SteriCraft/hbc2-ide/logisim/notes/README.md

# Logisim notes

These notes are short, one subject per file, so I only open the one I need.

| File | Subject |
|---|---|
| [conventions.md](conventions.md) | HBC-2 design rules: components, names, chips, layout, files, checks |
| [tools.md](tools.md) | The scripts in `logisim/tools/` and how to use them |
| [ttl-chips.md](ttl-chips.md) | Pinout quirks of the TTL parts, and how each one is wired |
| [open-points.md](open-points.md) | Rule conflicts and questions still waiting for an answer |
| [chips.md](chips.md) | Which 74HCT parts to buy: DIP/SOIC references, sourcing rules, datasheet delays, parts missing from Logisim |
| [disponibilite-74hct.md](disponibilite-74hct.md) | Gianni's stock and price survey (Octopart, 2026-11-04), in French |
| [bom-alu.csv](bom-alu.csv) | ALU bill of materials, generated by `designs/alu.py` (tools/bom.py) |
| [alu-decisions.md](alu-decisions.md) | ALU design decisions (night of 2026-11-04) and points for Gianni to review |
| [alu-report.md](alu-report.md) | ALU summary: alu_op table, modules and chips, delays, test results, what's left |
| [flags-decisions.md](flags-decisions.md) | Flag register: every way the emulator changes a flag, interface (flags_op), design, timing, tests, review points |
| [bom-flags.csv](bom-flags.csv) | Flag register bill of materials, generated by `designs/flags.py` |
| [registers-requirements.md](registers-requirements.md) | What the other sections need from the register / bus section, and its status |
| [registers-decisions.md](registers-decisions.md) | Register section: every register use in the emulator, design, interface, write pulse, timing, tests, review points |
| [bom-regs.csv](bom-regs.csv) | Register section bill of materials, generated by `designs/regs.py` |
| [pc-sp-requirements.md](pc-sp-requirements.md) | What the other sections need from PC, SP and the address path, and its status |
| [addr-decisions.md](addr-decisions.md) | Address section: every use of PC, SP and the address in the emulator, design, steps, phase 2 decisions (A1–A9), timing, tests |
| [addr-report.md](addr-report.md) | Address section summary: chips, timing, tests, "Need Gianni's review" |
| [bom-addr.csv](bom-addr.csv) | Address section bill of materials, generated by `designs/addr.py` |
| [ir-mem-decisions.md](ir-mem-decisions.md) | Instruction register and memory / bus interface: emulator uses, boot, design, timing, questions, Gianni's answers, phase 2 decisions M1– |
| [ir-mem-report.md](ir-mem-report.md) | Instruction register and memory: phase 2 report (chips, tests, timing, Need Gianni's review) |
| [iod-requirements.md](iod-requirements.md) | What the CPU side requires from the IOD (synchronous contract, microcontroller IOD through latches / FIFO) |
| [io-redesign-proposal.md](io-redesign-proposal.md) | I/O redesign: the VIA / 16C550 proposal (2026-11-10, timing fails, section 8), then option C: a latch mailbox in front of an ESP32 (sections 9–9.9, C-min chosen 2026-11-11) |
| [iod-decisions.md](iod-decisions.md) | The `iod` mailbox as built (2026-11-11): files, tests (module, CPU-level rule / eager benches), decisions K1–K5, open points |
| [breadboard-checks.md](breadboard-checks.md) | What to measure on the breadboard with a scope (the paper analysis can't prove it) |
| [control-requirements.md](control-requirements.md) | What the other sections need from the control unit |
| [cu-decisions.md](cu-decisions.md) | Control unit: phase 1 paper design (accepted, section 12), phase 2 microcode (section 13: source language, bit layout, placement, rules, model, tests), phase 3 circuits `clkgen` and `cu` (section 14: chips, gates, tests, timing with the duty cycle, decisions U7–U13), phase 4 the whole CPU (section 15: cpu.circ `main`, the trace bench, the comparison with the emulator, coverage, wiring bugs, timing across sections, decisions U14–U20) |
| [bom-clkgen.csv](bom-clkgen.csv) | Clock and reset generator bill of materials, generated by `designs/clkgen.py` |
| [bom-cu.csv](bom-cu.csv) | Control unit bill of materials (chips and pull resistor networks), generated by `designs/cu.py` |
| [bom-cpu.csv](bom-cpu.csv) | The whole CPU's bill of materials (146 chips, 8 resistor networks), generated by `designs/cpu.py` |
| [cu-cycles.md](cu-cycles.md) | Control unit: cycle counts per instruction × mode (generated by `hbc2 ucode`) |

Modules done so far (all in circuits/alu/, each made by designs/<module>.py):

| Module | Chips | Test (vs emulator) |
|---|---|---|
| `add_sub8` (ADD ADC SUB SBB; INC DEC with b = 01) | 3 × 74HCT283, 3 × 74HCT86, 2 × 74HCT157, 1 × 74HCT08 (carry select) | 524,288 / 524,288 |
| `logic8` (AND OR XOR) | 2 × 74HCT08, 2 × 74HCT32, 2 × 74HCT86 | 65,536 / 65,536 |
| `shift8` (shifts, C select) | 1 × 74HCT153 | 2,048 / 2,048 |
| `flags8` (Z N) | 74HCT27, 74HCT11 | 256 / 256 |
| `cmp8` (S E F of CMP) | 2 × 74HCT85 | 65,536 / 65,536 |
| `rmux8` (result bus, NOT) | 6 × 74HCT541, 74HCT240, 74HCT138, 74HCT11 | 65,760 sampled |
| `alu` (all of the above) | none of its own; 29 chips in total | see alu-report.md |

Flag register (circuits/flags/, designs/flags.py):

| Module | Chips | Test (vs emulator) |
|---|---|---|
| `flags` (8 flags, POF/PSF, single-flag writes, reset) | 4 × 74HCT153, 3 × 74HCT11, 2 × 74HCT138, 2 × 74HCT157, 2 × 74HCT175, 74HCT86, 74HCT541 (15) | 66,816 / 66,816 (`flags`) and 70,656 / 70,656 (`flags_cpu`, the real CPU) |

Register section (circuits/registers/, designs/regs.py):

| Module | Chips | Test (vs emulator) |
|---|---|---|
| `regs` (8 registers, two read ports, write path, operand latches, A/B buses, data bus drivers) | 8 × 74HCT670, 4 × 74HCT153, 3 × 74HCT574, 2 × 74HCT541, 74HCT32 (18) | 30,756 / 30,756 (`regs`, model) and 148,864 / 148,864 (`regs_cpu`, the real CPU) |

Address section (circuits/addr/, designs/addr.py):

| Module | Chips | Test (vs emulator) |
|---|---|---|
| `addr` (PC, SP, the 16-bit address adder, the address latch, their bus drivers, the reset) | 8 × 74HCT153, 6 × 74HCT377, 6 × 74HCT541, 4 × 74HCT157, 4 × 74HCT86, 4 × 74HCT283, 2 × 74HCT08 (34) | 31,640 / 31,640 (`addr`, model) and 65,114 / 65,114 (`addr_cpu`, the real CPU) |

Chip models (circuits/chips/, rules in conventions.md; the circuit inside is named `ttl<part>`): `74574` (2,064 / 2,064 datasheet rows); `test_74670` checks Logisim's own 74670 (912 / 912), `test_74377` its 74377 (250 / 250).

`arith8` (add_sub8 + 2 × 74HCT157 for B := 01) was removed on 2026-11-04: INC and DEC now take b = 01 from the control unit (alu-decisions.md D16).

`logisim/cpu.circ` holds only an empty `main` and loads alu and add_sub8 as libraries.

History: on 2026-11-04 the user deleted their test circuits add_sub8.circ and the old alu.circ. `hbc2 vectors add_sub8` still exists on the emulator side.

On 2026-11-04 add8 became add_sub8: B goes through XOR chips (A - B = A + not B + 1), and the flag c is a borrow after SUB/SBB, as in the emulator.
