SteriCraft/hbc2-ide/Documentation/Peripherals/EEPROM/Specifications.txt

=== EEPROM Specifications ===
ROM can hold up to 1 Megabyte of data (20-bit addresses)
It has 5 ports (one for command, one for data, 3 for address)

-- Pinout--
The CPU has a "HALT" pin to prevent it from executing instructions.
The ROM uses that pin to hold the CPU on startup, while it's dumping data.

-- DATA DUMP --
On initialization, the EEPROM copies the IVT (0xFE00-0xFFFF) and the first 512 bytes of program (0x000-0x1FF).
The interrupts handlers have to be copied by the program the user writes in the first 512 bytes.
