SteriCraft/hbc2-ide/compiler/ROADMAP.md

# HBC-2 C compiler — roadmap (Claude's tracking file)

C compiler for the HBC-2 based on the Fuzix Compiler Kit (FCC):
`cc0` (tokens) → `cc1` (parse, trees) → `cc2` (our backend, prints `.has`) → `copt` (peephole) → hbc2-asm.
**Finished (2026-11-11):** everything planned is done; nothing is planned. New work comes from using the compiler (a bug, a slow spot): record it here. The user only says "go to the roadmap": read this file and update the status here at the end of each session.

## Status

- **Phase:** finished 2026-11-11. Steps 1-13 done (step 13 = EEPROM, 2026-10-31) (step 11 = linker, details in `LINKER.md`; step 12 = backend speed-ups + string.h in asm, 2026-10-31). 70 test programs (programs.rs, multi-file ones included) pass + `tests/build.rs` + FCC's own 109 test programs (`tests/fcc.rs`, all pass). Tests: `cargo test -p hbc2-cc --release` (needs `compiler/build.cmd` first). Unreached code is left out: an empty `main` is 269 bytes, hello world 1.1 KB, with printf 2.7 KB (lib/README.md "Size").
- **Done after step 13:** C89 library, plan agreed with the user 2026-11-03, everything in assembly (size): 1. `limits.h` + `errno.h` + `strerror`/`perror` — **done** (`lib/asm/errno.has`, tests/errno.c); 2. `sprintf`, `vprintf`, `vsprintf` — **done** (`printf.has` engine, tests/sprintf.c); 3. `qsort`, `bsearch`, `strtok`, `strspn`, `strcspn`, `strpbrk` — **done** (`asm/sort.has`, `asm/string.has`, tests/sort.c); 4. `time.h` from the RTC — **done** (`asm/time.has`, tests/time.c; `clock` = -1, no `difftime`); 5. `setjmp.h` — dropped by the user 2026-11-03 (uses `goto cleanup`); 6. `malloc`/`free`/`calloc`/`realloc` — **done** (`asm/malloc.has`, tests/malloc.c); 7. `sscanf`/`scanf` — **done** (`asm/scanf.has`; `getchar`/`gets` moved to asm, `src/stdio.c` gone; tests/scanf.c); 8. `float` (2026-11-04): the float library (`lib/asm/math/float`, 27 KB, binary32 full IEEE, tested by `tools/ftest`) reviewed (linker could not drop unused functions: fixed; pow inexact bug fixed), then compiler support **done**: `double` = `float` (cc1 remap), backend moves floats like longs and calls `runtime/float.has` helpers (ABI.md 11), cc0 constants via host strtof (hex floats too), cc1 folds float constants and int<->float casts; `math.h` float functions, `float.h`, `fenv.h`, `strtod`/`strtof`/`atof` (`asm/fmath.has`); tests/float.c, tests/fmath.c (mutation-checked). printf/scanf `%f %e %g` **done** 2026-11-04 (`asm/printf_float.has`: exact digits from a 288-bit fixed point number, half to even; printf also got `+ space # .prec *`, `%i`, `h L`; scanf `%e %f %g %a` through atof; tests/printf_float.c, mutation-checked; cost: printf +2.5 KB, scanf +4 KB in every program using them, even without floats). Dropped by the user (2026-11-13): `fixed.h` (fixed point, not standard). Declined: `assert.h` (user won't use it), `locale.h`, `signal.h`, wide chars. `strtol`/`strtoul`/`atoi`/`atol` and `itoa`/`utoa`/`ltoa`/`ultoa` moved to asm 2026-11-03 (`asm/stdlib.has`; `src/stdlib.c` gone; convert test 12000 → 9036 bytes). `strstr` too (`asm/string.has`, 75 bytes): no C left in the library, `compiler/lib/src` is gone (`build_library` takes a missing folder as no C files). Struct assignment added 2026-11-03 (`T_STRUCTCOPY`, tests/structcopy.c; ABI.md 11-12); local `{ }` / string initializers and `(void)` casts added too (tests/localinit.c). **Language work, order agreed with the user 2026-11-11 (stop and report after each):** 1. block scope — **done** 2026-11-11 (decision 17, tests/blockscope.c + build.rs "scope", mutation-checked); 2. `for (int i…)` — **done** 2026-11-11 (decision 6b, tests/fordecl.c + build.rs "forstatic", mutation-checked); 3. structs passed/returned by value — **done** 2026-11-11 (decision 18, tests/structval.c + build.rs "structarg", mutation-checked); 4. FCC's own tests — **done** 2026-11-11 (tests/fcc.rs, 109 programs, all pass, no compiler change needed). Backend, 2026-11-11: `x *= k`, `x /= k`, `x %= k` with a constant done in place (`direct_muldiveq`: load, inline multiply / power-of-two divide as `x * k` / `x / k`, store; signed `/ %`, `char`, long `*=` still call the helpers; tests/muldiveq.c, mutation-checked; loops 2-5× faster, the statement about the same size, the helper no longer linked). Dropped by the user: bitfields, K&R definitions, the cargo build of the C tools, carrying register contents across loop labels. Known limits: ABI.md 12. The IDE builds through `hbc2_cc::build_program`; keep that the one entry point.

## Notes files (read only when needed)

Details moved out of this file to keep it short. Open the one for the part you touch:

| File | Content |
|---|---|
| `notes/pipeline.md` | FCC tool chain, command lines, cc1 stdout quirk |
| `notes/step1-design.md` | data/labels/statics/arguments as FCC emits them |
| `notes/backend.md` | backend-hbc2.c: rewrites, labels, data buffering, exports |
| `notes/inline.md` | gen_shortcut inline code, conditions on flags, measured gains |
| `notes/peephole.md` | copt and rules.hbc2 |
| `notes/helpers.md` | the 89 runtime helper names |
| `notes/library.md` | compiler/lib layout, device detection, terminal from C |
| `notes/multifile.md` | build_program, static renaming, error messages |
| `notes/ide.md` | diagnostics, line markers, asm→C line map, line step, background build |
| `notes/misc.md` | CPU facts, FCC quirks, stack/frame tricks, math library location |
| `notes/reloads.md` | step 12: reload removal pass (reloads.rs), volatile markers |
| `notes/session-log.md` | what each session did |

## Decisions (agreed 2026-10-30)

1. **Linking:** (a) the driver joins every generated `.has` + the runtime into one program.
   (b): unused code dropped by hbc2-asm: step 11, decision 15 (done).
2. **Names:**
   - C `foo` → `_foo` (so asm `screen_putc` and C wrapper `_screen_putc` coexist).
   - Runtime helpers: `__name` (Fuzix's names where they exist: `__mul`, `__cceq`…).
   - `static` names: per-file prefix `__S<n>_name` (n = file number in the build; was `_S<n>_` until step 9: `__` can't clash with a C name, like `__L`).
   - Compiler labels: `__L<n>_…` with the file number (changed from `_L<n>` in step 1: a C name `L1` would give `_L1`; C reserves `__` names, so `__L` can't clash).
3. **Registers:**
   - `[a:b]` = working value (16-bit, a = MSB); `char` in `b`.
   - `[x:y]` = pointer register (`*p`, `p->f` → `[x:y + n]`).
   - `[c:d]` = second operand / high half of a `long` (`long` = `[c:d]:[a:b]`).
   - `i`, `j` = scratch / second pointer.
   - Matches the math library's 16-bit routines ([a:b] op1/result, [c:d] op2). 32-bit routines use pointers ([x:y], [i:j]) → need adapters (see open questions).
4. **Calls:**
   - Arguments pushed right to left, each value low byte first (big-endian in memory, like `cal`).
   - Caller removes them (`asp n`) → variadic functions work.
   - Return in `[a:b]`, `long` in `[c:d]:[a:b]`.
   - Every register except SP may be changed by a function (caller-saved). No register variables: dropped (user, 2026-10-31); `register` stays accepted and ignored.
5. **Asm library from C:** compiler helpers get their own entry points matching what the backend emits (built from the math library code); user-facing drivers (screen, terminal, keyboard) keep their register interface and get thin C wrappers.
6. **Types:** `char` unsigned by default (already FCC's default: `__castuc_`). `int`/`short` 16, `long` 32, pointers 16. `float` = IEEE binary32, `double` and `long double` the same type (decision of 2026-11-04; was: an error).
6b. **C99 declarations after statements (user, 2026-10-31):** allowed in any `{ }` block (`declaration_block()` called again in the block loop of `fcc/body.c`). tests/c99decl.c (mutation-checked). `for (int i = ...)` added 2026-11-11 (`for_statement`: own block around the loop, values written before H_FOR; tests/fordecl.c).
7. **Frames > 255 bytes:** compute the address with `rsp` (see notes), no compile error.
8. **EEPROM (step 13, user 2026-10-31):** `eeprom_read/write/load/save` in hbc2.h (asm in `lib/asm/hbc2.has`), and an EEPROM target for C: `runtime/boot.has` replaces crt0's start (see ABI.md 8 and `notes/library.md`). **The EEPROM target and boot.has were removed on 2026-11-11** (logisim/notes/io-redesign-proposal.md 9.5): the hardware starts from its boot ROM; the EEPROM stays as storage, plugged by default.
9. **Interrupt handlers:** hand-written asm only (they may call C functions). No compiler support.
10. **Zeroed variables (BSS):** `.bss name size` in hbc2-asm (DONE 2026-10-30): all `.bss` placed together after code and data, nothing in the image, `__bss_start` / `__bss_end` defined; `crt0` clears the area (loop example in the assembly manual).
11. **Licence/packaging:** not a concern (single user). Repo is GPLv3 like the kit.
12. **Library location (step 8):** `compiler/lib/` holds COPIES of the user's drivers (monitor driver, terminal) + the C library (`include/` headers, sources). The user's originals in design_projects stay untouched.
13. **Device detection (step 8):** `crt0` handles it before calling `main`, so C code can print straight away. Since 2026-11-11 it asks the I/O processor with INFO (`lib/asm/devices.has`, 2 s timeout) instead of handling port-0 plug-in interrupts; `hbc2.h` has `device_find()` (by class), `device_get()`, `device_count()`, `io_protocol()`.
14. **printf (step 8):** minimal set: `%d %u %x %c %s %%`, `l` for long (`%X` added 2026-10-31), width + `0` padding. Floats, flags `+ space #`, precision and `*` added 2026-11-04.
16. **IDE integration (user, 2026-10-31, step 10):** a C project = a folder with `main.c` (wins over `main.has`); every `.c` and `.has` file of the folder is built (main.c first = unit 1, then name order); Build (F7) saves all open files first; tools stay in the repo's `compiler/bin` (`HBC2_COMPILER_DIR` overrides); an asm project cannot call C files; no interrupt handler template for C (crt0 + set_vector are enough); the asm→C line map is part of step 10.
17. **Block scope (2026-11-11):** each local symbol has a block depth (arguments = the body's outer `{ }`); a name hides the same name of an outer block; sibling blocks share stack room (frame = deepest nesting). Tags, typedefs, enum constants stay file-wide (FCC). Upstream changes in `fcc/UPSTREAM.md`.
18. **Structs by value (2026-11-11, ABI.md 5):** an argument is passed as the address of the caller's struct and the callee copies it into a local at entry (one copy per function, not per call; no backend change). A result goes to a temporary in the caller's frame, whose address is a hidden first argument (pushed last); the callee returns that address. All in cc1 (`fcc/UPSTREAM.md`).
15. **Linker (user, 2026-10-31; replaces the object-file plan):** no object files. hbc2-asm drops every piece of the program that can't be reached from `_start` / fixed addresses / `.keep` (piece = from a label to the next label, or one `.data`/`.bss`; fall-through counts as a use). On for C builds only; assembly projects keep everything (a per-project option may come later). Library names give way to the program's own (a program may define `puts`). Plan and progress: `LINKER.md`.

## Open questions (waiting for the user)

- (none)

## Layout

- `compiler/fcc/` — copy of the kit's core (see `fcc/UPSTREAM.md`: commit, licences, what was left out). HBC-2 files to add: `target-hbc2.c` (cc1), `backend-hbc2.c` (cc2). Keep upstream files unchanged where possible; list any change in UPSTREAM.md.
- `compiler/msvc/` — `compat.h` (forced include: io.h names, binary `open`, `itoa`/`_itoa` renamed, strcasecmp, strlcpy/strlcat), `compat.c` (binary stdin/stdout/stderr before main via `.CRT$XCU`), `unistd.h` stub.
- `compiler/build.cmd` — MSVC build (vcvars64 of VS 2022 Community) → `compiler/bin/*.exe`, objects/logs in `compiler/build/` (both git-ignored). Builds cc0, cpp, copt, cc1.ref (target-6800.c), cc2.ref (backend-default.c). Add cc1.hbc2/cc2.hbc2 in step 3.
- Full upstream clone for reading other backends: re-clone https://github.com/EtchedPixels/Fuzix-Compiler-Kit at the commit in UPSTREAM.md (scratchpad copies don't last). 6809 = `be-codegen-6800.c` + `be-code-6809.c` + `be-func-6800.c` + `be-track-6800.c`; cc1 for 6809 = `target-6800.c`.

## Steps

- [x] 1. Get FCC, build it, compile tests for the 6809 target, read the backends. (No WSL/MSYS2/gcc on this machine: built with MSVC + compat layer instead. 6809 output checked on a loop + call test.)
- [x] 2. Write the ABI document — `compiler/ABI.md`. Section 11 (helpers) is a draft to settle in steps 3-4.
- [x] 3. Minimal backend `backend-hbc2.c`: constants, load/store globals + locals, calls, prologue/epilogue, labels, jumps, branches; everything else → helpers. Also inline already: + - & | ^ ~ unary- (8/16), == != (8/16), ! and bool, casts (incl. sign extension), deref / assign through pointers, frames > 255.
- [x] 4. Runtime: `crt0.has` + 89 helpers (`runtime.has` includes compare, long, mul, div, shift, assign, switch; ≈3.9 KB). Written for the C convention, NOT wrappers of the user's math library (it saves all registers; runtime must be self-contained).
- [x] 5. Test harness: crate `hbc2/crates/hbc2-cc` (lib: `compile()` = Rust version of the driver; tests/helpers.rs: each helper called directly on the emulator vs a Rust model, breakpoint on a return label; tests/programs.rs: every `compiler/tests/*.c`, "Expected: main returns N" on line 1). Both checked by mutation (a broken helper makes them fail). FCC's own test programs (upstream `test/`, 2026-11-11): tests/fcc.rs runs the 35 self-checking `tests/` and the 74 acwj `wtests/` (output compared), all pass first time; the runner checked by mutation.
- [x] 6. Inline code (see "Inline code (step 6)" below).
- [x] 7. `copt` peephole rules (see "Peephole rules (step 7)" below).
- [x] 8. Library: `hbc2.h` (monitor/keyboard/RTC wrappers, in/out), `putchar`/`puts` on `term_putc`, `string.h`, small `printf`.
  - [x] 8a. `hbc2.h` + `asm/hbc2.has` wrappers, driver copies in `lib/asm`, device detection in crt0 (`runtime/devices.has`), `exit` (stdlib.h), `-I lib/include` in both drivers, `build_library()`, tests/hardware.c (+ `.screen` / `.keys` support in programs.rs, all tests now run with monitor + RTC + keyboard).
  - [x] 8b. stdio.h: `putchar`/`puts` in asm (`asm/stdio.has`, first output clears the screen: `lib_term_start`), `getchar`/`gets` in C (`src/stdio.c`, line-buffered on term_readline; moved to asm 2026-11-03). tests/stdio.c.
  - [x] 8c. string.h (14 functions, in C: `src/string.c`; in asm since step 12: `asm/string.has`) + stddef.h. tests/strings.c (mutation-checked).
  - [x] 8d. printf (decision 14, `src/printf.c`) + stdarg.h. tests/printf.c (mutation-checked). In asm since 2026-11-03: `lib/asm/printf.has` (2.5 KB → 965 B; printf test 4870 → 3731 bytes, 52k → 44k ticks; mutation-checked).
- [x] 9. Multi-file builds: `hbc2_cc::build_program(sources, library, dir)` (`.c` + `.has`), static renaming in `compile()` (both drivers), `-I` source folder, C-level error messages, library statics (`next`, `field`). Tests: `tests/multi/files`, `tests/build.rs` (mutation-checked).
- [x] 10. IDE (decision 16, see "IDE integration (step 10)" below):
  - [x] 10a. `hbc2 cc <files…> [-o out.bin] [--dir build] [--symbols]`; `hbc2 run main.c …` builds first.
  - [x] 10b. Diagnostics instead of strings (`compile`, `build_library`, `build_program` → `Vec<Diagnostic>`, `report()` for text); every C file compiled even when one fails; library files kept when newer than their inputs.
  - [x] 10c. C projects in the IDE (project language, template `hbc2/templates/main.c`, Build saves then compiles into `<project>/.build`, RAM only).
  - [x] 10d. C highlighting; compiled files and the compiler's own files open read-only.
  - [x] 10e. asm→C line map (`;#line n` markers through FCC, `lines.rs` remaps the Program).
- [x] 12. Speed-ups (user, 2026-10-31): one-byte bit tests (`x & 0x8000`) in conditions / ?: / 0-1 values; `<<=` `>>=` by a constant in place; reload removal after copt (`hbc2-cc/src/reloads.rs`, volatile-aware; copt's store-then-load rules removed); string.h in asm (`lib/asm/string.has`, 2.7 KB → 1.1 KB). tests/bits.c, tests/reloads.c, build.rs volatile_reloads; all mutation-checked. See notes/reloads.md.
- [x] 13. EEPROM (decision 8): hbc2-asm `__program_end`; runtime split into crt0.has (RAM) / boot.has (EEPROM) + init.has (shared) + devices.has (no variables now); `build_program(…, target)` → `Build::eeprom_image`; `hbc2 cc --eeprom`, `hbc2 run main.c --eeprom`; IDE target menu enabled for C. tests/eeprom.c (first line "built for the EEPROM"), hardware.c checks the refusals, build.rs eeprom_image; mutation-checked.
- [x] 11. Linker (decision 15) — see `LINKER.md`: `Options::strip` in hbc2-asm (on for C builds), `.keep`, `.library` (program names replace the library's), `hbc2 cc --map`.
