SteriCraft/hbc2-ide/compiler/notes/session-log.md

# Session log

(Moved out of ROADMAP.md 2026-10-31. Read only when working on this part.)

- 2026-11-04: printf/scanf floats (user asked). `lib/asm/printf_float.has`: m << s in a 288-bit fixed point (128 integer, 160 fraction bits) is exact; integer digits by bitwise division by 10, fraction digits by x10; pf_next/pf_rest feed a 192-digit buffer, the rest are exact zeros counted (zeros/split in the field), half to even. printf engine rewritten: frame 250 B, flags + space #, precision, `*`, %i, h L; text printed as split chars, zeros, rest. scanf: frame 70 B, %e %f %g %a collect a decimal text (40 chars) for atof. Expected values from MSVC UCRT (its `%#.0f` of inf gives "i.nf": fixed by hand). tests/printf_float.c 850 checks, mutation-checked (half-even, 40-char limit). Cost: printf 3.8 -> 6.3 KB, scanf test 8.5 -> 12.5 KB even without floats (option: a hook only float programs pull in).
- 2026-11-04: float. Review of the float library (Sonnet-written steps 10-12): fx_main table dispatch kept 21.5 KB for any function in C builds -> direct jumps (exp 7 KB); pow(x, tiny) missed FE_INEXACT; ftest harness moved to tools/ftest. Compiler: target-hbc2.c remap double, backend-hbc2.c (is_float, move_size, float_op bail in gen_shortcut, float_test for conditions, compares are int 0/1 though typed float), runtime/float.has, cc0 strtof constants, cc1 folding + ++ step, lib fmath.has + math.h/float.h/fenv.h/strtod. Bugs met: pop order (mirror of psh b,a,d,c is pop b,a,d,c), compare nodes typed float, strtod clobbered its result. Tests float.c, fmath.c; all workspace tests pass. Empty main still 269 B, float ops ~4 KB, sin ~7.7 KB.
- 2026-11-03: scanf/sscanf in `lib/asm/scanf.has` (~1.7 KB): C89 conversions (d i u o x X p c s [ ] n %%, *, width, h, l), EOF before the first conversion, one character of look-ahead. getchar/gets rewritten in asm (`lib_stdin_peek`/`lib_stdin_back`: the char scanf did not use goes to getchar), `src/stdio.c` deleted. Keyboard reached through `lib_scan_key` (set by scanf) so sscanf-only programs leave the terminal out (2.0 vs 3.7 KB). tests/scanf.c + scanf.keys, mutation-checked (12 mutants).
- 2026-11-03: setjmp.h dropped (user: `goto cleanup`). malloc/free/calloc/realloc in `lib/asm/malloc.has` (~700 B): heap from `__bss_end` to SP - 256, 2-byte headers (size even, bit 0 = used), first fit, free blocks joined during the search, free tail lowers the top, realloc in place/at top/moved. tests/malloc.c mutation-checked (no join, realloc copy size, calloc clear, no top drop, no split, realloc at top, old block kept on move; no stack limit hangs the test; ignoring the borrow of SP - 256 is equivalent).
- 2026-11-03: C89 library batches 1-4 (limits/errno, sprintf family, qsort/bsearch/strtok…, time.h), then struct assignment in the compiler (user asked): cc1 `T_STRUCTCOPY` node (`struct_assign`), cc2 inline copy up to 4 bytes else `__structcpy`; `struct s v = w;` for locals. Probe of C89: missing = structs by value (args/return), local `{ }`/string initializers, bitfields, K&R definitions. tests/structcopy.c mutation-checked (inline byte count, helper count, helper result; result = source vs destination is equivalent, not testable). Then (user asked): local `{ }`/string initializers (hidden data + T_STRUCTCOPY, `ini_auto_copy`) and `(void)` casts; tests/localinit.c mutation-checked (size, copy dropped, (void) not evaluated).
- 2026-11-03: printf rewritten in asm (user asked): `lib/asm/printf.has` replaces `src/printf.c` (2.5 KB -> 965 B). State in 28 bytes of stack locals, digits from the math library's utoa/itoa/htoa 16/32, a negative %d takes itoa's '-' off and the field prints it (before or after the padding), every char through `_putchar` (tests/multi/override). Width 8-bit (up to 255). printf test 4870 -> 3731 bytes, 52006 -> 44051 ticks; smallest printf program 3846 -> 2707 bytes. tests/printf.c mutation-checked (sign order, lower case).
- 2026-11-02: CPU change designed with the user (the user updates the Instruction Manual): instructions are 1 to 4 bytes (`hbc2_core::isa::Instruction::size`: no-operand opcode = 1 byte, else the mode gives the length); invalid opcode = 1-byte nop; valid opcode with a mode it doesn't take (or a no-operand opcode with mode bits in byte 1) stops the CPU (H = 1, I = 0, PC stays on it); `hlt` sets H only; `sti` takes effect after the next instruction. Compiler output unchanged. `wait_interrupt` = `sti` + `hlt` (keeps "enables them"). programs.rs "bytes of code" = real sizes now (was lines x 4). Test programs about 28% smaller (all 68: 818236 -> 620513 bytes in all).
- 2026-10-31: ctype.h added to the library (user wrote asm/ctype.has with guidance; I added isblank, shared exits ctype_true/false, isgraph tail-calls isprint: 856 -> 668 B). tests/ctype.c: every value EOF..255 + out of range against plain C, is... must return exactly 0/1 (mutation-checked). Committed.
- 2026-10-31: step 13 EEPROM (user asked: read/write/copy routines in hbc2.h + a boot loader). Added `__program_end` to hbc2-asm, eeprom_* in hbc2.has, boot.has, EEPROM target in hbc2-cc / CLI / IDE, docs. All tests pass, clippy clean. Committed with the user's OK.
- 2026-10-31: math.h (step 2 of the math plan): `isqrt lsqrt ipow lpow gcd lgcd popcount clz ctz` + `l` versions, `min max umin umax` (functions, not macros: arguments evaluated once), `abs labs` in stdlib.h. `div`/`ldiv` left out (struct return: FCC has none). Whole math library copied unchanged to `lib/asm/mathlib/` (replaces the loose random/random_range/text copies, which were identical); wrappers `lib/asm/math.has`. FCC bug fixed (fcc/UPSTREAM.md): `sizeof a / sizeof a[0]` parsed as `sizeof (a / ...)` -> "bad type"; `get_sizeof` takes `hier10` without a bracket. tests/math.c (self-checking, mutation-checked).

- 2026-10-31: faster `*` `/` `%` and variable shifts (user: "if the compiler is less efficient than the math library, update it"). runtime/mul.has, div.has (unrolled steps written once by a throwaway script; edit the files directly): only the low half of products (`__mul` = b*[c:d] + (d*a)<<8; `__mull` one pass per multiplier byte, product growing b, [a:b], [d:a:b], [c:d:a:b]), division with a remainder as wide as the divisor (`__div8_1/2/4` shared by 16 and 32 bits). shift.has: byte moves first. Signed division by zero now gives all bits set as ABI.md says (was 1 for a negative left). helpers.rs: 3-byte values, `divide_by_zero`, `multiply_divide_many` (8100 pairs). 2-7x faster per helper; ops tests 1.5-3x, bench.c 6%; +1.1 KB (int) / +2.5 KB (long) in programs that use them. Next: math.h (plan agreed: `isqrt lsqrt ipow lpow gcd lgcd popcount clz ctz min max umin umax` as functions + abs/labs/div/ldiv in stdlib.h; integer names keep away from float's `pow`/`sqrt`).

- 2026-10-31: stdlib.h number <-> text: `atoi`, `atol` (spaces skipped; 0 on no digit or past 32 bits), extras `itoa utoa ltoa ultoa htoa lhtoa` (return the end, the 0). `lib/asm/text.has` = unchanged copy of the math library's. printf uses utoa/ultoa/htoa/lhtoa (no division: printf test 144k -> 41k ticks, +305 B), `%X` added. tests/convert.c.
- 2026-10-31: stdlib.h random numbers: `rand`, `srand`, `RAND_MAX` (32767), extras `srand_rtc`, `rand_range` (signed, via randr16 with the sign bit flipped). `lib/asm/random.has`, `random_range.has` are unchanged copies of the math library's. tests/random.c (mutation-checked).
- 2026-10-31: common variables (`int n;` in several files = one variable): backend writes `.common`, hbc2-asm merges (manual, ABI.md 7, notes/multifile.md). Relative `--dir` / `.has` paths fixed in build_program. All to-do lists moved to the repo's `TODO.md`; `rust-rewrite` merged into `main`.
- 2026-10-31: console windows hidden for the compiler tools (CREATE_NO_WINDOW), pushed. Step 12 (user: "all backend speed-ups + string.h"): bit tests, <<= >>= in place, reload removal pass with volatile markers (copt store-load rules removed), string.h in asm. All tests pass; committed and pushed.
- 2026-10-31: step 11 (linker) done in one session, 11a-11e: strip pass, `.keep`, report (`--map`, IDE message), on for C builds, `.library`. Two choices made on the way (in LINKER.md "How it works"): `_start`'s block is not kept whole; a library piece falling into a replaced one is not an error. All tests pass, clippy clean; committed.
- 2026-10-31 (after step 10): linker planned with the user (decision 15 replaced: removal pass in hbc2-asm, no object files; asm projects off; library names give way). `LINKER.md` written; ROADMAP.md split into `notes/*.md`.
- 2026-10-31: step 10 (plan + choices told to the user first, decision 16). 10a-10e done, then C line stepping and background C builds (user's request). All workspace tests pass, clippy clean. Committed and pushed (093ec55).
- 2026-10-30: plan + decisions with the user. This file created.
- 2026-10-30 (same session): open questions settled (5, 6, 7, 10 above). `.bss` added to hbc2-asm (parser `Stmt::Bss`, assembler places it after code/data, `__bss_start`/`__bss_end`; tests `bss_*` in tests/assemble.rs; documented in the assembly manual). Step 1 done: kit copied to compiler/fcc, MSVC build works (all 5 tools), pipeline tested with the 6809 target (scratchpad) and with cc1.ref/cc2.ref (repo build). Label naming changed to `__L…` (told the user).
- 2026-10-31 (after step 9): `set_vector(port, handler)` added to hbc2.h (asm/hbc2.has; refuses port 0), test multi/vector (key handler in asm calling C; mutation-checked). ABI.md 8 no longer suggests fixed `.data` vectors (ports are dynamic, detection overwrites RTC/keyboard vectors); ABI.md 10 shows the install.
- 2026-10-31 (after step 9): register variables dropped (user). Step order changed: 10 IDE integration, 11 linker. Duplicate "Later: linker" removed.
- 2026-10-31 (step 9): multi-file builds (plan told to the user first; static prefix changed to `__S`, told). `cargo fmt --all` also reformatted 3 unrelated files (hbc2-ide build.rs/project.rs, hbc2-runner worker.rs, import order only); restoring them was blocked: left for the user.
- 2026-10-31 (step 8): library in 4 parts (hbc2.h + device detection in crt0, stdio putchar/puts/getchar/gets, string.h, printf), told the user after each. Decisions 12-15 recorded; step order now 9 multi-file, 10 linker, 11 IDE.
- 2026-10-31 (step 7): rules.hbc2, copt in both drivers, tests/peephole.c, coverage + mutation checks, psh/pop size count fixed.
- 2026-10-31 (later): step 6. Inline code + conditions on flags; gen_ops.py rewritten (class Program; groups ops/cond/const/assign × globals/locals → tests/ops/, because of the 64 KB limit); bench.c; programs.rs prints sizes/ticks and also reads tests/ops; step 3 cast/sign bug fixed. Step 7 explained to the user.
- 2026-10-31: steps 4 + 5. Runtime helpers written and tested; crate hbc2-cc (compile + tests); gen_ops.py → tests/ops_*.c; FCC file name bug fixed. Told the user: runtime ≈3.9 KB in every program until the linker (decision 1b).
- 2026-10-30 (same session): step 3. hbc2-asm: a name in `.data` = 2-byte address (`.data p table + 4`), test `data_addresses_mixed_with_bytes`, documented. target-hbc2.c, backend-hbc2.c, build.cmd builds cc1.hbc2/cc2.hbc2, runtime/crt0.has, tools/hbc2cc.py, tests/basics.c + frames.c (run OK: 0x04AC, 0x025C). ABI.md 11 updated (pop rules, switch table).
- 2026-10-30 (same session): step 2. ABI.md written; NAMELEN raised to 31 chars; checked: no struct by value in FCC, char args 1 byte / int in varargs, CPU interrupt and flag facts. Rule added: asm names starting with `_` share the C namespace (the user's interruptHandler.has uses `_iod_…`, `_loop` etc. → C can't use `iod_…`, `loop`; the assembler reports clashes).
