SteriCraft/hbc2-ide/compiler/notes/ide.md

# IDE integration (step 10) — how it works

(Moved out of ROADMAP.md 2026-10-31. Read only when working on this part.)

- **Driver (hbc2-cc):** `messages.rs` parses stage stderr: cc0/cc1 `name.c:12 - msg` (name only: looked up next to the C file, then in lib/include), cpp `[ 'what' - ]file:12:error: msg` (cpp's line is one too high: −1; path normalized, cpp joins -I and name with '/'). Unknown lines → the C file, line 0. Stage succeeded + stderr = warnings. `BUILD_DIR` = ".build". `build_library` recompiles a file only when older than its .c, lib/include/*.h, bin/*.exe, rules.hbc2 or the running program (tests share one library build: OnceLock, parallel tests raced on the same folder).
- **Line markers:** cc1 writes `H_LINE` (data = line, 0 = another file than the C file) before each statement, local declaration, top-level declaration, the `}` of a function, and line 0 before `write_bss` (tentative `int n;` come at the end). cc0 sends the C file's name at once (a file starting with `#include` used to give the header's name first). cc2 `gen_line` flushes pending data, then prints `;#line n` (repeats skipped). copt skips markers when matching and keeps the ones inside replaced lines after the new lines. Check done: with the markers removed, all 62 compiled files are the same as before (3 only reordered: data lines placed at their own line). All FCC changes listed in fcc/UPSTREAM.md.
- **Remap (`lines.rs`):** after assembling, `LineMaps::apply` points every instruction and label of a compiled file at its C file + line (C files appended to `program.files`); lines with no marker (startup code, runtime, header code, tentative variables) keep their asm location. Assembler errors in compiled files get the C line too ("not defined: 'f'" on the calling line, "(a.c, line 2)" in "already defined"). Known: a line whose code copt removed entirely (e.g. `return g;` after `g = …;`) has no instruction, so no breakpoint there; a function without a frame has no instruction on its declaration line.
- **Line step / background build (after step 10, user's rules):** runner command `step_within(addresses)` (one instruction, then runs while PC is in the sorted set, at the current speed, state Running so Pause works; Run/Pause/Load/PowerCycle clear it; breakpoints not checked). IDE `State::c_line_addresses(pc)`: all RAM addresses of the PC's C line when its file is .c/.h, else None → `step(1)`. C builds: `assemble()` saves, spawns a thread (`build_c`), `State::building: PendingBuild` (receiver, edits at start, `then` = Run/Step pressed meanwhile); `poll_build` each frame finishes it (`finish_build`, shared with asm). Assembly projects still assemble on the UI thread (fast, and they use unsaved buffers). Tests: runner `step_within_runs_until_the_pc_leaves_the_addresses`, smoke `c_project_builds_and_runs` (steps 6 → 7 → into add → 7 → 8 → into puts (stdio.has) → one instruction; RTC off in that test: its interrupt could land a step in the handler).
- **IDE:** `Project.language` (main.c → C), `c_sources()`, `build_dir()`; `State::target()` (RAM for C), `State::is_generated()` (read-only: `.build/` and compiler_dir); `State::assemble()` builds C projects via `build_c`; New project dialog has Assembly/C; toolbar/menu say Build; target choice disabled for C; `highlight::Syntax` (C: keywords, types, `#` lines, comments over lines, strings, numbers, calls). Tests: smoke `c_project_builds_and_runs` (error line, save before build, breakpoint on a C line, monitor output), hbc2-cc `tests/build.rs` (`error_lines`, `c_lines`).
