SteriCraft/hbc2-ide/Documentation/Peripherals/Monitor/Specifications.txt

=== Specifications ===
- Color text mode
  |- 42 by 24 characters screen (252 * 192 pixels)
  |- 6*8 px characters
  |- 2 bytes per character (2,016 bytes, ~2kB)
  |- First byte: 4 bits for background color (MSB), 4 bits for character color (LSB)
  |- Second byte: ASCII code
  |- 16 colors palette

- Color pixel mode
  |- 256px * 192px screen (49,152 pixels)
  |- 4 bits per pixel, 2 pixels per byte (24,576 bytes, 24kB)
  |- 16 colors palette

=== Ports ===
0: DATA_0
1: DATA_1
2: POS_X
3: POS_Y
4: CMD

=== Commands ===
0: NOP
1: WRITE
2: READ
3: SWITCH_TO_PIXEL_MODE
4: SWITCH_TO_TEXT_MODE

=== ERRORS ===
Returns 0x00 on READ command if requested position is invalid

=== ASCII CHARS ===
95 displayable characters
Starting at ASCII code 0x20 (32)

 !"#$%&'()*+,-./0123456789:;<=>?@ABCDEFGHIJKLMNOPQRSTUVWXYZ[\]^_'abcdefghijklmnopqrstuvwxyz{|}~
