SteriCraft/hbc2-ide/logisim/notes/cu-cycles.md

# Control unit: cycle counts

Generated by `hbc2 ucode` from `hbc2/crates/hbc2-ucode/microcode/hbc2.uc`; do not edit. Steps of 500 ns (2 MHz) per instruction, from its fetch of byte 0 (F0) to the next instruction's F0. Checked against the datapath model by `cargo test -p hbc2-ucode`. "a / b": jump not taken / taken.

| Instruction | None | Reg | Reg / Imm8 | Reg / Ram | RamReg / ImmReg / Offset | Stack / Offset | Reg16 | Imm16 | Imm8 | other modes (stop) |
|---|---|---|---|---|---|---|---|---|---|---|
| NOP | 1 | | | | | | | | | 3 |
| ADC | | 4 | 5 | 8 | 8 | 7 | | | | 4 |
| ADD | | 4 | 5 | 8 | 8 | 7 | | | | 4 |
| AND | | 4 | 5 | 8 | 8 | 7 | | | | 4 |
| CAL | | | | | | | 5 | 7 | | 4 |
| CLC | 2 | | | | | | | | | 3 |
| CLE | 2 | | | | | | | | | 3 |
| CLI | 2 | | | | | | | | | 3 |
| CLN | 2 | | | | | | | | | 3 |
| CLS | 2 | | | | | | | | | 3 |
| CLZ | 2 | | | | | | | | | 3 |
| CLF | 2 | | | | | | | | | 3 |
| CMP | | 3 | 4 | | 7 | 6 | | | | 4 |
| DEC | | 4 | | | 8 | | | 8 | | 4 |
| HLT | 2 | | | | | | | | | 3 |
| IN | | 4 | | | | | | | | 4 |
| OUT | | 4 | | | | | | | | 4 |
| INC | | 4 | | | 8 | | | 8 | | 4 |
| INT | | | | | | | | | 4 | 4 |
| IRT | 6 | | | | | | | | | 3 |
| JMC | | | | | | | 3 | 5 | | 4 |
| JME | | | | | | | 3 | 5 | | 4 |
| JMN | | | | | | | 3 | 5 | | 4 |
| JMP | | | | | | | 3 | 5 | | 4 |
| JMS | | | | | | | 3 | 5 | | 4 |
| JMZ | | | | | | | 3 | 5 | | 4 |
| JMF | | | | | | | 3 | 5 | | 4 |
| STR | | | | 6 | 6 | 5 | | | | 4 |
| LOD | | | | 6 | 6 | 5 | | | | 4 |
| MOV | | 4 | 3 | | | | | | | 4 |
| NOT | | 4 | | | | | | 8 | | 4 |
| OR | | 4 | 5 | 8 | 8 | 7 | | | | 4 |
| POP | | 5 | | | | | | | | 4 |
| PSH | | 4 | | | | | | | | 4 |
| RET | 5 | | | | | | | | | 3 |
| SHL | | 4 | | | | | | | | 4 |
| ASR | | 4 | | | | | | | | 4 |
| SHR | | 4 | | | | | | | | 4 |
| STC | 2 | | | | | | | | | 3 |
| STE | 2 | | | | | | | | | 3 |
| STI | 2 | | | | | | | | | 3 |
| STN | 2 | | | | | | | | | 3 |
| STS | 2 | | | | | | | | | 3 |
| STZ | 2 | | | | | | | | | 3 |
| STF | 2 | | | | | | | | | 3 |
| PSF | 3 | | | | | | | | | 3 |
| POF | 4 | | | | | | | | | 3 |
| SUB | | 4 | 5 | 8 | 8 | 7 | | | | 4 |
| SBB | | 4 | 5 | 8 | 8 | 7 | | | | 4 |
| XOR | | 4 | 5 | 8 | 8 | 7 | | | | 4 |
| ASP | | | | | | | | 5 | 4 | 4 |
| SSP | | | | | | | | 5 | 4 | 4 |
| RSP | | | | | | | 4 | | | 4 |
| WSP | | | | | | | 3 | 5 | | 4 |
| invalid opcode (36–3F), any mode | 1 | | | | | | | | | |

Stop column: a valid opcode with a mode it doesn't accept: I := 0, H := 1, PC back on the instruction, then the halt loop.

| Sequence | Steps |
|---|---|
| hardware interrupt entry, after the boundary step (W1, IE1–IE8) | 9 |
| software interrupt entry, after the boundary step (W1, W2, IE1–IE8) | 10 |
| halt loop (W1, W2) | 2 per check |
| reset released → first fetch (S1 × 2, S2–S9, 65,537 copy steps, PC − 1) | 65548 (32.8 ms) |
