SteriCraft/hbc2-ide/Documentation/HBC-2_CPU_diagram.png

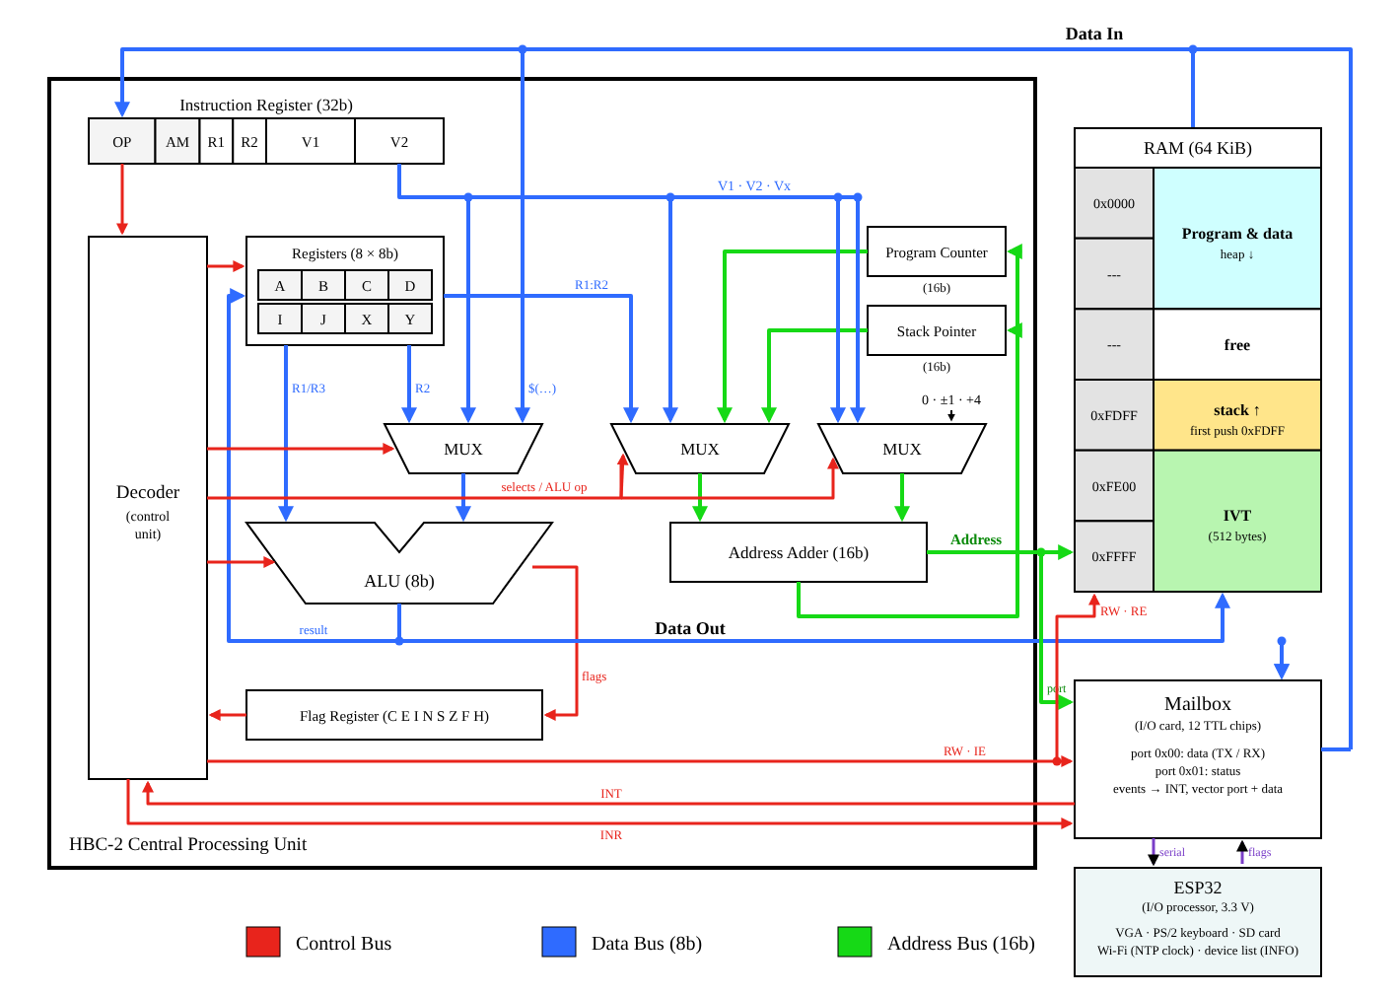
Documentation/HBC-2_CPU_diagram.png
