SteriCraft/hbc2-ide/Documentation/Peripherals/Screen/ASCII table.png

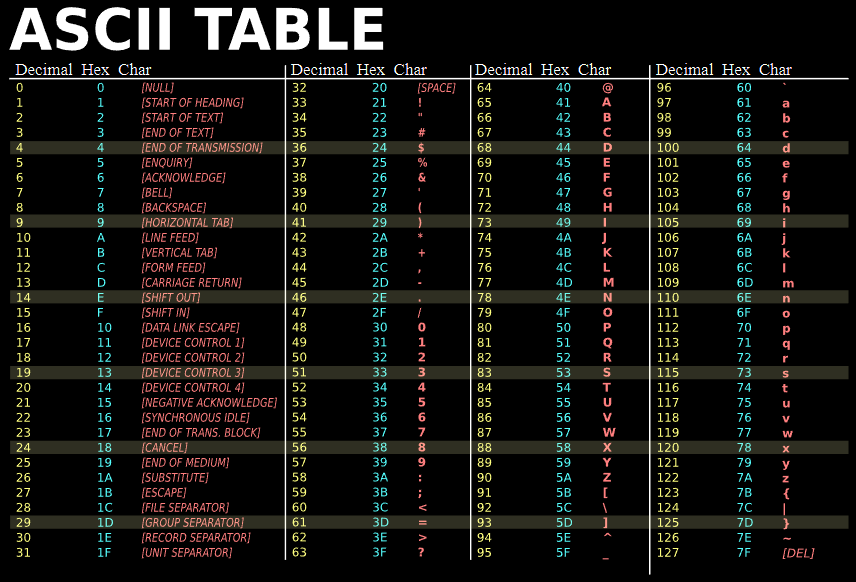
Documentation/Peripherals/Screen/ASCII table.png
