SteriCraft/hbc2-ide/HBC-2_IDE/res/z80.jpg

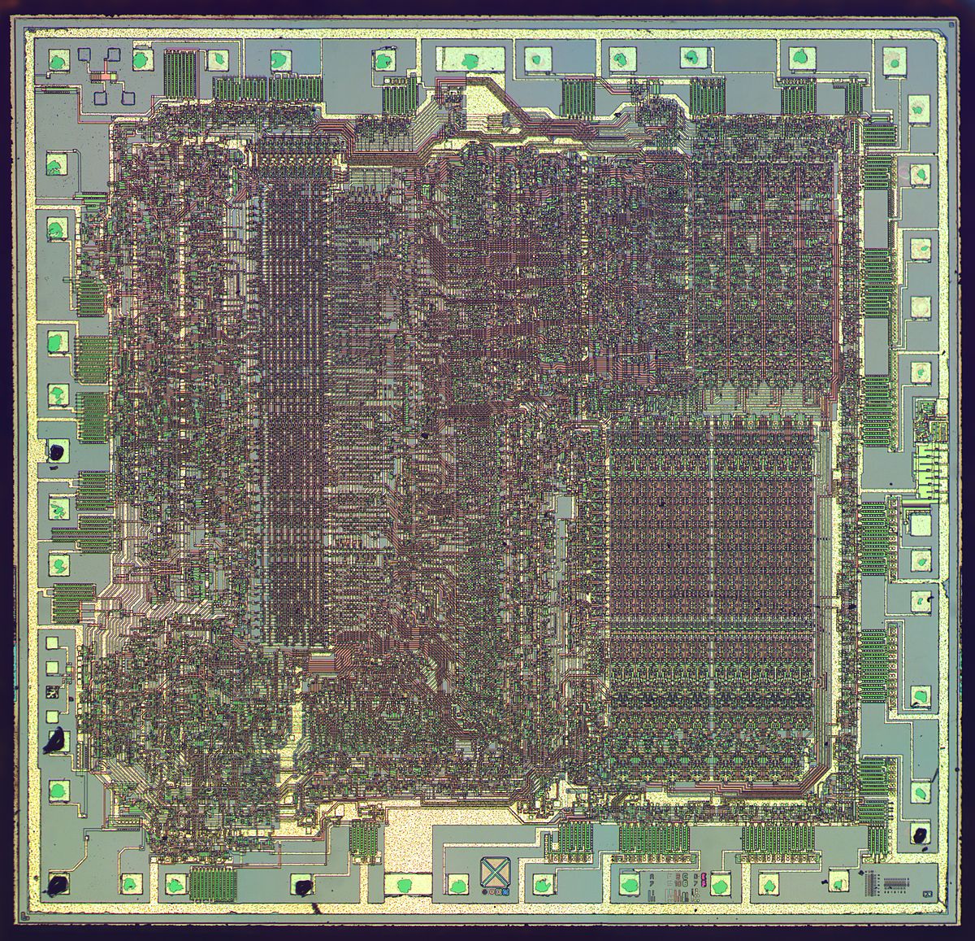
HBC-2_IDE/res/z80.jpg
