SteriCraft/hbc2-ide/logisim/notes/bom-iod.csv

part | function | qty | dip_ref | soic_ref | modules | spare
74HCT32 | quad 2-input OR | 1 | SN74HCT32N | 74HCT32D (Nexperia) | iod | 1
74HCT74 | dual D flip-flop, set / reset | 4 | SN74HCT74N | 74HCT74D (Nexperia) | iod | 1
74HCT138 | 3-to-8 decoder | 1 | SN74HCT138N | 74HCT138D (Nexperia) | iod | 1
74HCT165 | 8-bit parallel-in / serial-out shift register | 1 | CD74HCT165E | CD74HCT165M96 (TI) | iod | 1
74HCT244 | octal buffer, tri-state, two 4-bit halves | 2 | CD74HCT244E (STATUS); SN74LVC244AN at 3.3 V (the ESP32 side) | 74HCT244D (Nexperia); SN74LVC244ADWR (TI) | iod | 1
74HCT595 | 8-bit shift register + storage register, tri-state | 3 | SN74AHCT595N | SN74AHCT595D (TI) | iod | 1
total | 6 part numbers | 12 |  |  |  | 6
