SteriCraft/hbc2-ide/logisim/notes/bom-flags.csv

part | function | qty | dip_ref | soic_ref | modules | spare
74HCT11 | triple 3-input AND | 3 | CD74HCT11E | 74HCT11D (Nexperia) | flags | 1
74HCT86 | quad 2-input XOR | 1 | CD74HCT86E | 74HCT86D (Nexperia) | flags | 1
74HCT138 | 3-to-8 decoder | 2 | SN74HCT138N | 74HCT138D (Nexperia) | flags | 1
74HCT153 | dual 4-to-1 multiplexer | 4 | CD74HCT153E | 74HCT153D (Nexperia) | flags | 1
74HCT157 | quad 2-to-1 multiplexer | 2 | CD74HCT157E | 74HCT157D (Nexperia) | flags | 1
74HCT175 | quad D flip-flop with clear | 2 | CD74HCT175E | CD74HCT175M96 (TI) | flags | 1
74HCT541 | octal buffer, tri-state | 1 | SN74HCT541N | 74HCT541D (Nexperia) | flags | 1
total | 7 part numbers | 15 |  |  |  | 7
