SteriCraft/hbc2-ide/Documentation/HBC-2_Instruction_Manual.pdf

HBC-2 IDE Instruction Manual

# HBC-2 IDE Instruction Manual

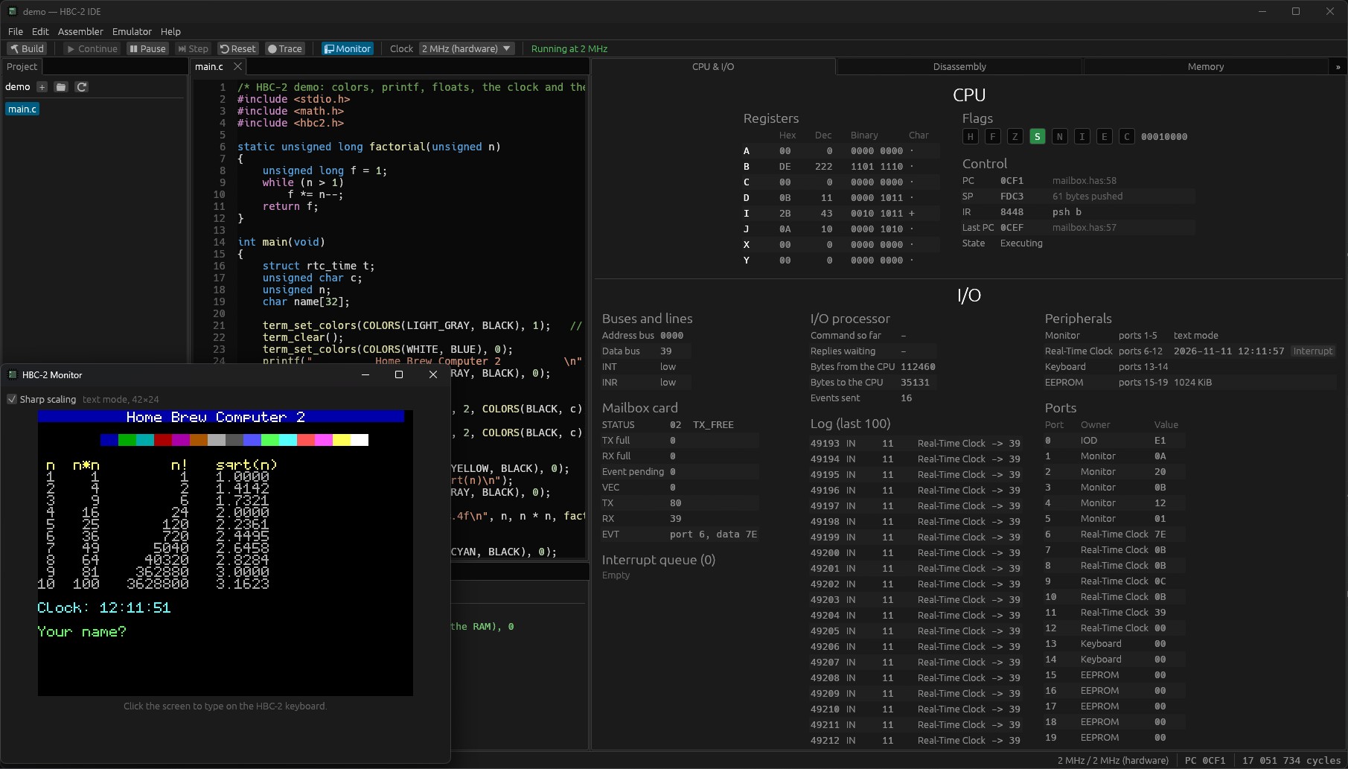
[picture p11: figure]

Gianni LECLERCQ | 1 | 2026

Gianni LECLERCQ | 2 | 2026

## Summary

## I. Generalities

II. | Instruction format and addressing modes
III. | Random Access Memory
IV. | I/O interface

## V. Hardware interrupts

## VI. Software interrupts

## VII. Instruction set

Gianni LECLERCQ | 3 | 2026

## Generalities

The HomeBrew Computer 2 (or HBC-2) is a home made 8 bit CPU designed to understand the basics of computer science via a simplified central processing unit.

Specifications

Data bus width | 8 bits
Address bus width | 16 bits
RAM maximum capacity | 64 kB
Clock frequency | 2 Mhz
Instruction size | 1 – 4 bytes
Instruction set size | 54
Architecture | Von Neumann / RISC
Stack | 16-bit stack pointer (STK) Grows downward - STK = 0xFE00 at reset (no under/overflow flag)
I/O | 256 Using a hardware mailbox ESP32 used to handle peripherals

An IDE (Integrated Development Environment) is available to program this CPU in a custom assembly language, and emulate the computer's behavior.

This software allows for a deep insight of the internal mechanisms of the computer. Various windows offer a view of the RAM in real-time, of the CPU registers, and many other elements.

The goal of this manual is to provide detailed explanation about the computer's systems, the IDE and the assembly language that has been developed.

Gianni LECLERCQ | 4 | 2026

## Instruction format

## and addressing modes

Instructions

Operand (6b) | A.M. (4b) | R1 (3b) | R2 (3b) | V1 (8b) | V2 (8b)

Instructions are 8-32 bits (or 1-4 bytes) long, divided in up to 4 sections :
1. A 6 bits operand (64 instructions maximum, 54 implemented),
2. A 4 bits addressing mode (16 addressing modes maximum, 9 implemented),
3. Two 3 bits register selectors (8 registers, A, B, C, D, I, J, X, Y),
4. Two 8 bits user-defined values.

The CPU first fetches one byte, giving it the operand.
→ Some instruction use no addressing mode, thus using only 1 byte.

If necessary to check for the addressing mode, the CPU fetches a second byte.
→ Some instruction use only 2 selected registers, which are available in the second byte. Thus taking no more space.

The addressing mode may require 1 or 2 additional bytes.

Bad opcode and bad addressing modes

If the CPU finds an invalid opcode:
→ It treats it as the nop instruction, and skips no further bytes.

If the CPU finds a valid opcode with invalid addressing mode:
→ It clear the interrupt flag and halts (hlt), thus freezing the computer until reset.
Gianni LECLERCQ | 5 | 2026

## Addressing modes (A.M.)

Many instructions can work in multiple addressing modes. Those modes allow to use pointers, mandatory for a Turing-complete machine.

The instruction set described at the end of this manual gives information about which addressing modes you can use for each instruction.

None | 0x0
Reg | 0x1
Reg / Imm8 | 0x2
Reg / Ram | 0x3
RamReg / ImmReg / Offset | 0x4
Stack / Offset | 0x5
Reg16 | 0x6
Imm16 | 0x7
Imm8 | 0x8

## None

No data is specified, the operand is sufficient.

Operand (6b) 0x0 (4b)

## Reg

Two 8-bit values retrieved from registers 1 and 2.

Operand (6b) | 0x1 (4b) | R1 (3b) | R2 (3b)
Gianni LECLERCQ | 6 | 2026

## Reg / Imm8

One 8-bit value retrieved from register 1 and one user-defined 8-bit value.

Operand (6b) | 0x2 (4b) | R1 (3b) | 0x0 (3b) | V1 (8b)

## Reg / Ram

One user-defined 16-bit value and one 8-bit value retrieved from register 1.

Operand (6b) | 0x3 (4b) | R1 (3b) | 0x0 (3b) | Vx (16b)

## RamReg / ImmReg / Offset

Register 1 and 2 are concatenated as a 16-bit address to retrieve one 8-bit value from memory. Register 1 is the most significant byte (MSB).
V2 is a user-defined 8-bit value that is added to the address as an offset.
The 8-bit value in register 3 is used directly.
Operand (6b) | 0x4 (4b) | R1 (3b) | R2 (3b) | R3 (8b) | V2 (8b)

## Stack / Offset

One 8-bit value read from memory at the stack pointer plus an offset (V1). Register 1 holds the data.

Operand (6b) | 0x5 (4b) | R1 (3b) | 0x0 (3b) | V1 (8b)

## Reg16

Register 1 and 2 are concatenated in a 16-bit value used directly. Register 1 is the most significant byte (MSB).

Operand (6b) | 0x6 (4b) | R1 (3b) | R2 (3b)
Gianni LECLERCQ | 7 | 2026

## Imm16

One user-defined 16-bit value.

Operand (6b) | 0x7 (4b) | 0x0 (3b) | 0x0 (3b) | Vx (16b)

## Imm8

One user-defined 8-bit value.

Operand (6b) | 0x8 (4b) | 0x0 (3b) | 0x0 (3b) | V1 (8b)
Gianni LECLERCQ | 8 | 2026

## Random Access Memory (RAM)

The microprocessor uses two buses to access data from external devices, one for data, and one for the address. Those buses are used both to access RAM and I/O devices.

Data bus width | 8 bits
Address bus width (RAM) | 16 bits (64 kB)

Memory map

Address | Content
0x0000 | Start of the program: the CPU starts here after power-on
0x0000 – 0xFDFF | Program and data, from 0x0000 up Stack, from 0xFDFF down (STK = 0xFE00 at reset)
0xFE00 – 0xFFFF | Interrupt vector table (512 bytes, see Hardware interrupts)

At power-on, the boot ROMs (two AT28C256 of 32 kB) copy 64 kB into the RAM, which takes 65,548 clock cycles (about 33 ms at 2 MHz). Then the CPU starts at 0x0000. Programming the computer means writing the program's RAM image into these two ROMs.

Control lines

RAM | RW (Read / Write) + RE (Ram Enable)
I/O access | RW (Read / Write) + IE (I/O Enable)

To access data from RAM, the CPU sets the R/W pin accordingly, and sets the RE pin to HIGH. To access data from I/O, the CPU sets the R/W pin accordingly, and sets the IE pin to HIGH.

When the RE pin is set to HIGH, the IE pin is always set to LOW, and vice versa.

Gianni LECLERCQ | 9 | 2026

## I/O interface

The CPU does not talk to the devices directly. Its IN and OUT instructions reach the I/O mailbox card, a card of 12 TTL chips. Behind it, an I/O processor (ESP32) runs the devices: it gives them their ports and queues their interrupts.

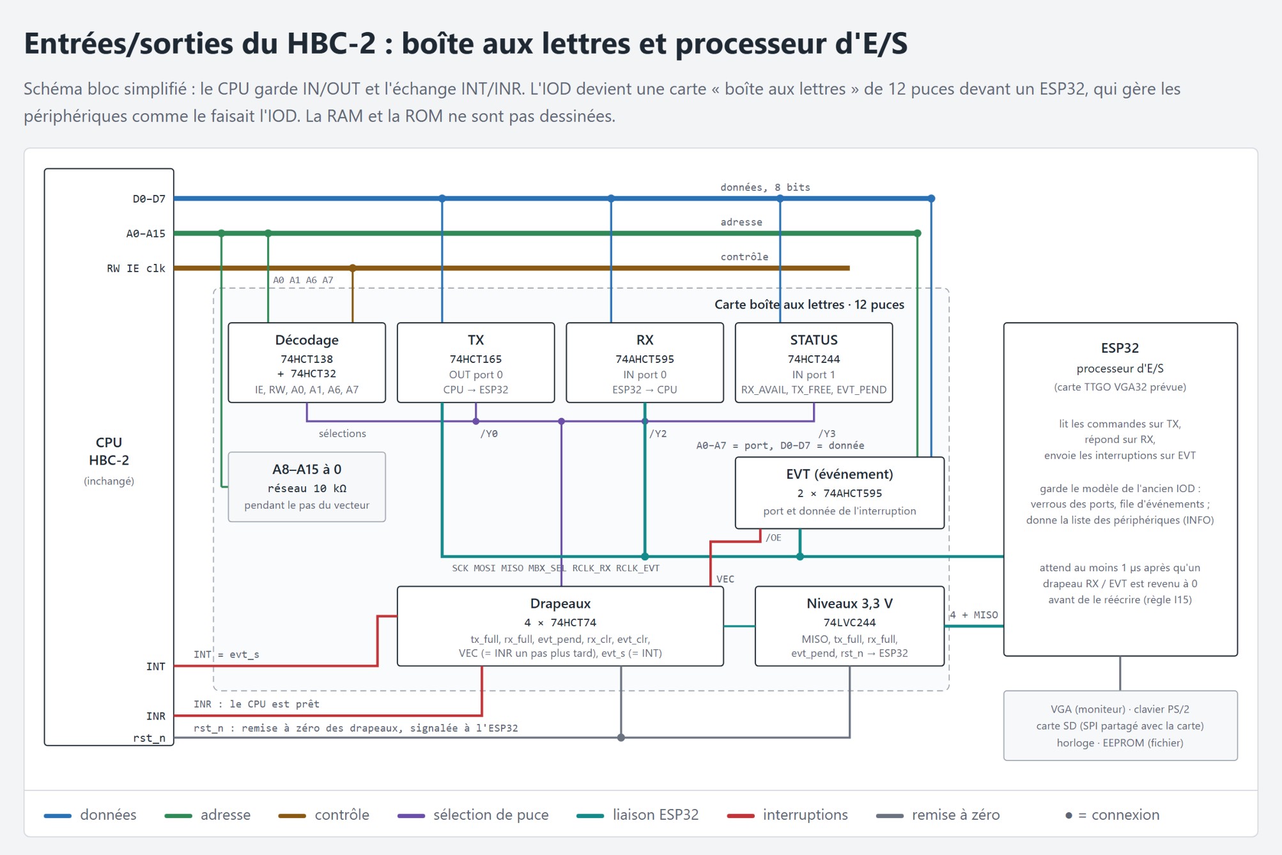
[picture p12: figure]

The I/O mailbox card and the I/O processor (HBC-2_Input_Output.pdf)

Gianni LECLERCQ | 10 | 2026

Ports

Address bus width (I/O) | 8 bits (256 ports)

This means that when accessing I/O ports, the CPU only uses the 8 least significant bits of the address bus. Whatever is on the 8 other bits is left unused. The port number is read by the mailbox, which is triggered by the IE pin (I/O Enable).

The card decodes only 0x00–0x3F: with A1 = 0, A2–A5 are ignored, so ports 0 and 1 repeat (0x04/0x05, 0x08/0x09 … 0x3C/0x3D); 0x40–0xFF are empty.

Port | IN | OUT
0x00 | RX: next byte from the I/O processor | TX: one byte to the I/O processor
0x01 | STATUS: bit 0 RX_AVAIL, bit 1 TX_FREE, bit 2 EVT_PEND, bits 3-7 = 0 | N/A

The mailbox card

The card holds one byte in each direction and one pending event:

Part | Chips | Role
TX | 74HCT165 | Loaded by OUT on port 0x00; the ESP32 reads it
RX | 74AHCT595 | Written by the ESP32; IN on port 0x00 reads it
EVT | 2 × 74AHCT595 | An event: its port on A0–A7 and its data on D0–D7, during the vector step
STATUS | 74HCT244 | RX_AVAIL, TX_FREE, EVT_PEND on the data bus
Decoding | 74HCT138, 74HCT32 | Selects TX, RX or STATUS from IE, RW, A0, A1, A6, A7
Flags | 4 × 74HCT74 | tx_full, rx_full, evt_pend; INT for the CPU
Levels | 74LVC244 | 5 V to 3.3 V towards the ESP32
Pull-downs | 10 kΩ network | Hold A8–A15 at 0 during the vector step

The ESP32 reads TX and writes RX and EVT through a serial link (SCK, MOSI, MISO, MBX_SEL, RCLK_RX, RCLK_EVT), and reads the card's flags. It waits at least 1 µs after the RX or EVT flag went back to 0 before writing that register again.

Gianni LECLERCQ | 11 | 2026

The I/O processor (ESP32)

The ESP32 keeps 256 device ports (8-bit latches) and gives each device a block of consecutive ports, from port 1 up. Port 0 is never given to a device: a port variable at 0 means "no such device". It keeps a queue of 256 events and hands them to the mailbox one at a time. Its devices are the screen (the native display, and the old monitor ports on the same picture), the PS/2 keyboard, the clock and the EEPROM (an SD card later). There is no mouse and no audio.

Device | Class | Product ID | Ports
Monitor (old ports) | 03 00 (display, VGA) | 0x0001 | 5
Real-time clock | 08 03 (system, RTC) | 0x0002 | 7
Keyboard | 09 00 (input, keyboard) | 0x0003 | 2
EEPROM | 01 80 (storage, other) | 0x0004 | 5
Native display | 03 80 (display, other) | 0x0006 | 1

Protocol

The CPU sends commands of one or more bytes. To send a byte, it reads STATUS until TX_FREE = 1, then writes the byte to port 0x00. To receive a byte, it reads STATUS until RX_AVAIL = 1, then reads port 0x00. Replies come in order; events come on EVT and never mix with replies.

Bytes sent | Command | Reply on RX
0x00 | NOP | none
0x01 p v | OUT: device port p = v | none
0x02 p | IN: read device port p | 1 byte: the value of port p
0x03 | INFO: the devices | protocol version, N, then N × 6 bytes
0x10 – 0x7F | Native commands of the screen | only the commands that read

Any other command byte is ignored, as a NOP. An IN after an OUT always sees its result.

Commands 0x10 to 0x7F are the native commands of the screen: text, graphics, the VSYNC tick (60 Hz) and the time. The ESP32 does the drawing, so one character costs 2 bytes and clearing the screen 2 bytes, instead of 5 OUT commands per character through the old monitor ports. They are described in the HBC-2 Monitor Instruction Manual.

Each command is sent with interrupts disabled (CLI), so that an interrupt handler cannot slip its own bytes into it. The library routines mbx_out and mbx_in do this. The library keeps interrupts

Gianni LECLERCQ | 12 | 2026

disabled for one command at a time, never for a whole call: the longest stretch is one PUTS of 255 characters, 6.7 ms. Meanwhile keys wait in the ESP32's queue; nothing is lost.

INFO replies with the protocol version (2: the native commands), the number of devices N, then one 6-byte descriptor per device, in port order: the class (2 bytes: PCI base class and subclass), the product ID (2 bytes, high byte first), the first port and the number of ports. Programs find a device by its class, never by a fixed port number.

Start-up and reset

1. At power-on, the program sends INFO and waits for the reply. The ESP32 takes about 1 s to boot; meanwhile the command just waits in TX.
2. The program waits 2 s at most for each byte. Without an answer, it sees no devices.
3. The reset button resets the CPU and the mailbox card only. The ESP32 keeps running and keeps the devices, their ports and the event queue; it drops a command it was halfway through receiving. The program starts again, sends INFO and gets the answer at once.

In assembly, dev_init and dev_find (devices.has) do this; in C, the start-up code does it before main and sets display_port, monitor_port, keyboard_port, rtc_port and eeprom_port (0 when the device is missing).

The complete description is in HBC-2_Input_Output.md, in the Documentation folder.

Gianni LECLERCQ | 13 | 2026

## Hardware interrupts

To handle interrupts, the microprocessor implements two control lines, INT (pending interrupt) and INR (interrupt ready), that can be triggered by the CPU and the mailbox.

CPU side

The CPU is not necessarily ready to handle interrupts. An interrupt flag is implemented in the flag register. When this flag is set, the CPU is capable of handling interrupts. Two instructions control this behaviour : STI (Set Interrupt flag), and CLI (Clear Interrupt flag).

When the CPU has received an interrupt, and is ready to manage it, it retrieves the I/O port number via the mailbox, and then jumps to a memory location defined by the programmer in the interrupt vector table (IVT).

The interrupt vector table is a 512 bytes memory block in the RAM, located from address 0xFE00 to address 0xFFFF. Those address holds pointers that the CPU uses to set the PC (Program Counter register). As a reminder, RAM addresses are 2 bytes long, and there are 256 I/O ports that are numbered from 0x00 to 0xFF.

I/O port number | Address in the IVT
0x00 (reserved: unused) | 0xFE00 << 0xFE01
0x01 | 0xFE02 << 0xFE03
[...] | [...]
0xFE | 0xFFFC << 0xFFFD
0xFF | 0xFFFE << 0xFFFF
Gianni LECLERCQ | 14 | 2026

Procedure:
1. The ESP32 loads an event (port and data) into the mailbox. EVT_PEND is set, and the mailbox raises INT, synchronised to the clock.
2. If the interrupt flag is set to HIGH, the CPU finishes the current instruction and sets the INR control line to HIGH for one clock cycle,
3. During the vector step, the mailbox drives the port on A0–A7 and the data on the data bus. A8–A15 are driven by nobody; pull-down resistors on the I/O card hold them at 0.
4. The CPU then reads the I/O port number on the address bus, pushes the I register, pushes the PC register to the stack, stores the I/O data in the I register, sets the interrupt flag to LOW, sets the INR control line to LOW, and then jumps to the memory location pointed by the interrupt vector table.
5. EVT_PEND clears in the step after the vector step. The ESP32 then sends the next event from its queue, at least 1 µs after the flag went to 0. So INT can't come back on the very next cycle.
6. When the CPU has finished processing the interrupt (by reaching the IRT instruction), it pops the PC register out of the stack to get back to work on the code that was interrupted, and pops the I register. If INT pin is HIGH, it manages the next interrupt immediately.

I/O processor side (ESP32)

The CPU does not always have enough time to process an interrupt before the next one is triggered. The I/O processor (ESP32) keeps the 256-entry queue and hands the events to the mailbox one at a time. The mailbox holds only one event.

If an interrupt is triggered but the previous one was not processed by the CPU yet, then the I/O port number is stacked in the queue of the I/O processor (ESP32), and the mailbox will keep the INT control line HIGH until the
CPU is ready to manage it.

If the queue is full, any new interrupt will be discarded.

Gianni LECLERCQ | 15 | 2026

## Software interrupts

The CPU implements the INT instruction, that triggers a software interrupt on the I/O port number defined by the programmer in the V1 value of the instruction.

This kind of interrupt does not end up in a dialog between the CPU and the mailbox. Also, they have no priority on hardware interrupts.

Register I will be pushed onto the stack, and the CPU will handle this interrupt just a regular hardware interrupt. Therefore, instruction INT sets the data bus with the content of register I.

Gianni LECLERCQ | 16 | 2026

## Instruction set

Abreviation | Operand | A.M. | Description | Flags
NOP | 0x00 | | No operation
ADC | 0x01 | Reg | R1 = R1 + R2 + Carry flag | C N Z
| | Reg / Imm8 | R1 = R1 + V1 + Carry flag
| | Reg / Ram | R1 = R1 + $(Vx) + Carry flag
| | RamReg / ImmReg / Offset | R3 = R3 + $((R1 << R2) + V2) + Carry flag
| | Stack / Offset | R1 = R1 + $(STK + V1) + Carry flag
ADD | 0x02 | Reg | R1 = R1 + R2
| | Reg / Imm8 | R1 = R1 + V1
| | Reg / Ram | R1 = R1 + $(Vx)
| | RamReg / ImmReg / Offset | R3 = R3 + $((R1 << R2) + V2)
| | Stack / Offset | R1 = R1 + $(STK + V1)
AND | 0x03 | Reg | R1 = R1 & R2 | Z N
| | Reg / Imm8 | R1 = R1 & V1
| | Reg / Ram | R1 = R1 & $(Vx)
| | RamReg / ImmReg / Offset | R3 = R3 & $((R1 << R2) + V2)
| | Stack / Offset | R1 = R1 & $(STK + V1)
CAL | 0x04 | Reg16 | STK = STK − 1, $(STK) = PC_LSB STK = STK − 1, $(STK) = PC_MSB 1 PC = R1 << R2
| | Imm16 | STK = STK − 1, $(STK) = PC_LSB STK = STK − 1, $(STK) = PC_MSB PC = Vx
CLC | 0x05 | | Clears the Carry flag | C

1 PC: Program Counter

Gianni LECLERCQ | 17 | 2026

CLE | 0x06 | | Clears the Equal flag | E
CLI | 0x07 | | Clears the Interrupt flag | I
CLN | 0x08 | | Clears the Negative flag | N
CLS | 0x09 | | Clears the Superior flag | S
CLZ | 0x0A | | Clears the Zero flag | Z
CLF | 0x0B | | Clears the Inferior flag | F
CMP | 0x0C | Reg | 2 FR = R1 ? R2 | S E F
| | Reg / Imm8 | FR = R1 ? V1
| | RamReg / ImmReg / Offset | FR = R3 ? $((R1 << R2) + V2)
| | Stack / Offset | FR = R1 ? $(STK + V1)
DEC | 0x0D | Reg | R1 = R1 - 1 | C N Z
| | Imm16 | $(Vx) = $(Vx) - 1
| | RamReg / ImmReg / Offset | $((R1 << R2) + V2) = $((R1 << R2) + V2) - 1
HLT | 0x0E | | Halts the CPU (if I flag is not set, the computer freezes until reset) | H
IN | 0x0F | Reg | Data bus = R1 Address bus = R2 IE = HIGH, RW = read
OUT | 0x10 | | Data bus = R2 Address bus = R1 IE = HIGH, RW = write
INC | 0x11 | Reg | R1 = R1 + 1 | C N Z
| | Imm16 | $(Vx) = $(Vx) + 1
| | RamReg / ImmReg / Offset | $((R1 << R2) + V2) = $((R1 << R2) + V2) + 1
INT | 0x12 | Imm8 | Software interrupt with port number V1: STK = STK − 1, $(STK) = I STK = STK − 1, $(STK) = PC_LSB STK = STK − 1, $(STK) = PC_MSB PC = $(0xFE00 + 2 × V1) Clears Interrupt flag | I

2 FR: Flag Register

Gianni LECLERCQ | 18 | 2026

Abreviation | Operand | A.M. | Description | Flags
IRT | 0x13 | | 3 PC_MSB = $(⁴ STK), STK = STK + 1 5 PC_LSB = $(STK), STK = STK + 1 I = $(STK), STK = STK + 1 Sets Interrupt flag | I
JMC | 0x14 | Reg16 | PC = $(R1 << R2) if Carry flag
| | Imm16 | PC = $(Vx) if Carry flag
JME | 0x15 | Reg16 | PC = $(R1 << R2) if Equality flag
| | Imm16 | PC = $(Vx) if Equality flag
JMN | 0x16 | Reg16 | PC = $(R1 << R2) if Negative flag
| | Imm16 | PC = $(Vx) if Negative flag
JMP | 0x17 | Reg16 | PC = $(R1 << R2)
| | Imm16 | PC = $(Vx)
JMS | 0x18 | Reg16 | PC = $(R1 << R2) if Superior flag
| | Imm16 | PC = $(Vx) if Superior flag
JMZ | 0x19 | Reg16 | PC = $(R1 << R2) if Zero flag
| | Imm16 | PC = $(Vx) if Zero flag
JMF | 0x1A | Reg16 | PC = $(R1 << R2) if Inferior flag
| | Imm16 | PC = $(Vx) if Inferior flag
STR | 0x1B | RamReg / ImmReg / Offset | $((R1 << R2) + V2) = R3
| | Reg / Ram | $(Vx) = R1
| | Stack / Offset | $(STK + V1) = R1
LOD | 0x1C | RamReg / ImmReg / Offset | R3 = $((R1 << R2) + V2)
| | Reg / Ram | R1 = $(Vx)
| | Stack / Offset | R1 = $(STK + V1)
MOV | 0x1D | Reg | R1 = R2
| | Reg / Imm8 | R1 = V1
NOT | 0x1E | Reg | R1 = ! R1 | Z N
| | Imm16 | $(Vx) = ! $(Vx)

3 PC_MSB: Program Counter most significant byte
4 STK: Stack pointer
5 PC_LSB: Program Counter least significant byte
Gianni LECLERCQ | 19 | 2026

Abreviation | Operand | A.M. | Description | Flags
OR | 0x1F | Reg | R1 = R1 | R2
| | Reg / Imm8 | R1 = R1 | V1
| | Reg / Ram | R1 = R1 | $(Vx)
| | RamReg / ImmReg / Offset | R3 = R3 | $((R1 << R2) + V2)
| | Stack / Offset | R1 = R1 | $(STK + V1)
POP | 0x20 | Reg | R1 = $(STK) STK = STK + 1
PSH | 0x21 | | STK = STK - 1 $(STK) = R1
RET | 0x22 | | PC_MSB = $(STK), STK = STK + 1 PC_LSB = $(STK), STK = STK + 1
SHL | 0x23 | Reg | Left shift on R1 | C Z N
ASR | 0x24 | | Arithmetical shift on R1
SHR | 0x25 | | Right shift on R1 | 6 Z N
STC | 0x26 | | Sets the Carry flag | C
STE | 0x27 | | Sets the Equality flag | E
STI | 0x28 | | Sets the Interrupt flag (after next instruction is done) | I
STN | 0x29 | | Sets the Negative flag | N
STS | 0x2A | | Sets the Superior flag | S
STZ | 0x2B | | Sets the Zero flag | Z
STF | 0x2C | | Sets the Inferior flag | F
PSF | 0x2D | | STK = STK - 1, $(STK) = FR | 7
POF | 0x2E | | FR = $(STK), STK = STK + 1 | All

6 SHR is a logical shift (bit 7 = 0).
7 POF overwrites all flags, Interrupt and Halt included (popping a value with the Halt flag set halts the CPU). In an interrupt handler, PSF first and POF just before IRT is safe: both flags are cleared when the handler starts.
Gianni LECLERCQ | 20 | 2026

Abreviation | Operand | A.M. | Description | Flags
SUB | 0x2F | Reg | R1 = R1 - R2 | C N Z
| | Reg / Imm8 | R1 = R1 - V1
| | Reg / Ram | R1 = R1 - $(Vx)
| | RamReg / ImmReg / Offset | R3 = R3 - $((R1 << R2) + V2)
| | Stack / Offset | R1 = R1 − $(STK + V1)
SBB | 0x30 | Reg | R1 = R1 - R2 - Carry flag | C N Z
| | Reg / Imm8 | R1 = R1 - V1 - Carry flag
| | Reg / Ram | R1 = R1 - $(Vx) - Carry flag
| | RamReg / ImmReg / Offset | R3 = R3 - $((R1 << R2) + V2) -Carry flag
| | Stack / Offset | R1 = R1 − $(STK + V1) - Carry flag
XOR | 0x31 | Reg | R1 = R1 ^ R2 | Z N
| | Reg / Imm8 | R1 = R1 ^ V1
| | Reg / Ram | R1 = R1 ^ $(Vx)
| | RamReg / ImmReg / Offset | R3 = R3 ^ $((R1 << R2) + V2)
| | Stack / Offset | R1 = R1 ^ $(STK + V1)
ASP | 0x32 | Imm8 | STK = STK + V1
| | Imm16 | STK = STK + Vx
8 SSP | 0x33 | Imm8 | STK = STK - V1
| | Imm16 | STK = STK - Vx
9RSP | 0x34 | Reg16 | R1 = STK_MSB, R2 = STK_LSB
10WSP | 0x35 | Reg16 | STK = R1 << R2
| | Imm16 | STK = Vx

8 SSP reserves space for local variables when a function starts, and ASP frees it before RET. The Imm16 mode is for large local arrays (more than 255 bytes).
9 RSP copies the stack pointer into a register pair, for the address of a local (&n).
10 WSP sets the stack pointer, to place the stack elsewhere than its reset position.
Gianni LECLERCQ | 21 | 2026
