SteriCraft/hbc2-ide/hbc2/crates/hbc2-asm/tests/trace/loop.csv

n | pc | ir | a | b | c | d | i | j | x | y | sp | flags | mem_w | io_w
0 | 0000 |  | 00 | 00 | 00 | 00 | 00 | 00 | 00 | 00 | FE00 | 04
1 | 0000 | 748003 | 03 | 00 | 00 | 00 | 00 | 00 | 00 | 00 | FE00 | 04
2 | 0003 | 748800 | 03 | 00 | 00 | 00 | 00 | 00 | 00 | 00 | FE00 | 04
3 | 0006 | 74985A | 03 | 00 | 00 | 5A | 00 | 00 | 00 | 00 | FE00 | 04
4 | 0009 | 749010 | 03 | 00 | 10 | 5A | 00 | 00 | 00 | 00 | FE00 | 04
5 | 000C | 8440 | 03 | 00 | 10 | 5A | 00 | 00 | 00 | 00 | FDFF | 04 | FDFF=03
6 | 000E | 4050 | 03 | 00 | 10 | 5A | 00 | 00 | 00 | 00 | FDFF | 04 |  | 10=03
7 | 0010 | 3440 | 02 | 00 | 10 | 5A | 00 | 00 | 00 | 00 | FDFF | 04
8 | 0012 | 3041 | 02 | 00 | 10 | 5A | 00 | 00 | 00 | 00 | FDFF | 14
9 | 0014 | 55C0001C | 02 | 00 | 10 | 5A | 00 | 00 | 00 | 00 | FDFF | 14
10 | 0018 | 5DC0000C | 02 | 00 | 10 | 5A | 00 | 00 | 00 | 00 | FDFF | 14
11 | 000C | 8440 | 02 | 00 | 10 | 5A | 00 | 00 | 00 | 00 | FDFE | 14 | FDFE=02
12 | 000E | 4050 | 02 | 00 | 10 | 5A | 00 | 00 | 00 | 00 | FDFE | 14 |  | 10=02
13 | 0010 | 3440 | 01 | 00 | 10 | 5A | 00 | 00 | 00 | 00 | FDFE | 14
14 | 0012 | 3041 | 01 | 00 | 10 | 5A | 00 | 00 | 00 | 00 | FDFE | 14
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
