SteriCraft/hbc2-ide/Documentation/HBC-2_CPU_diagram.pdf

### Instruction Register (32b)

## Data In

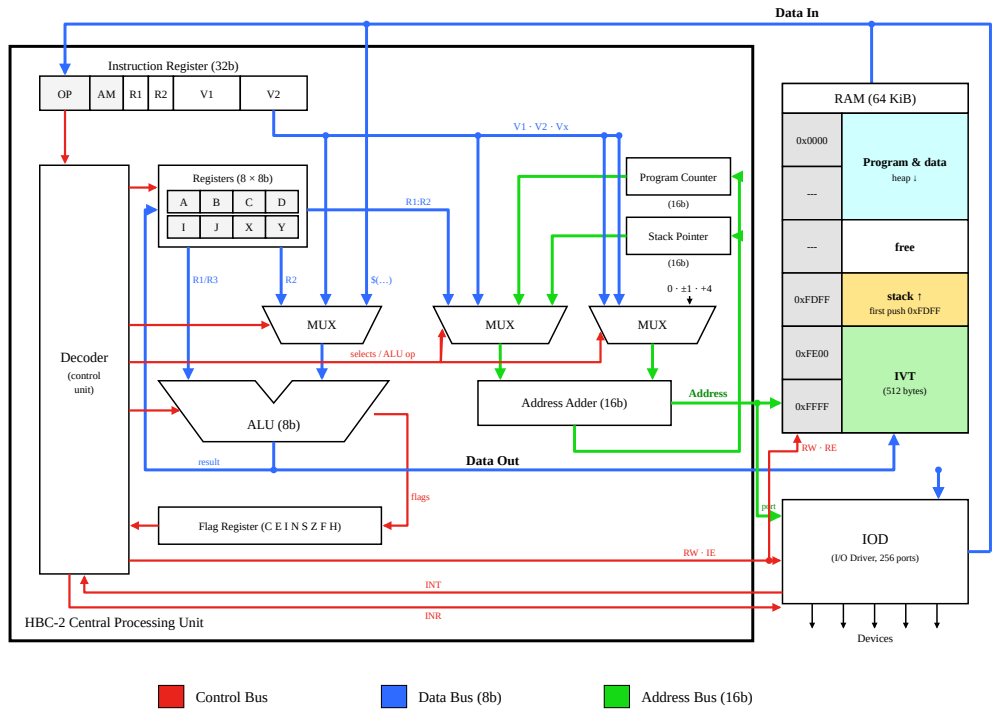
[picture p14: page 1]
Decoder; (control unit); Registers (8 × 8b); Flag Register (C E I N S Z F H); Program Counter; Stack Pointer; MUX; ALU (8b); result; flags; Address Adder (16b); Address; Data Out; RAM (64 KiB); 0xFDFF; 0xFE00; 0xFFFF; Program & data; heap ↓; free; stack ↑; first push 0xFDFF; IVT; (512 bytes); IOD; (I/O Driver, 256 ports); port; Devices; INT; INR; Control Bus; Data Bus (8b); Address Bus (16b)

selects / ALU op

HBC-2 Central Processing Unit
