SteriCraft/hbc2-ide/Documentation/CPU diagram.pdf

## Data bus

## Address bus

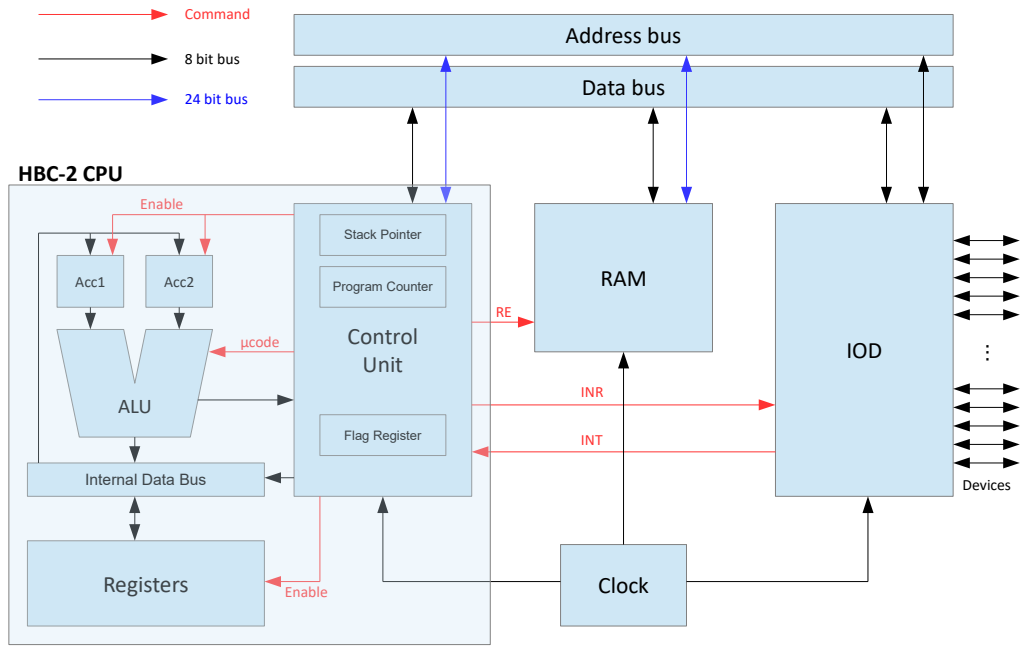
[picture p15: page 1]
ALU ALU; Acc1; Acc2; RAM; Control; Unit; IOD; INR; INT; µcode; Enable; Registers; Clock; Devices; Command; 8 bit bus; Stack Pointer; Program Counter; Flag Register; 24 bit bus; HBC-2 CPU

Internal Data Bus
