SteriCraft/hbc2-ide/(list of files, drawings)

Other design files:
Logisim/Circuit.circ
logisim/circuits/add8_ttl.circ
logisim/circuits/add_sub8/add_sub8.circ
logisim/circuits/addr/addr.circ
logisim/circuits/alu/add8.circ
logisim/circuits/alu/add_sub8.circ
logisim/circuits/alu/alu.circ
logisim/circuits/alu/arith8.circ
logisim/circuits/alu/cmp8.circ
logisim/circuits/alu/flags8.circ
logisim/circuits/alu/logic8.circ
logisim/circuits/alu/rmux8.circ
logisim/circuits/alu/shift8.circ
logisim/circuits/chips/74574.circ
logisim/circuits/chips/74595.circ
logisim/circuits/chips/as6c1008.circ
logisim/circuits/chips/at28c256.circ
logisim/circuits/chips/test_74165.circ
logisim/circuits/chips/test_74377.circ
logisim/circuits/chips/test_74670.circ
logisim/circuits/cpu.circ
logisim/circuits/cpu/test_cpu.circ
logisim/circuits/cu/clkgen.circ
logisim/circuits/cu/cu.circ
logisim/circuits/flags/flags.circ
logisim/circuits/iod/iod.circ
logisim/circuits/iod/test_iod_cpu.circ
logisim/circuits/iod/test_iod_cpu_eager.circ
logisim/circuits/iod/test_iod_cpu_reset_evt.circ
logisim/circuits/iod/test_iod_cpu_reset_rx.circ
logisim/circuits/iod/test_iod_cpu_reset_tx.circ
logisim/circuits/ir/ir.circ
logisim/circuits/mem/mem.circ
logisim/circuits/mem/test_mem_cpu.circ
logisim/circuits/registers/regs.circ
logisim/cpu.circ
Logisim/TTL_Version.circ
