SteriCraft/hbc2-ide/kicad/addr/hbc2_addr.kicad_sch

## KiCad design kicad/addr/hbc2_addr.kicad_sch (2026-11-14)

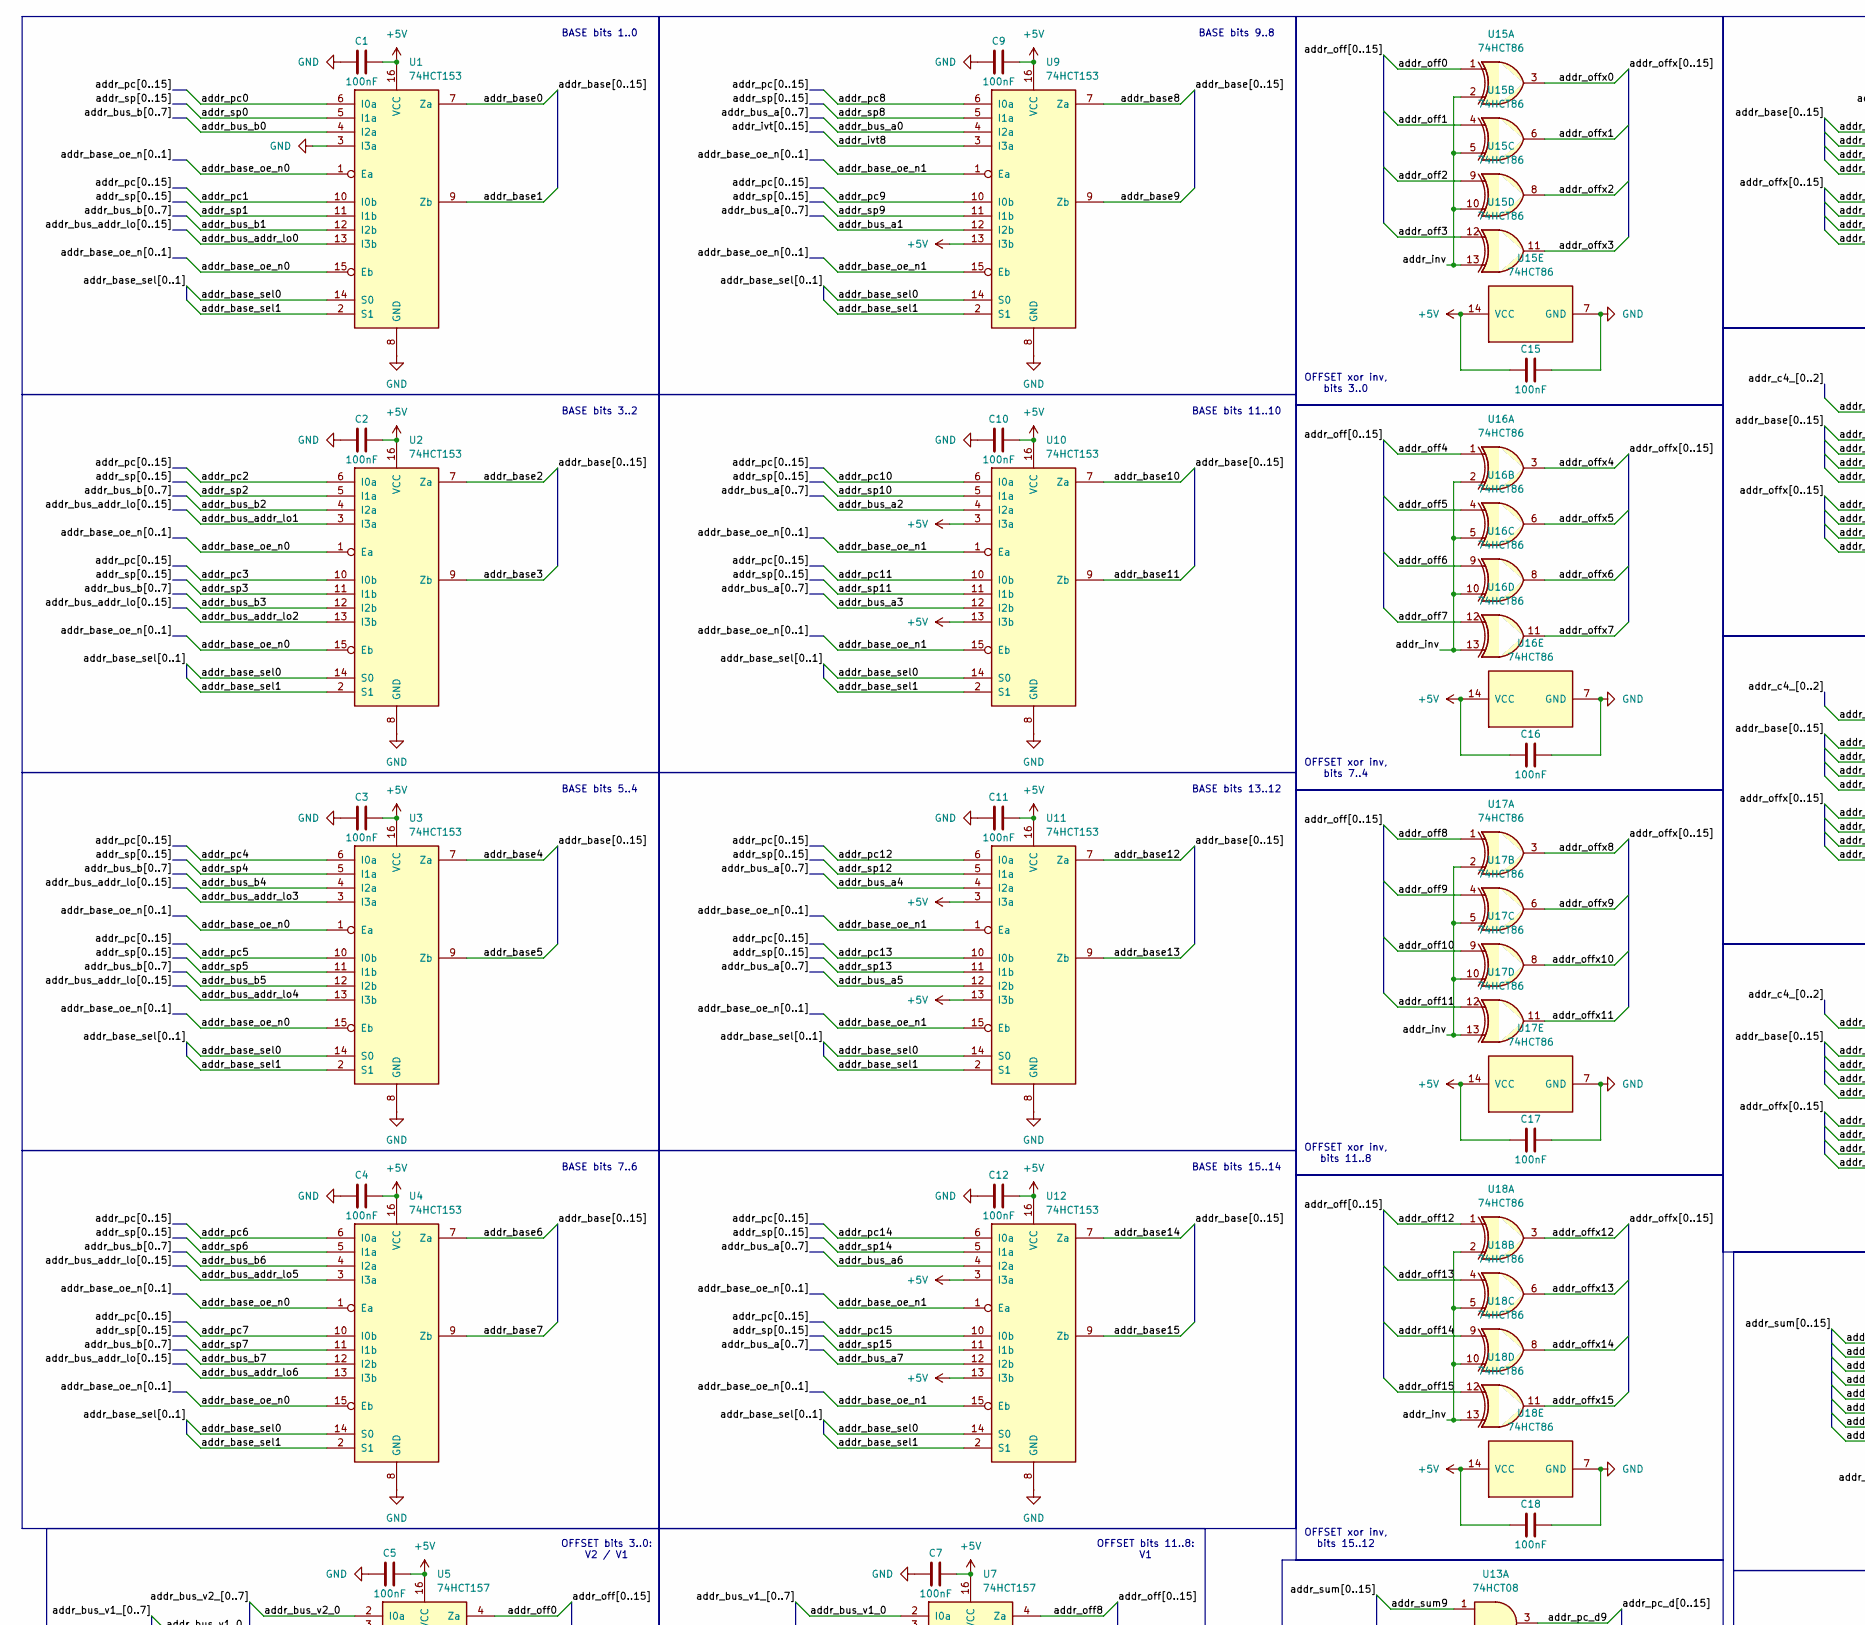
[picture p16: schematic hbc2_addr.kicad_sch, part in row 1, column 1]

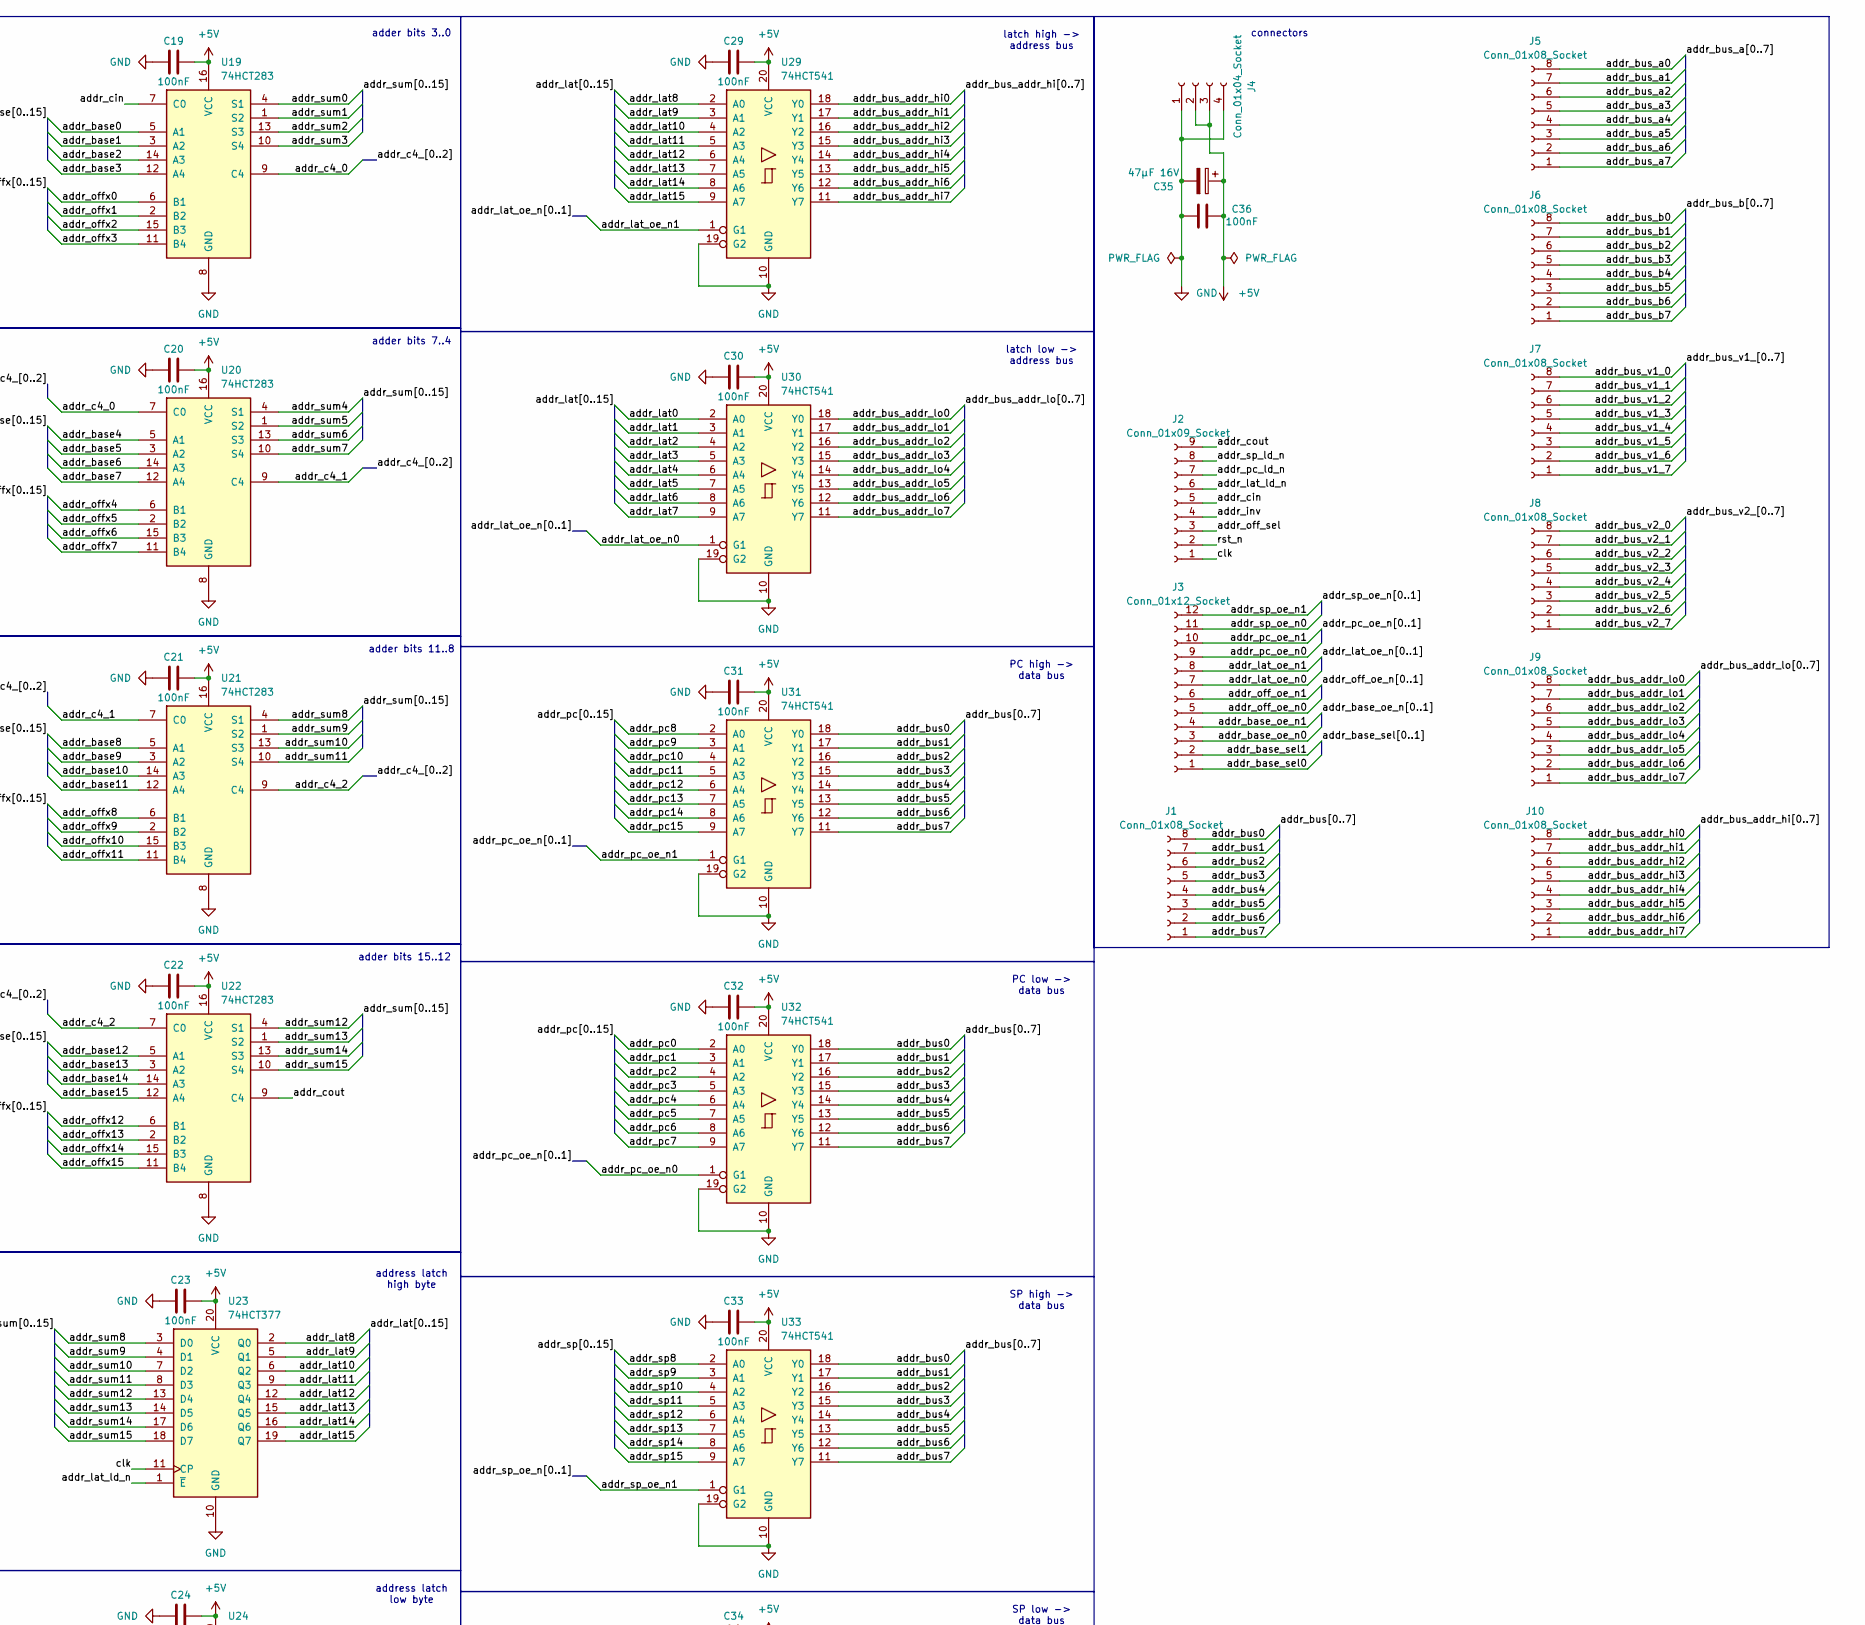
[picture p17: schematic hbc2_addr.kicad_sch, part in row 1, column 2]

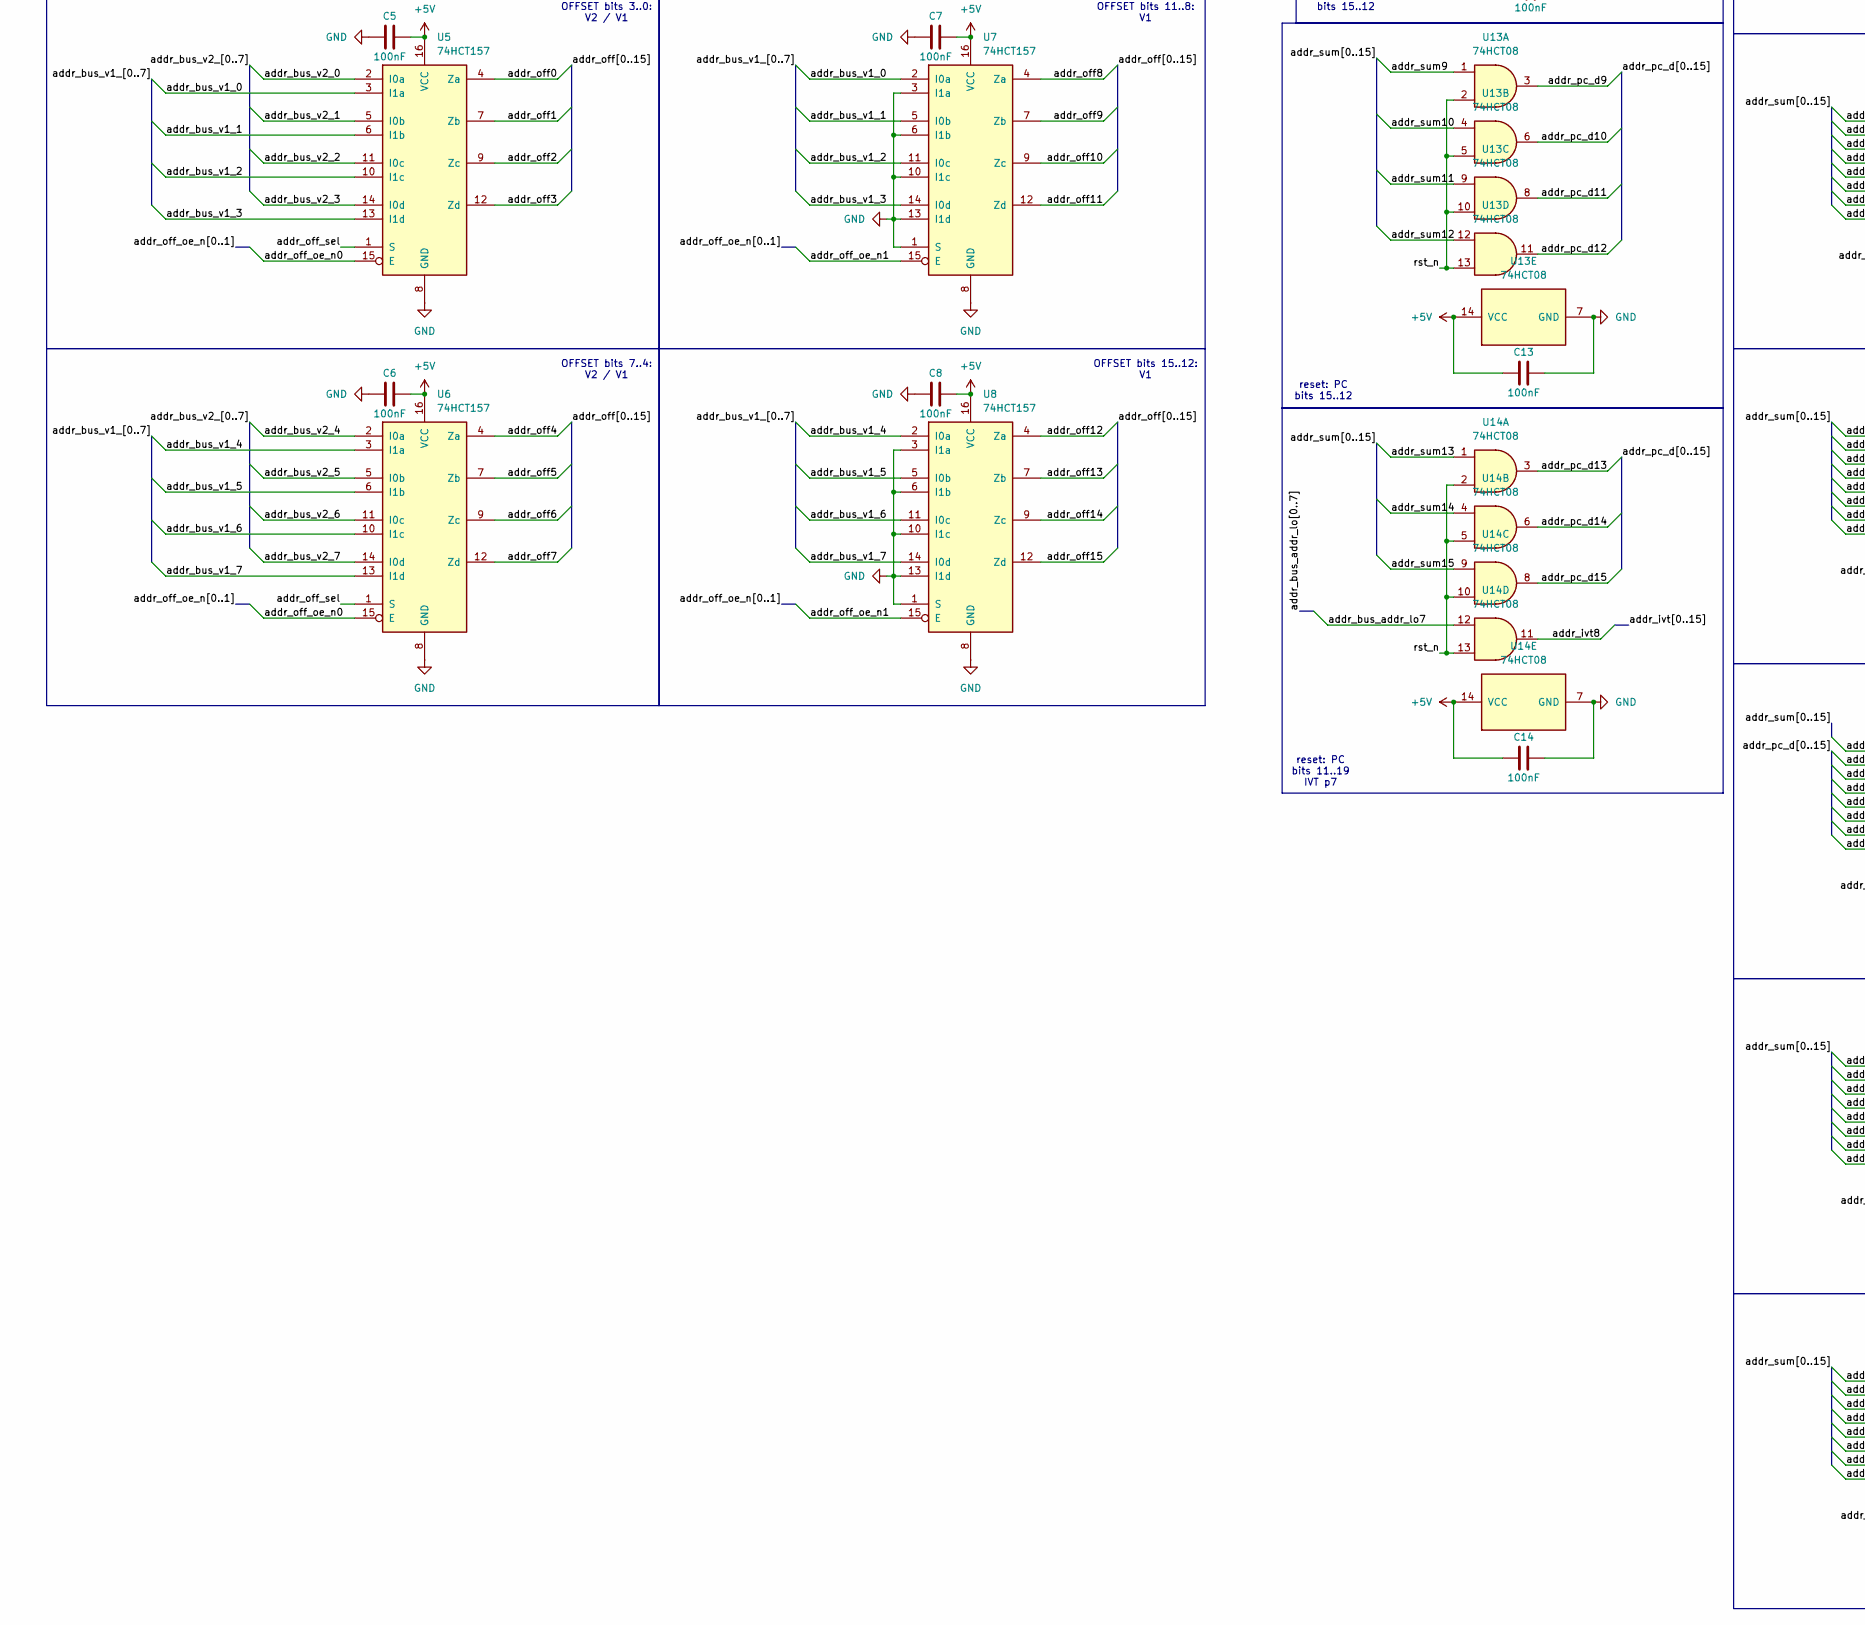
[picture p18: schematic hbc2_addr.kicad_sch, part in row 2, column 1]

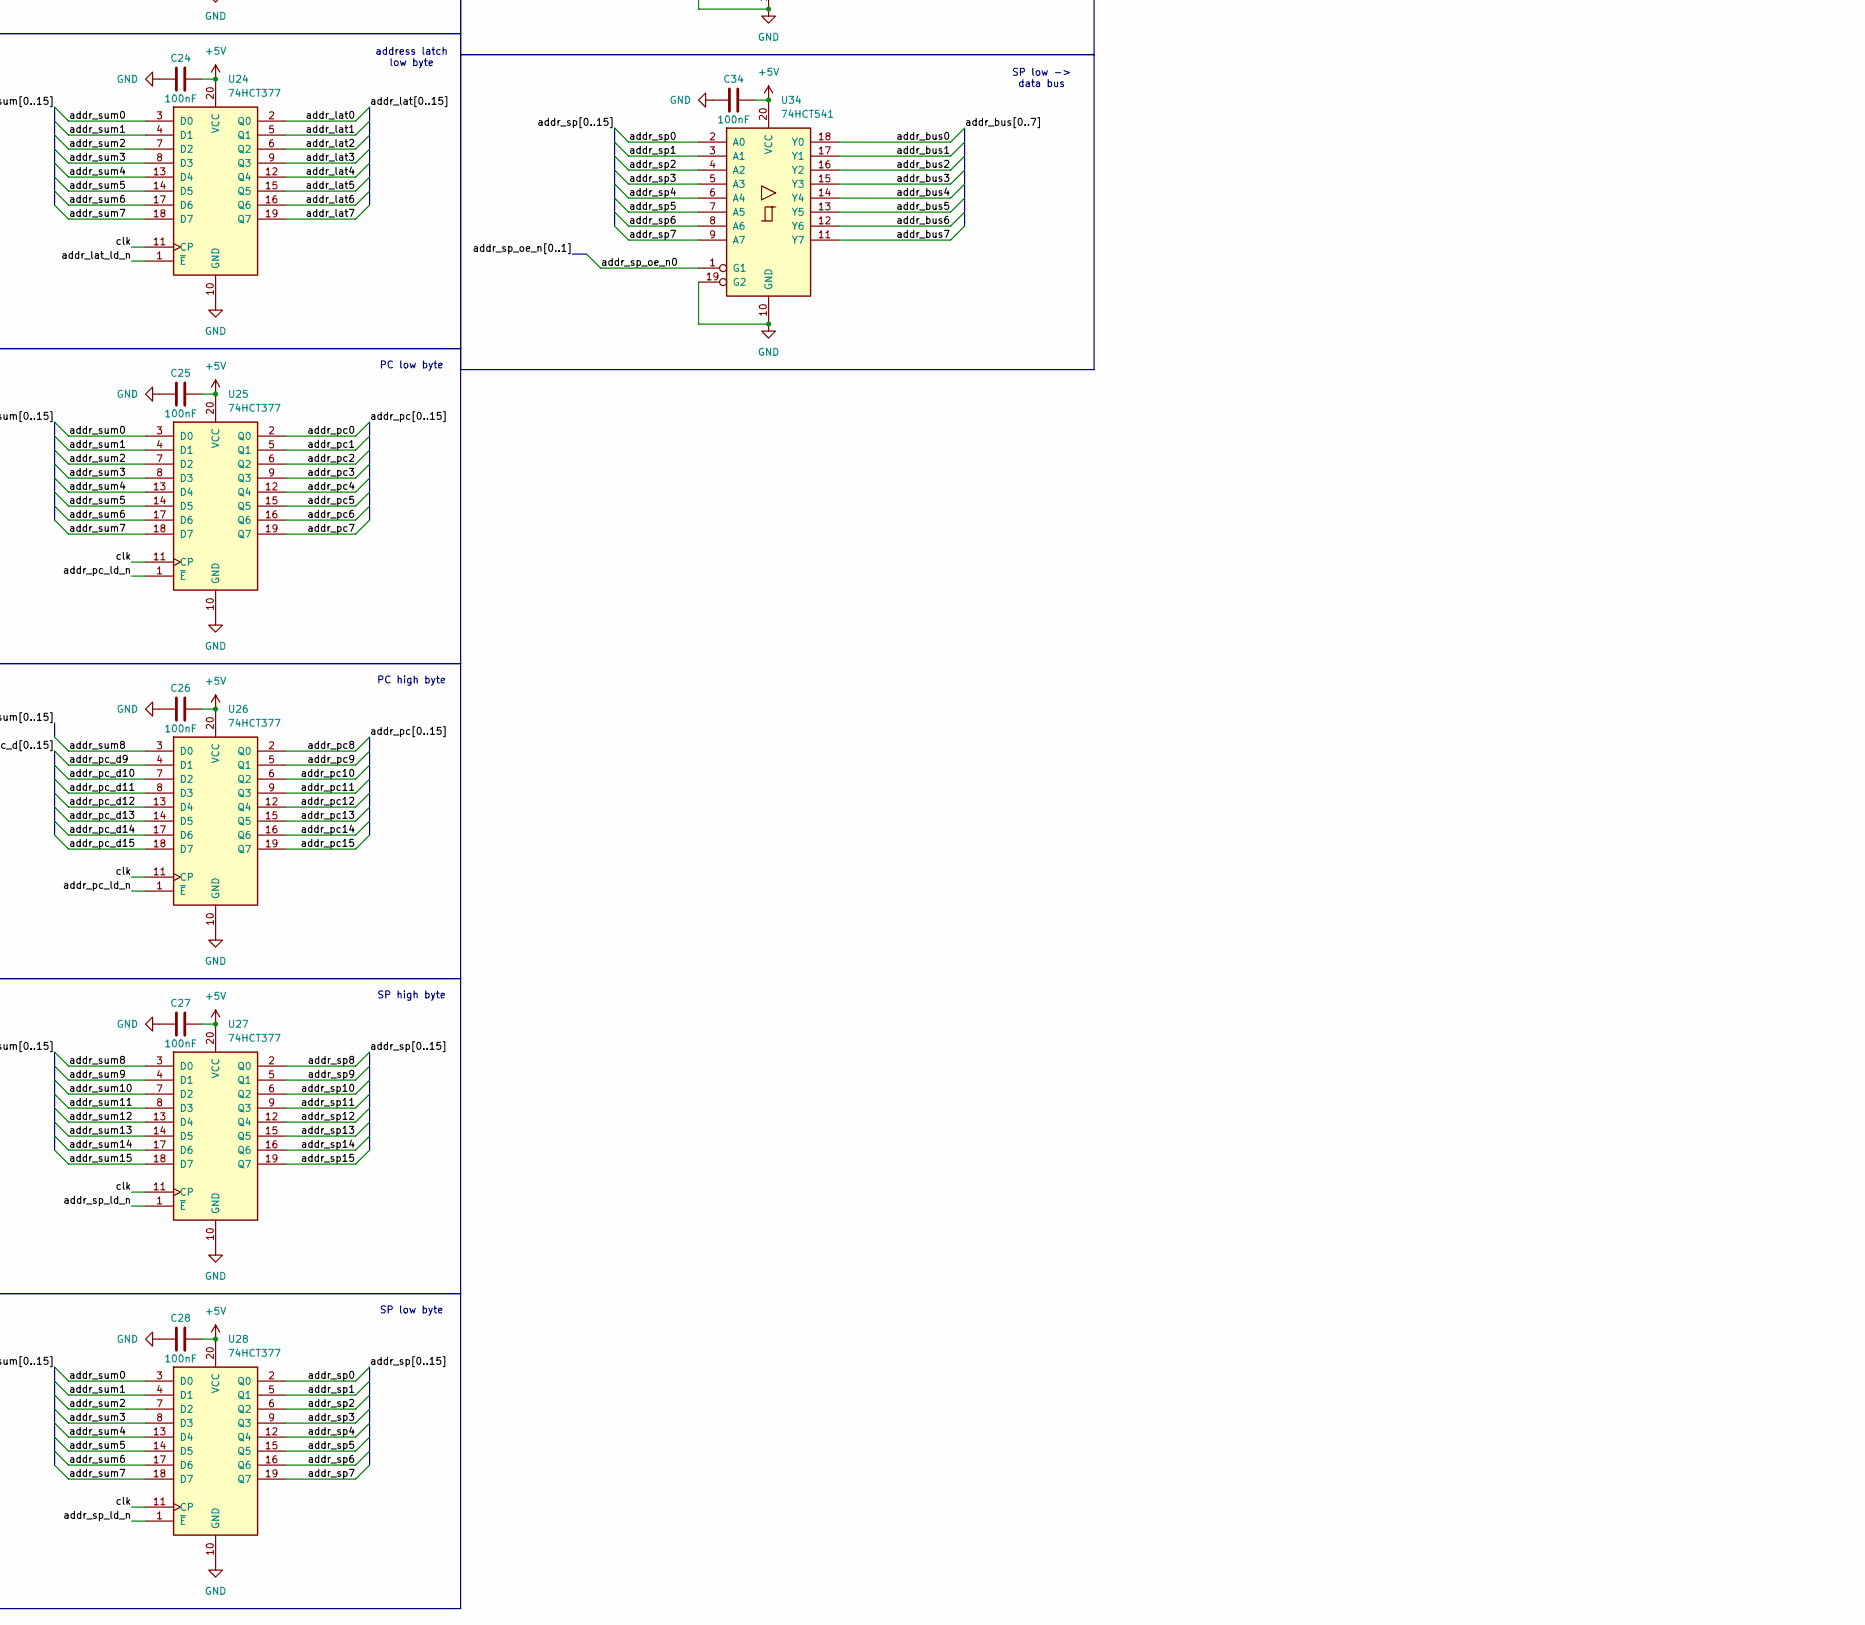
[picture p19: schematic hbc2_addr.kicad_sch, part in row 2, column 2]

Parts:
C1, C2, C3, C4, C5, C6, C7, C8, C9, C10, C11, C12, C13, C14, C15, C16, C17, C18, C19, C20, C21, C22, C23, C24, C25, C26, C27, C28, C29, C30, C31, C32, C33, C34, C36: 100nF
C35: 47µF 16V
J1, J5, J6, J7, J8, J9, J10: Conn_01x08_Socket
J2: Conn_01x09_Socket
J3: Conn_01x12_Socket
J4: Conn_01x04_Socket
U1, U2, U3, U4, U9, U10, U11, U12: 74HCT153
U5, U6, U7, U8: 74HCT157
U13, U14: 74HCT08
U15, U16, U17, U18: 74HCT86
U19, U20, U21, U22: 74HCT283
U23, U24, U25, U26, U27, U28: 74HCT377
U29, U30, U31, U32, U33, U34: 74HCT541

Connections:
+5V: C1.2, C2.2, C3.2, C4.2, C5.2, C6.2, C7.2, C8.2, C9.2, C10.2, C11.2, C12.2, C13.1, C14.1, C15.1, C16.1, C17.1, C18.1, C19.2, C20.2, C21.2, C22.2, C23.2, C24.2, C25.2, C26.2, C27.2, C28.2, C29.2, C30.2, C31.2, C32.2, C33.2, C34.2, C35.1, C36.2, J4.2, J4.3, U1.16 (VCC), U2.16 (VCC), U3.16 (VCC), U4.16 (VCC), U5.16 (VCC), U6.16 (VCC), U7.16 (VCC), U8.16 (VCC), U9.13 (I3b), U9.16 (VCC), U10.3 (I3a), U10.13 (I3b), U10.16 (VCC), U11.3 (I3a), U11.13 (I3b), U11.16 (VCC), U12.3 (I3a), U12.13 (I3b), U12.16 (VCC), U13.14 (VCC), U14.14 (VCC), U15.14 (VCC), U16.14 (VCC), U17.14 (VCC), U18.14 (VCC), U19.16 (VCC), U20.16 (VCC), U21.16 (VCC), U22.16 (VCC), U23.20 (VCC), U24.20 (VCC), U25.20 (VCC), U26.20 (VCC), U27.20 (VCC), U28.20 (VCC), U29.20 (VCC), U30.20 (VCC), U31.20 (VCC), U32.20 (VCC), U33.20 (VCC), U34.20 (VCC)
GND: C1.1, C2.1, C3.1, C4.1, C5.1, C6.1, C7.1, C8.1, C9.1, C10.1, C11.1, C12.1, C13.2, C14.2, C15.2, C16.2, C17.2, C18.2, C19.1, C20.1, C21.1, C22.1, C23.1, C24.1, C25.1, C26.1, C27.1, C28.1, C29.1, C30.1, C31.1, C32.1, C33.1, C34.1, C35.2, C36.1, J4.1, J4.4, U1.3 (I3a), U1.8 (GND), U2.8 (GND), U3.8 (GND), U4.8 (GND), U5.8 (GND), U6.8 (GND), U7.1 (S), U7.3 (I1a), U7.6 (I1b), U7.8 (GND), U7.10 (I1c), U7.13 (I1d), U8.1 (S), U8.3 (I1a), U8.6 (I1b), U8.8 (GND), U8.10 (I1c), U8.13 (I1d), U9.8 (GND), U10.8 (GND), U11.8 (GND), U12.8 (GND), U13.7 (GND), U14.7 (GND), U15.7 (GND), U16.7 (GND), U17.7 (GND), U18.7 (GND), U19.8 (GND), U20.8 (GND), U21.8 (GND), U22.8 (GND), U23.10 (GND), U24.10 (GND), U25.10 (GND), U26.10 (GND), U27.10 (GND), U28.10 (GND), U29.10 (GND), U29.19 (G2), U30.10 (GND), U30.19 (G2), U31.10 (GND), U31.19 (G2), U32.10 (GND), U32.19 (G2), U33.10 (GND), U33.19 (G2), U34.10 (GND), U34.19 (G2)
addr_base0: U1.7 (Za), U19.5 (A1)
addr_base1: U1.9 (Zb), U19.3 (A2)
addr_base2: U2.7 (Za), U19.14 (A3)
addr_base3: U2.9 (Zb), U19.12 (A4)
addr_base4: U3.7 (Za), U20.5 (A1)
addr_base5: U3.9 (Zb), U20.3 (A2)
addr_base6: U4.7 (Za), U20.14 (A3)
addr_base7: U4.9 (Zb), U20.12 (A4)
addr_base8: U9.7 (Za), U21.5 (A1)
addr_base9: U9.9 (Zb), U21.3 (A2)
addr_base10: U10.7 (Za), U21.14 (A3)
addr_base11: U10.9 (Zb), U21.12 (A4)
addr_base12: U11.7 (Za), U22.5 (A1)
addr_base13: U11.9 (Zb), U22.3 (A2)
addr_base14: U12.7 (Za), U22.14 (A3)
addr_base15: U12.9 (Zb), U22.12 (A4)
addr_base_oe_n0: J3.3, U1.1 (Ea), U1.15 (Eb), U2.1 (Ea), U2.15 (Eb), U3.1 (Ea), U3.15 (Eb), U4.1 (Ea), U4.15 (Eb)
addr_base_oe_n1: J3.4, U9.1 (Ea), U9.15 (Eb), U10.1 (Ea), U10.15 (Eb), U11.1 (Ea), U11.15 (Eb), U12.1 (Ea), U12.15 (Eb)
addr_base_sel0: J3.1, U1.14 (S0), U2.14 (S0), U3.14 (S0), U4.14 (S0), U9.14 (S0), U10.14 (S0), U11.14 (S0), U12.14 (S0)
addr_base_sel1: J3.2, U1.2 (S1), U2.2 (S1), U3.2 (S1), U4.2 (S1), U9.2 (S1), U10.2 (S1), U11.2 (S1), U12.2 (S1)
addr_bus0: J1.8, U31.18 (Y0), U32.18 (Y0), U33.18 (Y0), U34.18 (Y0)
addr_bus1: J1.7, U31.17 (Y1), U32.17 (Y1), U33.17 (Y1), U34.17 (Y1)
addr_bus2: J1.6, U31.16 (Y2), U32.16 (Y2), U33.16 (Y2), U34.16 (Y2)
addr_bus3: J1.5, U31.15 (Y3), U32.15 (Y3), U33.15 (Y3), U34.15 (Y3)
addr_bus4: J1.4, U31.14 (Y4), U32.14 (Y4), U33.14 (Y4), U34.14 (Y4)
addr_bus5: J1.3, U31.13 (Y5), U32.13 (Y5), U33.13 (Y5), U34.13 (Y5)
addr_bus6: J1.2, U31.12 (Y6), U32.12 (Y6), U33.12 (Y6), U34.12 (Y6)
addr_bus7: J1.1, U31.11 (Y7), U32.11 (Y7), U33.11 (Y7), U34.11 (Y7)
addr_bus_a0: J5.8, U9.4 (I2a)
addr_bus_a1: J5.7, U9.12 (I2b)
addr_bus_a2: J5.6, U10.4 (I2a)
addr_bus_a3: J5.5, U10.12 (I2b)
addr_bus_a4: J5.4, U11.4 (I2a)
addr_bus_a5: J5.3, U11.12 (I2b)
addr_bus_a6: J5.2, U12.4 (I2a)
addr_bus_a7: J5.1, U12.12 (I2b)
addr_bus_addr_hi0: J10.8, U29.18 (Y0)
addr_bus_addr_hi1: J10.7, U29.17 (Y1)
addr_bus_addr_hi2: J10.6, U29.16 (Y2)
addr_bus_addr_hi3: J10.5, U29.15 (Y3)
addr_bus_addr_hi4: J10.4, U29.14 (Y4)
addr_bus_addr_hi5: J10.3, U29.13 (Y5)
addr_bus_addr_hi6: J10.2, U29.12 (Y6)
addr_bus_addr_hi7: J10.1, U29.11 (Y7)
addr_bus_addr_lo0: J9.8, U1.13 (I3b), U30.18 (Y0)
addr_bus_addr_lo1: J9.7, U2.3 (I3a), U30.17 (Y1)
addr_bus_addr_lo2: J9.6, U2.13 (I3b), U30.16 (Y2)
addr_bus_addr_lo3: J9.5, U3.3 (I3a), U30.15 (Y3)
addr_bus_addr_lo4: J9.4, U3.13 (I3b), U30.14 (Y4)
addr_bus_addr_lo5: J9.3, U4.3 (I3a), U30.13 (Y5)
addr_bus_addr_lo6: J9.2, U4.13 (I3b), U30.12 (Y6)
addr_bus_addr_lo7: J9.1, U14.12, U30.11 (Y7)
addr_bus_b0: J6.8, U1.4 (I2a)
addr_bus_b1: J6.7, U1.12 (I2b)
addr_bus_b2: J6.6, U2.4 (I2a)
addr_bus_b3: J6.5, U2.12 (I2b)
addr_bus_b4: J6.4, U3.4 (I2a)
addr_bus_b5: J6.3, U3.12 (I2b)
addr_bus_b6: J6.2, U4.4 (I2a)
addr_bus_b7: J6.1, U4.12 (I2b)
addr_bus_v1_0: J7.8, U5.3 (I1a), U7.2 (I0a)
addr_bus_v1_1: J7.7, U5.6 (I1b), U7.5 (I0b)
addr_bus_v1_2: J7.6, U5.10 (I1c), U7.11 (I0c)
addr_bus_v1_3: J7.5, U5.13 (I1d), U7.14 (I0d)
addr_bus_v1_4: J7.4, U6.3 (I1a), U8.2 (I0a)
addr_bus_v1_5: J7.3, U6.6 (I1b), U8.5 (I0b)
addr_bus_v1_6: J7.2, U6.10 (I1c), U8.11 (I0c)
addr_bus_v1_7: J7.1, U6.13 (I1d), U8.14 (I0d)
addr_bus_v2_0: J8.8, U5.2 (I0a)
addr_bus_v2_1: J8.7, U5.5 (I0b)
addr_bus_v2_2: J8.6, U5.11 (I0c)
addr_bus_v2_3: J8.5, U5.14 (I0d)
addr_bus_v2_4: J8.4, U6.2 (I0a)
addr_bus_v2_5: J8.3, U6.5 (I0b)
addr_bus_v2_6: J8.2, U6.11 (I0c)
addr_bus_v2_7: J8.1, U6.14 (I0d)
addr_c4_0: U19.9 (C4), U20.7 (C0)
addr_c4_1: U20.9 (C4), U21.7 (C0)
addr_c4_2: U21.9 (C4), U22.7 (C0)
addr_cin: J2.5, U19.7 (C0)
addr_cout: J2.9, U22.9 (C4)
addr_inv: J2.4, U15.2, U15.5, U15.10, U15.13, U16.2, U16.5, U16.10, U16.13, U17.2, U17.5, U17.10, U17.13, U18.2, U18.5, U18.10, U18.13
addr_ivt8: U9.3 (I3a), U14.11
addr_lat0: U24.2 (Q0), U30.2 (A0)
addr_lat1: U24.5 (Q1), U30.3 (A1)
addr_lat2: U24.6 (Q2), U30.4 (A2)
addr_lat3: U24.9 (Q3), U30.5 (A3)
addr_lat4: U24.12 (Q4), U30.6 (A4)
addr_lat5: U24.15 (Q5), U30.7 (A5)
addr_lat6: U24.16 (Q6), U30.8 (A6)
addr_lat7: U24.19 (Q7), U30.9 (A7)
addr_lat8: U23.2 (Q0), U29.2 (A0)
addr_lat9: U23.5 (Q1), U29.3 (A1)
addr_lat10: U23.6 (Q2), U29.4 (A2)
addr_lat11: U23.9 (Q3), U29.5 (A3)
addr_lat12: U23.12 (Q4), U29.6 (A4)
addr_lat13: U23.15 (Q5), U29.7 (A5)
addr_lat14: U23.16 (Q6), U29.8 (A6)
addr_lat15: U23.19 (Q7), U29.9 (A7)
addr_lat_ld_n: J2.6, U23.1 (~E), U24.1 (~E)
addr_lat_oe_n0: J3.7, U30.1 (G1)
addr_lat_oe_n1: J3.8, U29.1 (G1)
addr_off0: U5.4 (Za), U15.1
addr_off1: U5.7 (Zb), U15.4
addr_off2: U5.9 (Zc), U15.9
addr_off3: U5.12 (Zd), U15.12
addr_off4: U6.4 (Za), U16.1
addr_off5: U6.7 (Zb), U16.4
addr_off6: U6.9 (Zc), U16.9
addr_off7: U6.12 (Zd), U16.12
addr_off8: U7.4 (Za), U17.1
addr_off9: U7.7 (Zb), U17.4
addr_off10: U7.9 (Zc), U17.9
addr_off11: U7.12 (Zd), U17.12
addr_off12: U8.4 (Za), U18.1
addr_off13: U8.7 (Zb), U18.4
addr_off14: U8.9 (Zc), U18.9
addr_off15: U8.12 (Zd), U18.12
addr_off_oe_n0: J3.5, U5.15 (E), U6.15 (E)
addr_off_oe_n1: J3.6, U7.15 (E), U8.15 (E)
addr_off_sel: J2.3, U5.1 (S), U6.1 (S)
addr_offx0: U15.3, U19.6 (B1)
addr_offx1: U15.6, U19.2 (B2)
addr_offx2: U15.8, U19.15 (B3)
addr_offx3: U15.11, U19.11 (B4)
addr_offx4: U16.3, U20.6 (B1)
addr_offx5: U16.6, U20.2 (B2)
addr_offx6: U16.8, U20.15 (B3)
addr_offx7: U16.11, U20.11 (B4)
addr_offx8: U17.3, U21.6 (B1)
addr_offx9: U17.6, U21.2 (B2)
addr_offx10: U17.8, U21.15 (B3)
addr_offx11: U17.11, U21.11 (B4)
addr_offx12: U18.3, U22.6 (B1)
addr_offx13: U18.6, U22.2 (B2)
addr_offx14: U18.8, U22.15 (B3)
addr_offx15: U18.11, U22.11 (B4)
addr_pc0: U1.6 (I0a), U25.2 (Q0), U32.2 (A0)
addr_pc1: U1.10 (I0b), U25.5 (Q1), U32.3 (A1)
addr_pc2: U2.6 (I0a), U25.6 (Q2), U32.4 (A2)
addr_pc3: U2.10 (I0b), U25.9 (Q3), U32.5 (A3)
addr_pc4: U3.6 (I0a), U25.12 (Q4), U32.6 (A4)
addr_pc5: U3.10 (I0b), U25.15 (Q5), U32.7 (A5)
addr_pc6: U4.6 (I0a), U25.16 (Q6), U32.8 (A6)
addr_pc7: U4.10 (I0b), U25.19 (Q7), U32.9 (A7)
addr_pc8: U9.6 (I0a), U26.2 (Q0), U31.2 (A0)
addr_pc9: U9.10 (I0b), U26.5 (Q1), U31.3 (A1)
addr_pc10: U10.6 (I0a), U26.6 (Q2), U31.4 (A2)
addr_pc11: U10.10 (I0b), U26.9 (Q3), U31.5 (A3)
addr_pc12: U11.6 (I0a), U26.12 (Q4), U31.6 (A4)
addr_pc13: U11.10 (I0b), U26.15 (Q5), U31.7 (A5)
addr_pc14: U12.6 (I0a), U26.16 (Q6), U31.8 (A6)
addr_pc15: U12.10 (I0b), U26.19 (Q7), U31.9 (A7)
addr_pc_d9: U13.3, U26.4 (D1)
addr_pc_d10: U13.6, U26.7 (D2)
addr_pc_d11: U13.8, U26.8 (D3)
addr_pc_d12: U13.11, U26.13 (D4)
addr_pc_d13: U14.3, U26.14 (D5)
addr_pc_d14: U14.6, U26.17 (D6)
addr_pc_d15: U14.8, U26.18 (D7)
addr_pc_ld_n: J2.7, U25.1 (~E), U26.1 (~E)
addr_pc_oe_n0: J3.9, U32.1 (G1)
addr_pc_oe_n1: J3.10, U31.1 (G1)
addr_sp0: U1.5 (I1a), U28.2 (Q0), U34.2 (A0)
addr_sp1: U1.11 (I1b), U28.5 (Q1), U34.3 (A1)
addr_sp2: U2.5 (I1a), U28.6 (Q2), U34.4 (A2)
addr_sp3: U2.11 (I1b), U28.9 (Q3), U34.5 (A3)
addr_sp4: U3.5 (I1a), U28.12 (Q4), U34.6 (A4)
addr_sp5: U3.11 (I1b), U28.15 (Q5), U34.7 (A5)
addr_sp6: U4.5 (I1a), U28.16 (Q6), U34.8 (A6)
addr_sp7: U4.11 (I1b), U28.19 (Q7), U34.9 (A7)
addr_sp8: U9.5 (I1a), U27.2 (Q0), U33.2 (A0)
addr_sp9: U9.11 (I1b), U27.5 (Q1), U33.3 (A1)
addr_sp10: U10.5 (I1a), U27.6 (Q2), U33.4 (A2)
addr_sp11: U10.11 (I1b), U27.9 (Q3), U33.5 (A3)
addr_sp12: U11.5 (I1a), U27.12 (Q4), U33.6 (A4)
addr_sp13: U11.11 (I1b), U27.15 (Q5), U33.7 (A5)
addr_sp14: U12.5 (I1a), U27.16 (Q6), U33.8 (A6)
addr_sp15: U12.11 (I1b), U27.19 (Q7), U33.9 (A7)
addr_sp_ld_n: J2.8, U27.1 (~E), U28.1 (~E)
addr_sp_oe_n0: J3.11, U34.1 (G1)
addr_sp_oe_n1: J3.12, U33.1 (G1)
addr_sum0: U19.4 (S1), U24.3 (D0), U25.3 (D0), U28.3 (D0)
addr_sum1: U19.1 (S2), U24.4 (D1), U25.4 (D1), U28.4 (D1)
addr_sum2: U19.13 (S3), U24.7 (D2), U25.7 (D2), U28.7 (D2)
addr_sum3: U19.10 (S4), U24.8 (D3), U25.8 (D3), U28.8 (D3)
addr_sum4: U20.4 (S1), U24.13 (D4), U25.13 (D4), U28.13 (D4)
addr_sum5: U20.1 (S2), U24.14 (D5), U25.14 (D5), U28.14 (D5)
addr_sum6: U20.13 (S3), U24.17 (D6), U25.17 (D6), U28.17 (D6)
addr_sum7: U20.10 (S4), U24.18 (D7), U25.18 (D7), U28.18 (D7)
addr_sum8: U21.4 (S1), U23.3 (D0), U26.3 (D0), U27.3 (D0)
addr_sum9: U13.1, U21.1 (S2), U23.4 (D1), U27.4 (D1)
addr_sum10: U13.4, U21.13 (S3), U23.7 (D2), U27.7 (D2)
addr_sum11: U13.9, U21.10 (S4), U23.8 (D3), U27.8 (D3)
addr_sum12: U13.12, U22.4 (S1), U23.13 (D4), U27.13 (D4)
addr_sum13: U14.1, U22.1 (S2), U23.14 (D5), U27.14 (D5)
addr_sum14: U14.4, U22.13 (S3), U23.17 (D6), U27.17 (D6)
addr_sum15: U14.9, U22.10 (S4), U23.18 (D7), U27.18 (D7)
clk: J2.1, U23.11 (CP), U24.11 (CP), U25.11 (CP), U26.11 (CP), U27.11 (CP), U28.11 (CP)
rst_n: J2.2, U13.2, U13.5, U13.10, U13.13, U14.2, U14.5, U14.10, U14.13

Notes on the sheet:
OFFSET xor inv, bits 11..8
OFFSET xor inv, bits 3..0
reset: PC bits 11..19 IVT p7
BASE bits 5..4
connectors
adder bits 15..12
PC high byte
SP low -> data bus
OFFSET xor inv, bits 7..4
OFFSET bits 3..0: V2 / V1
OFFSET bits 7..4: V2 / V1
SP high byte
address latch high byte
OFFSET bits 11..8: V1
BASE bits 9..8
adder bits 11..8
PC low -> data bus
latch high -> address bus
PC high -> data bus
OFFSET xor inv, bits 15..12
BASE bits 7..6
address latch low byte
BASE bits 3..2
PC low byte
SP high -> data bus
reset: PC bits 15..12
adder bits 7..4
adder bits 3..0
BASE bits 15..14
SP low byte
latch low -> address bus
BASE bits 11..10
BASE bits 13..12
BASE bits 1..0
OFFSET bits 15..12: V1
