SteriCraft/hbc2-ide/kicad/alu/hbc2_alu.kicad_sch

## KiCad design kicad/alu/hbc2_alu.kicad_sch (2026-11-14)

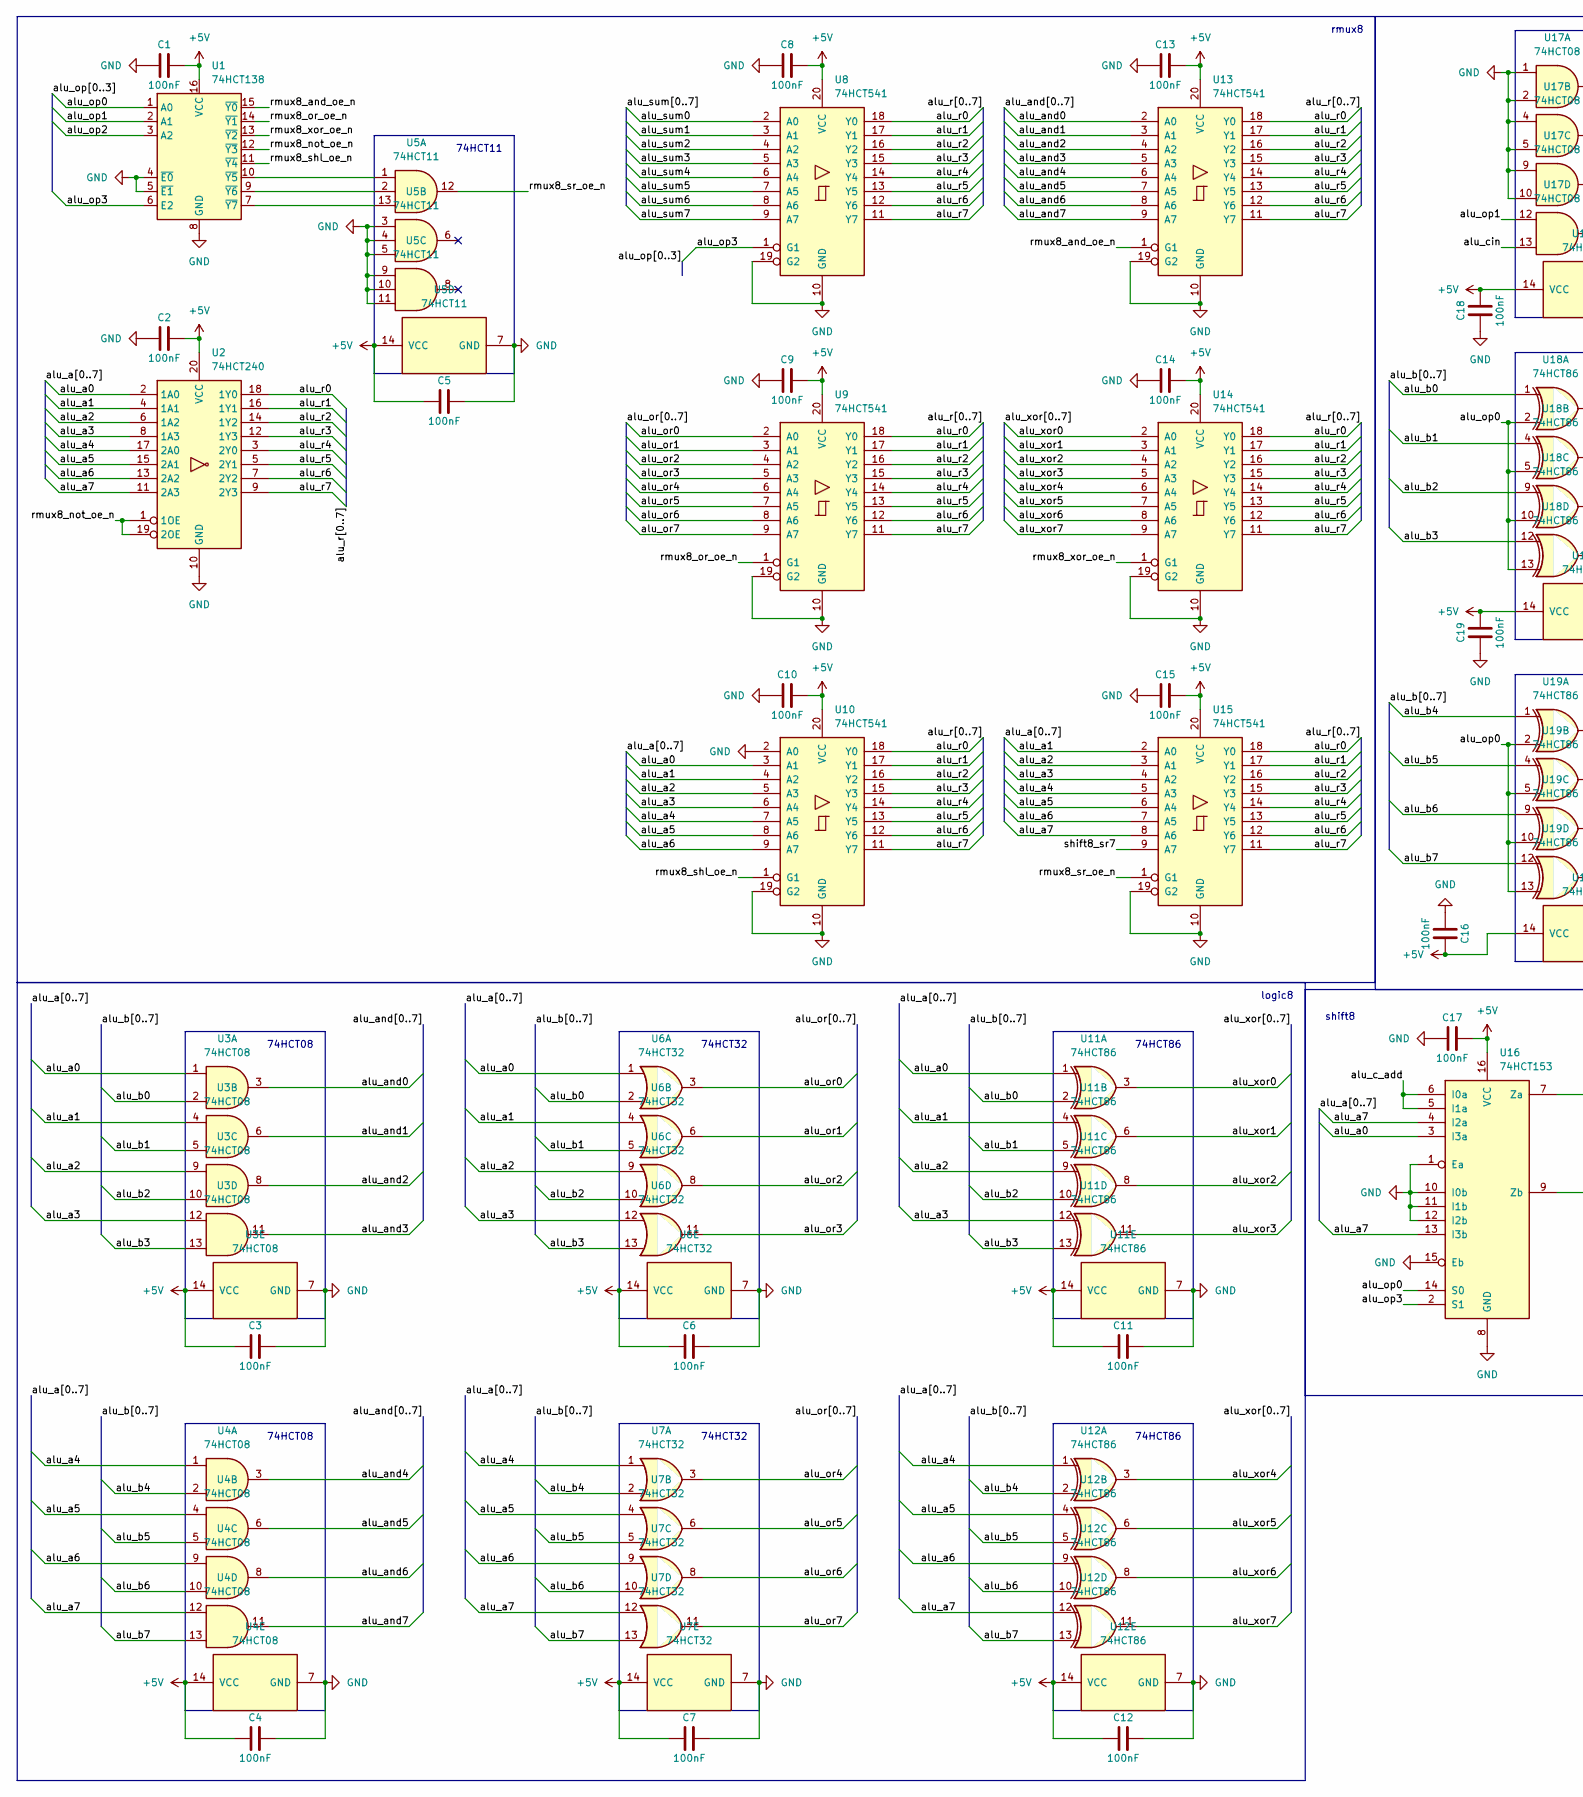
[picture p20: schematic hbc2_alu.kicad_sch, part in row 1, column 1]

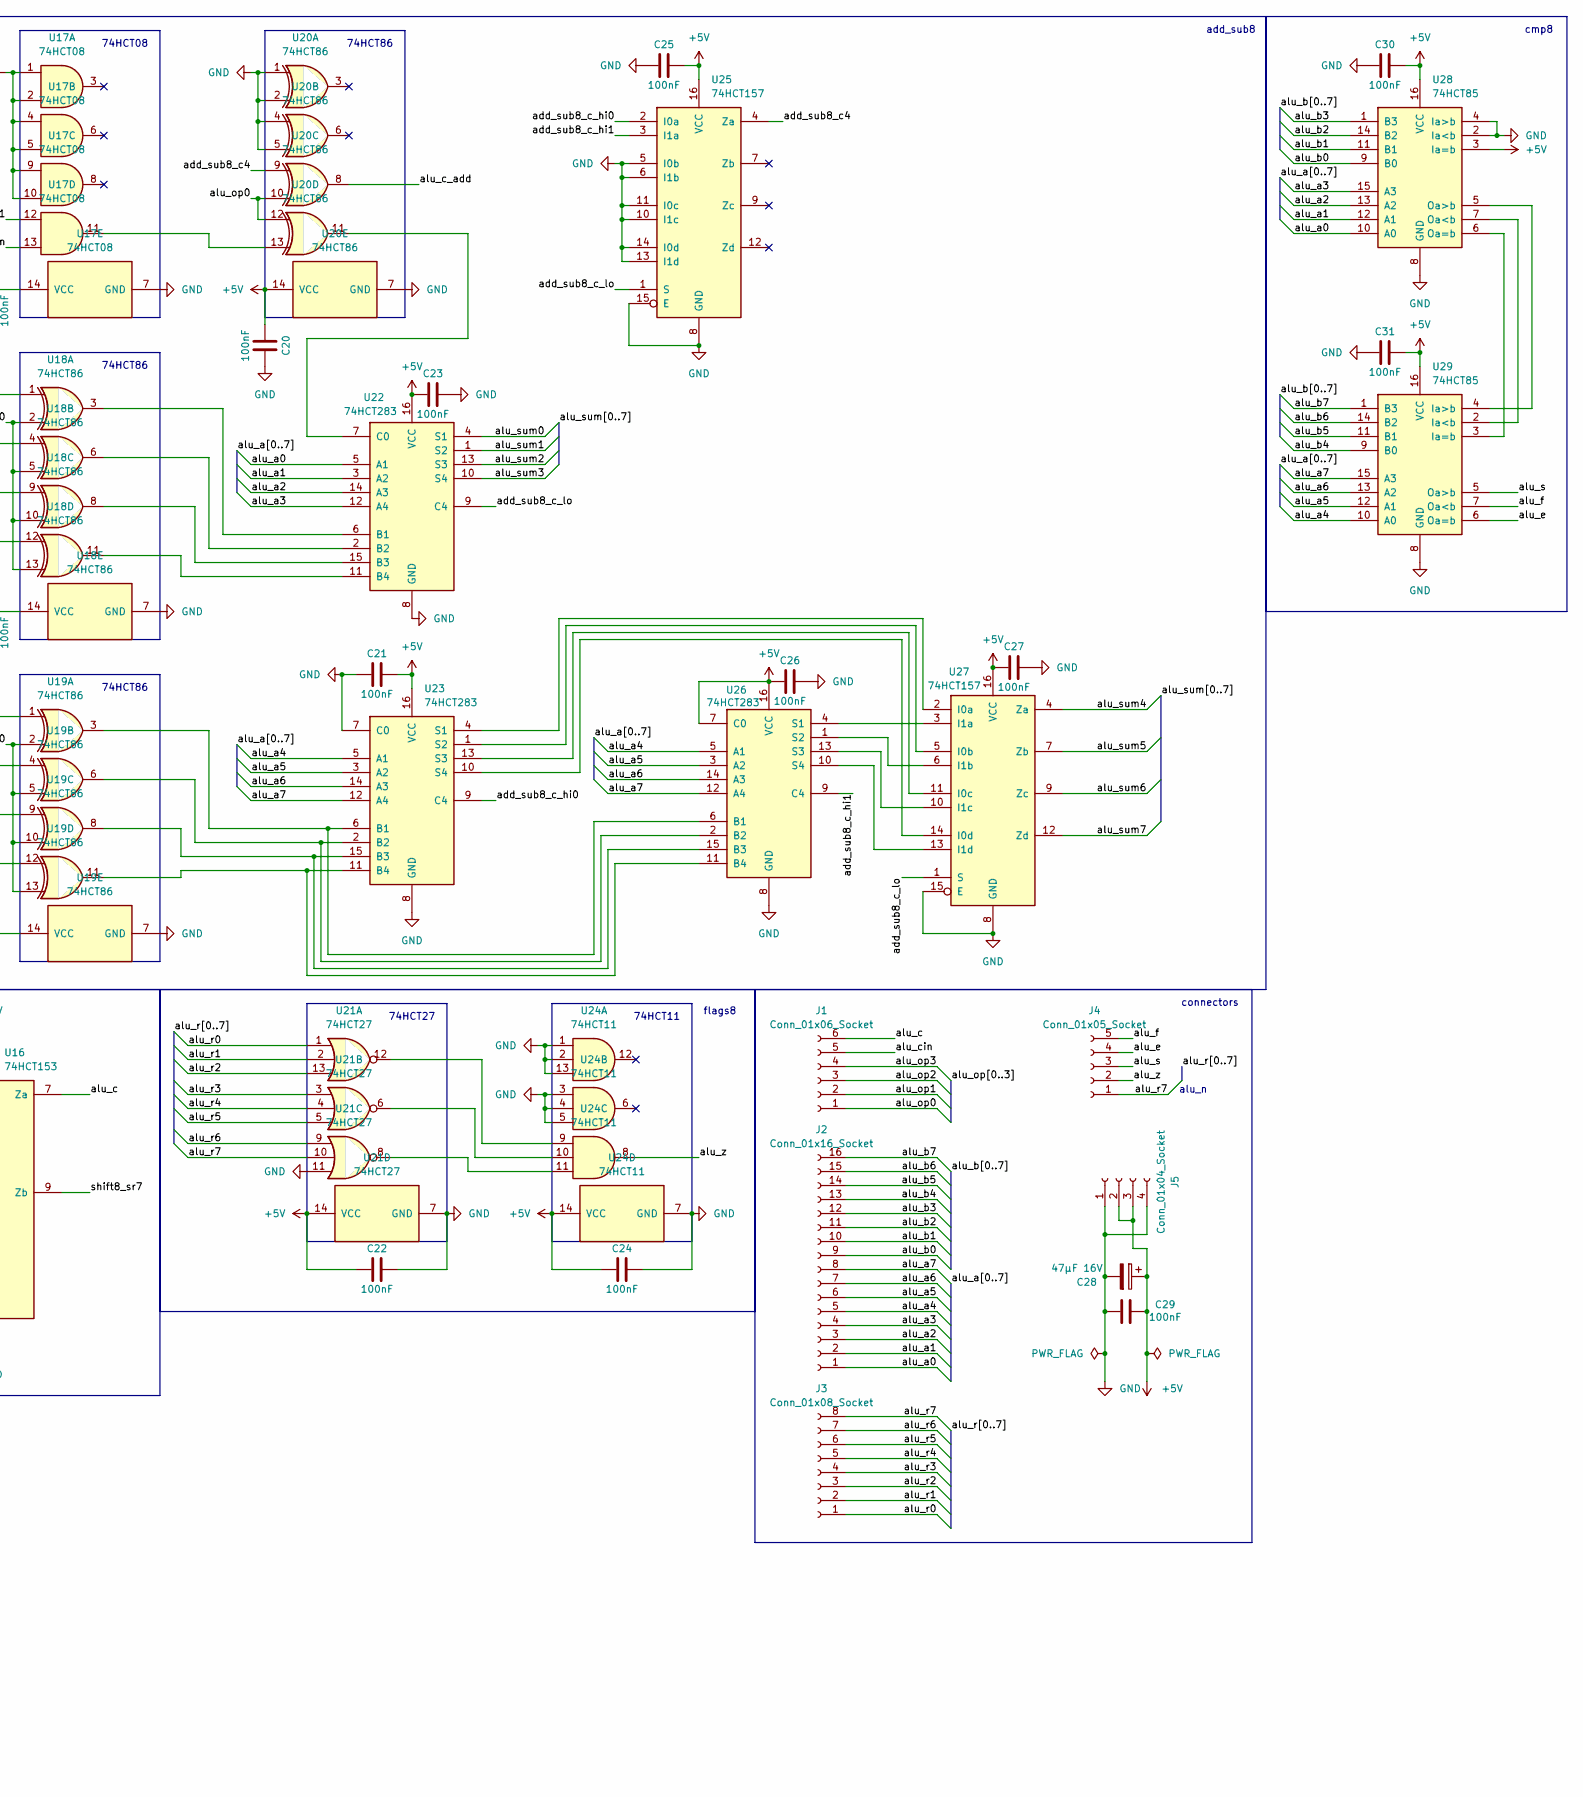
[picture p21: schematic hbc2_alu.kicad_sch, part in row 1, column 2]

Parts:
C1, C2, C3, C4, C5, C6, C7, C8, C9, C10, C11, C12, C13, C14, C15, C16, C17, C18, C19, C20, C21, C22, C23, C24, C25, C26, C27, C29, C30, C31: 100nF
C28: 47µF 16V
J1: Conn_01x06_Socket
J2: Conn_01x16_Socket
J3: Conn_01x08_Socket
J4: Conn_01x05_Socket
J5: Conn_01x04_Socket
U1: 74HCT138
U2: 74HCT240
U3, U4, U17: 74HCT08
U5, U24: 74HCT11
U6, U7: 74HCT32
U8, U9, U10, U13, U14, U15: 74HCT541
U11, U12, U18, U19, U20: 74HCT86
U16: 74HCT153
U21: 74HCT27
U22, U23, U26: 74HCT283
U25, U27: 74HCT157
U28, U29: 74HCT85

Connections:
+5V: C1.2, C2.2, C3.1, C4.1, C5.1, C6.1, C7.1, C8.2, C9.2, C10.2, C11.1, C12.1, C13.2, C14.2, C15.2, C16.1, C17.2, C18.1, C19.1, C20.1, C21.2, C22.1, C23.1, C24.1, C25.2, C26.1, C27.1, C28.1, C29.2, C30.2, C31.2, J5.2, J5.3, U1.16 (VCC), U2.20 (VCC), U3.14 (VCC), U4.14 (VCC), U5.14 (VCC), U6.14 (VCC), U7.14 (VCC), U8.20 (VCC), U9.20 (VCC), U10.20 (VCC), U11.14 (VCC), U12.14 (VCC), U13.20 (VCC), U14.20 (VCC), U15.20 (VCC), U16.16 (VCC), U17.14 (VCC), U18.14 (VCC), U19.14 (VCC), U20.14 (VCC), U21.14 (VCC), U22.16 (VCC), U23.16 (VCC), U24.14 (VCC), U25.16 (VCC), U26.7 (C0), U26.16 (VCC), U27.16 (VCC), U28.3 (Ia=b), U28.16 (VCC), U29.16 (VCC)
GND: C1.1, C2.1, C3.2, C4.2, C5.2, C6.2, C7.2, C8.1, C9.1, C10.1, C11.2, C12.2, C13.1, C14.1, C15.1, C16.2, C17.1, C18.2, C19.2, C20.2, C21.1, C22.2, C23.2, C24.2, C25.1, C26.2, C27.2, C28.2, C29.1, C30.1, C31.1, J5.1, J5.4, U1.4 (~E0), U1.5 (~E1), U1.8 (GND), U2.10 (GND), U3.7 (GND), U4.7 (GND), U5.3, U5.4, U5.5, U5.7 (GND), U5.9, U5.10, U5.11, U6.7 (GND), U7.7 (GND), U8.10 (GND), U8.19 (G2), U9.10 (GND), U9.19 (G2), U10.2 (A0), U10.10 (GND), U10.19 (G2), U11.7 (GND), U12.7 (GND), U13.10 (GND), U13.19 (G2), U14.10 (GND), U14.19 (G2), U15.10 (GND), U15.19 (G2), U16.1 (Ea), U16.8 (GND), U16.10 (I0b), U16.11 (I1b), U16.12 (I2b), U16.15 (Eb), U17.1, U17.2, U17.4, U17.5, U17.7 (GND), U17.9, U17.10, U18.7 (GND), U19.7 (GND), U20.1, U20.2, U20.4, U20.5, U20.7 (GND), U21.7 (GND), U21.11, U22.8 (GND), U23.7 (C0), U23.8 (GND), U24.1, U24.2, U24.3, U24.4, U24.5, U24.7 (GND), U24.13, U25.5 (I0b), U25.6 (I1b), U25.8 (GND), U25.10 (I1c), U25.11 (I0c), U25.13 (I1d), U25.14 (I0d), U25.15 (E), U26.8 (GND), U27.8 (GND), U27.15 (E), U28.2 (Ia<b), U28.4 (Ia>b), U28.8 (GND), U29.8 (GND)
unnamed: U1.7 (~Y7), U5.13
unnamed: U1.9 (~Y6), U5.2
unnamed: U1.10 (~Y5), U5.1
unnamed: U17.11, U20.13
unnamed: U18.3, U22.6 (B1)
unnamed: U18.6, U22.2 (B2)
unnamed: U18.8, U22.15 (B3)
unnamed: U18.11, U22.11 (B4)
unnamed: U19.3, U23.6 (B1), U26.6 (B1)
unnamed: U19.6, U23.2 (B2), U26.2 (B2)
unnamed: U19.8, U23.15 (B3), U26.15 (B3)
unnamed: U19.11, U23.11 (B4), U26.11 (B4)
unnamed: U20.11, U22.7 (C0)
unnamed: U21.6, U24.10
unnamed: U21.8, U24.11
unnamed: U21.12, U24.9
unnamed: U23.1 (S2), U27.5 (I0b)
unnamed: U23.4 (S1), U27.2 (I0a)
unnamed: U23.10 (S4), U27.14 (I0d)
unnamed: U23.13 (S3), U27.11 (I0c)
unnamed: U26.1 (S2), U27.6 (I1b)
unnamed: U26.4 (S1), U27.3 (I1a)
unnamed: U26.10 (S4), U27.13 (I1d)
unnamed: U26.13 (S3), U27.10 (I1c)
unnamed: U28.5 (Oa>b), U29.4 (Ia>b)
unnamed: U28.6 (Oa=b), U29.3 (Ia=b)
unnamed: U28.7 (Oa<b), U29.2 (Ia<b)
add_sub8_c4: U20.9, U25.4 (Za)
add_sub8_c_hi0: U23.9 (C4), U25.2 (I0a)
add_sub8_c_hi1: U25.3 (I1a), U26.9 (C4)
add_sub8_c_lo: U22.9 (C4), U25.1 (S), U27.1 (S)
alu_a0: J2.1, U2.2 (1A0), U3.1, U6.1, U10.3 (A1), U11.1, U16.3 (I3a), U22.5 (A1), U28.10 (A0)
alu_a1: J2.2, U2.4 (1A1), U3.4, U6.4, U10.4 (A2), U11.4, U15.2 (A0), U22.3 (A2), U28.12 (A1)
alu_a2: J2.3, U2.6 (1A2), U3.9, U6.9, U10.5 (A3), U11.9, U15.3 (A1), U22.14 (A3), U28.13 (A2)
alu_a3: J2.4, U2.8 (1A3), U3.12, U6.12, U10.6 (A4), U11.12, U15.4 (A2), U22.12 (A4), U28.15 (A3)
alu_a4: J2.5, U2.17 (2A0), U4.1, U7.1, U10.7 (A5), U12.1, U15.5 (A3), U23.5 (A1), U26.5 (A1), U29.10 (A0)
alu_a5: J2.6, U2.15 (2A1), U4.4, U7.4, U10.8 (A6), U12.4, U15.6 (A4), U23.3 (A2), U26.3 (A2), U29.12 (A1)
alu_a6: J2.7, U2.13 (2A2), U4.9, U7.9, U10.9 (A7), U12.9, U15.7 (A5), U23.14 (A3), U26.14 (A3), U29.13 (A2)
alu_a7: J2.8, U2.11 (2A3), U4.12, U7.12, U12.12, U15.8 (A6), U16.4 (I2a), U16.13 (I3b), U23.12 (A4), U26.12 (A4), U29.15 (A3)
alu_and0: U3.3, U13.2 (A0)
alu_and1: U3.6, U13.3 (A1)
alu_and2: U3.8, U13.4 (A2)
alu_and3: U3.11, U13.5 (A3)
alu_and4: U4.3, U13.6 (A4)
alu_and5: U4.6, U13.7 (A5)
alu_and6: U4.8, U13.8 (A6)
alu_and7: U4.11, U13.9 (A7)
alu_b0: J2.9, U3.2, U6.2, U11.2, U18.1, U28.9 (B0)
alu_b1: J2.10, U3.5, U6.5, U11.5, U18.4, U28.11 (B1)
alu_b2: J2.11, U3.10, U6.10, U11.10, U18.9, U28.14 (B2)
alu_b3: J2.12, U3.13, U6.13, U11.13, U18.12, U28.1 (B3)
alu_b4: J2.13, U4.2, U7.2, U12.2, U19.1, U29.9 (B0)
alu_b5: J2.14, U4.5, U7.5, U12.5, U19.4, U29.11 (B1)
alu_b6: J2.15, U4.10, U7.10, U12.10, U19.9, U29.14 (B2)
alu_b7: J2.16, U4.13, U7.13, U12.13, U19.12, U29.1 (B3)
alu_c: J1.6, U16.7 (Za)
alu_c_add: U16.5 (I1a), U16.6 (I0a), U20.8
alu_cin: J1.5, U17.13
alu_e: J4.4, U29.6 (Oa=b)
alu_f: J4.5, U29.7 (Oa<b)
alu_op0: J1.1, U1.1 (A0), U16.14 (S0), U18.2, U18.5, U18.10, U18.13, U19.2, U19.5, U19.10, U19.13, U20.10, U20.12
alu_op1: J1.2, U1.2 (A1), U17.12
alu_op2: J1.3, U1.3 (A2)
alu_op3: J1.4, U1.6 (E2), U8.1 (G1), U16.2 (S1)
alu_or0: U6.3, U9.2 (A0)
alu_or1: U6.6, U9.3 (A1)
alu_or2: U6.8, U9.4 (A2)
alu_or3: U6.11, U9.5 (A3)
alu_or4: U7.3, U9.6 (A4)
alu_or5: U7.6, U9.7 (A5)
alu_or6: U7.8, U9.8 (A6)
alu_or7: U7.11, U9.9 (A7)
alu_r0: J3.1, U2.18 (1Y0), U8.18 (Y0), U9.18 (Y0), U10.18 (Y0), U13.18 (Y0), U14.18 (Y0), U15.18 (Y0), U21.1
alu_r1: J3.2, U2.16 (1Y1), U8.17 (Y1), U9.17 (Y1), U10.17 (Y1), U13.17 (Y1), U14.17 (Y1), U15.17 (Y1), U21.2
alu_r2: J3.3, U2.14 (1Y2), U8.16 (Y2), U9.16 (Y2), U10.16 (Y2), U13.16 (Y2), U14.16 (Y2), U15.16 (Y2), U21.13
alu_r3: J3.4, U2.12 (1Y3), U8.15 (Y3), U9.15 (Y3), U10.15 (Y3), U13.15 (Y3), U14.15 (Y3), U15.15 (Y3), U21.3
alu_r4: J3.5, U2.3 (2Y0), U8.14 (Y4), U9.14 (Y4), U10.14 (Y4), U13.14 (Y4), U14.14 (Y4), U15.14 (Y4), U21.4
alu_r5: J3.6, U2.5 (2Y1), U8.13 (Y5), U9.13 (Y5), U10.13 (Y5), U13.13 (Y5), U14.13 (Y5), U15.13 (Y5), U21.5
alu_r6: J3.7, U2.7 (2Y2), U8.12 (Y6), U9.12 (Y6), U10.12 (Y6), U13.12 (Y6), U14.12 (Y6), U15.12 (Y6), U21.9
alu_r7: J3.8, J4.1, U2.9 (2Y3), U8.11 (Y7), U9.11 (Y7), U10.11 (Y7), U13.11 (Y7), U14.11 (Y7), U15.11 (Y7), U21.10
alu_s: J4.3, U29.5 (Oa>b)
alu_sum0: U8.2 (A0), U22.4 (S1)
alu_sum1: U8.3 (A1), U22.1 (S2)
alu_sum2: U8.4 (A2), U22.13 (S3)
alu_sum3: U8.5 (A3), U22.10 (S4)
alu_sum4: U8.6 (A4), U27.4 (Za)
alu_sum5: U8.7 (A5), U27.7 (Zb)
alu_sum6: U8.8 (A6), U27.9 (Zc)
alu_sum7: U8.9 (A7), U27.12 (Zd)
alu_xor0: U11.3, U14.2 (A0)
alu_xor1: U11.6, U14.3 (A1)
alu_xor2: U11.8, U14.4 (A2)
alu_xor3: U11.11, U14.5 (A3)
alu_xor4: U12.3, U14.6 (A4)
alu_xor5: U12.6, U14.7 (A5)
alu_xor6: U12.8, U14.8 (A6)
alu_xor7: U12.11, U14.9 (A7)
alu_z: J4.2, U24.8
rmux8_and_oe_n: U1.15 (~Y0), U13.1 (G1)
rmux8_not_oe_n: U1.12 (~Y3), U2.1 (1OE), U2.19 (2OE)
rmux8_or_oe_n: U1.14 (~Y1), U9.1 (G1)
rmux8_shl_oe_n: U1.11 (~Y4), U10.1 (G1)
rmux8_sr_oe_n: U5.12, U15.1 (G1)
rmux8_xor_oe_n: U1.13 (~Y2), U14.1 (G1)
shift8_sr7: U15.9 (A7), U16.9 (Zb)

Notes on the sheet:
logic8
74HCT08
74HCT86
shift8
74HCT27
cmp8
connectors
74HCT11
74HCT32
add_sub8
flags8
alu_n
rmux8
