SteriCraft/hbc2-ide/kicad/flags/hbc2_flags.kicad_sch

## KiCad design kicad/flags/hbc2_flags.kicad_sch (2026-11-14)

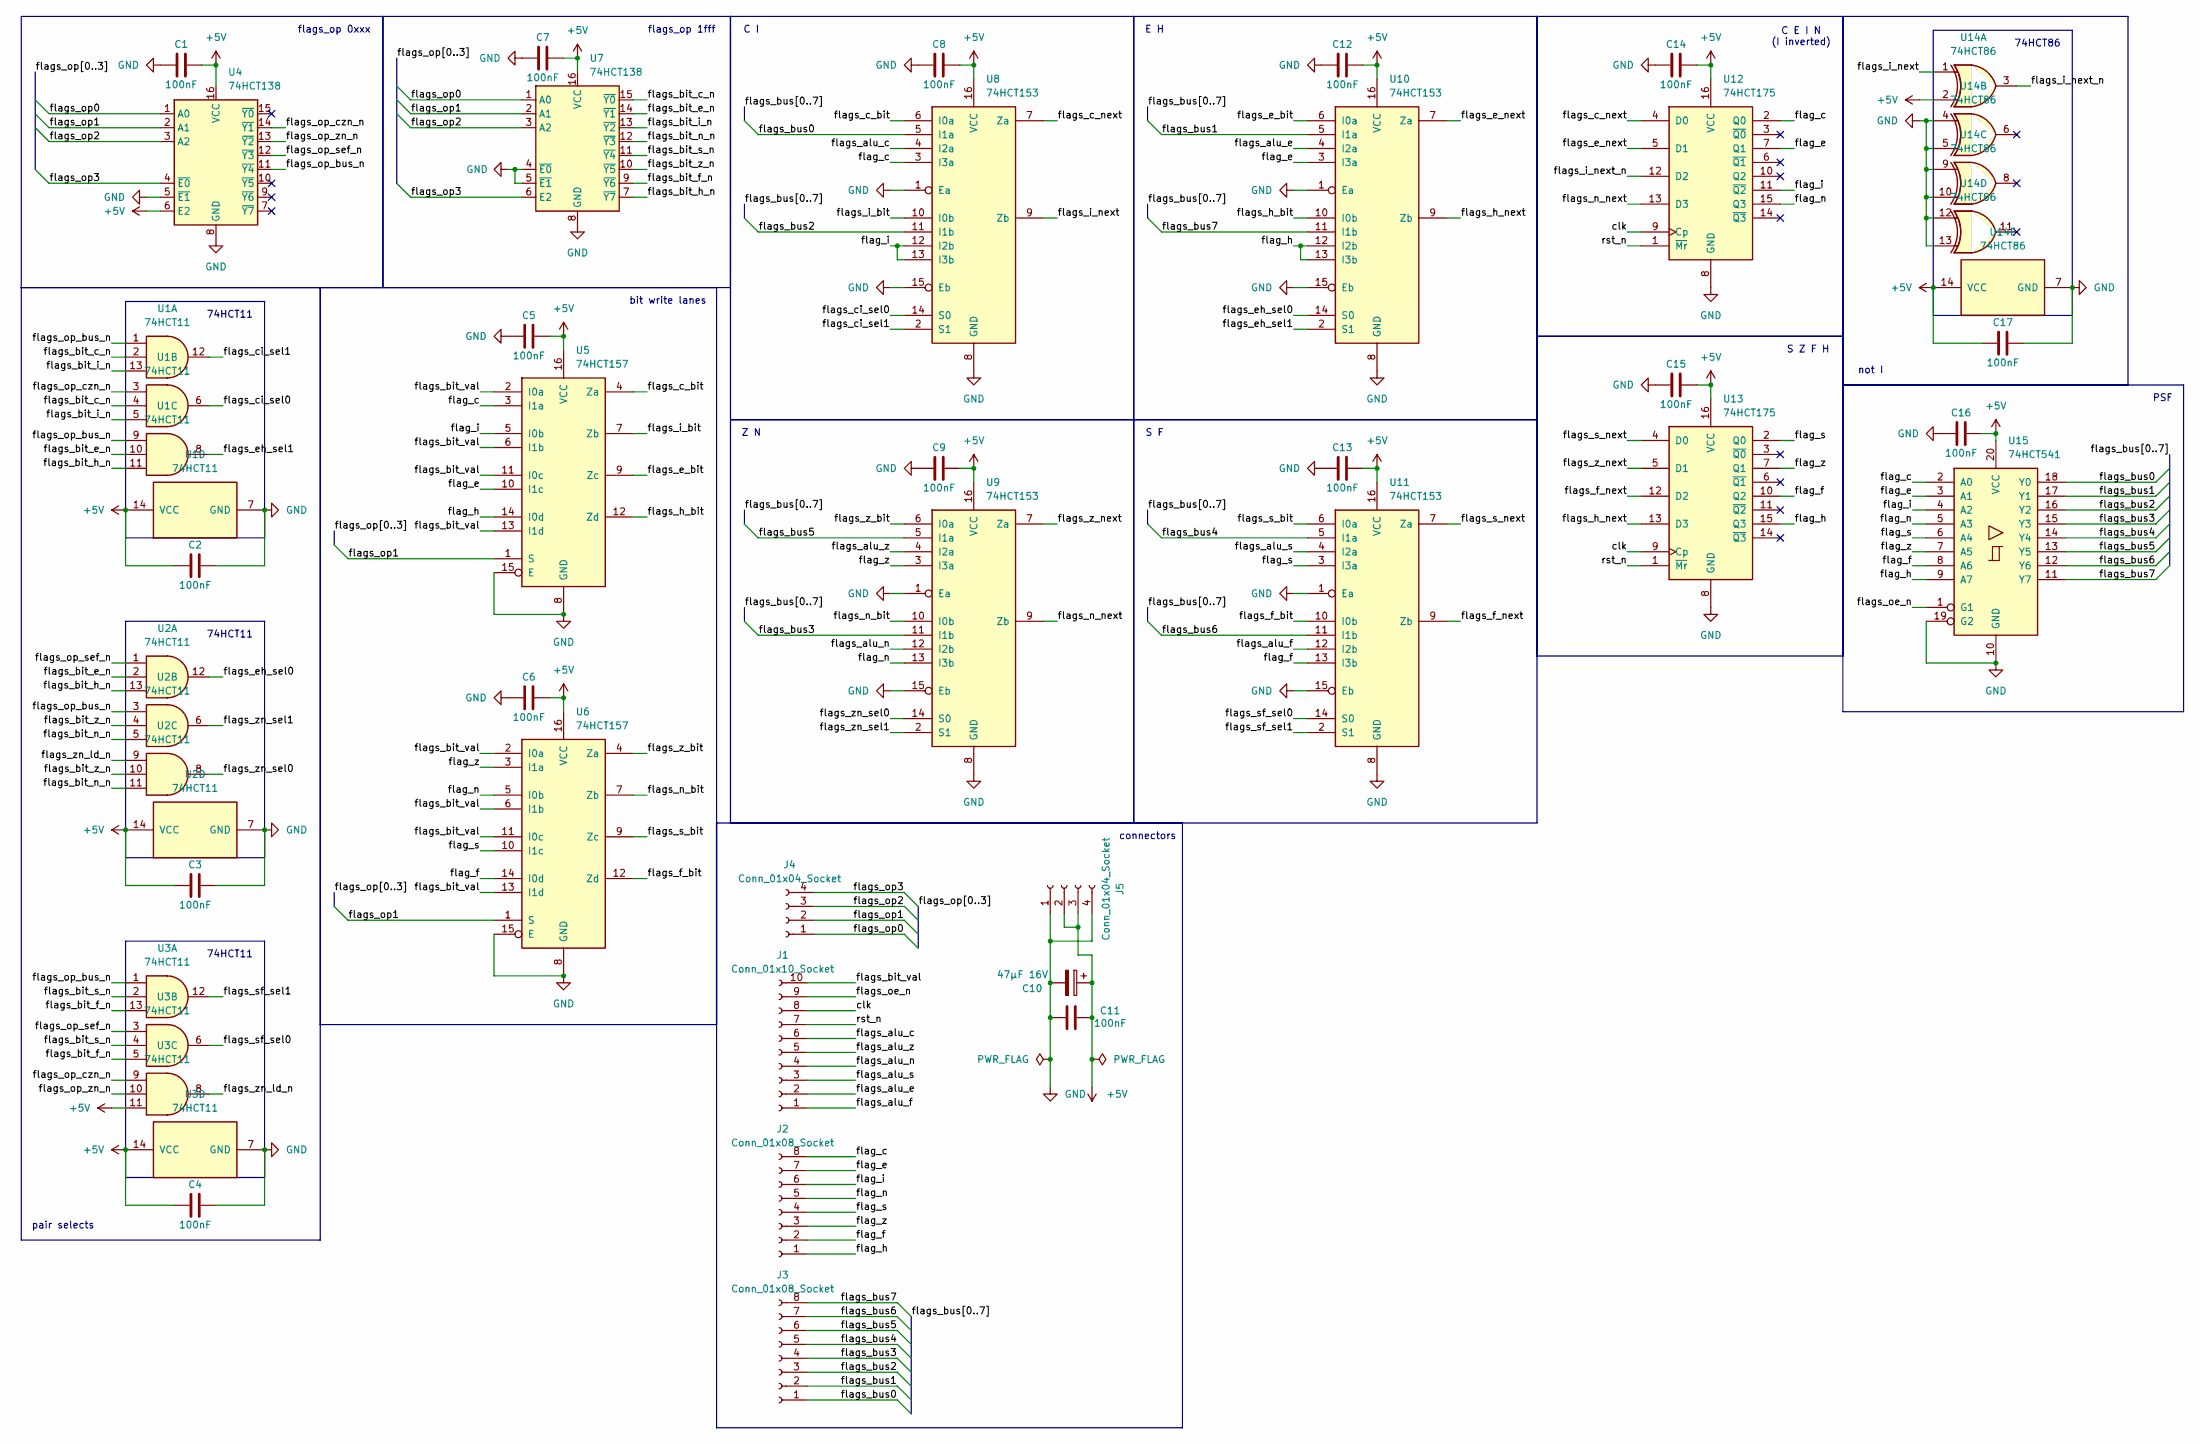
[picture p22: schematic hbc2_flags.kicad_sch]

Parts:
C1, C2, C3, C4, C5, C6, C7, C8, C9, C11, C12, C13, C14, C15, C16, C17: 100nF
C10: 47µF 16V
J1: Conn_01x10_Socket
J2, J3: Conn_01x08_Socket
J4, J5: Conn_01x04_Socket
U1, U2, U3: 74HCT11
U4, U7: 74HCT138
U5, U6: 74HCT157
U8, U9, U10, U11: 74HCT153
U12, U13: 74HCT175
U14: 74HCT86
U15: 74HCT541

Connections:
+5V: C1.2, C2.1, C3.1, C4.1, C5.2, C6.2, C7.2, C8.2, C9.2, C10.1, C11.2, C12.2, C13.2, C14.2, C15.2, C16.2, C17.1, J5.2, J5.3, U1.14 (VCC), U2.14 (VCC), U3.11, U3.14 (VCC), U4.6 (E2), U4.16 (VCC), U5.16 (VCC), U6.16 (VCC), U7.16 (VCC), U8.16 (VCC), U9.16 (VCC), U10.16 (VCC), U11.16 (VCC), U12.16 (VCC), U13.16 (VCC), U14.2, U14.14 (VCC), U15.20 (VCC)
GND: C1.1, C2.2, C3.2, C4.2, C5.1, C6.1, C7.1, C8.1, C9.1, C10.2, C11.1, C12.1, C13.1, C14.1, C15.1, C16.1, C17.2, J5.1, J5.4, U1.7 (GND), U2.7 (GND), U3.7 (GND), U4.5 (~E1), U4.8 (GND), U5.8 (GND), U5.15 (E), U6.8 (GND), U6.15 (E), U7.4 (~E0), U7.5 (~E1), U7.8 (GND), U8.1 (Ea), U8.8 (GND), U8.15 (Eb), U9.1 (Ea), U9.8 (GND), U9.15 (Eb), U10.1 (Ea), U10.8 (GND), U10.15 (Eb), U11.1 (Ea), U11.8 (GND), U11.15 (Eb), U12.8 (GND), U13.8 (GND), U14.4, U14.5, U14.7 (GND), U14.9, U14.10, U14.12, U14.13, U15.10 (GND), U15.19 (G2)
clk: J1.8, U12.9 (Cp), U13.9 (Cp)
flag_c: J2.8, U5.3 (I1a), U8.3 (I3a), U12.2 (Q0), U15.2 (A0)
flag_e: J2.7, U5.10 (I1c), U10.3 (I3a), U12.7 (Q1), U15.3 (A1)
flag_f: J2.2, U6.14 (I0d), U11.13 (I3b), U13.10 (Q2), U15.8 (A6)
flag_h: J2.1, U5.14 (I0d), U10.12 (I2b), U10.13 (I3b), U13.15 (Q3), U15.9 (A7)
flag_i: J2.6, U5.5 (I0b), U8.12 (I2b), U8.13 (I3b), U12.11 (~Q2), U15.4 (A2)
flag_n: J2.5, U6.5 (I0b), U9.13 (I3b), U12.15 (Q3), U15.5 (A3)
flag_s: J2.4, U6.10 (I1c), U11.3 (I3a), U13.2 (Q0), U15.6 (A4)
flag_z: J2.3, U6.3 (I1a), U9.3 (I3a), U13.7 (Q1), U15.7 (A5)
flags_alu_c: J1.6, U8.4 (I2a)
flags_alu_e: J1.2, U10.4 (I2a)
flags_alu_f: J1.1, U11.12 (I2b)
flags_alu_n: J1.4, U9.12 (I2b)
flags_alu_s: J1.3, U11.4 (I2a)
flags_alu_z: J1.5, U9.4 (I2a)
flags_bit_c_n: U1.2, U1.4, U7.15 (~Y0)
flags_bit_e_n: U1.10, U2.2, U7.14 (~Y1)
flags_bit_f_n: U3.5, U3.13, U7.9 (~Y6)
flags_bit_h_n: U1.11, U2.13, U7.7 (~Y7)
flags_bit_i_n: U1.5, U1.13, U7.13 (~Y2)
flags_bit_n_n: U2.5, U2.11, U7.12 (~Y3)
flags_bit_s_n: U3.2, U3.4, U7.11 (~Y4)
flags_bit_val: J1.10, U5.2 (I0a), U5.6 (I1b), U5.11 (I0c), U5.13 (I1d), U6.2 (I0a), U6.6 (I1b), U6.11 (I0c), U6.13 (I1d)
flags_bit_z_n: U2.4, U2.10, U7.10 (~Y5)
flags_bus0: J3.1, U8.5 (I1a), U15.18 (Y0)
flags_bus1: J3.2, U10.5 (I1a), U15.17 (Y1)
flags_bus2: J3.3, U8.11 (I1b), U15.16 (Y2)
flags_bus3: J3.4, U9.11 (I1b), U15.15 (Y3)
flags_bus4: J3.5, U11.5 (I1a), U15.14 (Y4)
flags_bus5: J3.6, U9.5 (I1a), U15.13 (Y5)
flags_bus6: J3.7, U11.11 (I1b), U15.12 (Y6)
flags_bus7: J3.8, U10.11 (I1b), U15.11 (Y7)
flags_c_bit: U5.4 (Za), U8.6 (I0a)
flags_c_next: U8.7 (Za), U12.4 (D0)
flags_ci_sel0: U1.6, U8.14 (S0)
flags_ci_sel1: U1.12, U8.2 (S1)
flags_e_bit: U5.9 (Zc), U10.6 (I0a)
flags_e_next: U10.7 (Za), U12.5 (D1)
flags_eh_sel0: U2.12, U10.14 (S0)
flags_eh_sel1: U1.8, U10.2 (S1)
flags_f_bit: U6.12 (Zd), U11.10 (I0b)
flags_f_next: U11.9 (Zb), U13.12 (D2)
flags_h_bit: U5.12 (Zd), U10.10 (I0b)
flags_h_next: U10.9 (Zb), U13.13 (D3)
flags_i_bit: U5.7 (Zb), U8.10 (I0b)
flags_i_next: U8.9 (Zb), U14.1
flags_i_next_n: U12.12 (D2), U14.3
flags_n_bit: U6.7 (Zb), U9.10 (I0b)
flags_n_next: U9.9 (Zb), U12.13 (D3)
flags_oe_n: J1.9, U15.1 (G1)
flags_op0: J4.1, U4.1 (A0), U7.1 (A0)
flags_op1: J4.2, U4.2 (A1), U5.1 (S), U6.1 (S), U7.2 (A1)
flags_op2: J4.3, U4.3 (A2), U7.3 (A2)
flags_op3: J4.4, U4.4 (~E0), U7.6 (E2)
flags_op_bus_n: U1.1, U1.9, U2.3, U3.1, U4.11 (~Y4)
flags_op_czn_n: U1.3, U3.9, U4.14 (~Y1)
flags_op_sef_n: U2.1, U3.3, U4.12 (~Y3)
flags_op_zn_n: U3.10, U4.13 (~Y2)
flags_s_bit: U6.9 (Zc), U11.6 (I0a)
flags_s_next: U11.7 (Za), U13.4 (D0)
flags_sf_sel0: U3.6, U11.14 (S0)
flags_sf_sel1: U3.12, U11.2 (S1)
flags_z_bit: U6.4 (Za), U9.6 (I0a)
flags_z_next: U9.7 (Za), U13.5 (D1)
flags_zn_ld_n: U2.9, U3.8
flags_zn_sel0: U2.8, U9.14 (S0)
flags_zn_sel1: U2.6, U9.2 (S1)
rst_n: J1.7, U12.1 (~Mr), U13.1 (~Mr)

Notes on the sheet:
74HCT11
S F
flags_op 1fff
74HCT86
pair selects
bit write lanes
E H
C E I N (I inverted)
flags_op 0xxx
Z N
PSF
connectors
C I
S Z F H
not I
