SteriCraft/hbc2-ide/kicad/iod/hbc2_iod.kicad_sch

## KiCad design kicad/iod/hbc2_iod.kicad_sch (2026-11-14)

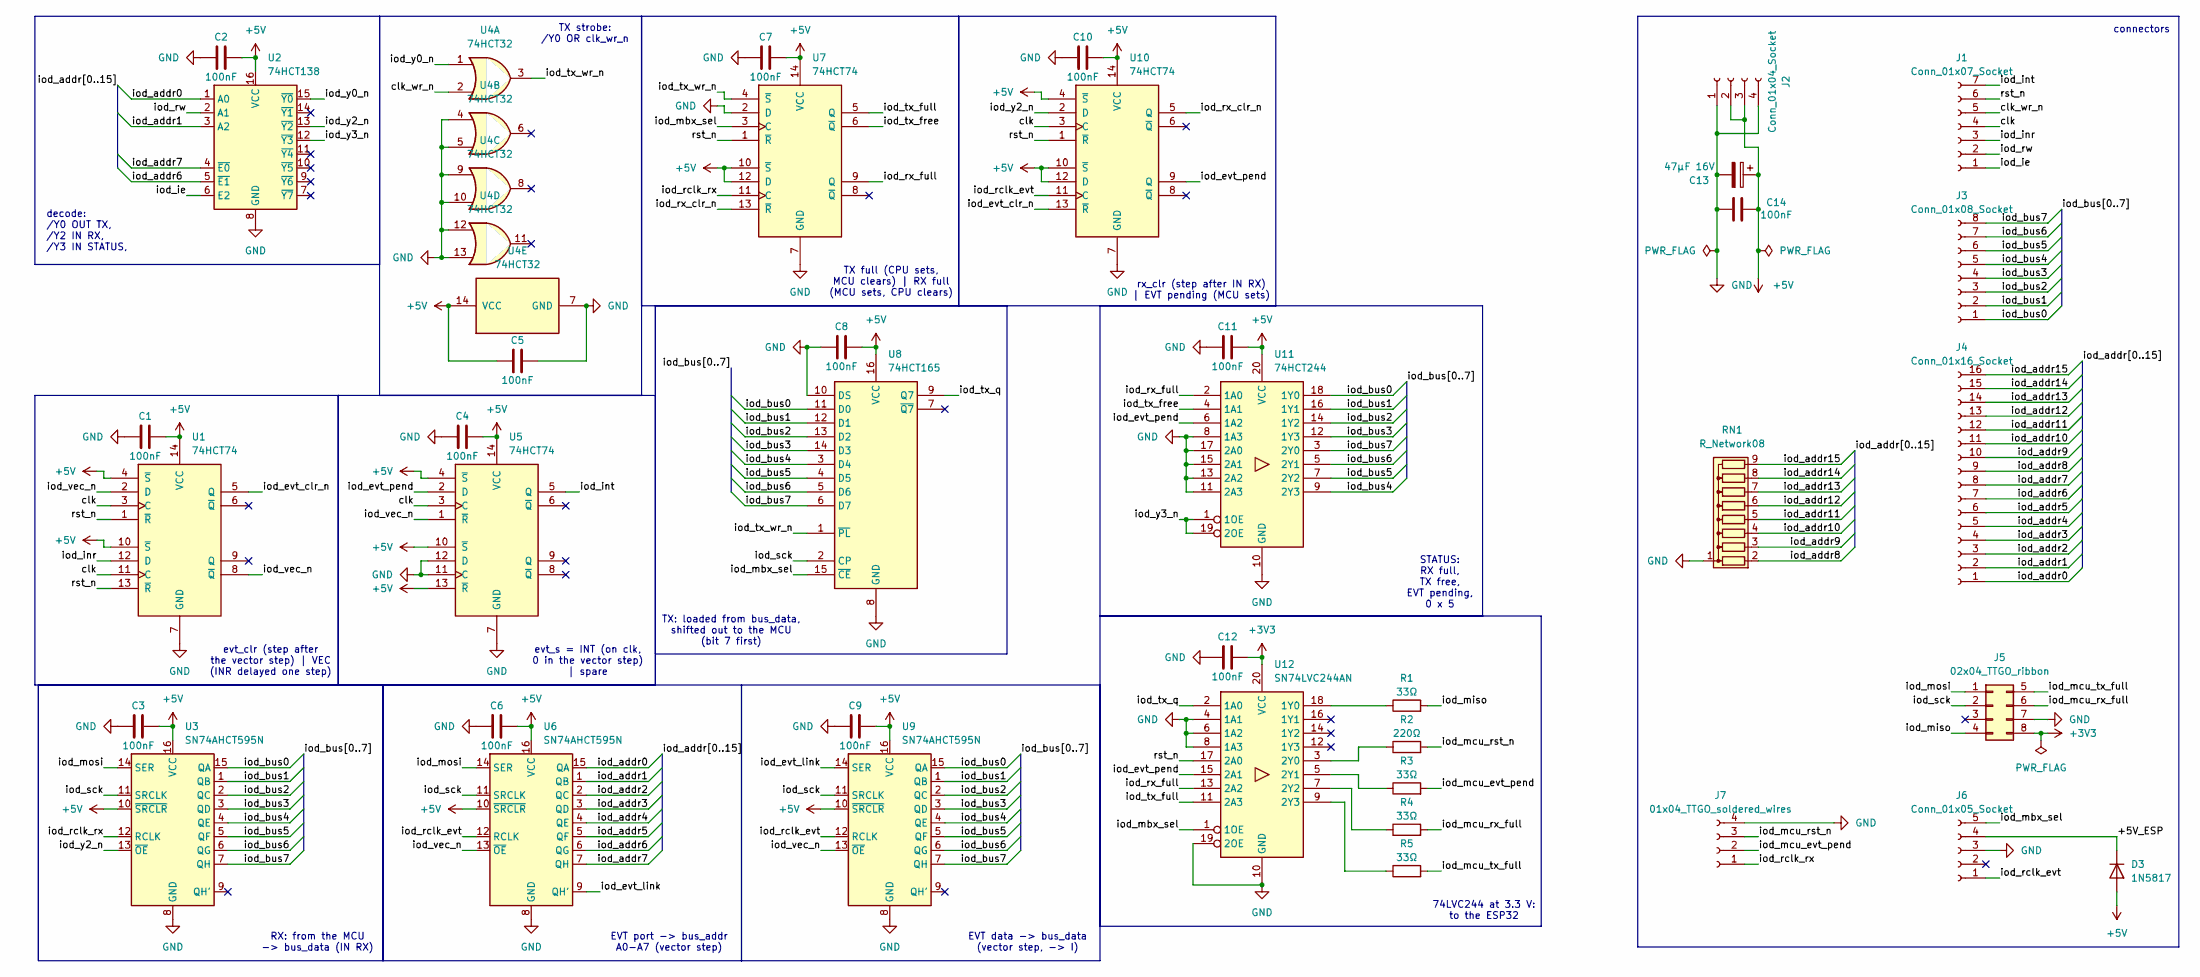
[picture p23: schematic hbc2_iod.kicad_sch]

Parts:
C1, C2, C3, C4, C5, C6, C7, C8, C9, C10, C11, C12, C14: 100nF
C13: 47µF 16V
D3: 1N5817
J1: Conn_01x07_Socket
J2: Conn_01x04_Socket
J3: Conn_01x08_Socket
J4: Conn_01x16_Socket
J5: 02x04_TTGO_ribbon
J6: Conn_01x05_Socket
J7: 01x04_TTGO_soldered_wires
R1, R3, R4, R5: 33Ω
R2: 220Ω
RN1: R_Network08; R_Array_SIP9
U1, U5, U7, U10: 74HCT74
U2: 74HCT138
U3, U6, U9: SN74AHCT595N
U4: 74HCT32
U8: 74HCT165
U11: 74HCT244
U12: SN74LVC244AN

Connections:
+3V3: C12.2, J5.8, U12.20 (VCC)
+5V: C1.2, C2.2, C3.2, C4.2, C5.1, C6.2, C7.2, C8.2, C9.2, C10.2, C11.2, C13.1, C14.2, D3.2 (A), J2.2, J2.3, U1.4 (~S), U1.10 (~S), U1.14 (VCC), U2.16 (VCC), U3.10 (~SRCLR), U3.16 (VCC), U4.14 (VCC), U5.4 (~S), U5.10 (~S), U5.13 (~R), U5.14 (VCC), U6.10 (~SRCLR), U6.16 (VCC), U7.10 (~S), U7.12 (D), U7.14 (VCC), U8.16 (VCC), U9.10 (~SRCLR), U9.16 (VCC), U10.4 (~S), U10.10 (~S), U10.12 (D), U10.14 (VCC), U11.20 (VCC)
+5V_ESP: D3.1 (K), J6.4
GND: C1.1, C2.1, C3.1, C4.1, C5.2, C6.1, C7.1, C8.1, C9.1, C10.1, C11.1, C12.1, C13.2, C14.1, J2.1, J2.4, J5.7, J6.3, J7.4, RN1.1 (common), U1.7 (GND), U2.8 (GND), U3.8 (GND), U4.4, U4.5, U4.7 (GND), U4.9, U4.10, U4.12, U4.13, U5.7 (GND), U5.11 (C), U5.12 (D), U6.8 (GND), U7.2 (D), U7.7 (GND), U8.8 (GND), U8.10 (DS), U9.8 (GND), U10.7 (GND), U11.8 (1A3), U11.10 (GND), U11.11 (2A3), U11.13 (2A2), U11.15 (2A1), U11.17 (2A0), U12.4 (1A1), U12.6 (1A2), U12.8 (1A3), U12.10 (GND), U12.19 (2OE)
unnamed: R1.1, U12.18 (1Y0)
unnamed: R2.1, U12.3 (2Y0)
unnamed: R3.1, U12.5 (2Y1)
unnamed: R4.1, U12.7 (2Y2)
unnamed: R5.1, U12.9 (2Y3)
clk: J1.4, U1.3 (C), U1.11 (C), U5.3 (C), U10.3 (C)
clk_wr_n: J1.5, U4.2
iod_addr0: J4.1, U2.1 (A0), U6.15 (QA)
iod_addr1: J4.2, U2.3 (A2), U6.1 (QB)
iod_addr2: J4.3, U6.2 (QC)
iod_addr3: J4.4, U6.3 (QD)
iod_addr4: J4.5, U6.4 (QE)
iod_addr5: J4.6, U6.5 (QF)
iod_addr6: J4.7, U2.5 (~E1), U6.6 (QG)
iod_addr7: J4.8, U2.4 (~E0), U6.7 (QH)
iod_addr8: J4.9, RN1.2 (R1)
iod_addr9: J4.10, RN1.3 (R2)
iod_addr10: J4.11, RN1.4 (R3)
iod_addr11: J4.12, RN1.5 (R4)
iod_addr12: J4.13, RN1.6 (R5)
iod_addr13: J4.14, RN1.7 (R6)
iod_addr14: J4.15, RN1.8 (R7)
iod_addr15: J4.16, RN1.9 (R8)
iod_bus0: J3.1, U3.15 (QA), U8.11 (D0), U9.15 (QA), U11.18 (1Y0)
iod_bus1: J3.2, U3.1 (QB), U8.12 (D1), U9.1 (QB), U11.16 (1Y1)
iod_bus2: J3.3, U3.2 (QC), U8.13 (D2), U9.2 (QC), U11.14 (1Y2)
iod_bus3: J3.4, U3.3 (QD), U8.14 (D3), U9.3 (QD), U11.12 (1Y3)
iod_bus4: J3.5, U3.4 (QE), U8.3 (D4), U9.4 (QE), U11.9 (2Y3)
iod_bus5: J3.6, U3.5 (QF), U8.4 (D5), U9.5 (QF), U11.7 (2Y2)
iod_bus6: J3.7, U3.6 (QG), U8.5 (D6), U9.6 (QG), U11.5 (2Y1)
iod_bus7: J3.8, U3.7 (QH), U8.6 (D7), U9.7 (QH), U11.3 (2Y0)
iod_evt_clr_n: U1.5 (Q), U10.13 (~R)
iod_evt_link: U6.9 (QH'), U9.14 (SER)
iod_evt_pend: U5.2 (D), U10.9 (Q), U11.6 (1A2), U12.15 (2A1)
iod_ie: J1.1, U2.6 (E2)
iod_inr: J1.3, U1.12 (D)
iod_int: J1.7, U5.5 (Q)
iod_mbx_sel: J6.5, U7.3 (C), U8.15 (~CE), U12.1 (1OE)
iod_mcu_evt_pend: J7.2, R3.2
iod_mcu_rst_n: J7.3, R2.2
iod_mcu_rx_full: J5.6, R4.2
iod_mcu_tx_full: J5.5, R5.2
iod_miso: J5.4, R1.2
iod_mosi: J5.1, U3.14 (SER), U6.14 (SER)
iod_rclk_evt: J6.1, U6.12 (RCLK), U9.12 (RCLK), U10.11 (C)
iod_rclk_rx: J7.1, U3.12 (RCLK), U7.11 (C)
iod_rw: J1.2, U2.2 (A1)
iod_rx_clr_n: U7.13 (~R), U10.5 (Q)
iod_rx_full: U7.9 (Q), U11.2 (1A0), U12.13 (2A2)
iod_sck: J5.2, U3.11 (SRCLK), U6.11 (SRCLK), U8.2 (CP), U9.11 (SRCLK)
iod_tx_free: U7.6 (~Q), U11.4 (1A1)
iod_tx_full: U7.5 (Q), U12.11 (2A3)
iod_tx_q: U8.9 (Q7), U12.2 (1A0)
iod_tx_wr_n: U4.3, U7.4 (~S), U8.1 (~PL)
iod_vec_n: U1.2 (D), U1.8 (~Q), U5.1 (~R), U6.13 (~OE), U9.13 (~OE)
iod_y0_n: U2.15 (~Y0), U4.1
iod_y2_n: U2.13 (~Y2), U3.13 (~OE), U10.2 (D)
iod_y3_n: U2.12 (~Y3), U11.1 (1OE), U11.19 (2OE)
rst_n: J1.6, U1.1 (~R), U1.13 (~R), U7.1 (~R), U10.1 (~R), U12.17 (2A0)

Notes on the sheet:
74LVC244 at 3.3 V: to the ESP32
evt_s = INT (on clk, 0 in the vector step) | spare
EVT data -> bus_data (vector step, -> I)
STATUS: RX full, TX free, EVT pending, 0 x 5
TX: loaded from bus_data, shifted out to the MCU (bit 7 first)
EVT port -> bus_addr A0-A7 (vector step)
rx_clr (step after IN RX) | EVT pending (MCU sets)
TX full (CPU sets, MCU clears) | RX full (MCU sets, CPU clears)
TX strobe: /Y0 OR clk_wr_n
connectors
RX: from the MCU -> bus_data (IN RX)
evt_clr (step after the vector step) | VEC (INR delayed one step)
decode: /Y0 OUT TX, /Y2 IN RX, /Y3 IN STATUS,
