SteriCraft/hbc2-ide/kicad/ir/hbc2_ir.kicad_sch

## KiCad design kicad/ir/hbc2_ir.kicad_sch (2026-11-14)

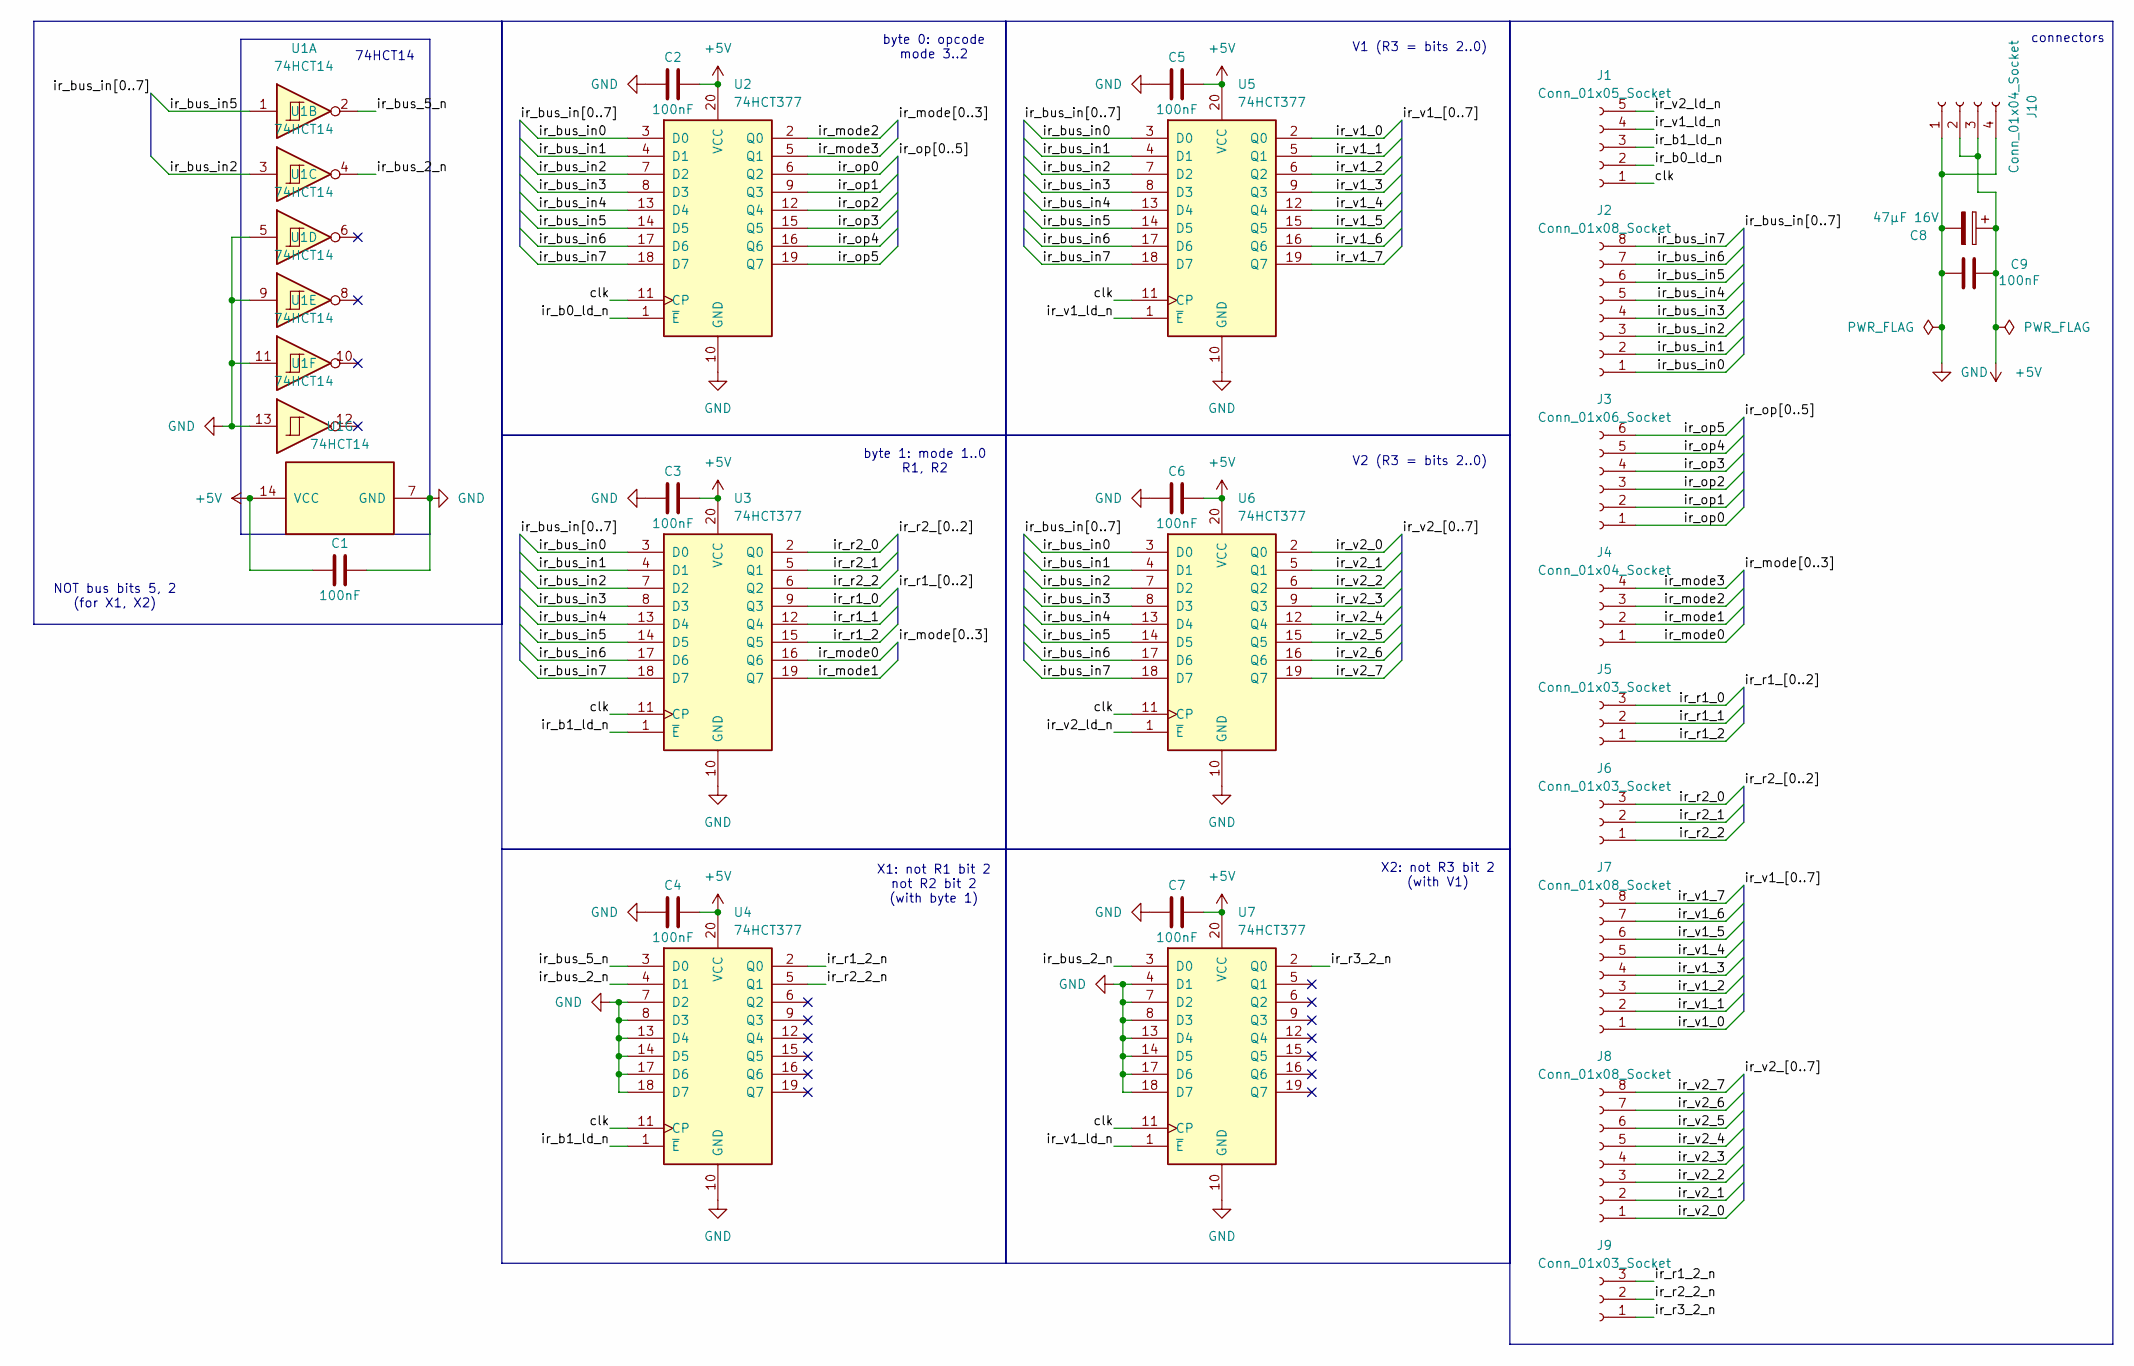
[picture p24: schematic hbc2_ir.kicad_sch]

Parts:
C1, C2, C3, C4, C5, C6, C7, C9: 100nF
C8: 47µF 16V
J1: Conn_01x05_Socket
J2, J7, J8: Conn_01x08_Socket
J3: Conn_01x06_Socket
J4, J10: Conn_01x04_Socket
J5, J6, J9: Conn_01x03_Socket
U1: 74HCT14
U2, U3, U4, U5, U6, U7: 74HCT377

Connections:
+5V: C1.1, C2.2, C3.2, C4.2, C5.2, C6.2, C7.2, C8.1, C9.2, J10.2, J10.3, U1.14 (VCC), U2.20 (VCC), U3.20 (VCC), U4.20 (VCC), U5.20 (VCC), U6.20 (VCC), U7.20 (VCC)
GND: C1.2, C2.1, C3.1, C4.1, C5.1, C6.1, C7.1, C8.2, C9.1, J10.1, J10.4, U1.5, U1.7 (GND), U1.9, U1.11, U1.13, U2.10 (GND), U3.10 (GND), U4.7 (D2), U4.8 (D3), U4.10 (GND), U4.13 (D4), U4.14 (D5), U4.17 (D6), U4.18 (D7), U5.10 (GND), U6.10 (GND), U7.4 (D1), U7.7 (D2), U7.8 (D3), U7.10 (GND), U7.13 (D4), U7.14 (D5), U7.17 (D6), U7.18 (D7)
clk: J1.1, U2.11 (CP), U3.11 (CP), U4.11 (CP), U5.11 (CP), U6.11 (CP), U7.11 (CP)
ir_b0_ld_n: J1.2, U2.1 (~E)
ir_b1_ld_n: J1.3, U3.1 (~E), U4.1 (~E)
ir_bus_2_n: U1.4, U4.4 (D1), U7.3 (D0)
ir_bus_5_n: U1.2, U4.3 (D0)
ir_bus_in0: J2.1, U2.3 (D0), U3.3 (D0), U5.3 (D0), U6.3 (D0)
ir_bus_in1: J2.2, U2.4 (D1), U3.4 (D1), U5.4 (D1), U6.4 (D1)
ir_bus_in2: J2.3, U1.3, U2.7 (D2), U3.7 (D2), U5.7 (D2), U6.7 (D2)
ir_bus_in3: J2.4, U2.8 (D3), U3.8 (D3), U5.8 (D3), U6.8 (D3)
ir_bus_in4: J2.5, U2.13 (D4), U3.13 (D4), U5.13 (D4), U6.13 (D4)
ir_bus_in5: J2.6, U1.1, U2.14 (D5), U3.14 (D5), U5.14 (D5), U6.14 (D5)
ir_bus_in6: J2.7, U2.17 (D6), U3.17 (D6), U5.17 (D6), U6.17 (D6)
ir_bus_in7: J2.8, U2.18 (D7), U3.18 (D7), U5.18 (D7), U6.18 (D7)
ir_mode0: J4.1, U3.16 (Q6)
ir_mode1: J4.2, U3.19 (Q7)
ir_mode2: J4.3, U2.2 (Q0)
ir_mode3: J4.4, U2.5 (Q1)
ir_op0: J3.1, U2.6 (Q2)
ir_op1: J3.2, U2.9 (Q3)
ir_op2: J3.3, U2.12 (Q4)
ir_op3: J3.4, U2.15 (Q5)
ir_op4: J3.5, U2.16 (Q6)
ir_op5: J3.6, U2.19 (Q7)
ir_r1_0: J5.3, U3.9 (Q3)
ir_r1_1: J5.2, U3.12 (Q4)
ir_r1_2: J5.1, U3.15 (Q5)
ir_r1_2_n: J9.3, U4.2 (Q0)
ir_r2_0: J6.3, U3.2 (Q0)
ir_r2_1: J6.2, U3.5 (Q1)
ir_r2_2: J6.1, U3.6 (Q2)
ir_r2_2_n: J9.2, U4.5 (Q1)
ir_r3_2_n: J9.1, U7.2 (Q0)
ir_v1_0: J7.1, U5.2 (Q0)
ir_v1_1: J7.2, U5.5 (Q1)
ir_v1_2: J7.3, U5.6 (Q2)
ir_v1_3: J7.4, U5.9 (Q3)
ir_v1_4: J7.5, U5.12 (Q4)
ir_v1_5: J7.6, U5.15 (Q5)
ir_v1_6: J7.7, U5.16 (Q6)
ir_v1_7: J7.8, U5.19 (Q7)
ir_v1_ld_n: J1.4, U5.1 (~E), U7.1 (~E)
ir_v2_0: J8.1, U6.2 (Q0)
ir_v2_1: J8.2, U6.5 (Q1)
ir_v2_2: J8.3, U6.6 (Q2)
ir_v2_3: J8.4, U6.9 (Q3)
ir_v2_4: J8.5, U6.12 (Q4)
ir_v2_5: J8.6, U6.15 (Q5)
ir_v2_6: J8.7, U6.16 (Q6)
ir_v2_7: J8.8, U6.19 (Q7)
ir_v2_ld_n: J1.5, U6.1 (~E)

Notes on the sheet:
byte 0: opcode mode 3..2
V1 (R3 = bits 2..0)
X1: not R1 bit 2 not R2 bit 2 (with byte 1)
X2: not R3 bit 2 (with V1)
byte 1: mode 1..0 R1, R2
74HCT14
NOT bus bits 5, 2 (for X1, X2)
connectors
V2 (R3 = bits 2..0)
