SteriCraft/hbc2-ide/kicad/mem/hbc2_mem.kicad_sch

## KiCad design kicad/mem/hbc2_mem.kicad_sch (2026-11-14)

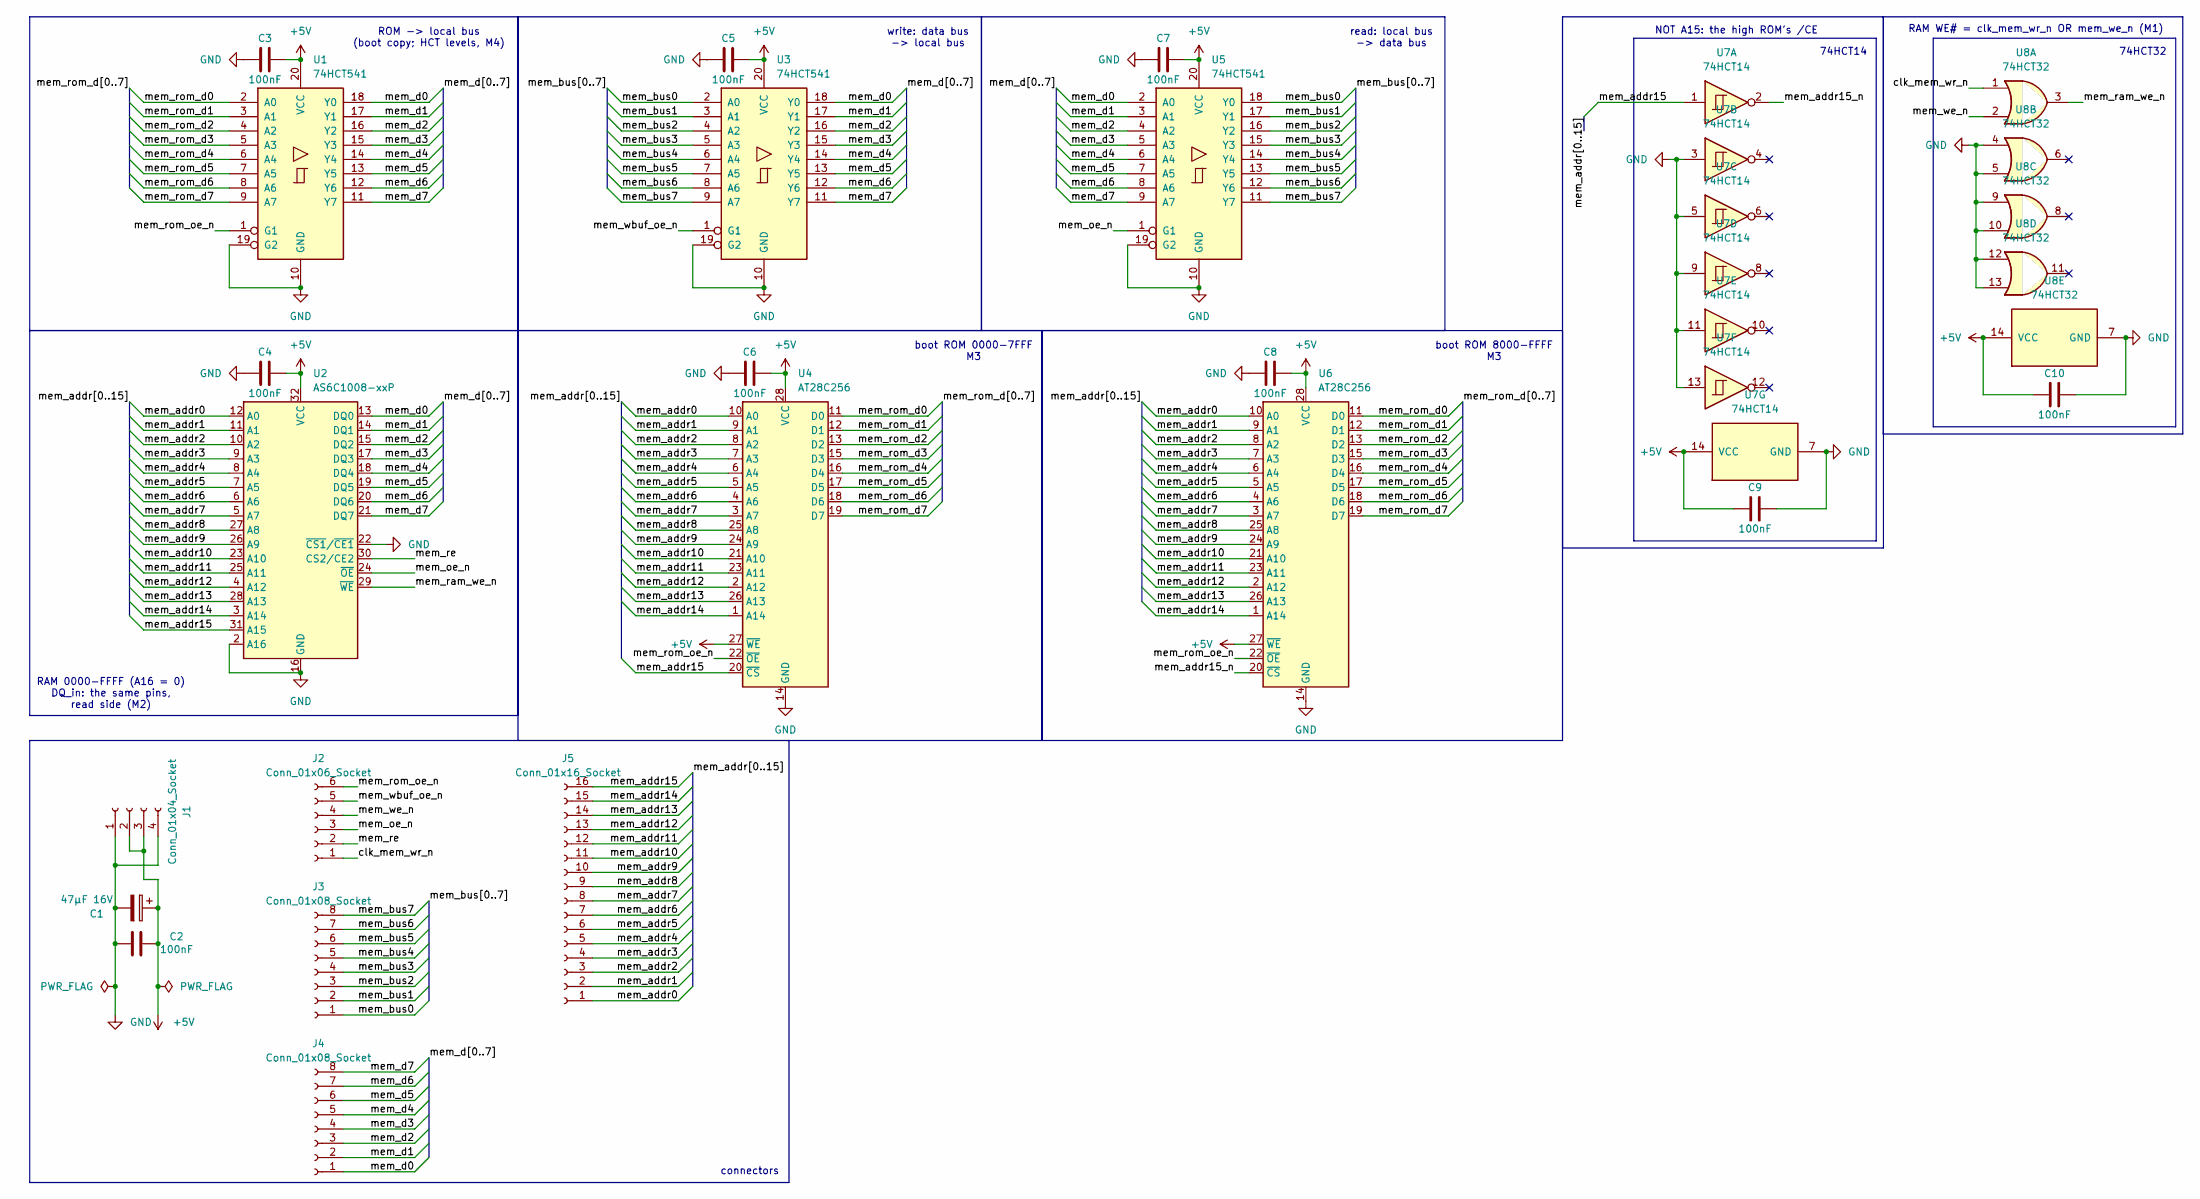
[picture p25: schematic hbc2_mem.kicad_sch]

Parts:
C1: 47µF 16V
C2, C3, C4, C5, C6, C7, C8, C9, C10: 100nF
J1: Conn_01x04_Socket
J2: Conn_01x06_Socket
J3, J4: Conn_01x08_Socket
J5: Conn_01x16_Socket
U1, U3, U5: 74HCT541
U2: AS6C1008-xxP; DIP-32_W15.24mm
U4, U6: AT28C256
U7: 74HCT14
U8: 74HCT32

Connections:
+5V: C1.1, C2.2, C3.2, C4.2, C5.2, C6.2, C7.2, C8.2, C9.1, C10.1, J1.2, J1.3, U1.20 (VCC), U2.32 (VCC), U3.20 (VCC), U4.27 (~WE), U4.28 (VCC), U5.20 (VCC), U6.27 (~WE), U6.28 (VCC), U7.14 (VCC), U8.14 (VCC)
GND: C1.2, C2.1, C3.1, C4.1, C5.1, C6.1, C7.1, C8.1, C9.2, C10.2, J1.1, J1.4, U1.10 (GND), U1.19 (G2), U2.2 (A16), U2.16 (GND), U2.22 (~CS1/~CE1), U3.10 (GND), U3.19 (G2), U4.14 (GND), U5.10 (GND), U5.19 (G2), U6.14 (GND), U7.3, U7.5, U7.7 (GND), U7.9, U7.11, U7.13, U8.4, U8.5, U8.7 (GND), U8.9, U8.10, U8.12, U8.13
clk_mem_wr_n: J2.1, U8.1
mem_addr0: J5.1, U2.12 (A0), U4.10 (A0), U6.10 (A0)
mem_addr1: J5.2, U2.11 (A1), U4.9 (A1), U6.9 (A1)
mem_addr2: J5.3, U2.10 (A2), U4.8 (A2), U6.8 (A2)
mem_addr3: J5.4, U2.9 (A3), U4.7 (A3), U6.7 (A3)
mem_addr4: J5.5, U2.8 (A4), U4.6 (A4), U6.6 (A4)
mem_addr5: J5.6, U2.7 (A5), U4.5 (A5), U6.5 (A5)
mem_addr6: J5.7, U2.6 (A6), U4.4 (A6), U6.4 (A6)
mem_addr7: J5.8, U2.5 (A7), U4.3 (A7), U6.3 (A7)
mem_addr8: J5.9, U2.27 (A8), U4.25 (A8), U6.25 (A8)
mem_addr9: J5.10, U2.26 (A9), U4.24 (A9), U6.24 (A9)
mem_addr10: J5.11, U2.23 (A10), U4.21 (A10), U6.21 (A10)
mem_addr11: J5.12, U2.25 (A11), U4.23 (A11), U6.23 (A11)
mem_addr12: J5.13, U2.4 (A12), U4.2 (A12), U6.2 (A12)
mem_addr13: J5.14, U2.28 (A13), U4.26 (A13), U6.26 (A13)
mem_addr14: J5.15, U2.3 (A14), U4.1 (A14), U6.1 (A14)
mem_addr15: J5.16, U2.31 (A15), U4.20 (~CS), U7.1
mem_addr15_n: U6.20 (~CS), U7.2
mem_bus0: J3.1, U3.2 (A0), U5.18 (Y0)
mem_bus1: J3.2, U3.3 (A1), U5.17 (Y1)
mem_bus2: J3.3, U3.4 (A2), U5.16 (Y2)
mem_bus3: J3.4, U3.5 (A3), U5.15 (Y3)
mem_bus4: J3.5, U3.6 (A4), U5.14 (Y4)
mem_bus5: J3.6, U3.7 (A5), U5.13 (Y5)
mem_bus6: J3.7, U3.8 (A6), U5.12 (Y6)
mem_bus7: J3.8, U3.9 (A7), U5.11 (Y7)
mem_d0: J4.1, U1.18 (Y0), U2.13 (DQ0), U3.18 (Y0), U5.2 (A0)
mem_d1: J4.2, U1.17 (Y1), U2.14 (DQ1), U3.17 (Y1), U5.3 (A1)
mem_d2: J4.3, U1.16 (Y2), U2.15 (DQ2), U3.16 (Y2), U5.4 (A2)
mem_d3: J4.4, U1.15 (Y3), U2.17 (DQ3), U3.15 (Y3), U5.5 (A3)
mem_d4: J4.5, U1.14 (Y4), U2.18 (DQ4), U3.14 (Y4), U5.6 (A4)
mem_d5: J4.6, U1.13 (Y5), U2.19 (DQ5), U3.13 (Y5), U5.7 (A5)
mem_d6: J4.7, U1.12 (Y6), U2.20 (DQ6), U3.12 (Y6), U5.8 (A6)
mem_d7: J4.8, U1.11 (Y7), U2.21 (DQ7), U3.11 (Y7), U5.9 (A7)
mem_oe_n: J2.3, U2.24 (~OE), U5.1 (G1)
mem_ram_we_n: U2.29 (~WE), U8.3
mem_re: J2.2, U2.30 (CS2/CE2)
mem_rom_d0: U1.2 (A0), U4.11 (D0), U6.11 (D0)
mem_rom_d1: U1.3 (A1), U4.12 (D1), U6.12 (D1)
mem_rom_d2: U1.4 (A2), U4.13 (D2), U6.13 (D2)
mem_rom_d3: U1.5 (A3), U4.15 (D3), U6.15 (D3)
mem_rom_d4: U1.6 (A4), U4.16 (D4), U6.16 (D4)
mem_rom_d5: U1.7 (A5), U4.17 (D5), U6.17 (D5)
mem_rom_d6: U1.8 (A6), U4.18 (D6), U6.18 (D6)
mem_rom_d7: U1.9 (A7), U4.19 (D7), U6.19 (D7)
mem_rom_oe_n: J2.6, U1.1 (G1), U4.22 (~OE), U6.22 (~OE)
mem_wbuf_oe_n: J2.5, U3.1 (G1)
mem_we_n: J2.4, U8.2

Notes on the sheet:
NOT A15: the high ROM's /CE
write: data bus -> local bus
74HCT14
connectors
RAM WE# = clk_mem_wr_n OR mem_we_n (M1)
74HCT32
boot ROM 8000-FFFF M3
boot ROM 0000-7FFF M3
read: local bus -> data bus
ROM -> local bus (boot copy; HCT levels, M4)
RAM 0000-FFFF (A16 = 0) DQ_in: the same pins, read side (M2)
