SteriCraft/hbc2-ide/kicad/registers/hbc2_registers.kicad_sch

## KiCad design kicad/registers/hbc2_registers.kicad_sch (2026-11-14)

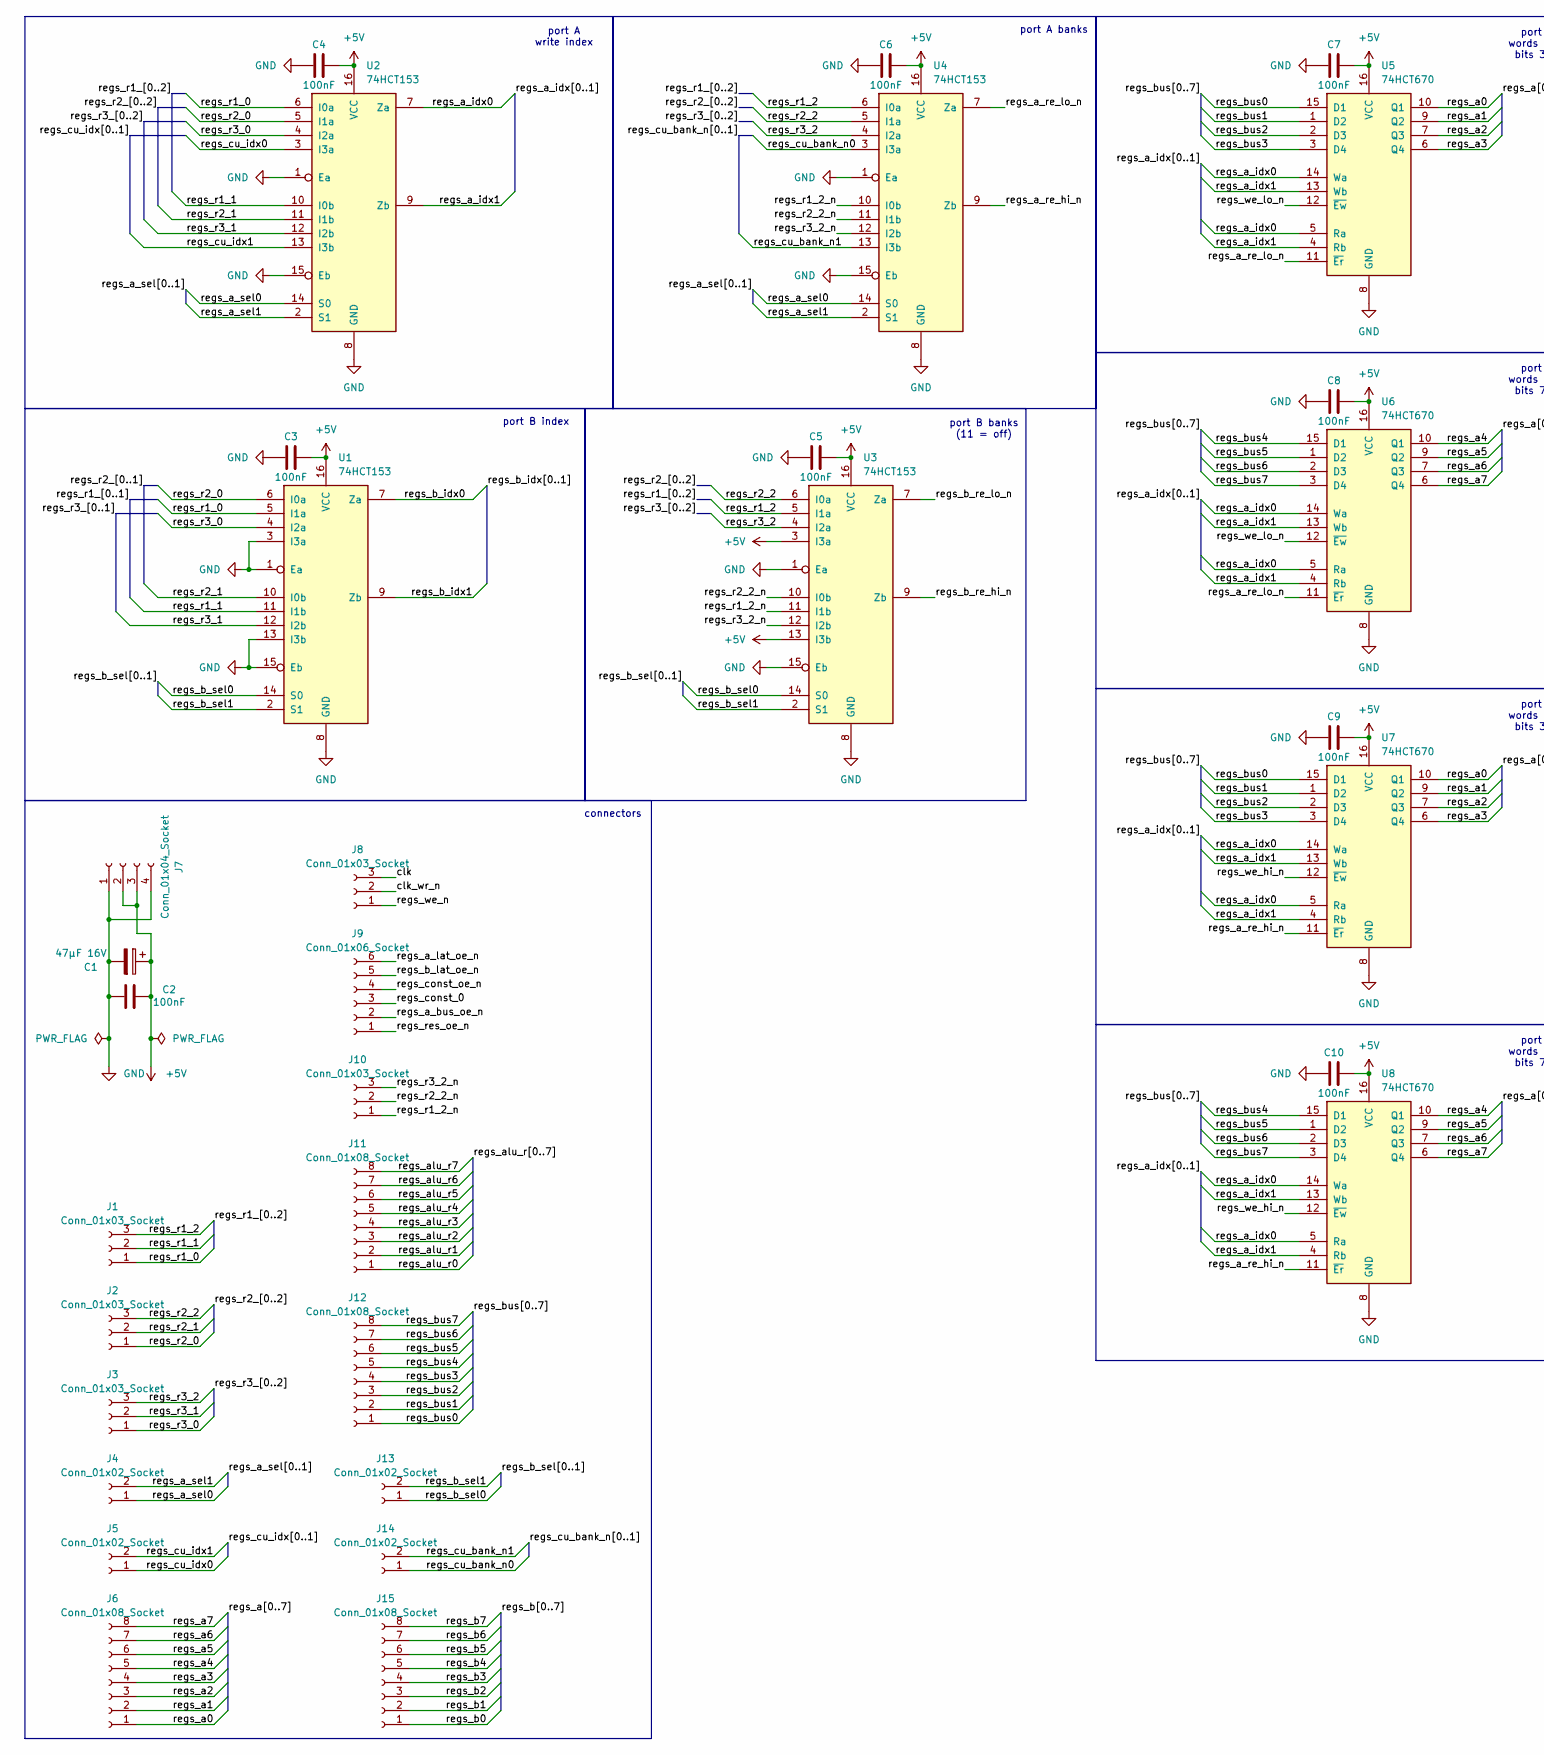
[picture p26: schematic hbc2_registers.kicad_sch, part in row 1, column 1]

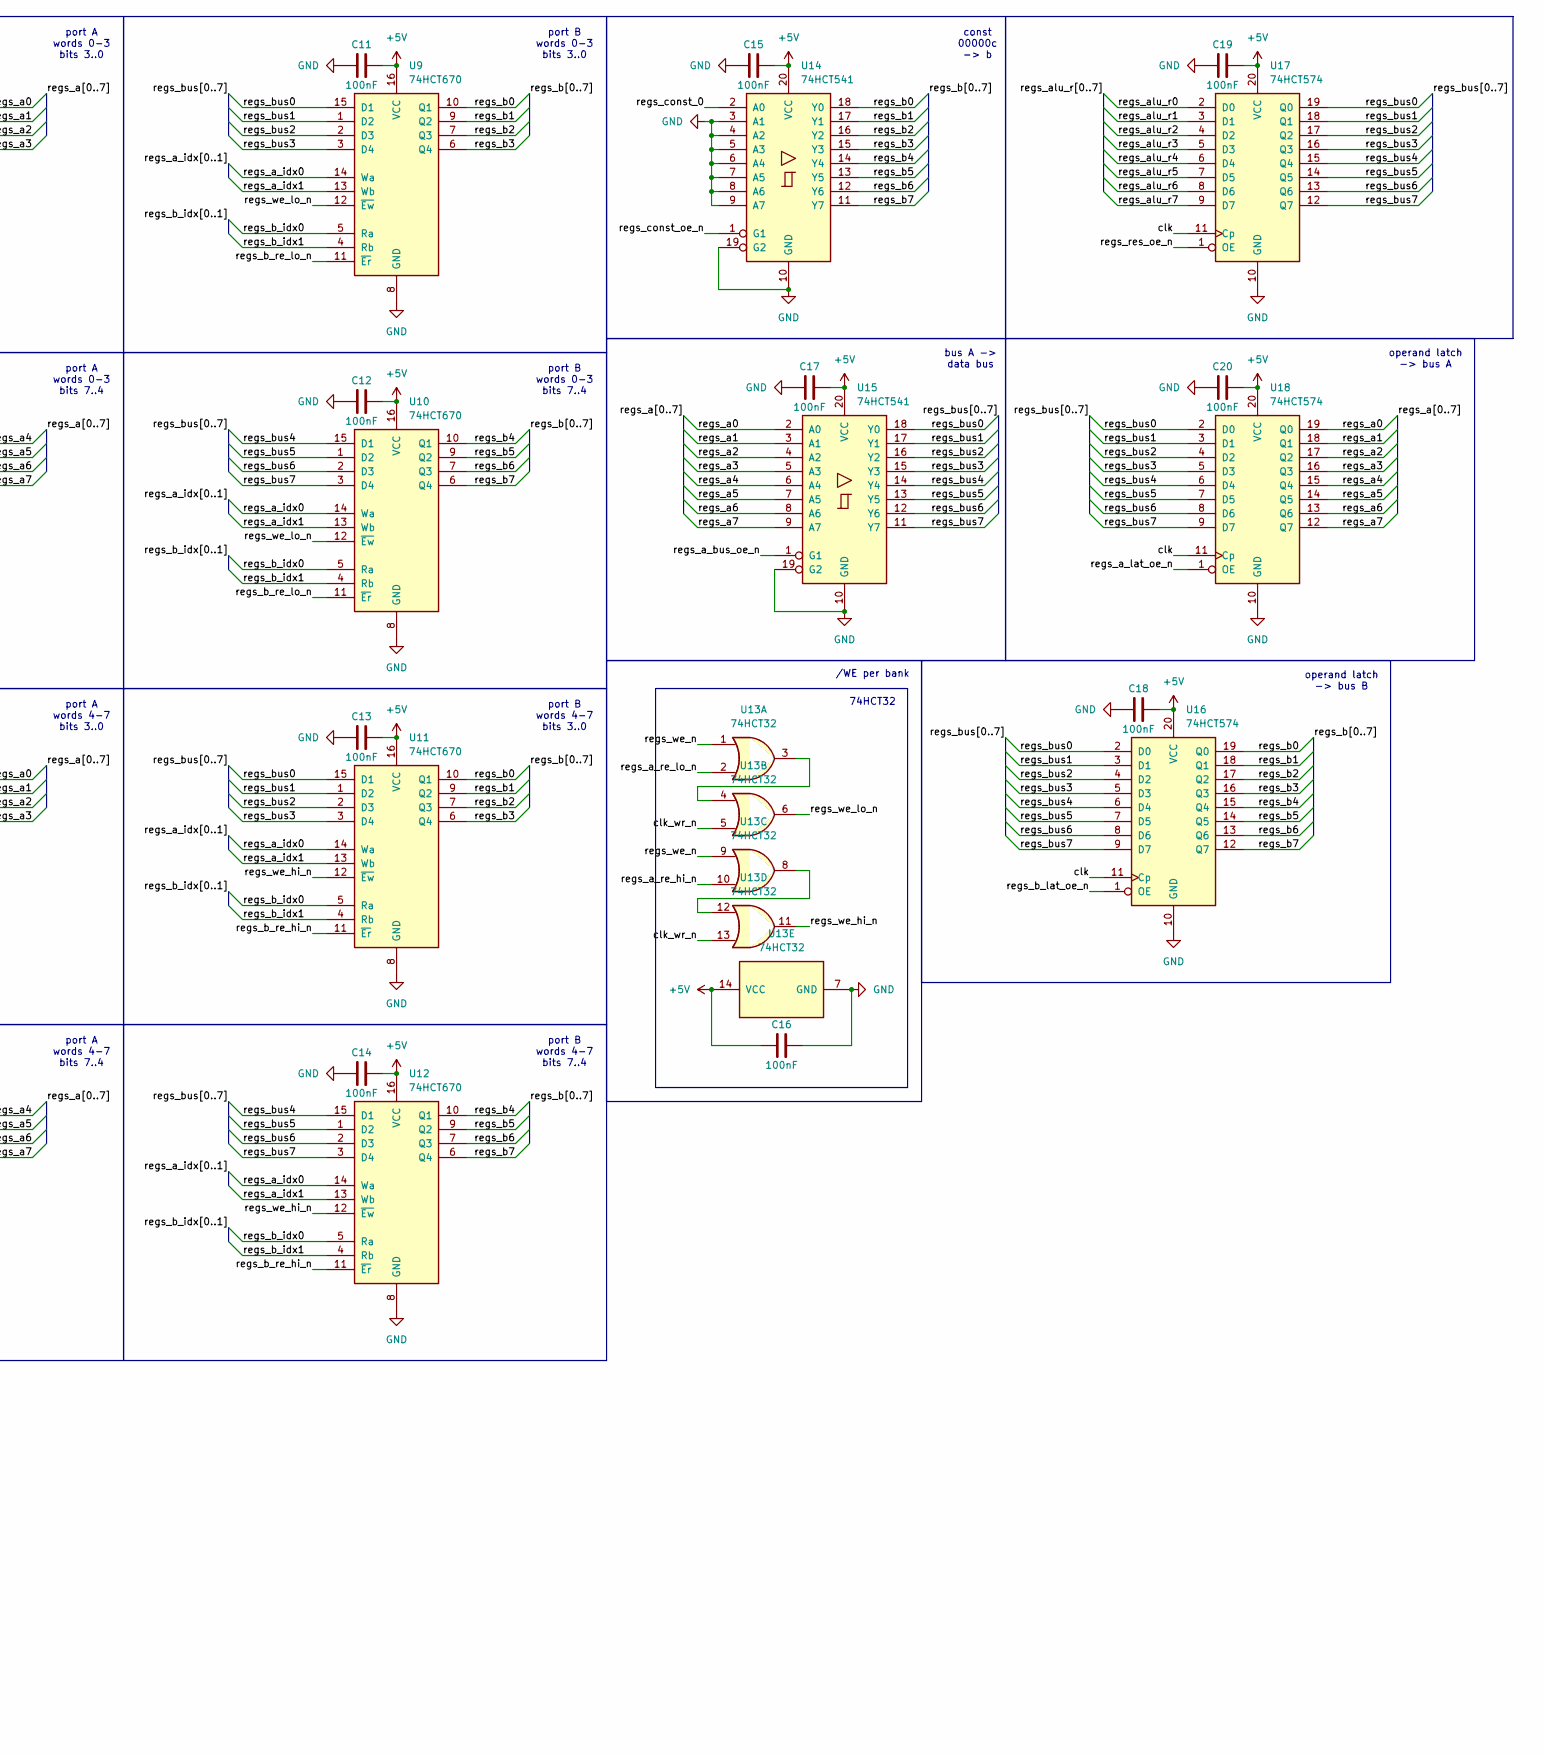
[picture p27: schematic hbc2_registers.kicad_sch, part in row 1, column 2]

Parts:
C1: 47µF 16V
C2, C3, C4, C5, C6, C7, C8, C9, C10, C11, C12, C13, C14, C15, C16, C17, C18, C19, C20: 100nF
J1, J2, J3, J8, J10: Conn_01x03_Socket
J4, J5, J13, J14: Conn_01x02_Socket
J6, J11, J12, J15: Conn_01x08_Socket
J7: Conn_01x04_Socket
J9: Conn_01x06_Socket
U1, U2, U3, U4: 74HCT153
U5, U6, U7, U8, U9, U10, U11, U12: 74HCT670
U13: 74HCT32
U14, U15: 74HCT541
U16, U17, U18: 74HCT574

Connections:
+5V: C1.1, C2.2, C3.2, C4.2, C5.2, C6.2, C7.2, C8.2, C9.2, C10.2, C11.2, C12.2, C13.2, C14.2, C15.2, C16.1, C17.2, C18.2, C19.2, C20.2, J7.2, J7.3, U1.16 (VCC), U2.16 (VCC), U3.3 (I3a), U3.13 (I3b), U3.16 (VCC), U4.16 (VCC), U5.16 (VCC), U6.16 (VCC), U7.16 (VCC), U8.16 (VCC), U9.16 (VCC), U10.16 (VCC), U11.16 (VCC), U12.16 (VCC), U13.14 (VCC), U14.20 (VCC), U15.20 (VCC), U16.20 (VCC), U17.20 (VCC), U18.20 (VCC)
GND: C1.2, C2.1, C3.1, C4.1, C5.1, C6.1, C7.1, C8.1, C9.1, C10.1, C11.1, C12.1, C13.1, C14.1, C15.1, C16.2, C17.1, C18.1, C19.1, C20.1, J7.1, J7.4, U1.1 (Ea), U1.3 (I3a), U1.8 (GND), U1.13 (I3b), U1.15 (Eb), U2.1 (Ea), U2.8 (GND), U2.15 (Eb), U3.1 (Ea), U3.8 (GND), U3.15 (Eb), U4.1 (Ea), U4.8 (GND), U4.15 (Eb), U5.8 (GND), U6.8 (GND), U7.8 (GND), U8.8 (GND), U9.8 (GND), U10.8 (GND), U11.8 (GND), U12.8 (GND), U13.7 (GND), U14.3 (A1), U14.4 (A2), U14.5 (A3), U14.6 (A4), U14.7 (A5), U14.8 (A6), U14.9 (A7), U14.10 (GND), U14.19 (G2), U15.10 (GND), U15.19 (G2), U16.10 (GND), U17.10 (GND), U18.10 (GND)
unnamed: U13.3, U13.4
unnamed: U13.8, U13.12
clk: J8.3, U16.11 (Cp), U17.11 (Cp), U18.11 (Cp)
clk_wr_n: J8.2, U13.5, U13.13
regs_a0: J6.1, U5.10 (Q1), U7.10 (Q1), U15.2 (A0), U18.19 (Q0)
regs_a1: J6.2, U5.9 (Q2), U7.9 (Q2), U15.3 (A1), U18.18 (Q1)
regs_a2: J6.3, U5.7 (Q3), U7.7 (Q3), U15.4 (A2), U18.17 (Q2)
regs_a3: J6.4, U5.6 (Q4), U7.6 (Q4), U15.5 (A3), U18.16 (Q3)
regs_a4: J6.5, U6.10 (Q1), U8.10 (Q1), U15.6 (A4), U18.15 (Q4)
regs_a5: J6.6, U6.9 (Q2), U8.9 (Q2), U15.7 (A5), U18.14 (Q5)
regs_a6: J6.7, U6.7 (Q3), U8.7 (Q3), U15.8 (A6), U18.13 (Q6)
regs_a7: J6.8, U6.6 (Q4), U8.6 (Q4), U15.9 (A7), U18.12 (Q7)
regs_a_bus_oe_n: J9.2, U15.1 (G1)
regs_a_idx0: U2.7 (Za), U5.5 (Ra), U5.14 (Wa), U6.5 (Ra), U6.14 (Wa), U7.5 (Ra), U7.14 (Wa), U8.5 (Ra), U8.14 (Wa), U9.14 (Wa), U10.14 (Wa), U11.14 (Wa), U12.14 (Wa)
regs_a_idx1: U2.9 (Zb), U5.4 (Rb), U5.13 (Wb), U6.4 (Rb), U6.13 (Wb), U7.4 (Rb), U7.13 (Wb), U8.4 (Rb), U8.13 (Wb), U9.13 (Wb), U10.13 (Wb), U11.13 (Wb), U12.13 (Wb)
regs_a_lat_oe_n: J9.6, U18.1 (OE)
regs_a_re_hi_n: U4.9 (Zb), U7.11 (~Er), U8.11 (~Er), U13.10
regs_a_re_lo_n: U4.7 (Za), U5.11 (~Er), U6.11 (~Er), U13.2
regs_a_sel0: J4.1, U2.14 (S0), U4.14 (S0)
regs_a_sel1: J4.2, U2.2 (S1), U4.2 (S1)
regs_alu_r0: J11.1, U17.2 (D0)
regs_alu_r1: J11.2, U17.3 (D1)
regs_alu_r2: J11.3, U17.4 (D2)
regs_alu_r3: J11.4, U17.5 (D3)
regs_alu_r4: J11.5, U17.6 (D4)
regs_alu_r5: J11.6, U17.7 (D5)
regs_alu_r6: J11.7, U17.8 (D6)
regs_alu_r7: J11.8, U17.9 (D7)
regs_b0: J15.1, U9.10 (Q1), U11.10 (Q1), U14.18 (Y0), U16.19 (Q0)
regs_b1: J15.2, U9.9 (Q2), U11.9 (Q2), U14.17 (Y1), U16.18 (Q1)
regs_b2: J15.3, U9.7 (Q3), U11.7 (Q3), U14.16 (Y2), U16.17 (Q2)
regs_b3: J15.4, U9.6 (Q4), U11.6 (Q4), U14.15 (Y3), U16.16 (Q3)
regs_b4: J15.5, U10.10 (Q1), U12.10 (Q1), U14.14 (Y4), U16.15 (Q4)
regs_b5: J15.6, U10.9 (Q2), U12.9 (Q2), U14.13 (Y5), U16.14 (Q5)
regs_b6: J15.7, U10.7 (Q3), U12.7 (Q3), U14.12 (Y6), U16.13 (Q6)
regs_b7: J15.8, U10.6 (Q4), U12.6 (Q4), U14.11 (Y7), U16.12 (Q7)
regs_b_idx0: U1.7 (Za), U9.5 (Ra), U10.5 (Ra), U11.5 (Ra), U12.5 (Ra)
regs_b_idx1: U1.9 (Zb), U9.4 (Rb), U10.4 (Rb), U11.4 (Rb), U12.4 (Rb)
regs_b_lat_oe_n: J9.5, U16.1 (OE)
regs_b_re_hi_n: U3.9 (Zb), U11.11 (~Er), U12.11 (~Er)
regs_b_re_lo_n: U3.7 (Za), U9.11 (~Er), U10.11 (~Er)
regs_b_sel0: J13.1, U1.14 (S0), U3.14 (S0)
regs_b_sel1: J13.2, U1.2 (S1), U3.2 (S1)
regs_bus0: J12.1, U5.15 (D1), U7.15 (D1), U9.15 (D1), U11.15 (D1), U15.18 (Y0), U16.2 (D0), U17.19 (Q0), U18.2 (D0)
regs_bus1: J12.2, U5.1 (D2), U7.1 (D2), U9.1 (D2), U11.1 (D2), U15.17 (Y1), U16.3 (D1), U17.18 (Q1), U18.3 (D1)
regs_bus2: J12.3, U5.2 (D3), U7.2 (D3), U9.2 (D3), U11.2 (D3), U15.16 (Y2), U16.4 (D2), U17.17 (Q2), U18.4 (D2)
regs_bus3: J12.4, U5.3 (D4), U7.3 (D4), U9.3 (D4), U11.3 (D4), U15.15 (Y3), U16.5 (D3), U17.16 (Q3), U18.5 (D3)
regs_bus4: J12.5, U6.15 (D1), U8.15 (D1), U10.15 (D1), U12.15 (D1), U15.14 (Y4), U16.6 (D4), U17.15 (Q4), U18.6 (D4)
regs_bus5: J12.6, U6.1 (D2), U8.1 (D2), U10.1 (D2), U12.1 (D2), U15.13 (Y5), U16.7 (D5), U17.14 (Q5), U18.7 (D5)
regs_bus6: J12.7, U6.2 (D3), U8.2 (D3), U10.2 (D3), U12.2 (D3), U15.12 (Y6), U16.8 (D6), U17.13 (Q6), U18.8 (D6)
regs_bus7: J12.8, U6.3 (D4), U8.3 (D4), U10.3 (D4), U12.3 (D4), U15.11 (Y7), U16.9 (D7), U17.12 (Q7), U18.9 (D7)
regs_const_0: J9.3, U14.2 (A0)
regs_const_oe_n: J9.4, U14.1 (G1)
regs_cu_bank_n0: J14.1, U4.3 (I3a)
regs_cu_bank_n1: J14.2, U4.13 (I3b)
regs_cu_idx0: J5.1, U2.3 (I3a)
regs_cu_idx1: J5.2, U2.13 (I3b)
regs_r1_0: J1.1, U1.5 (I1a), U2.6 (I0a)
regs_r1_1: J1.2, U1.11 (I1b), U2.10 (I0b)
regs_r1_2: J1.3, U3.5 (I1a), U4.6 (I0a)
regs_r1_2_n: J10.1, U3.11 (I1b), U4.10 (I0b)
regs_r2_0: J2.1, U1.6 (I0a), U2.5 (I1a)
regs_r2_1: J2.2, U1.10 (I0b), U2.11 (I1b)
regs_r2_2: J2.3, U3.6 (I0a), U4.5 (I1a)
regs_r2_2_n: J10.2, U3.10 (I0b), U4.11 (I1b)
regs_r3_0: J3.1, U1.4 (I2a), U2.4 (I2a)
regs_r3_1: J3.2, U1.12 (I2b), U2.12 (I2b)
regs_r3_2: J3.3, U3.4 (I2a), U4.4 (I2a)
regs_r3_2_n: J10.3, U3.12 (I2b), U4.12 (I2b)
regs_res_oe_n: J9.1, U17.1 (OE)
regs_we_hi_n: U7.12 (~Ew), U8.12 (~Ew), U11.12 (~Ew), U12.12 (~Ew), U13.11
regs_we_lo_n: U5.12 (~Ew), U6.12 (~Ew), U9.12 (~Ew), U10.12 (~Ew), U13.6
regs_we_n: J8.1, U13.1, U13.9

Notes on the sheet:
port B words 0-3 bits 3..0
port A words 0-3 bits 7..4
operand latch -> bus B
port B banks (11 = off)
port B index
port A write index
bus A -> data bus
port B words 4-7 bits 7..4
port A banks
74HCT32
port B words 4-7 bits 3..0
/WE per bank
operand latch -> bus A
port A words 4-7 bits 7..4
port A words 0-3 bits 3..0
port A words 4-7 bits 3..0
connectors
port B words 0-3 bits 7..4
const 00000c -> b
