SteriCraft/hbc2-ide/kicad/cu/clkgen/hbc2_clkgen.kicad_sch

## KiCad design kicad/cu/clkgen/hbc2_clkgen.kicad_sch (2026-11-14)

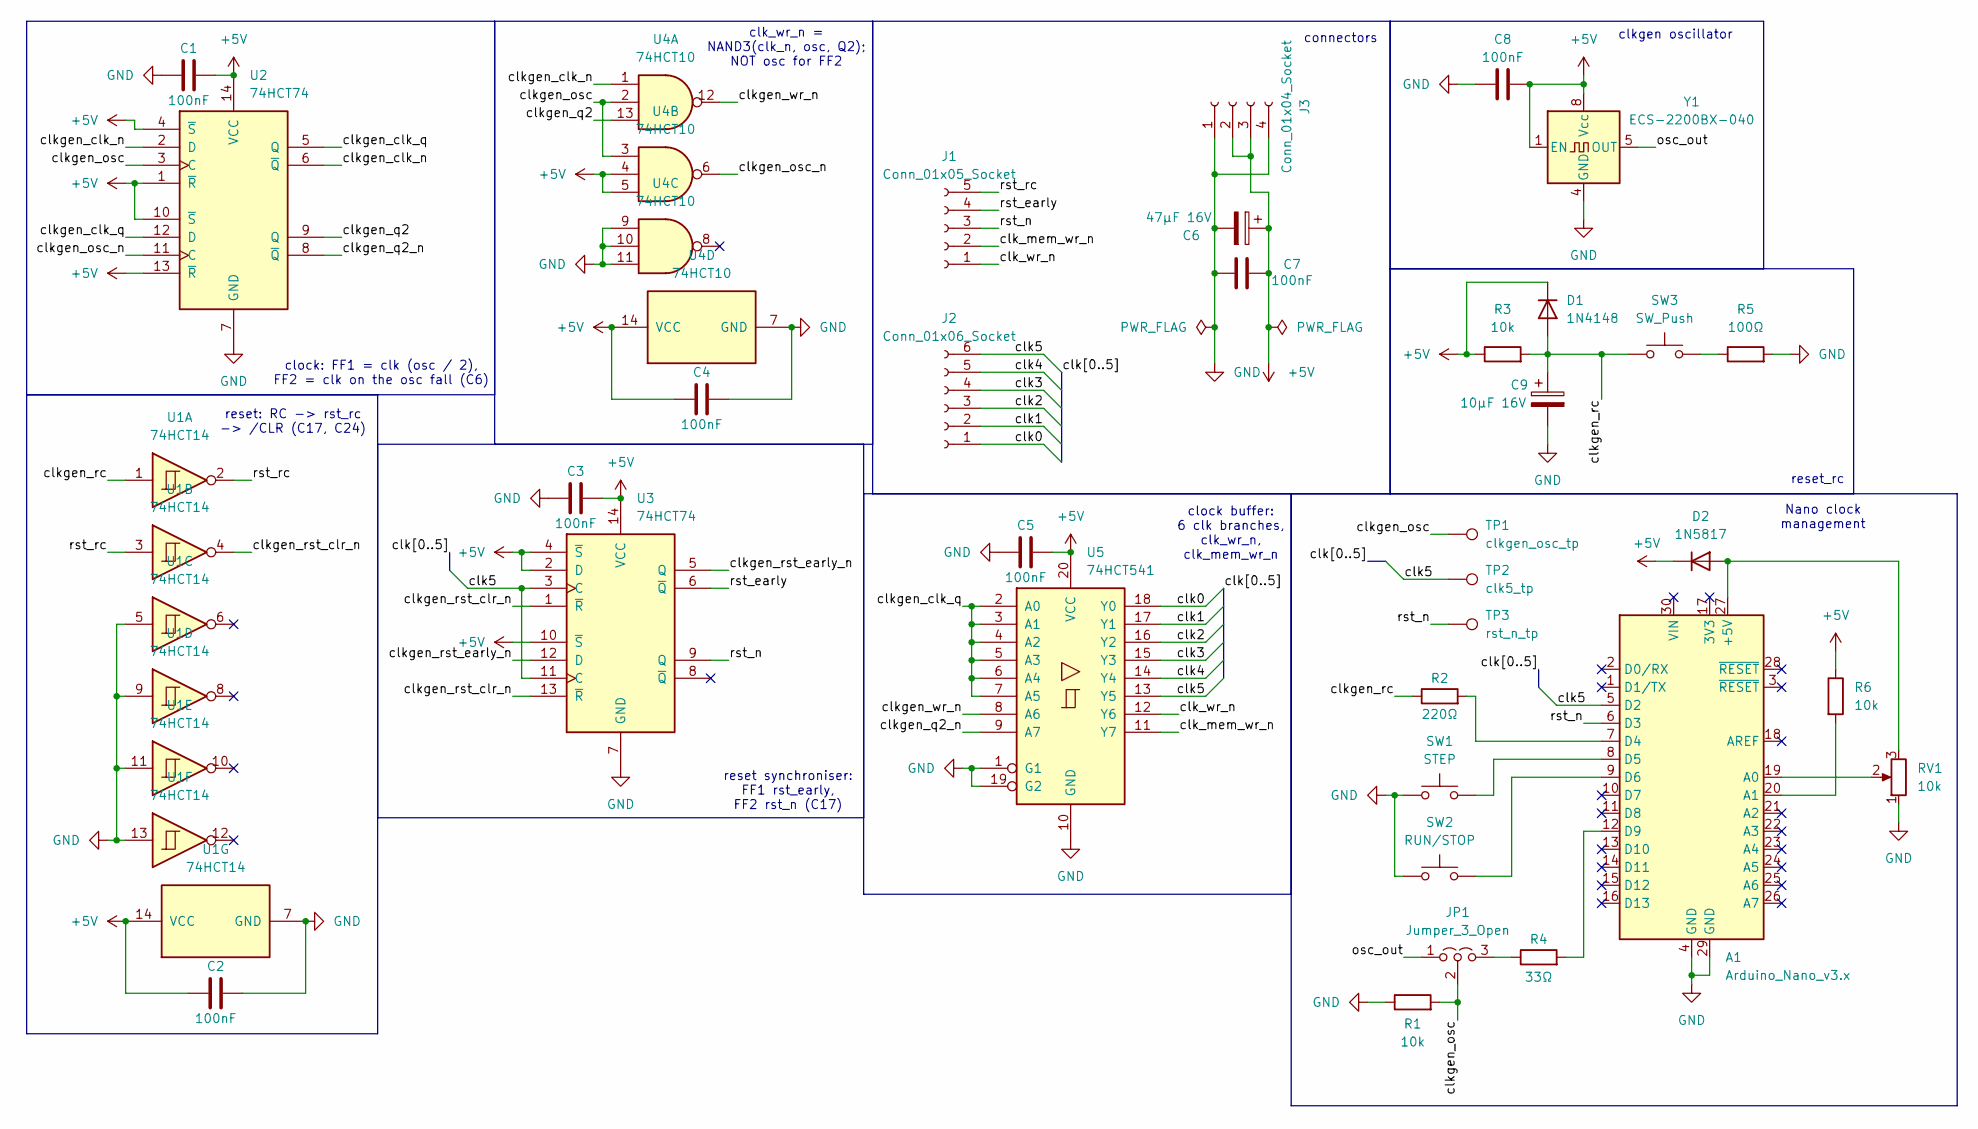
[picture p28: schematic hbc2_clkgen.kicad_sch]

Parts:
A1: Arduino_Nano_v3.x; Arduino_Nano
C1, C2, C3, C4, C5, C7, C8: 100nF; C_Disc_D5.0mm_W2.5mm_P2.50mm
C6: 47µF 16V; CP_Radial_D5.0mm_P2.00mm
C9: 10µF 16V
D1: 1N4148; D_DO-35_SOD27_P7.62mm_Horizontal
D2: 1N5817; D_DO-41_SOD81_P10.16mm_Horizontal
J1: Conn_01x05_Socket; PinSocket_1x05_P2.54mm_Vertical
J2: Conn_01x06_Socket; PinSocket_1x06_P2.54mm_Vertical
J3: Conn_01x04_Socket
JP1: Jumper_3_Open; PinHeader_1x03_P2.54mm_Vertical
R1, R3, R6: 10k; R_Axial_DIN0207_L6.3mm_D2.5mm_P10.16mm_Horizontal
R2: 220Ω; R_Axial_DIN0207_L6.3mm_D2.5mm_P10.16mm_Horizontal
R4: 33Ω; R_Axial_DIN0207_L6.3mm_D2.5mm_P10.16mm_Horizontal
R5: 100Ω; R_Axial_DIN0207_L6.3mm_D2.5mm_P10.16mm_Horizontal
RV1: 10k; Potentiometer_Alps_RK09K_Single_Vertical
SW1: STEP; SW_PUSH_6mm
SW2: RUN/STOP; SW_PUSH_6mm
SW3: SW_Push; SW_PUSH_6mm
TP1: clkgen_osc_tp; TestPoint_THTPad_D1.5mm_Drill0.7mm
TP2: clk5_tp; TestPoint_THTPad_D1.5mm_Drill0.7mm
TP3: rst_n_tp; TestPoint_THTPad_D1.5mm_Drill0.7mm
U1: 74HCT14; DIP-14_W7.62mm_Socket
U2, U3: 74HCT74; DIP-14_W7.62mm_Socket
U4: 74HCT10; DIP-14_W7.62mm_Socket
U5: 74HCT541; DIP-20_W7.62mm_Socket
Y1: ECS-2200BX-040; Oscillator_DIP-8

Connections:
+5V: C1.2, C2.1, C3.2, C4.1, C5.2, C6.1, C7.2, C8.2, D1.1 (K), D2.1 (K), J3.2, J3.3, R3.1, R6.1, U1.14 (VCC), U2.1 (~R), U2.4 (~S), U2.10 (~S), U2.13 (~R), U2.14 (VCC), U3.2 (D), U3.4 (~S), U3.10 (~S), U3.14 (VCC), U4.4, U4.5, U4.14 (VCC), U5.20 (VCC), Y1.1 (EN), Y1.8 (Vcc)
GND: A1.4 (GND), A1.29 (GND), C1.1, C2.2, C3.1, C4.2, C5.1, C6.2, C7.1, C8.1, C9.2, J3.1, J3.4, R1.1, R5.2, RV1.1, SW1.1, SW2.1, U1.5, U1.7 (GND), U1.9, U1.11, U1.13, U2.7 (GND), U3.7 (GND), U4.7 (GND), U4.9, U4.10, U4.11, U5.1 (G1), U5.10 (GND), U5.19 (G2), Y1.4 (GND)
unnamed: A1.7 (D4), R2.2
unnamed: A1.8 (D5), SW1.2
unnamed: A1.9 (D6), SW2.2
unnamed: A1.12 (D9), R4.2
unnamed: A1.19 (A0), RV1.2
unnamed: A1.20 (A1), R6.2
unnamed: A1.27 (+5V), D2.2 (A), RV1.3
unnamed: JP1.3 (B), R4.1
unnamed: R5.1, SW3.2
clk0: J2.1, U5.18 (Y0)
clk1: J2.2, U5.17 (Y1)
clk2: J2.3, U5.16 (Y2)
clk3: J2.4, U5.15 (Y3)
clk4: J2.5, U5.14 (Y4)
clk5: A1.5 (D2), J2.6, TP2.1, U3.3 (C), U3.11 (C), U5.13 (Y5)
clk_mem_wr_n: J1.2, U5.11 (Y7)
clk_wr_n: J1.1, U5.12 (Y6)
clkgen_clk_n: U2.2 (D), U2.6 (~Q), U4.1
clkgen_clk_q: U2.5 (Q), U2.12 (D), U5.2 (A0), U5.3 (A1), U5.4 (A2), U5.5 (A3), U5.6 (A4), U5.7 (A5)
clkgen_osc: JP1.2 (C), R1.2, TP1.1, U2.3 (C), U4.2, U4.3
clkgen_osc_n: U2.11 (C), U4.6
clkgen_q2: U2.9 (Q), U4.13
clkgen_q2_n: U2.8 (~Q), U5.9 (A7)
clkgen_rc: C9.1, D1.2 (A), R2.1, R3.2, SW3.1, U1.1
clkgen_rst_clr_n: U1.4, U3.1 (~R), U3.13 (~R)
clkgen_rst_early_n: U3.5 (Q), U3.12 (D)
clkgen_wr_n: U4.12, U5.8 (A6)
osc_out: JP1.1 (A), Y1.5 (OUT)
rst_early: J1.4, U3.6 (~Q)
rst_n: A1.6 (D3), J1.3, TP3.1, U3.9 (Q)
rst_rc: J1.5, U1.2, U1.3

Notes on the sheet:
clock buffer: 6 clk branches, clk_wr_n, clk_mem_wr_n
clock: FF1 = clk (osc / 2), FF2 = clk on the osc fall (C6)
clk_wr_n = NAND3(clk_n, osc, Q2); NOT osc for FF2
reset synchroniser: FF1 rst_early, FF2 rst_n (C17)
connectors
Nano clock management
reset_rc
reset: RC -> rst_rc -> /CLR (C17, C24)
clkgen oscillator
