SteriCraft/hbc2-ide/kicad/cu/ctrl_unit/hbc_ctrl_unit.kicad_sch

## KiCad design kicad/cu/ctrl_unit/hbc_ctrl_unit.kicad_sch (2026-11-14)

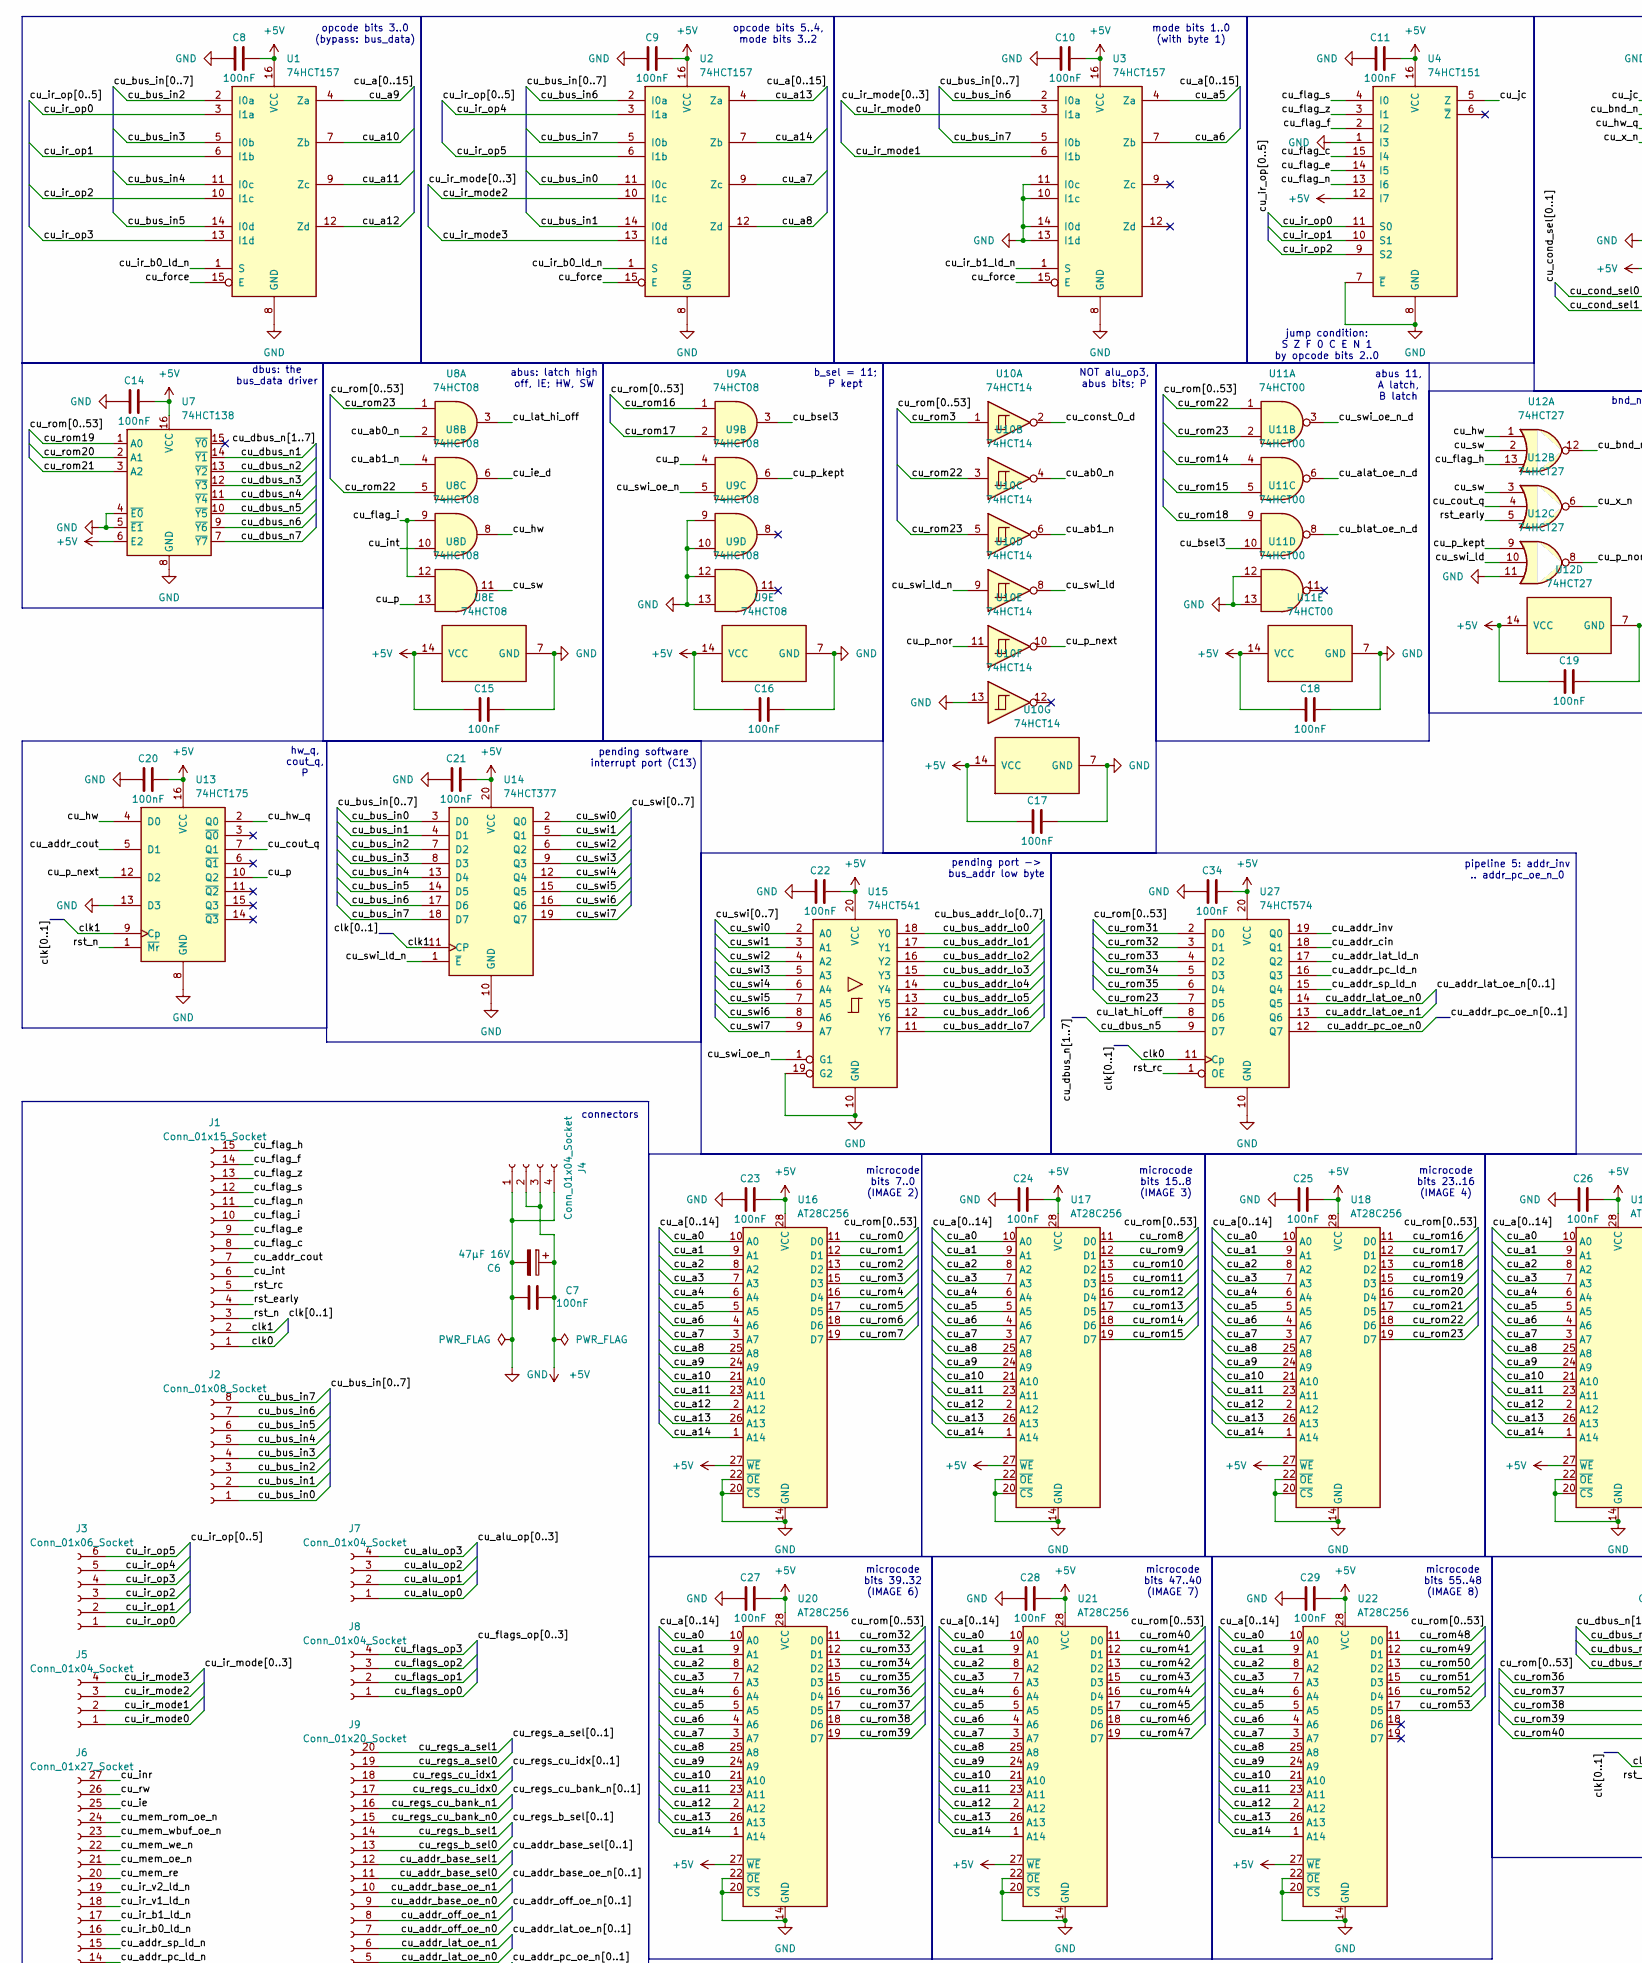
[picture p29: schematic hbc_ctrl_unit.kicad_sch, part in row 1, column 1]

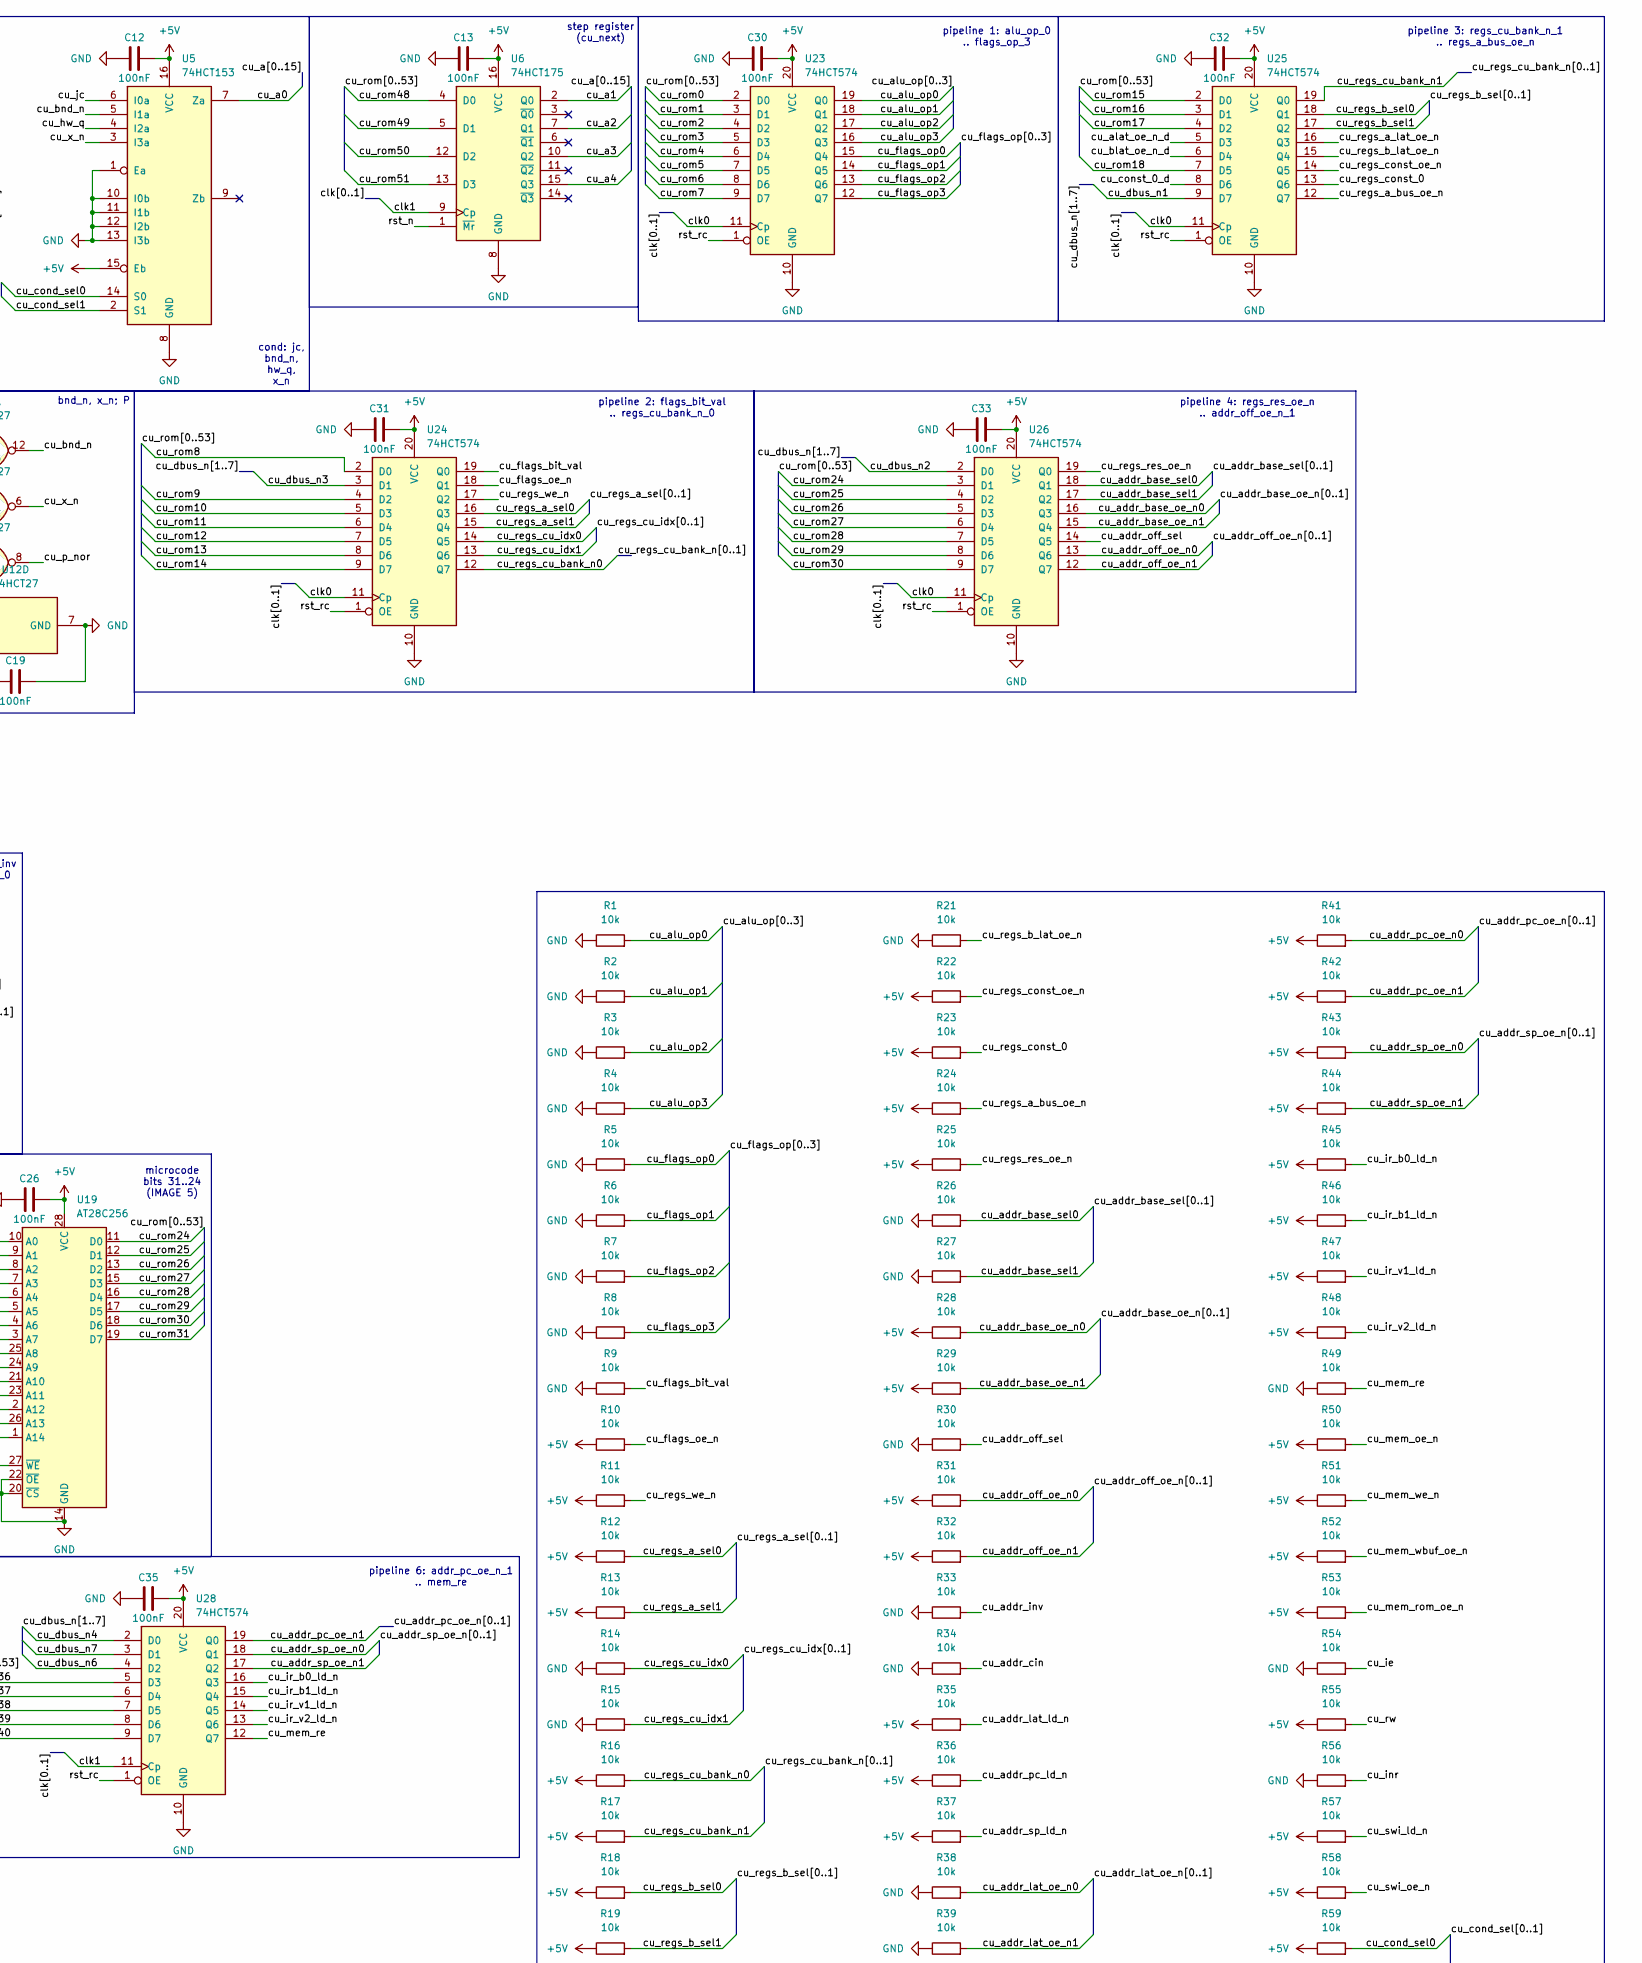
[picture p30: schematic hbc_ctrl_unit.kicad_sch, part in row 1, column 2]

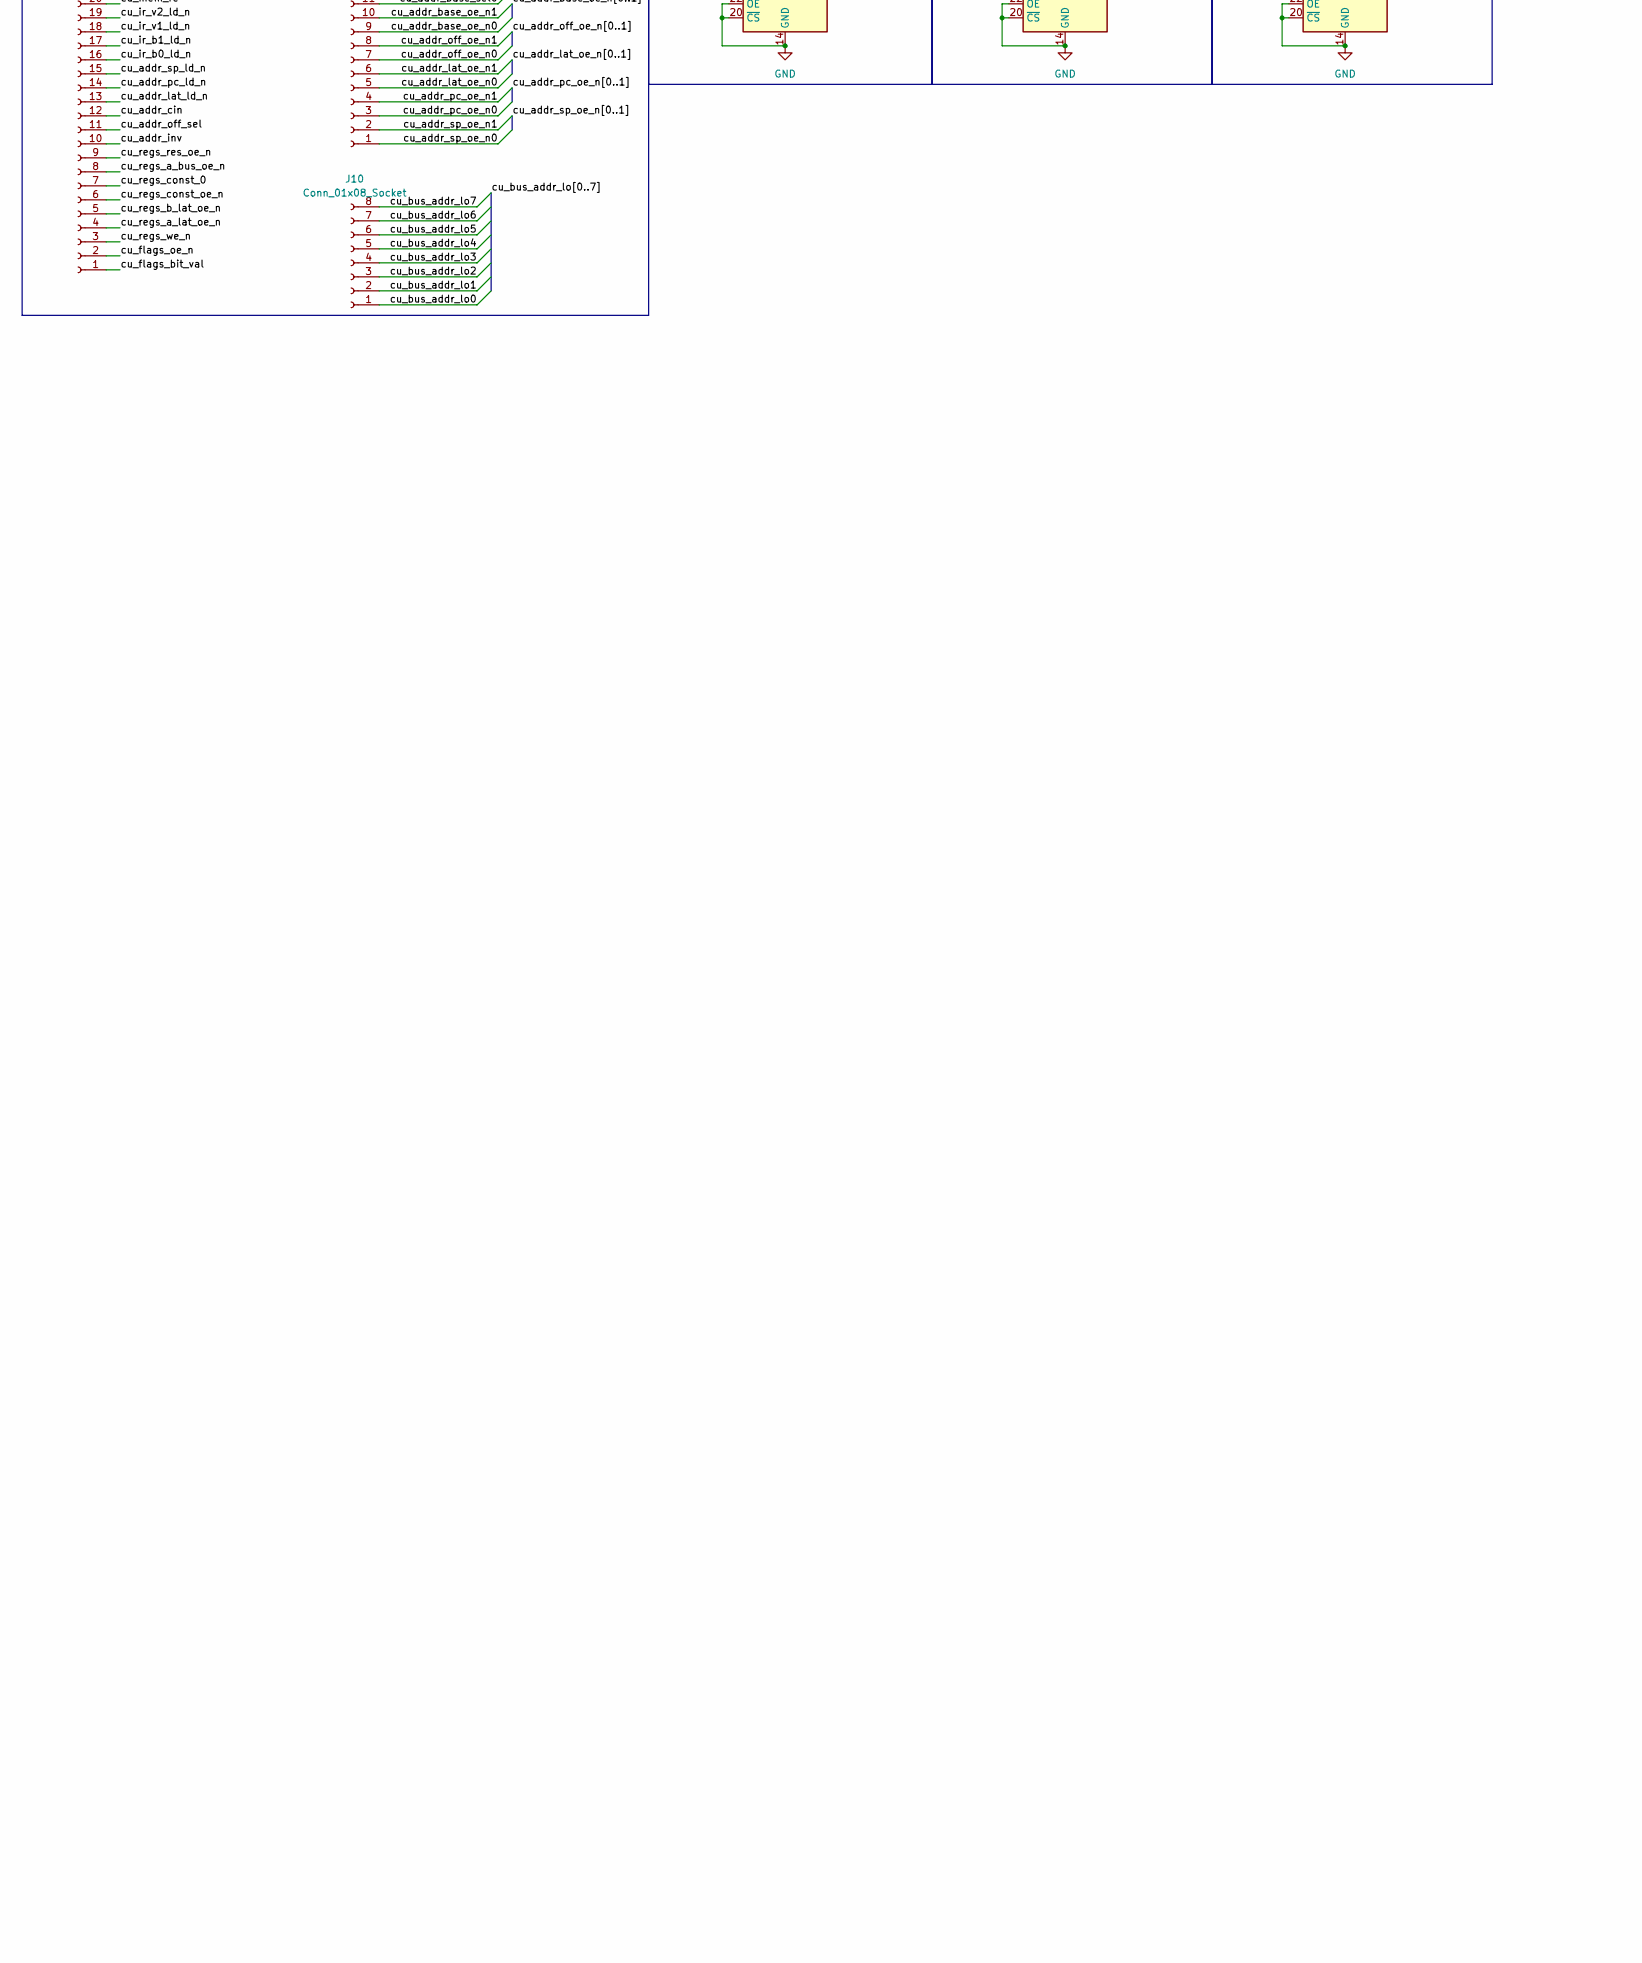
[picture p31: schematic hbc_ctrl_unit.kicad_sch, part in row 2, column 1]

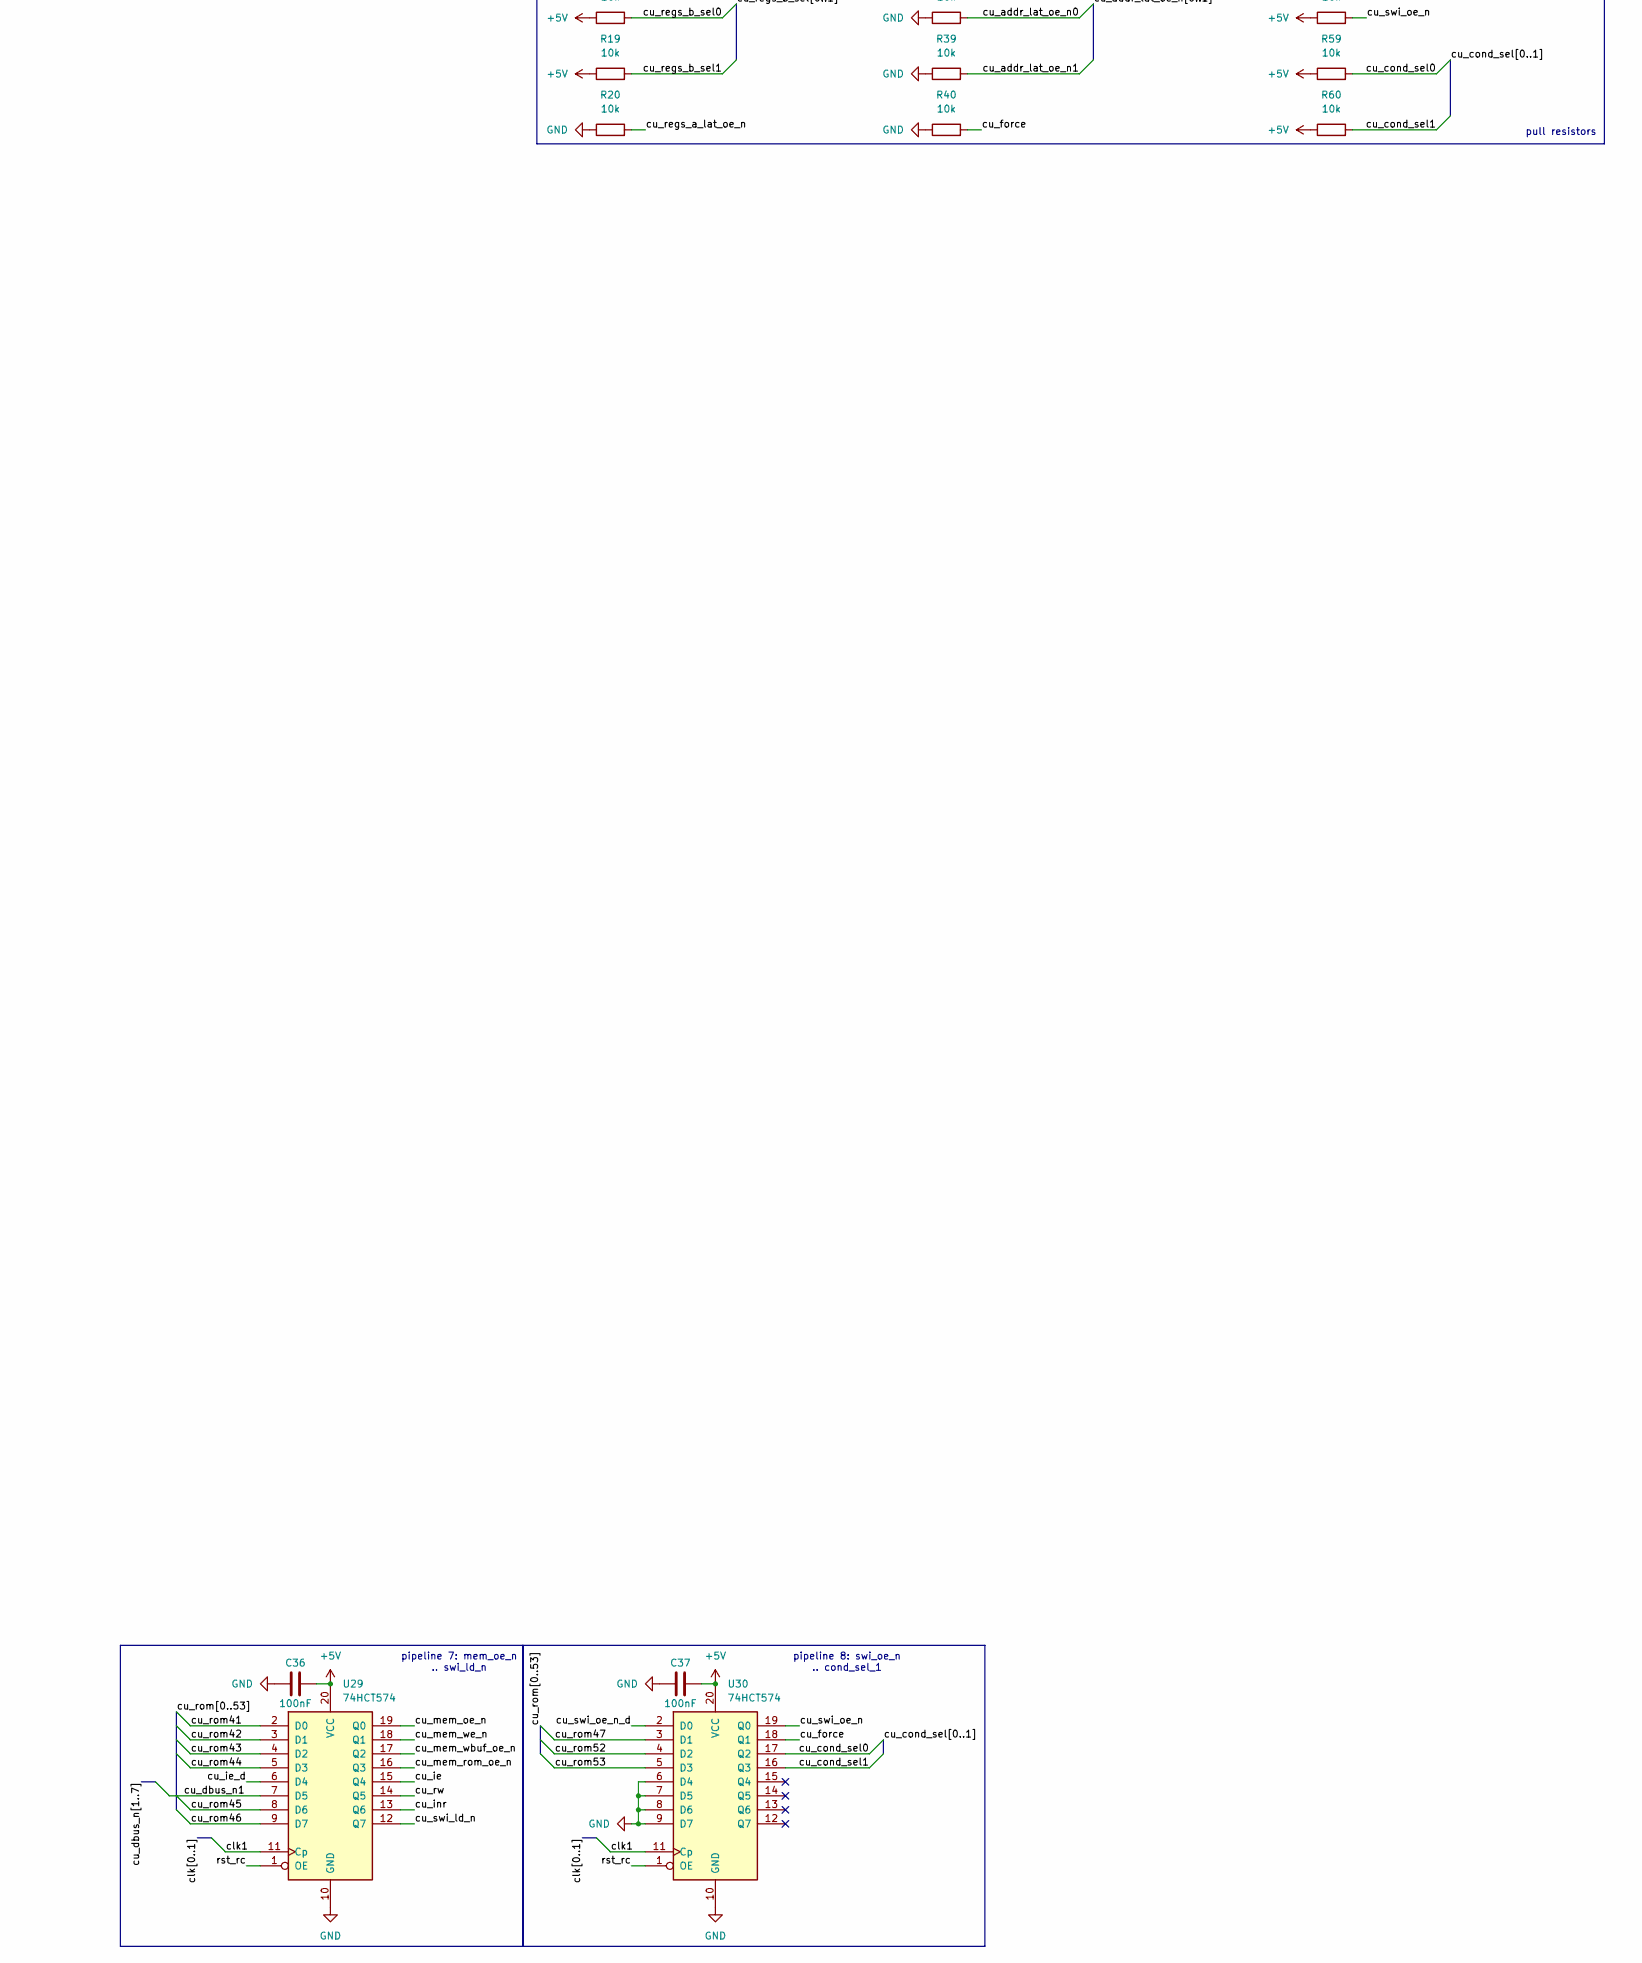
[picture p32: schematic hbc_ctrl_unit.kicad_sch, part in row 2, column 2]

Parts:
C6: 47µF 16V
C7, C8, C9, C10, C11, C12, C13, C14, C15, C16, C17, C18, C19, C20, C21, C22, C23, C24, C25, C26, C27, C28, C29, C30, C31, C32, C33, C34, C35, C36, C37: 100nF
J1: Conn_01x15_Socket
J2, J10: Conn_01x08_Socket
J3: Conn_01x06_Socket
J4, J5, J7, J8: Conn_01x04_Socket
J6: Conn_01x27_Socket
J9: Conn_01x20_Socket
R1, R2, R3, R4, R5, R6, R7, R8, R9, R10, R11, R12, R13, R14, R15, R16, R17, R18, R19, R20, R21, R22, R23, R24, R25, R26, R27, R28, R29, R30, R31, R32, R33, R34, R35, R36, R37, R38, R39, R40, R41, R42, R43, R44, R45, R46, R47, R48, R49, R50, R51, R52, R53, R54, R55, R56, R57, R58, R59, R60: 10k
U1, U2, U3: 74HCT157
U4: 74HCT151
U5: 74HCT153
U6, U13: 74HCT175
U7: 74HCT138
U8, U9: 74HCT08
U10: 74HCT14
U11: 74HCT00
U12: 74HCT27
U14: 74HCT377
U15: 74HCT541
U16, U17, U18, U19, U20, U21, U22: AT28C256
U23, U24, U25, U26, U27, U28, U29, U30: 74HCT574

Connections:
+5V: C6.1, C7.2, C8.2, C9.2, C10.2, C11.2, C12.2, C13.2, C14.2, C15.1, C16.1, C17.1, C18.1, C19.1, C20.2, C21.2, C22.2, C23.2, C24.2, C25.2, C26.2, C27.2, C28.2, C29.2, C30.2, C31.2, C32.2, C33.2, C34.2, C35.2, C36.2, C37.2, J4.2, J4.3, R10.1, R11.1, R12.1, R13.1, R16.1, R17.1, R18.1, R19.1, R22.1, R23.1, R24.1, R25.1, R28.1, R29.1, R31.1, R32.1, R35.1, R36.1, R37.1, R41.1, R42.1, R43.1, R44.1, R45.1, R46.1, R47.1, R48.1, R50.1, R51.1, R52.1, R53.1, R55.1, R57.1, R58.1, R59.1, R60.1, U1.16 (VCC), U2.16 (VCC), U3.16 (VCC), U4.12 (I7), U4.16 (VCC), U5.15 (Eb), U5.16 (VCC), U6.16 (VCC), U7.6 (E2), U7.16 (VCC), U8.14 (VCC), U9.14 (VCC), U10.14 (VCC), U11.14 (VCC), U12.14 (VCC), U13.16 (VCC), U14.20 (VCC), U15.20 (VCC), U16.27 (~WE), U16.28 (VCC), U17.27 (~WE), U17.28 (VCC), U18.27 (~WE), U18.28 (VCC), U19.27 (~WE), U19.28 (VCC), U20.27 (~WE), U20.28 (VCC), U21.27 (~WE), U21.28 (VCC), U22.27 (~WE), U22.28 (VCC), U23.20 (VCC), U24.20 (VCC), U25.20 (VCC), U26.20 (VCC), U27.20 (VCC), U28.20 (VCC), U29.20 (VCC), U30.20 (VCC)
GND: C6.2, C7.1, C8.1, C9.1, C10.1, C11.1, C12.1, C13.1, C14.1, C15.2, C16.2, C17.2, C18.2, C19.2, C20.1, C21.1, C22.1, C23.1, C24.1, C25.1, C26.1, C27.1, C28.1, C29.1, C30.1, C31.1, C32.1, C33.1, C34.1, C35.1, C36.1, C37.1, J4.1, J4.4, R1.1, R2.1, R3.1, R4.1, R5.1, R6.1, R7.1, R8.1, R9.1, R14.1, R15.1, R20.1, R21.1, R26.1, R27.1, R30.1, R33.1, R34.1, R38.1, R39.1, R40.1, R49.1, R54.1, R56.1, U1.8 (GND), U2.8 (GND), U3.8 (GND), U3.10 (I1c), U3.11 (I0c), U3.13 (I1d), U3.14 (I0d), U4.1 (I3), U4.7 (~E), U4.8 (GND), U5.1 (Ea), U5.8 (GND), U5.10 (I0b), U5.11 (I1b), U5.12 (I2b), U5.13 (I3b), U6.8 (GND), U7.4 (~E0), U7.5 (~E1), U7.8 (GND), U8.7 (GND), U9.7 (GND), U9.9, U9.10, U9.12, U9.13, U10.7 (GND), U10.13, U11.7 (GND), U11.12, U11.13, U12.7 (GND), U12.11, U13.8 (GND), U13.13 (D3), U14.10 (GND), U15.10 (GND), U15.19 (G2), U16.14 (GND), U16.20 (~CS), U16.22 (~OE), U17.14 (GND), U17.20 (~CS), U17.22 (~OE), U18.14 (GND), U18.20 (~CS), U18.22 (~OE), U19.14 (GND), U19.20 (~CS), U19.22 (~OE), U20.14 (GND), U20.20 (~CS), U20.22 (~OE), U21.14 (GND), U21.20 (~CS), U21.22 (~OE), U22.14 (GND), U22.20 (~CS), U22.22 (~OE), U23.10 (GND), U24.10 (GND), U25.10 (GND), U26.10 (GND), U27.10 (GND), U28.10 (GND), U29.10 (GND), U30.6 (D4), U30.7 (D5), U30.8 (D6), U30.9 (D7), U30.10 (GND)
clk0: J1.1, U23.11 (Cp), U24.11 (Cp), U25.11 (Cp), U26.11 (Cp), U27.11 (Cp)
clk1: J1.2, U6.9 (Cp), U13.9 (Cp), U14.11 (CP), U28.11 (Cp), U29.11 (Cp), U30.11 (Cp)
cu_a0: U5.7 (Za), U16.10 (A0), U17.10 (A0), U18.10 (A0), U19.10 (A0), U20.10 (A0), U21.10 (A0), U22.10 (A0)
cu_a1: U6.2 (Q0), U16.9 (A1), U17.9 (A1), U18.9 (A1), U19.9 (A1), U20.9 (A1), U21.9 (A1), U22.9 (A1)
cu_a2: U6.7 (Q1), U16.8 (A2), U17.8 (A2), U18.8 (A2), U19.8 (A2), U20.8 (A2), U21.8 (A2), U22.8 (A2)
cu_a3: U6.10 (Q2), U16.7 (A3), U17.7 (A3), U18.7 (A3), U19.7 (A3), U20.7 (A3), U21.7 (A3), U22.7 (A3)
cu_a4: U6.15 (Q3), U16.6 (A4), U17.6 (A4), U18.6 (A4), U19.6 (A4), U20.6 (A4), U21.6 (A4), U22.6 (A4)
cu_a5: U3.4 (Za), U16.5 (A5), U17.5 (A5), U18.5 (A5), U19.5 (A5), U20.5 (A5), U21.5 (A5), U22.5 (A5)
cu_a6: U3.7 (Zb), U16.4 (A6), U17.4 (A6), U18.4 (A6), U19.4 (A6), U20.4 (A6), U21.4 (A6), U22.4 (A6)
cu_a7: U2.9 (Zc), U16.3 (A7), U17.3 (A7), U18.3 (A7), U19.3 (A7), U20.3 (A7), U21.3 (A7), U22.3 (A7)
cu_a8: U2.12 (Zd), U16.25 (A8), U17.25 (A8), U18.25 (A8), U19.25 (A8), U20.25 (A8), U21.25 (A8), U22.25 (A8)
cu_a9: U1.4 (Za), U16.24 (A9), U17.24 (A9), U18.24 (A9), U19.24 (A9), U20.24 (A9), U21.24 (A9), U22.24 (A9)
cu_a10: U1.7 (Zb), U16.21 (A10), U17.21 (A10), U18.21 (A10), U19.21 (A10), U20.21 (A10), U21.21 (A10), U22.21 (A10)
cu_a11: U1.9 (Zc), U16.23 (A11), U17.23 (A11), U18.23 (A11), U19.23 (A11), U20.23 (A11), U21.23 (A11), U22.23 (A11)
cu_a12: U1.12 (Zd), U16.2 (A12), U17.2 (A12), U18.2 (A12), U19.2 (A12), U20.2 (A12), U21.2 (A12), U22.2 (A12)
cu_a13: U2.4 (Za), U16.26 (A13), U17.26 (A13), U18.26 (A13), U19.26 (A13), U20.26 (A13), U21.26 (A13), U22.26 (A13)
cu_a14: U2.7 (Zb), U16.1 (A14), U17.1 (A14), U18.1 (A14), U19.1 (A14), U20.1 (A14), U21.1 (A14), U22.1 (A14)
cu_ab0_n: U8.2, U10.4
cu_ab1_n: U8.4, U10.6
cu_addr_base_oe_n0: J9.9, R28.2, U26.16 (Q3)
cu_addr_base_oe_n1: J9.10, R29.2, U26.15 (Q4)
cu_addr_base_sel0: J9.11, R26.2, U26.18 (Q1)
cu_addr_base_sel1: J9.12, R27.2, U26.17 (Q2)
cu_addr_cin: J6.12, R34.2, U27.18 (Q1)
cu_addr_cout: J1.7, U13.5 (D1)
cu_addr_inv: J6.10, R33.2, U27.19 (Q0)
cu_addr_lat_ld_n: J6.13, R35.2, U27.17 (Q2)
cu_addr_lat_oe_n0: J9.5, R38.2, U27.14 (Q5)
cu_addr_lat_oe_n1: J9.6, R39.2, U27.13 (Q6)
cu_addr_off_oe_n0: J9.7, R31.2, U26.13 (Q6)
cu_addr_off_oe_n1: J9.8, R32.2, U26.12 (Q7)
cu_addr_off_sel: J6.11, R30.2, U26.14 (Q5)
cu_addr_pc_ld_n: J6.14, R36.2, U27.16 (Q3)
cu_addr_pc_oe_n0: J9.3, R41.2, U27.12 (Q7)
cu_addr_pc_oe_n1: J9.4, R42.2, U28.19 (Q0)
cu_addr_sp_ld_n: J6.15, R37.2, U27.15 (Q4)
cu_addr_sp_oe_n0: J9.1, R43.2, U28.18 (Q1)
cu_addr_sp_oe_n1: J9.2, R44.2, U28.17 (Q2)
cu_alat_oe_n_d: U11.6, U25.5 (D3)
cu_alu_op0: J7.1, R1.2, U23.19 (Q0)
cu_alu_op1: J7.2, R2.2, U23.18 (Q1)
cu_alu_op2: J7.3, R3.2, U23.17 (Q2)
cu_alu_op3: J7.4, R4.2, U23.16 (Q3)
cu_blat_oe_n_d: U11.8, U25.6 (D4)
cu_bnd_n: U5.5 (I1a), U12.12
cu_bsel3: U9.3, U11.10
cu_bus_addr_lo0: J10.1, U15.18 (Y0)
cu_bus_addr_lo1: J10.2, U15.17 (Y1)
cu_bus_addr_lo2: J10.3, U15.16 (Y2)
cu_bus_addr_lo3: J10.4, U15.15 (Y3)
cu_bus_addr_lo4: J10.5, U15.14 (Y4)
cu_bus_addr_lo5: J10.6, U15.13 (Y5)
cu_bus_addr_lo6: J10.7, U15.12 (Y6)
cu_bus_addr_lo7: J10.8, U15.11 (Y7)
cu_bus_in0: J2.1, U2.11 (I0c), U14.3 (D0)
cu_bus_in1: J2.2, U2.14 (I0d), U14.4 (D1)
cu_bus_in2: J2.3, U1.2 (I0a), U14.7 (D2)
cu_bus_in3: J2.4, U1.5 (I0b), U14.8 (D3)
cu_bus_in4: J2.5, U1.11 (I0c), U14.13 (D4)
cu_bus_in5: J2.6, U1.14 (I0d), U14.14 (D5)
cu_bus_in6: J2.7, U2.2 (I0a), U3.2 (I0a), U14.17 (D6)
cu_bus_in7: J2.8, U2.5 (I0b), U3.5 (I0b), U14.18 (D7)
cu_cond_sel0: R59.2, U5.14 (S0), U30.17 (Q2)
cu_cond_sel1: R60.2, U5.2 (S1), U30.16 (Q3)
cu_const_0_d: U10.2, U25.8 (D6)
cu_cout_q: U12.4, U13.7 (Q1)
cu_dbus_n1: U7.14 (~Y1), U25.9 (D7), U29.7 (D5)
cu_dbus_n2: U7.13 (~Y2), U26.2 (D0)
cu_dbus_n3: U7.12 (~Y3), U24.3 (D1)
cu_dbus_n4: U7.11 (~Y4), U28.2 (D0)
cu_dbus_n5: U7.10 (~Y5), U27.9 (D7)
cu_dbus_n6: U7.9 (~Y6), U28.4 (D2)
cu_dbus_n7: U7.7 (~Y7), U28.3 (D1)
cu_flag_c: J1.8, U4.15 (I4)
cu_flag_e: J1.9, U4.14 (I5)
cu_flag_f: J1.14, U4.2 (I2)
cu_flag_h: J1.15, U12.13
cu_flag_i: J1.10, U8.9, U8.12
cu_flag_n: J1.11, U4.13 (I6)
cu_flag_s: J1.12, U4.4 (I0)
cu_flag_z: J1.13, U4.3 (I1)
cu_flags_bit_val: J6.1, R9.2, U24.19 (Q0)
cu_flags_oe_n: J6.2, R10.2, U24.18 (Q1)
cu_flags_op0: J8.1, R5.2, U23.15 (Q4)
cu_flags_op1: J8.2, R6.2, U23.14 (Q5)
cu_flags_op2: J8.3, R7.2, U23.13 (Q6)
cu_flags_op3: J8.4, R8.2, U23.12 (Q7)
cu_force: R40.2, U1.15 (E), U2.15 (E), U3.15 (E), U30.18 (Q1)
cu_hw: U8.8, U12.1, U13.4 (D0)
cu_hw_q: U5.4 (I2a), U13.2 (Q0)
cu_ie: J6.25, R54.2, U29.15 (Q4)
cu_ie_d: U8.6, U29.6 (D4)
cu_inr: J6.27, R56.2, U29.13 (Q6)
cu_int: J1.6, U8.10
cu_ir_b0_ld_n: J6.16, R45.2, U1.1 (S), U2.1 (S), U28.16 (Q3)
cu_ir_b1_ld_n: J6.17, R46.2, U3.1 (S), U28.15 (Q4)
cu_ir_mode0: J5.1, U3.3 (I1a)
cu_ir_mode1: J5.2, U3.6 (I1b)
cu_ir_mode2: J5.3, U2.10 (I1c)
cu_ir_mode3: J5.4, U2.13 (I1d)
cu_ir_op0: J3.1, U1.3 (I1a), U4.11 (S0)
cu_ir_op1: J3.2, U1.6 (I1b), U4.10 (S1)
cu_ir_op2: J3.3, U1.10 (I1c), U4.9 (S2)
cu_ir_op3: J3.4, U1.13 (I1d)
cu_ir_op4: J3.5, U2.3 (I1a)
cu_ir_op5: J3.6, U2.6 (I1b)
cu_ir_v1_ld_n: J6.18, R47.2, U28.14 (Q5)
cu_ir_v2_ld_n: J6.19, R48.2, U28.13 (Q6)
cu_jc: U4.5 (Z), U5.6 (I0a)
cu_lat_hi_off: U8.3, U27.8 (D6)
cu_mem_oe_n: J6.21, R50.2, U29.19 (Q0)
cu_mem_re: J6.20, R49.2, U28.12 (Q7)
cu_mem_rom_oe_n: J6.24, R53.2, U29.16 (Q3)
cu_mem_wbuf_oe_n: J6.23, R52.2, U29.17 (Q2)
cu_mem_we_n: J6.22, R51.2, U29.18 (Q1)
cu_p: U8.13, U9.4, U13.10 (Q2)
cu_p_kept: U9.6, U12.9
cu_p_next: U10.10, U13.12 (D2)
cu_p_nor: U10.11, U12.8
cu_regs_a_bus_oe_n: J6.8, R24.2, U25.12 (Q7)
cu_regs_a_lat_oe_n: J6.4, R20.2, U25.16 (Q3)
cu_regs_a_sel0: J9.19, R12.2, U24.16 (Q3)
cu_regs_a_sel1: J9.20, R13.2, U24.15 (Q4)
cu_regs_b_lat_oe_n: J6.5, R21.2, U25.15 (Q4)
cu_regs_b_sel0: J9.13, R18.2, U25.18 (Q1)
cu_regs_b_sel1: J9.14, R19.2, U25.17 (Q2)
cu_regs_const_0: J6.7, R23.2, U25.13 (Q6)
cu_regs_const_oe_n: J6.6, R22.2, U25.14 (Q5)
cu_regs_cu_bank_n0: J9.15, R16.2, U24.12 (Q7)
cu_regs_cu_bank_n1: J9.16, R17.2, U25.19 (Q0)
cu_regs_cu_idx0: J9.17, R14.2, U24.14 (Q5)
cu_regs_cu_idx1: J9.18, R15.2, U24.13 (Q6)
cu_regs_res_oe_n: J6.9, R25.2, U26.19 (Q0)
cu_regs_we_n: J6.3, R11.2, U24.17 (Q2)
cu_rom0: U16.11 (D0), U23.2 (D0)
cu_rom1: U16.12 (D1), U23.3 (D1)
cu_rom2: U16.13 (D2), U23.4 (D2)
cu_rom3: U10.1, U16.15 (D3), U23.5 (D3)
cu_rom4: U16.16 (D4), U23.6 (D4)
cu_rom5: U16.17 (D5), U23.7 (D5)
cu_rom6: U16.18 (D6), U23.8 (D6)
cu_rom7: U16.19 (D7), U23.9 (D7)
cu_rom8: U17.11 (D0), U24.2 (D0)
cu_rom9: U17.12 (D1), U24.4 (D2)
cu_rom10: U17.13 (D2), U24.5 (D3)
cu_rom11: U17.15 (D3), U24.6 (D4)
cu_rom12: U17.16 (D4), U24.7 (D5)
cu_rom13: U17.17 (D5), U24.8 (D6)
cu_rom14: U11.4, U17.18 (D6), U24.9 (D7)
cu_rom15: U11.5, U17.19 (D7), U25.2 (D0)
cu_rom16: U9.1, U18.11 (D0), U25.3 (D1)
cu_rom17: U9.2, U18.12 (D1), U25.4 (D2)
cu_rom18: U11.9, U18.13 (D2), U25.7 (D5)
cu_rom19: U7.1 (A0), U18.15 (D3)
cu_rom20: U7.2 (A1), U18.16 (D4)
cu_rom21: U7.3 (A2), U18.17 (D5)
cu_rom22: U8.5, U10.3, U11.1, U18.18 (D6)
cu_rom23: U8.1, U10.5, U11.2, U18.19 (D7), U27.7 (D5)
cu_rom24: U19.11 (D0), U26.3 (D1)
cu_rom25: U19.12 (D1), U26.4 (D2)
cu_rom26: U19.13 (D2), U26.5 (D3)
cu_rom27: U19.15 (D3), U26.6 (D4)
cu_rom28: U19.16 (D4), U26.7 (D5)
cu_rom29: U19.17 (D5), U26.8 (D6)
cu_rom30: U19.18 (D6), U26.9 (D7)
cu_rom31: U19.19 (D7), U27.2 (D0)
cu_rom32: U20.11 (D0), U27.3 (D1)
cu_rom33: U20.12 (D1), U27.4 (D2)
cu_rom34: U20.13 (D2), U27.5 (D3)
cu_rom35: U20.15 (D3), U27.6 (D4)
cu_rom36: U20.16 (D4), U28.5 (D3)
cu_rom37: U20.17 (D5), U28.6 (D4)
cu_rom38: U20.18 (D6), U28.7 (D5)
cu_rom39: U20.19 (D7), U28.8 (D6)
cu_rom40: U21.11 (D0), U28.9 (D7)
cu_rom41: U21.12 (D1), U29.2 (D0)
cu_rom42: U21.13 (D2), U29.3 (D1)
cu_rom43: U21.15 (D3), U29.4 (D2)
cu_rom44: U21.16 (D4), U29.5 (D3)
cu_rom45: U21.17 (D5), U29.8 (D6)
cu_rom46: U21.18 (D6), U29.9 (D7)
cu_rom47: U21.19 (D7), U30.3 (D1)
cu_rom48: U6.4 (D0), U22.11 (D0)
cu_rom49: U6.5 (D1), U22.12 (D1)
cu_rom50: U6.12 (D2), U22.13 (D2)
cu_rom51: U6.13 (D3), U22.15 (D3)
cu_rom52: U22.16 (D4), U30.4 (D2)
cu_rom53: U22.17 (D5), U30.5 (D3)
cu_rw: J6.26, R55.2, U29.14 (Q5)
cu_sw: U8.11, U12.2, U12.3
cu_swi0: U14.2 (Q0), U15.2 (A0)
cu_swi1: U14.5 (Q1), U15.3 (A1)
cu_swi2: U14.6 (Q2), U15.4 (A2)
cu_swi3: U14.9 (Q3), U15.5 (A3)
cu_swi4: U14.12 (Q4), U15.6 (A4)
cu_swi5: U14.15 (Q5), U15.7 (A5)
cu_swi6: U14.16 (Q6), U15.8 (A6)
cu_swi7: U14.19 (Q7), U15.9 (A7)
cu_swi_ld: U10.8, U12.10
cu_swi_ld_n: R57.2, U10.9, U14.1 (~E), U29.12 (Q7)
cu_swi_oe_n: R58.2, U9.5, U15.1 (G1), U30.19 (Q0)
cu_swi_oe_n_d: U11.3, U30.2 (D0)
cu_x_n: U5.3 (I3a), U12.6
rst_early: J1.4, U12.5
rst_n: J1.3, U6.1 (~Mr), U13.1 (~Mr)
rst_rc: J1.5, U23.1 (OE), U24.1 (OE), U25.1 (OE), U26.1 (OE), U27.1 (OE), U28.1 (OE), U29.1 (OE), U30.1 (OE)

Notes on the sheet:
pipeline 5: addr_inv .. addr_pc_oe_n_0
pipeline 1: alu_op_0 .. flags_op_3
pipeline 2: flags_bit_val .. regs_cu_bank_n_0
pipeline 7: mem_oe_n .. swi_ld_n
dbus: the bus_data driver
opcode bits 5..4, mode bits 3..2
pipeline 3: regs_cu_bank_n_1 .. regs_a_bus_oe_n
opcode bits 3..0 (bypass: bus_data)
pipeline 6: addr_pc_oe_n_1 .. mem_re
pending port -> bus_addr low byte
cond: jc, bnd_n, hw_q, x_n
microcode bits 47..40 (IMAGE 7)
microcode bits 7..0 (IMAGE 2)
abus: latch high off, IE; HW, SW
abus 11, A latch, B latch
b_sel = 11; P kept
NOT alu_op3, abus bits; P
pull resistors
pipeline 4: regs_res_oe_n .. addr_off_oe_n_1
microcode bits 15..8 (IMAGE 3)
connectors
hw_q, cout_q, P
microcode bits 39..32 (IMAGE 6)
microcode bits 31..24 (IMAGE 5)
mode bits 1..0 (with byte 1)
bnd_n, x_n; P
microcode bits 23..16 (IMAGE 4)
microcode bits 55..48 (IMAGE 8)
jump condition: S Z F 0 C E N 1 by opcode bits 2..0
step register (cu_next)
pending software interrupt port (C13)
pipeline 8: swi_oe_n .. cond_sel_1
