SteriCraft/hbc2-ide/hbc2/crates/hbc2-cli/src/main.rs

//! `hbc2`: command-line tools for the HBC-2. See [`USAGE`].

mod vectors;

use std::path::{Path, PathBuf};
use std::process::ExitCode;
use std::time::{Duration, Instant};

use hbc2_asm::Program;
use hbc2_core::isa::{PROGRAM_START, encode};
use hbc2_core::peripherals::Eeprom;
use hbc2_core::{Flag, Machine, MachineConfig, Opcode, Register, TraceWriter};

const USAGE: &str = "\
usage:
  hbc2 asm <main.has> [-o out.bin] [--boot-rom] [--strip] [--symbols] [--map]
        assemble (64 KiB RAM image); --strip leaves out unreached code
        and data; --boot-rom also writes the RAM image as the hardware
        CPU's boot ROM, one 32 KiB file per AT28C256: out_lo.bin
        (0000-7FFF) and out_hi.bin (8000-FFFF)
  hbc2 cc <file.c | file.has>... [-o out.bin] [--boot-rom] [--dir build] [--symbols] [--map]
        compile C files (with the startup code, runtime and C library) and
        assemble them with the .has files; compiled files go to --dir
        (default: .build next to the first file); unreached code and data
        are left out (--map lists what is kept and what is left out);
        --boot-rom: as for asm
  hbc2 run <main.has | ram.bin | file.c...> [--ticks N] [--eeprom eeprom.bin]
        run headless, then print the CPU state (C files: built as with cc);
        the EEPROM (storage, 1 MiB) starts blank, or with eeprom.bin
  hbc2 trace <main.has | ram.bin> --max N [-o trace.csv] [--peripherals]
        write an execution trace (CSV, one line per instruction) until
        line N or until the CPU halts (H set); no peripherals unless
        --peripherals (output default: the input with the extension .csv)
  hbc2 compare <a.csv> <b.csv>
        compare two traces; at the first line that differs, print its n,
        the columns that differ and the 3 lines before it; exit code 0 if
        identical, 1 if they differ, 2 on error
  hbc2 bench [--seconds N] [--hz N]
        measure emulation speed (flat out, or paced on the emulator thread)
  hbc2 vectors <module> [-o file] | --list
        Logisim test vectors for a CPU circuit (e.g. add_sub8), every input
        combination, expected outputs computed by the emulator's own code
  hbc2 ucode [-o dir] [--cycles file.md] [--check]
        compile the control unit's microcode (hbc2-ucode/microcode/hbc2.uc)
        and check its rules; -o writes the 7 AT28C256 images (ucode0.bin ..
        ucode6.bin) and listing.txt; --cycles writes the cycle-count table;
        --check runs it on the datapath model against the emulator";

fn main() -> ExitCode {
    let args: Vec<String> = std::env::args().skip(1).collect();
    if args.first().map(String::as_str) == Some("compare") {
        return compare(&args[1..]);
    }
    let result = match args.first().map(String::as_str) {
        Some("asm") => asm(&args[1..]),
        Some("bench") => bench(&args[1..]),
        Some("cc") => cc(&args[1..]),
        Some("run") => run(&args[1..]),
        Some("trace") => trace(&args[1..]),
        Some("vectors") => vectors::vectors(&args[1..]),
        Some("ucode") => ucode(&args[1..]),
        _ => Err(USAGE.to_string()),
    };
    match result {
        Ok(()) => ExitCode::SUCCESS,
        Err(message) => {
            eprintln!("{message}");
            ExitCode::FAILURE
        }
    }
}

/// `hbc2 compare a.csv b.csv`: 0 identical, 1 different, 2 error.
fn compare(args: &[String]) -> ExitCode {
    let [first, second] = args else {
        eprintln!("{USAGE}");
        return ExitCode::from(2);
    };
    let read = |path: &str| std::fs::read_to_string(path).map_err(|e| format!("{path}: {e}"));
    let (a, b) = match (read(first), read(second)) {
        (Ok(a), Ok(b)) => (a, b),
        (Err(e), _) | (_, Err(e)) => {
            eprintln!("{e}");
            return ExitCode::from(2);
        }
    };
    match hbc2_core::trace::compare(&a, &b) {
        None => {
            println!("traces are identical ({} lines)", a.lines().count());
            ExitCode::SUCCESS
        }
        Some(diff) => {
            let report = hbc2_core::DiffReport {
                diff: &diff,
                first,
                second,
            };
            print!("{report}");
            ExitCode::from(1)
        }
    }
}

/// Returns the value following `--name`, if present.
/// `hbc2 ucode`: the control unit's microcode.
fn ucode(args: &[String]) -> Result<(), String> {
    let mc = hbc2_ucode::build().map_err(|e| {
        format!(
            "{} error(s):
{}",
            e.len(),
            e.join(
                "
"
            )
        )
    })?;
    println!(
        "microcode: {} words used of 32768, 54 bits (7 x AT28C256)",
        mc.origin.iter().filter(|o| o.is_some()).count()
    );
    for (what, n) in &mc.checks {
        println!("  ok {n:6}  {what}");
    }
    if let Some(dir) = option(args, "-o") {
        let dir = Path::new(dir);
        std::fs::create_dir_all(dir).map_err(|e| format!("{}: {e}", dir.display()))?;
        for (k, image) in mc.images().iter().enumerate() {
            let path = dir.join(format!("ucode{k}.bin"));
            std::fs::write(&path, image).map_err(|e| format!("{}: {e}", path.display()))?;
        }
        let path = dir.join("listing.txt");
        std::fs::write(&path, mc.listing()).map_err(|e| format!("{}: {e}", path.display()))?;
        println!(
            "wrote {}: ucode0.bin .. ucode6.bin, listing.txt",
            dir.display()
        );
    }
    if let Some(path) = option(args, "--cycles") {
        std::fs::write(path, mc.cycle_table()).map_err(|e| format!("{path}: {e}"))?;
        println!("wrote {path}");
    }
    if args.iter().any(|a| a == "--check") {
        use hbc2_ucode::check;
        println!("  ok  {}", check::every_instruction_and_mode(&mc, 64)?);
        println!("  ok  {}", check::random_programs(&mc, 4000)?);
        println!("  ok  {}", check::boot(&mc)?);
    }
    Ok(())
}

fn option<'a>(args: &'a [String], name: &str) -> Option<&'a str> {
    args.iter()
        .position(|a| a == name)
        .and_then(|i| args.get(i + 1))
        .map(String::as_str)
}

fn parse<T: std::str::FromStr>(args: &[String], name: &str, default: T) -> Result<T, String> {
    match option(args, name) {
        Some(value) => value
            .parse()
            .map_err(|_| format!("invalid value for {name}: {value}")),
        None => Ok(default),
    }
}

/// A loop mixing ALU, memory, compare/jump and one monitor write per iteration.
fn bench_program() -> Vec<u8> {
    use Opcode as O;
    use Register::*;
    // After CLI (1 byte) and three MOV r, value (3 bytes each).
    let loop_start = PROGRAM_START + 1 + 3 * 3;
    let program = [
        encode::none(O::Cli),           // no interrupts
        encode::reg_imm8(O::Mov, D, 5), // D = monitor CMD port (monitor is plugged first, ports 1-5)
        encode::reg_imm8(O::Mov, J, 1), // J = monitor WRITE command
        encode::reg_imm8(O::Mov, A, 0),
        // loop:
        encode::reg_imm8(O::Add, A, 1),
        encode::reg_ram(O::Str, A, 0x8000),
        encode::reg_ram(O::Lod, B, 0x8000),
        encode::reg(O::Xor, C, A),
        encode::reg(O::Out, D, J),
        encode::reg(O::Cmp, A, B),
        encode::imm16(O::Jme, loop_start),
        encode::none(O::Hlt),
    ];
    let mut ram = vec![0u8; hbc2_core::isa::RAM_SIZE];
    let mut address = PROGRAM_START as usize;
    for instruction in program {
        let size = instruction.size() as usize;
        ram[address..address + size].copy_from_slice(&instruction.to_bytes()[..size]);
        address += size;
    }
    ram
}

fn bench(args: &[String]) -> Result<(), String> {
    let seconds: f64 = parse(args, "--seconds", 3.0)?;
    let ram = bench_program();
    let mut machine =
        Machine::new(MachineConfig::default(), Some(&ram)).map_err(|e| e.to_string())?;
    if let Some(hz) = option(args, "--hz") {
        let hz = hz
            .parse()
            .map_err(|_| format!("invalid value for --hz: {hz}"))?;
        return paced_bench(machine, hz, seconds);
    }

    const BATCH: u64 = 1_000_000;
    let budget = Duration::from_secs_f64(seconds);
    let start = Instant::now();
    let mut ticks = 0u64;
    while start.elapsed() < budget {
        ticks += machine.run(BATCH).ticks;
    }
    let elapsed = start.elapsed().as_secs_f64();

    if machine.cpu.is_halted() {
        return Err("benchmark program halted unexpectedly".into());
    }
    println!(
        "{ticks} cycles in {elapsed:.2} s -> {:.1} MHz",
        ticks as f64 / elapsed / 1e6
    );
    Ok(())
}

/// Runs the benchmark on the emulator thread at a target speed, and checks
/// how close it gets.
fn paced_bench(machine: Machine, hz: u64, seconds: f64) -> Result<(), String> {
    use hbc2_runner::{Runner, Speed};
    let runner = Runner::new(machine);
    runner.set_speed(Speed::Hz(hz));
    let start = Instant::now();
    runner.run();
    std::thread::sleep(Duration::from_secs_f64(seconds));
    runner.pause();
    let snapshot = runner.sync();
    let elapsed = start.elapsed().as_secs_f64();
    let reached = snapshot.ticks as f64 / elapsed;
    println!(
        "target {:.3} MHz, reached {:.3} MHz ({:.1} %) over {elapsed:.2} s",
        hz as f64 / 1e6,
        reached / 1e6,
        reached / hz as f64 * 100.0
    );
    Ok(())
}

fn has(args: &[String], flag: &str) -> bool {
    args.iter().any(|a| a == flag)
}

/// The first argument, if it is not an option.
fn input(args: &[String]) -> Result<&str, String> {
    args.first()
        .map(String::as_str)
        .filter(|a| !a.starts_with('-'))
        .ok_or_else(|| USAGE.to_string())
}

/// Assembles a file, printing warnings; errors are returned as one message.
/// `strip`: leave out what nothing reaches.
fn assemble(path: &str, strip: bool) -> Result<Program, String> {
    let options = hbc2_asm::Options { strip };
    match hbc2_asm::assemble_with(Path::new(path), &hbc2_asm::FileSystem, options) {
        Ok(program) => {
            for warning in &program.warnings {
                eprintln!("{warning}");
            }
            Ok(program)
        }
        Err(errors) => {
            let lines: Vec<String> = errors.iter().map(ToString::to_string).collect();
            Err(format!(
                "{}\nassembly failed ({} error(s))",
                lines.join("\n"),
                errors.len()
            ))
        }
    }
}

fn is_source(path: &str) -> bool {
    Path::new(path)
        .extension()
        .is_some_and(|e| e.eq_ignore_ascii_case("has"))
}

fn is_c(path: &str) -> bool {
    Path::new(path)
        .extension()
        .is_some_and(|e| e.eq_ignore_ascii_case("c"))
}

/// Builds the C program of the files at the start of `args` (up to the
/// first option), printing warnings; errors are returned as one message.
fn build_c(args: &[String]) -> Result<Program, String> {
    let sources: Vec<PathBuf> = args
        .iter()
        .take_while(|a| !a.starts_with('-'))
        .map(PathBuf::from)
        .collect();
    let first = sources.first().ok_or_else(|| USAGE.to_string())?;
    let dir = option(args, "--dir").map(PathBuf::from).unwrap_or_else(|| {
        first
            .parent()
            .unwrap_or(Path::new("."))
            .join(hbc2_cc::BUILD_DIR)
    });
    let library = hbc2_cc::build_library(&dir.join("lib")).map_err(|e| failed(&e))?;
    let build = hbc2_cc::build_program(&sources, &library, &dir).map_err(|e| failed(&e))?;
    for warning in &build.warnings {
        eprintln!("{warning}");
    }
    Ok(build.program)
}

/// The messages of a failed build, and how many errors.
fn failed(diagnostics: &[hbc2_cc::Diagnostic]) -> String {
    let errors = diagnostics
        .iter()
        .filter(|d| d.severity == hbc2_cc::Severity::Error)
        .count();
    format!(
        "{}
build failed ({errors} error(s))",
        hbc2_cc::report(diagnostics)
    )
}

fn cc(args: &[String]) -> Result<(), String> {
    let first = input(args)?;
    let program = build_c(args)?;
    write_image(&program, first, args)
}

fn asm(args: &[String]) -> Result<(), String> {
    let path = input(args)?;
    let program = assemble(path, has(args, "--strip"))?;
    write_image(&program, path, args)
}

/// Writes the image (`-o`, or `source` with the extension `.bin`), the
/// symbols with `--symbols` or `--map`, and what was left out with `--map`.
fn write_image(program: &Program, source: &str, args: &[String]) -> Result<(), String> {
    let output = option(args, "-o")
        .map(PathBuf::from)
        .unwrap_or_else(|| Path::new(source).with_extension("bin"));
    let image = &program.image;
    std::fs::write(&output, image).map_err(|e| format!("{}: {e}", output.display()))?;
    let removed = match program.bytes_removed() {
        0 => String::new(),
        n => format!(", {n} bytes left out"),
    };
    println!(
        "{} -> {} ({} bytes used{removed}, {} files)",
        source,
        output.display(),
        program.bytes_used,
        program.files.len()
    );
    if has(args, "--boot-rom") {
        let [lo, hi] = hbc2_core::boot_rom::write(image, &output)?;
        println!(
            "boot ROM -> {} (0000-7FFF), {} (8000-FFFF)",
            lo.display(),
            hi.display()
        );
    }

    let map = has(args, "--map");
    if has(args, "--symbols") || map {
        for s in &program.symbols {
            let kind = match s.kind {
                hbc2_asm::SymbolKind::Label => "label",
                hbc2_asm::SymbolKind::Data => "data ",
            };
            println!(
                "  ${:#07x}  {kind}  {:>5} bytes  {}",
                s.address, s.size, s.name
            );
        }
    }
    if map && !program.removed.is_empty() {
        println!("left out (nothing reaches them):");
        for r in &program.removed {
            let file = program.files[r.file].display();
            println!(
                "  {:>5} bytes  {}  ({file}, line {})",
                r.size, r.name, r.line
            );
        }
    }
    Ok(())
}

fn run(args: &[String]) -> Result<(), String> {
    let path = input(args)?;
    let ticks: u64 = parse(args, "--ticks", 1_000_000)?;

    let mut config = MachineConfig::default();
    if let Some(eeprom_path) = option(args, "--eeprom") {
        let image = std::fs::read(eeprom_path).map_err(|e| format!("{eeprom_path}: {e}"))?;
        config.eeprom = Some(Eeprom::from_image(image).map_err(|e| e.to_string())?);
    }
    let (ram, program) = if is_c(path) {
        let program = build_c(args)?;
        (program.image.clone(), Some(program))
    } else if is_source(path) {
        let program = assemble(path, false)?;
        (program.image.clone(), Some(program))
    } else {
        (
            std::fs::read(path).map_err(|e| format!("{path}: {e}"))?,
            None,
        )
    };

    let mut machine = Machine::new(config, Some(&ram)).map_err(|e| e.to_string())?;
    let result = machine.run(ticks);

    let cpu = &machine.cpu;
    let name_of = |address: u16| {
        program
            .as_ref()
            .and_then(|p| p.symbol_at(address as u32))
            .map(|s| s.name.clone())
    };
    println!("cycles: {}", result.ticks);
    println!(
        "pc: {:#06x}   sp: {:#06x}   last instruction: {:#06x}  {}",
        cpu.pc,
        cpu.sp,
        cpu.last_pc,
        hbc2_asm::disasm::disassemble_with(cpu.ir.0, name_of)
    );
    for r in Register::ALL {
        print!("{}={:#04x} ", r.name(), cpu.reg(r));
    }
    println!();
    let flags: String = Flag::ALL
        .iter()
        .map(|&f| if cpu.flag(f) { f.letter() } else { '-' })
        .collect();
    println!("flags: {flags}");
    if cpu.stopped_by_invalid_instruction() {
        println!("stopped: invalid instruction at {:#06x}", cpu.last_pc);
    } else if cpu.is_stopped() {
        println!("stopped: hlt with interrupts off");
    }
    Ok(())
}

fn trace(args: &[String]) -> Result<(), String> {
    let path = input(args)?;
    let max: u64 = match option(args, "--max") {
        Some(value) => value
            .parse()
            .map_err(|_| format!("invalid value for --max: {value}"))?,
        None => return Err("trace: --max N is required".into()),
    };
    let output = option(args, "-o")
        .map(PathBuf::from)
        .unwrap_or_else(|| Path::new(path).with_extension("csv"));

    let ram = if is_source(path) {
        assemble(path, false)?.image
    } else {
        std::fs::read(path).map_err(|e| format!("{path}: {e}"))?
    };
    let config = if has(args, "--peripherals") {
        MachineConfig::default()
    } else {
        MachineConfig {
            monitor: false,
            rtc: false,
            keyboard: false,
            eeprom: None,
            mailbox: None,
        }
    };
    let mut machine = Machine::new(config, Some(&ram)).map_err(|e| e.to_string())?;

    let file = std::fs::File::create(&output).map_err(|e| format!("{}: {e}", output.display()))?;
    let mut writer = TraceWriter::new(std::io::BufWriter::new(file), Some(max));
    writer.start(&machine.cpu);
    while !writer.is_full() && writer.error().is_none() && !machine.cpu.is_halted() {
        machine.step_with(&mut writer);
    }
    let lines = writer.lines();
    writer
        .finish()
        .map_err(|e| format!("{}: {e}", output.display()))?;
    let end = if machine.cpu.is_halted() {
        "CPU halted"
    } else {
        "--max reached"
    };
    println!("{path} -> {} ({lines} lines, {end})", output.display());
    Ok(())
}
