SteriCraft/hbc2-ide/compiler/fcc/main.c

/*
 *	Compiler pass main loop
 */

#include <stdio.h>
#include <stdint.h>
#include <stdlib.h>

#include "compiler.h"

FILE *debug;

unsigned deffunctype;		/* The type of an undeclared function */
unsigned funcbody;		/* Parser global for function body */
unsigned voltrack;		/* Track possible volatiles */
unsigned in_sizeof;		/* Set if we are in sizeof() */
unsigned cputype;		/* So the target specific code can make decisions */
unsigned long cpufeat;		/* CPU feature flags from user for target specific code */

/*
 *	A C program consists of a series of declarations that by default
 *	are external definitions.
 */
static void toplevel(void)
{
	if (token == T_TYPEDEF) {
		next_token();
		dotypedef();
	} else {
		funcbody = 0;
		voltrack = 0;
		target_reginit();
		/* HBC-2: the line of a variable or a function (its label) */
		line_header();
		declaration(S_EXTDEF);
	}
}

/* A function defined by use is taken to be int f(); */
static unsigned functype[2] = {
	1, ELLIPSIS
};

int main(int argc, char *argv[])
{
	if (argc != 3) {
		error("cc1 cpuname features");
		exit(1);
	}
	cputype = atoi(argv[1]);
	cpufeat = atol(argv[2]);
	next_token();
	init_nodes();
	/* A function with no type info returning INT */
	deffunctype = make_function(CINT, functype);
#ifdef DEBUG
	if (argv[1]) {
		debug = fopen(argv[1], "w");
		if (debug == NULL) {
			perror(argv[1]);
			return 255;
		}
	}
#endif
	while (token != T_EOF)
		toplevel();
	/* HBC-2: what follows (variables declared without a value) has no
	   line of its own */
	header(H_LINE, 0, 0);
	/* No write out any uninitialized variables */
	write_bss();
	out_write();
	return errors;
}
