SteriCraft/hbc2-ide/compiler/fcc/symbol.c

/*
 *	Look up and manage symbols. We have two lists, one global and one
 *	local. To avoid two lists we keep a "last local" and "last global"
 *	pointer. This allows us to keep dumping local names whilst still
 *	being able to defines globals in local contexts.
 */

#include <stdio.h>
#include <stdlib.h>
#include <string.h>
#include "compiler.h"

static void symbol_bss(struct symbol *);

struct symbol symtab[MAXSYM];
struct symbol *last_sym = symtab - 1;
struct symbol *local_top = symtab;
unsigned block_depth;

struct symbol *symbol_ref(unsigned type)
{
	return symtab + INFO(type);
}

/* Local symbols have priority in all cases */
/* Find a symbol in the normal name space */
struct symbol *find_symbol(unsigned name, unsigned global)
{
	register struct symbol *s = last_sym;
	struct symbol *gmatch = NULL;
	/* Walk backwards so that the first local we find is highest priority
	   by scope */
	while (s >= symtab) {
		if (s->name == name && s->infonext < S_TYPEDEF) {
			if (s->infonext < S_STATIC) {
				if (!global)
					return s;
			} else	/* Still need to look for a local */
				gmatch = s;
		}
		s--;
	}
	return gmatch;
}

struct symbol *find_symbol_by_class(unsigned name, unsigned class)
{
	register struct symbol *s = last_sym;
	struct symbol *gmatch = NULL;
	/* Walk backwards so that the first local we find is highest priority
	   by scope */
	while (s >= symtab) {
		if (s->name == name && S_STORAGE(s->infonext) == class) {
			if (s->infonext < S_STATIC)
				return s;
			else	/* Still need to look for a local */
				gmatch = s;
		}
		s--;
	}
	return gmatch;
}

void pop_local_symbols(struct symbol *top)
{
	register struct symbol *s = top + 1;
	while (s <= last_sym) {
		if (S_STORAGE(s->infonext) < S_STATIC) {
			/* Write out any storage if needed */
			symbol_bss(s);
			s->infonext = S_FREE;
			s->name = 0;
		}
		s++;
	}
	local_top = top;
}

struct symbol *mark_local_symbols(void)
{
	return local_top;
}

/* The symbols from 0 to local_top are a mix of kinds but as we have not
   discarded below that point are all full. Between that and last_sym there
   may be holes, above last_sym is free */
struct symbol *alloc_symbol(unsigned name, unsigned local)
{
	register struct symbol *s = local_top;
	while (s <= &symtab[MAXSYM]) {
		if (s->infonext == S_FREE) {
			if (local && local_top < s)
				local_top = s;
			if (last_sym < s)
				last_sym = s;
			s->name = name;
			s->data.idx = 0;
			return s;
		}
		s++;
	}
	fatal("too many symbols");
}

/*
 *	Create or update a symbol. Warn about any symbol we are hiding.
 *	A symbol can be setup as C_ANY meaning "we've no idea yet" to hold
 *	the slot. Once the types are found it will get updated with the
 *	types and any checking done.
 */
struct symbol *update_symbol(register struct symbol *sym, unsigned name, unsigned storage,
			     unsigned type)
{
	unsigned local = 0;
	register unsigned symst;

	if (storage < S_STATIC)
		local = 1;
	if (sym != NULL && sym->type != C_ANY) {
		if (type == C_ANY)
			return sym;
		symst = S_STORAGE(sym->infonext);
		if (symst > S_TYPEDEF)
			error("invalid name");
		else if (symst < S_STATIC || !local) {
			if (sym->type != type) {
				if (IS_ARRAY(type) && IS_ARRAY(sym->type))
					sym->type = array_compatible(type, sym->type);
				else
					typemismatch();
			}
			if (symst == storage)
				return sym;
			/* extern foo and now found foo */
			if (symst == S_EXTERN && storage == S_EXTDEF) {
				sym->infonext = S_INDEX(sym->infonext);
				sym->infonext |= S_EXTDEF;
				return sym;
			}
			/* foo and now found extern foo */
			if (symst == S_EXTDEF && storage == S_EXTERN)
					return sym;
			error("storage class mismatch");
			return sym;
		}
	}
	/* Insert new symbol */
	if (sym == NULL)
		sym = alloc_symbol(name, local);
	/* Fill in the new or reserved symbol */
	sym->type = type;
	sym->infonext = storage;
	sym->data.idx = 0;
	sym->depth = block_depth;
	return sym;
}

/* Update a symbol by name. In the case of things like typedefs we need
   to do an explicit search, otherwise we look for conventional names.

   Not strictly correct at this point - each block is a new context and
   block locals can hide the previous block. TODO sort this once we have
   the chains/hashing in */
struct symbol *update_symbol_by_name(unsigned name, unsigned storage,
			     unsigned type)
{
	struct symbol *sym;
	unsigned global = 0;
	/* If we are updating a static/global symbol then ignore any local names
	   obscuring it. In the reverse case the priority rule will fix it for now
	   FIXME: when we fix the block contexts we have to fix this hack too */
	if (storage >= S_STATIC)
		global = 1;
	if (storage >= S_TYPEDEF)
		sym = find_symbol_by_class(name, storage);
	else
		sym = find_symbol(name, global);
	/* Is it local ? if the one we found is global then we don't update
	   it - we create a local one masking it */
	if (sym && global == 0 && sym->infonext >= S_STATIC)
		sym = NULL;
	/* Local symbols don't duplicate in the same block. HBC-2: a local of
	   an outer block is hidden by a new one (block scope) */
	if (sym && !global) {
		if (sym->depth == block_depth)
			error("duplicate name");
		else
			sym = NULL;
	}
	return update_symbol(sym, name, storage, type);
}

/*
 *	Find or insert a function prototype. We keep these in the sym table
 *	as a handy way to get an index for types.
 *
 *	Although it has a cost we really need to fold all the equivalently
 *	typed argument sets into a single instance to save memory.
 *
 *	TODO: we need to hash this, but differently to the usual symbol
 *	indexing as we care about the template pattern most
 */
static struct symbol *do_type_match(unsigned st, unsigned rtype, unsigned *idx)
{
	register struct symbol *sym = symtab;
	while(sym <= last_sym) {
		if (S_STORAGE(sym->infonext) == st && sym->type == rtype && sym->data.idx == idx) {
			return sym;
		}
		sym++;
	}
	sym = alloc_symbol(0xFFFF, 0);
	sym->infonext = st;
	sym->data.idx = idx;
	sym->type = rtype;
	return sym;
}

unsigned *sym_find_idx(unsigned storage, unsigned *idx, unsigned len)
{
	register struct symbol *sym = symtab;
	unsigned blen = len * sizeof(unsigned);
	while (sym <= last_sym) {
		if (S_STORAGE(sym->infonext) == storage && memcmp(sym->data.idx, idx, blen) == 0)
			return sym->data.idx;
		sym++;
	}
	return idx_copy(idx, len);
}

unsigned func_return(unsigned n)
{
	if (!IS_FUNCTION(n))
		return CINT;
	return symtab[INFO(n)].type;	/* Type of function is its return type */
}

unsigned *func_args(unsigned n)
{
	if (!IS_FUNCTION(n))
		return NULL;
	return symtab[INFO(n)].data.idx;	/* Type of function is its return type */
}

unsigned make_function(unsigned type, unsigned *idx)
{
	/* Can we use the one we found (if we did) */
	struct symbol *sym = do_type_match(S_FUNCDEF, type, idx);
	return C_FUNCTION | ((sym - symtab) << 3);
}

unsigned func_symbol_type(unsigned type, unsigned *idx)
{
	struct symbol *sym;
	idx = sym_find_idx(S_FUNCDEF, idx, *idx + 1);
	sym = do_type_match(S_FUNCDEF, type, idx);
	return C_FUNCTION | ((sym - symtab) << 3);
}

/*
 *	Array type helpers
 */

unsigned array_num_dimensions(unsigned type)
{
	struct symbol *sym = symbol_ref(type);
	return *sym->data.idx;
}

unsigned array_dimension(unsigned type, unsigned depth)
{
	struct symbol *sym = symbol_ref(type);
	return sym->data.idx[depth];
}

unsigned make_array(unsigned type, unsigned *idx)
{
	struct symbol *sym = do_type_match(S_ARRAY, type, idx);
	return C_ARRAY | ((sym - symtab) << 3) | *idx;
}

unsigned array_type(unsigned n)
{
	if (!IS_ARRAY(n))
		return CINT;
	return symtab[INFO(n)].type;	/* Type of array is its element type */
}

/* Make a sized version of the array type given */
unsigned array_with_size(unsigned t, unsigned size)
{
	register struct symbol *sym = symbol_ref(t);
	unsigned x[9];	/* Max ptr depth of 8  + size */
	unsigned *idx;

	memcpy(x, sym->data.idx, 9 * sizeof(unsigned));
	x[1] = size;

	/* See if this type exists */
	idx = sym_find_idx(S_ARRAY, x, *x + 1);
	/* Make the new one, or find the reference */
	return make_array(sym->type, idx);
}

/*
 *	Check if two arrays are compatible. If so return the type of the
 *	one with the actual dimensions, if not 0xFFFF
 */
unsigned array_compatible(unsigned t1, unsigned t2)
{
	unsigned *i1 = symtab[INFO(t1)].data.idx;
	unsigned *i2 = symtab[INFO(t2)].data.idx;
	/* Check the depth and dimensions beyond the first */
	if (*i1 != *i2 || (*i1 > 1 && memcmp(i1 + 2, i2 + 2, ((*i1) * sizeof(unsigned)) - 1)))
		typemismatch();
	if (i1[1] == 0)
		return t2;
	return t1;
}

/*
 *	Struct helpers
 */

static struct symbol *find_struct(unsigned name)
{
	struct symbol *sym = symtab;
	/* Anonymous structs are unique each time */
	if (name == 0)
		return 0;
	while(sym <= last_sym) {
		if (sym->name == name) {
			unsigned st = S_STORAGE(sym->infonext);
			if (st == S_STRUCT || st == S_UNION)
				return sym;
		}
		sym++;
	}
	return NULL;
}

struct symbol *update_struct(unsigned name, unsigned t)
{
	register struct symbol *sym;
	if (t)
		t = S_STRUCT;
	else
		t = S_UNION;
	sym = find_struct(name);
	if (sym == NULL) {
		sym = alloc_symbol(name, 0);	/* TODO scoping */
		sym->infonext = t;
		sym->data.idx = NULL;	/* Not yet known */
	} else {
		if (S_STORAGE(sym->infonext) != t)
			error("declared both union and struct");
	}
	return sym;
}

unsigned *struct_find_member(unsigned name, unsigned fname)
{
	register struct symbol *s = symtab + INFO(name);
	register unsigned idx;
	unsigned *ptr;
	/* May be a known type but not one with fields yet declared */
	if (s->data.idx == NULL)
		return NULL;
	idx = *s->data.idx;	/* Number of fields */
	ptr = s->data.idx + 2;	/* num fields, sizeof */
	while(idx--) {
		/* name, type, offset tuples */
		if (*ptr == fname)
			return ptr;
		ptr += 3;
	}
	return NULL;
}

unsigned type_of_struct(struct symbol *sym)
{
	return C_STRUCT|((sym - symtab) << 3);
}

/*
 *	Generate the BSS at the end (and at scope end for static local)
 */

static void symbol_bss(register struct symbol *s)
{
	unsigned st = S_STORAGE(s->infonext);
	register unsigned t = s->type;
	if ((PTR(t) || !IS_FUNCTION(t)) && st != S_EXTERN && st >= S_LSTATIC && st <= S_EXTDEF) {
		if (st == S_EXTDEF)
			header(H_EXPORT, s->name, 0);
		if (!(s->infonext & INITIALIZED)) {
			unsigned n = type_sizeof(t);
			unsigned l = s->name;
			if (st == S_LSTATIC)
				l = s->data.offset;
			header(H_BSS, l, target_alignof(t, st));
			put_padding_data(n);
			footer(H_BSS, l, 0);
		}
	}
}

void write_bss(void)
{
	register struct symbol *s = symtab;

	while(s <= last_sym) {
#ifdef DEBUG
		if (debug)
			fprintf(debug, "sym %x %x %x\n", s->name, s->type, s->infonext);
#endif
		symbol_bss(s);
		s++;
	}
}
