SteriCraft/hbc2-ide/hbc2/crates/hbc2-ide/src/app.rs

//! The IDE's state and everything it can do.
//!
//! Views and menus never change the state directly when it involves more
//! than their own widget: they queue an [`Action`], and the actions run once
//! the frame's UI is built. This keeps borrowing simple (a view only sees
//! what it shows) and gives one place where each operation is written.

use std::collections::{BTreeSet, HashMap};
use std::io;
use std::ops::Range;
use std::path::{Path, PathBuf};
use std::sync::Arc;
use std::time::Instant;

use eframe::egui;
use egui_dock::{DockState, Node, NodeIndex, TabIndex};

use crate::editor_groups::{self, Drop};
use hbc2_asm::source::normalize;
use hbc2_asm::{Diagnostic, Program, Severity, SourceProvider};
use hbc2_runner::{RunState, Snapshot, Speed};
use serde::{Deserialize, Serialize};

use crate::console::{Console, Level};
use crate::document::{Document, shift_breakpoints};
use crate::emulator::{Emulator, Image, Peripherals, ram_address};
use crate::find::{Find, FindMode};
use crate::project::{self, Language, Project};
use crate::settings::{ProjectSettings, Settings};
use crate::signatures::Signatures;
use crate::tabs::Tab;
use crate::views::disasm::DisasmView;
use crate::views::editor::{char_index_of_line, editor_id};
use crate::views::memory::MemoryView;
use crate::views::monitor::MonitorView;

/// Saved between sessions. The layout is fixed: only the sizes of its parts
/// are kept.
#[derive(Serialize, Deserialize)]
pub struct Saved {
    pub settings: Settings,
    /// Fractions of the layout's splits, in the order of `default_layout`.
    #[serde(default)]
    pub splits: Vec<f32>,
}

#[derive(Clone, Debug)]
pub enum Action {
    NewProject,
    /// Creates a project in this folder and opens it. The flag adds the
    /// default interrupt handler (assembly only).
    CreateProject(PathBuf, Language, bool),
    OpenProjectDialog,
    OpenProject(PathBuf),
    CloseProject,
    OpenFileDialog,
    OpenFile(PathBuf, Option<u32>),
    NewFile(PathBuf),
    NewFolder(PathBuf),
    RenameFile(PathBuf),
    DeleteFile(PathBuf),
    RefreshFiles,
    /// Opens the file manager on a folder, or on a file's folder.
    ShowFolder(PathBuf),
    /// Moves a file or folder into another folder.
    MovePath(PathBuf, PathBuf),
    Save,
    SaveAll,
    /// Closes an editor tab, asking about unsaved changes.
    CloseTab(PathBuf),
    CloseCurrentTab,
    /// Closes several editor tabs, asking about unsaved changes once.
    CloseTabs(Vec<PathBuf>),
    CloseGroup(TabGroup),
    /// Moves a file tab (dragged and dropped).
    MoveTab(PathBuf, Drop),
    /// Opens a file tab in a new group right of its own.
    SplitRight(PathBuf),
    /// Undoes or redoes the last edit in the editor tab.
    Undo,
    Redo,
    /// Collapses the functions of the editor tab (true), or expands everything.
    FoldAll(bool),
    /// Opens the find bar.
    OpenFind(FindMode),
    /// Closes the find bar; the editor gets the keyboard, with the current
    /// match selected.
    CloseFind,
    /// Opens a file and selects a "find in files" match.
    ShowMatch {
        path: PathBuf,
        line: u32,
        columns: Range<usize>,
    },
    Assemble,
    Run,
    Pause,
    /// F10: the current line (C) or instruction (assembly), running the
    /// routines it calls.
    StepOver,
    /// F11: the current line or instruction, stopping in the routines called.
    StepInto,
    /// Shift+F11: until the current routine returns.
    StepOut,
    /// The reset button: the CPU only (`Machine::reset`).
    Reset,
    /// Power off and on (`Machine::power_on`).
    Restart,
    ExportImage,
    ExportBootRom,
    LoadImage,
    SaveEeprom,
    LoadEeprom,
    /// Starts recording an execution trace (asks for the file), or stops it.
    ToggleTrace,
    /// Leave out unused code in an assembly project, or keep everything.
    SetStrip(bool),
    SetPeripherals(Peripherals),
    SetSpeed(Speed),
    /// Breakpoint lines changed: send the new addresses to the emulator.
    BreakpointsChanged,
    ToggleAddressBreakpoint(u16),
    /// Sends the RTC's interrupt now.
    RtcInterrupt,
    Quit,
    ShowDialog(Dialog),
}

/// Editor tabs closed together, from the tab menu or the keyboard.
#[derive(Clone, Debug)]
pub enum TabGroup {
    /// The editor tabs after this one.
    ToTheRight(PathBuf),
    /// The editor tabs without unsaved changes.
    Saved,
    /// All editor tabs but this one (the current editor if none).
    Others(Option<PathBuf>),
    All,
}

#[derive(Clone, Debug)]
pub enum Dialog {
    /// Unsaved changes in `paths`; `then` runs after saving or discarding them.
    Unsaved {
        paths: Vec<PathBuf>,
        then: Box<Action>,
    },
    NewProject {
        /// The project goes in `parent/name`, or in `parent` itself
        /// without `own_folder`.
        parent: PathBuf,
        own_folder: bool,
        name: String,
        language: Language,
        devices: bool,
        error: Option<String>,
    },
    NewFile {
        dir: PathBuf,
        name: String,
        error: Option<String>,
        /// Select the name without its extension (first frame only).
        select_stem: bool,
    },
    NewFolder {
        dir: PathBuf,
        name: String,
        error: Option<String>,
    },
    Rename {
        path: PathBuf,
        name: String,
        error: Option<String>,
        /// Select the name without its extension (first frame only).
        select_stem: bool,
    },
    Delete {
        path: PathBuf,
    },
    Message {
        title: String,
        text: String,
    },
    About,
    Keyboard,
    /// The settings being edited, taken by OK.
    Settings {
        page: SettingsPage,
        draft: Box<Settings>,
        /// Waiting for the keys of a new shortcut for this command.
        capture: Option<crate::shortcuts::Command>,
        /// Told on the Shortcuts page: a command lost its shortcut.
        notice: Option<String>,
    },
}

/// A page of the settings dialog.
#[derive(Clone, Copy, Debug, PartialEq, Eq)]
pub enum SettingsPage {
    General,
    Editor,
    Build,
    Emulator,
    Monitor,
    Shortcuts,
}

impl SettingsPage {
    pub const ALL: [SettingsPage; 6] = [
        SettingsPage::General,
        SettingsPage::Editor,
        SettingsPage::Build,
        SettingsPage::Emulator,
        SettingsPage::Monitor,
        SettingsPage::Shortcuts,
    ];

    pub fn label(self) -> &'static str {
        match self {
            SettingsPage::General => "General",
            SettingsPage::Editor => "Editor",
            SettingsPage::Build => "Build",
            SettingsPage::Emulator => "Emulator",
            SettingsPage::Monitor => "Monitor",
            SettingsPage::Shortcuts => "Shortcuts",
        }
    }
}

/// A program, the image to load and the warnings, or the errors (with the
/// warnings).
type BuildResult = Result<(Program, Image, Vec<Diagnostic>), Vec<Diagnostic>>;

/// A C build running in the background.
pub struct PendingBuild {
    result: std::sync::mpsc::Receiver<BuildResult>,
    started: Instant,
    /// `State::edits` when the build started (the files were saved then).
    edits: u64,
    /// What to do once the build is loaded (Run or Step pressed meanwhile).
    then: Option<Action>,
}

/// Result of the last assembly.
pub struct Build {
    pub ok: bool,
    pub diagnostics: Vec<Diagnostic>,
    /// Lines holding an instruction, per file.
    pub code_lines: HashMap<PathBuf, BTreeSet<u32>>,
}

pub struct State {
    pub settings: Settings,
    pub project: Option<Project>,
    pub project_settings: ProjectSettings,
    pub docs: Vec<Document>,
    pub console: Console,
    pub emulator: Emulator,
    pub build: Option<Build>,
    /// The C build in progress, if any.
    pub building: Option<PendingBuild>,
    /// Counts edits to the sources (to know when the loaded build is out of date).
    pub edits: u64,
    /// Value of `edits` when the loaded image was assembled (`None`: not assembled here).
    pub loaded_edits: Option<u64>,
    /// The C functions the editor shows the parameters of (C projects).
    pub signatures: Signatures,
    /// Latest emulator state, read once per frame.
    pub snapshot: Arc<Snapshot>,
    pub dialog: Option<Dialog>,
    pub actions: Vec<Action>,
    pub monitor_view: MonitorView,
    pub memory_view: MemoryView,
    pub disasm_view: DisasmView,
    pub find: Find,
    /// The file of the editor tab shown in the editor group last used, if any.
    pub active_editor: Option<PathBuf>,
    /// The file tab being dragged.
    pub tab_drag: Option<PathBuf>,
    /// The file tabs as drawn this frame, for dropping a dragged tab.
    pub tab_rects: Vec<(Tab, egui::Rect)>,
    /// (cycles, PC) the editor last jumped to.
    followed: Option<(u64, u16)>,
    /// Last breakpoint stop written to the console.
    reported_stop: Option<(u64, hbc2_core::StopReason)>,
    /// `Snapshot::trace_ends` already reported in the console.
    reported_trace_ends: u64,
    last_disk_check: f64,
    quit_confirmed: bool,
    title: String,
    /// Width the "CPU & I/O" tab needs to show all its text: the fixed
    /// width of the right-hand group.
    pub tools_min_width: f32,
}

pub struct Ide {
    pub dock: DockState<Tab>,
    pub state: State,
    /// Ctrl+W is held: true once R or K made it Ctrl+W+R or Ctrl+W+K.
    close_chord: Option<bool>,
    /// While the right-hand group is hidden: its split fraction and open
    /// tab, to put it back as it was.
    tools_stash: Option<(f32, TabIndex)>,
    /// The file last shown in a focused editor group: [`Ide::active_editor`]
    /// is the tab shown in its group.
    last_editor: Option<PathBuf>,
    /// Size and position the monitor window opened with, while it is open.
    monitor_geometry: Option<(egui::Vec2, Option<egui::Pos2>)>,
    /// The monitor window is kept above the others.
    monitor_on_top: bool,
}

/// Open editor buffers first, files on disk otherwise: assembling uses
/// unsaved changes without saving them.
struct Sources<'a>(HashMap<PathBuf, &'a str>);

impl SourceProvider for Sources<'_> {
    fn read(&self, path: &Path) -> io::Result<String> {
        match self.0.get(&normalize(path)) {
            Some(text) => Ok(text.to_string()),
            None => std::fs::read_to_string(path),
        }
    }
}

pub fn default_layout() -> DockState<Tab> {
    let mut dock = DockState::new(vec![Tab::Welcome]);
    let surface = dock.main_surface_mut();
    // The fraction is the share of the left or top part.
    let [center, _] = surface.split_left(NodeIndex::root(), 0.16, vec![Tab::Project]);
    let [center, _] = surface.split_right(center, 0.56, TOOL_TABS.to_vec());
    surface.split_below(center, 0.74, vec![Tab::Console]);
    dock
}

/// Tabs of the right-hand group, which share its width equally.
/// Up to this speed, the editor, disassembly and memory views follow the PC while running.
pub const FOLLOW_MAX_HZ: u64 = 100;

pub const TOOL_TABS: [Tab; 3] = [Tab::Cpu, Tab::Disassembly, Tab::Memory];

/// Takes the right-hand group out of the layout. Gives back its split
/// fraction and open tab, for [`show_tools`].
fn hide_tools(dock: &mut DockState<Tab>) -> Option<(f32, TabIndex)> {
    let (node, _) = dock.find_main_surface_tab(&TOOL_TABS[0])?;
    let surface = dock.main_surface_mut();
    let active = surface[node].get_leaf()?.active;
    let Node::Horizontal(split) = &surface[node.parent()?] else {
        return None;
    };
    let fraction = split.fraction;
    surface.remove_leaf(node);
    Some((fraction, active))
}

/// Puts the right-hand group back right of the editors and console.
fn show_tools(dock: &mut DockState<Tab>, (fraction, active): (f32, TabIndex)) {
    let Some(parent) = dock
        .find_main_surface_tab(&Tab::Console)
        .and_then(|(node, _)| node.parent())
    else {
        return;
    };
    let surface = dock.main_surface_mut();
    let [_, tools] = surface.split_right(parent, fraction, TOOL_TABS.to_vec());
    if let Node::Leaf(leaf) = &mut surface[tools] {
        leaf.active = active;
    }
}

/// The button that hides or shows the right-hand group.
fn tools_button(ui: &mut egui::Ui, rect: egui::Rect, hidden: bool) -> bool {
    let (text, hint) = if hidden {
        ("«", "Show the CPU & I/O, Disassembly and Memory tabs")
    } else {
        ("»", "Hide the CPU & I/O, Disassembly and Memory tabs")
    };
    ui.put(rect, egui::Button::new(text).frame(false))
        .on_hover_text(hint)
        .clicked()
}

/// Fractions of the splits (the sizes the user set with the mouse).
fn split_fractions(dock: &DockState<Tab>) -> Vec<f32> {
    dock.main_surface()
        .iter()
        .filter_map(|node| match node {
            Node::Horizontal(split) | Node::Vertical(split) => Some(split.fraction),
            _ => None,
        })
        .collect()
}

/// The fixed layout, with the split fractions of an earlier session when
/// they fit it.
fn layout_with(splits: &[f32]) -> DockState<Tab> {
    let mut dock = default_layout();
    if splits.len() != split_fractions(&dock).len()
        || splits.iter().any(|f| !(0.0..=1.0).contains(f))
    {
        return dock;
    }
    let splits_in_layout = dock
        .main_surface_mut()
        .iter_mut()
        .filter_map(|node| match node {
            Node::Horizontal(split) | Node::Vertical(split) => Some(split),
            _ => None,
        });
    for (split, &fraction) in splits_in_layout.zip(splits) {
        split.fraction = fraction;
    }
    dock
}

impl Ide {
    pub fn new(ctx: &egui::Context, saved: Option<Saved>) -> Ide {
        let (mut settings, dock) = match saved {
            Some(saved) => (saved.settings, layout_with(&saved.splits)),
            None => (Settings::default(), default_layout()),
        };
        if let Some(speed) = settings.emulator.startup_speed {
            settings.speed = speed;
        }
        let repaint = ctx.clone();
        let emulator = Emulator::new(Peripherals::default(), settings.speed.into(), move || {
            repaint.request_repaint()
        });
        let snapshot = emulator.runner.snapshot();
        let mut ide = Ide {
            dock,
            close_chord: None,
            tools_stash: None,
            last_editor: None,
            monitor_geometry: None,
            monitor_on_top: false,
            state: State {
                settings,
                project: None,
                project_settings: ProjectSettings::default(),
                docs: Vec::new(),
                console: Console::default(),
                emulator,
                build: None,
                building: None,
                edits: 0,
                loaded_edits: None,
                signatures: Signatures::default(),
                snapshot,
                dialog: None,
                actions: Vec::new(),
                monitor_view: MonitorView::default(),
                memory_view: MemoryView::default(),
                disasm_view: DisasmView::default(),
                find: Find::default(),
                active_editor: None,
                tab_drag: None,
                tab_rects: Vec::new(),
                followed: None,
                reported_stop: None,
                reported_trace_ends: 0,
                last_disk_check: 0.0,
                quit_confirmed: false,
                title: String::new(),
                tools_min_width: 0.0,
            },
        };
        let monitor = ide.state.settings.monitor;
        ide.state.settings.monitor_window = monitor.open_on_startup;
        ide.state.monitor_view.integer_scale = monitor.sharp_scaling;
        ide.state.disasm_view.follow_pc = ide.state.settings.follow_pc;
        ide.state.memory_view.follow_pc = ide.state.settings.follow_pc;
        ide.state
            .console
            .info("HBC-2 IDE ready. F7 assembles, F5 runs, F10 steps.");

        // Reopen the last project, with the files that were open in it.
        if ide.state.settings.general.reopen_last_project
            && let Some(root) = ide.state.settings.last_project.clone()
        {
            ide.open_project(&root, true);
        }
        ide
    }

    /// What to save between sessions.
    pub fn saved(&mut self) -> Saved {
        self.store_project_settings();
        Saved {
            settings: self.state.settings.clone(),
            splits: match self.tools_stash {
                // Saved as if shown, so that the layout fits on the next start.
                // The editor groups are saved as one.
                Some(stash) => {
                    let mut dock = self.dock.clone();
                    editor_groups::merge_groups(&mut dock);
                    show_tools(&mut dock, stash);
                    split_fractions(&dock)
                }
                None => {
                    let mut dock = self.dock.clone();
                    editor_groups::merge_groups(&mut dock);
                    split_fractions(&dock)
                }
            },
        }
    }

    fn store_project_settings(&mut self) {
        let Some(project) = &self.state.project else {
            return;
        };
        self.state.project_settings.open_files = self.editor_paths();
        self.state.project_settings.editor_layout = editor_groups::editor_layout(&self.dock);
        // Forget breakpoint sets that became empty.
        self.state
            .project_settings
            .breakpoints
            .retain(|_, lines| !lines.is_empty());
        self.state
            .settings
            .projects
            .insert(project.root.clone(), self.state.project_settings.clone());
    }

    fn editor_paths(&self) -> Vec<PathBuf> {
        self.dock
            .iter_all_tabs()
            .filter_map(|(_, t)| match t {
                Tab::Editor(path) => Some(path.clone()),
                _ => None,
            })
            .collect()
    }

    /// One frame of the whole IDE.
    pub fn ui(&mut self, ui: &mut egui::Ui) {
        let ctx = ui.ctx().clone();
        self.state.snapshot = self.state.emulator.runner.snapshot();
        self.state.poll_build(&ctx);
        self.shortcuts(&ctx);
        self.watch_emulator();
        self.check_disk(&ctx);
        self.handle_close_request(&ctx);
        if let Some(path) = self.current_editor() {
            self.last_editor = Some(path);
        }
        self.state.active_editor = self.active_editor();
        crate::highlight::set_tab_width(self.state.settings.editor.tab_width);
        crate::editing::set_indent_with_spaces(self.state.settings.editor.indent_with_spaces);

        crate::chrome::menu_bar(ui, &mut self.state);
        crate::chrome::toolbar(ui, &mut self.state);
        crate::chrome::status_bar(ui, &self.state);
        egui::CentralPanel::default()
            .frame(egui::Frame::central_panel(ui.style()).inner_margin(0.0))
            .show(ui, |ui| {
                self.sync_tools();
                let dock_style = egui_dock::Style::from_egui(ui.style().as_ref());
                let bar = dock_style.tab_bar.height;
                // Hidden, the right-hand group leaves a strip with the button
                // that shows it again.
                if self.state.settings.tools_hidden {
                    egui::Panel::right("tools_strip")
                        .resizable(false)
                        .exact_size(bar)
                        .frame(egui::Frame::new().fill(ui.visuals().panel_fill))
                        .show(ui, |ui| {
                            let rect =
                                egui::Rect::from_min_size(ui.max_rect().min, egui::vec2(bar, bar));
                            ui.painter()
                                .rect_filled(rect, 0.0, dock_style.tab_bar.bg_fill);
                            if tools_button(ui, rect, true) {
                                self.state.settings.tools_hidden = false;
                            }
                        });
                }
                self.fix_tools_width();
                let tools_rect = |dock: &DockState<Tab>| {
                    dock.find_tab(&TOOL_TABS[0])
                        .and_then(|path| dock.leaf(path.node_path()).ok())
                        .map(|leaf| leaf.rect)
                };
                // Width of the right-hand group, as laid out last frame, less
                // the hide button at the right of its tab bar.
                let tools_width =
                    tools_rect(&self.dock).map_or(0.0, |rect| (rect.width() - bar).max(0.0));
                // File tabs alone in their group cannot be split from it.
                let alone = self
                    .dock
                    .iter_leaves()
                    .filter_map(|(_, leaf)| match leaf.tabs() {
                        [Tab::Editor(path)] => Some(path.clone()),
                        _ => None,
                    })
                    .collect();
                self.state.tab_rects.clear();
                let mut viewer = crate::tabs::Viewer {
                    state: &mut self.state,
                    tools_width,
                    alone,
                };
                // egui_dock's own dragging is off: it would move every tab
                // anywhere. File tabs are dragged by `drag_tab` instead. Only
                // editor tabs can be closed; the separators resize the groups.
                egui_dock::DockArea::new(&mut self.dock)
                    .style(dock_style)
                    .draggable_tabs(false)
                    .tab_context_menus(false)
                    .show_leaf_collapse_buttons(false)
                    .show_leaf_close_all_buttons(false)
                    .show_inside(ui, &mut viewer);
                if let Some(rect) = tools_rect(&self.dock) {
                    let button = egui::Rect::from_min_size(
                        egui::pos2(rect.right() - bar, rect.top()),
                        egui::vec2(bar, bar),
                    );
                    if tools_button(ui, button, false) {
                        self.state.settings.tools_hidden = true;
                    }
                }
            });
        self.hide_fixed_separator_cursor(&ctx);
        self.drag_tab(&ctx);
        crate::chrome::dialogs(&ctx, &mut self.state);
        self.monitor_window(&ctx);

        while !self.state.actions.is_empty() {
            let actions = std::mem::take(&mut self.state.actions);
            for action in actions {
                self.perform(action, &ctx);
            }
        }
        self.update_title(&ctx);
    }

    fn shortcuts(&mut self, ctx: &egui::Context) {
        use crate::shortcuts::{Command as C, consume_command};
        use egui::{Key, KeyboardShortcut as K, Modifiers as M};
        // The settings dialog is waiting for a new shortcut.
        if matches!(
            self.state.dialog,
            Some(Dialog::Settings {
                capture: Some(_),
                ..
            })
        ) {
            return;
        }
        let keys = self.state.settings.shortcuts.clone();
        // Close tab (Ctrl+W) closes the tab when its key is released; R or
        // K pressed while it is held closes the other tabs or all of them
        // instead. First: Ctrl+K is also a shortcut.
        let close = keys.get(C::CloseTab);
        if consume_command(ctx, &keys, C::CloseTab) {
            self.close_chord.get_or_insert(false);
        }
        if let Some(chord) = &mut self.close_chord {
            let modifiers = close.map_or(M::COMMAND, |c| c.modifiers);
            let (others, all) = ctx.input_mut(|i| {
                (
                    crate::shortcuts::consume(i, K::new(modifiers, Key::R)),
                    crate::shortcuts::consume(i, K::new(modifiers, Key::K)),
                )
            });
            if others {
                *chord = true;
                self.state
                    .actions
                    .push(Action::CloseGroup(TabGroup::Others(None)));
            }
            if all {
                *chord = true;
                self.state.actions.push(Action::CloseGroup(TabGroup::All));
            }
            if close.is_none_or(|c| !ctx.input(|i| i.key_down(c.logical_key))) {
                if !*chord {
                    self.state.actions.push(Action::CloseCurrentTab);
                }
                self.close_chord = None;
            }
        }
        let table = [
            (C::Build, Action::Assemble),
            (C::Build2, Action::Assemble),
            (C::Run, Action::Run),
            (C::Pause, Action::Pause),
            (C::StepOut, Action::StepOut),
            (C::StepOut2, Action::StepOut),
            (C::StepOver, Action::StepOver),
            (C::StepInto, Action::StepInto),
            (C::Restart, Action::Restart),
            (C::Reset, Action::Reset),
            (C::SaveAll, Action::SaveAll),
            (C::Save, Action::Save),
            (C::OpenProject, Action::OpenProjectDialog),
            (C::FindInFiles, Action::OpenFind(FindMode::Files)),
            (C::Find, Action::OpenFind(FindMode::File)),
            (C::FoldAll, Action::FoldAll(true)),
            (C::UnfoldAll, Action::FoldAll(false)),
        ];
        for (command, action) in table {
            if consume_command(ctx, &keys, command) {
                self.state.actions.push(action);
            }
        }
        // egui's text box deletes text on Ctrl+H, K, U and W (Emacs keys):
        // they are not passed to it, even when no command has them.
        ctx.input_mut(|i| {
            i.events.retain(|e| {
                !matches!(e, egui::Event::Key { key: Key::H | Key::K | Key::U | Key::W, modifiers, .. }
                    if modifiers.ctrl && !modifiers.alt)
            })
        });
        // Escape closes the find bar, from the editor too (the find bar's own
        // field handles it by itself; the monitor sends it to the HBC-2).
        let editor_focused = |m: &egui::Memory| {
            self.state
                .active_editor
                .as_ref()
                .is_some_and(|p| m.has_focus(editor_id(p)))
        };
        if self.state.find.mode.is_some()
            && ctx.memory(|m| m.focused().is_none() || editor_focused(m))
            && ctx.input_mut(|i| i.consume_key(M::NONE, Key::Escape))
        {
            self.state.actions.push(Action::CloseFind);
        }
        // A focused text field undoes its own edits; with nothing focused,
        // undo works on the editor tab.
        if ctx.memory(|m| m.focused().is_none()) {
            let table = [
                (K::new(M::COMMAND | M::SHIFT, Key::Z), Action::Redo),
                (K::new(M::COMMAND, Key::Y), Action::Redo),
                (K::new(M::COMMAND, Key::Z), Action::Undo),
            ];
            for (shortcut, action) in table {
                if ctx.input_mut(|i| i.consume_shortcut(&shortcut)) {
                    self.state.actions.push(action);
                }
            }
        }
    }

    /// Reacts to the emulator pausing by itself, and follows the PC in the editor.
    fn watch_emulator(&mut self) {
        let s = self.state.snapshot.clone();
        // A new stop has a new cycle count (a run can reach a breakpoint before
        // any "running" snapshot is seen).
        if let Some(stop @ hbc2_core::StopReason::Breakpoint(address)) = s.stop
            && self.state.reported_stop != Some((s.ticks, stop))
        {
            self.state.reported_stop = Some((s.ticks, stop));
            let place = self.state.source_location(address).map(|(path, line)| {
                format!(
                    " ({}:{line})",
                    path.file_name().unwrap_or_default().to_string_lossy()
                )
            });
            self.state.console.info(format!(
                "Breakpoint at {address:04X}{} after {} cycles.",
                place.unwrap_or_default(),
                crate::views::cpu::group_digits(s.ticks)
            ));
        }
        if s.trace_ends != self.state.reported_trace_ends {
            self.state.reported_trace_ends = s.trace_ends;
            if let Some(end) = &s.trace_end {
                self.state.report_trace_end(end);
            }
        }
        if s.ticks > 0 && self.state.settings.follow_pc && self.state.follows_execution() {
            let key = (s.ticks, s.cpu.pc);
            let running = s.state == RunState::Running;
            // While running, the cycle count changes with every snapshot:
            // only a new PC moves the editor.
            let new = match self.state.followed {
                Some((_, pc)) if running => pc != s.cpu.pc,
                followed => followed != Some(key),
            };
            if new {
                self.state.followed = Some(key);
                if let Some((path, line)) = self.state.source_location(s.cpu.pc) {
                    self.open_file(&path, Some(line));
                    if let Some(doc) = self.state.docs.iter_mut().find(|d| d.path == path) {
                        doc.scroll_gently = running;
                    }
                }
            }
        }
    }

    /// Every second or so: reload files changed on disk, refresh the file list.
    fn check_disk(&mut self, ctx: &egui::Context) {
        let now = ctx.input(|i| i.time);
        if now - self.state.last_disk_check < 1.5 {
            return;
        }
        self.state.last_disk_check = now;
        for doc in &mut self.state.docs {
            let was_conflict = doc.conflict;
            if doc.check_disk() {
                self.state.edits += 1;
                self.state
                    .console
                    .info(format!("Reloaded {} (changed on disk).", doc.name()));
            } else if doc.conflict && !was_conflict {
                self.state.console.warning(format!(
                    "{} changed on disk, and has unsaved changes here.",
                    doc.name()
                ));
            }
        }
        if let Some(project) = &mut self.state.project {
            project.rescan();
        }
        self.state.refresh_signatures();
    }

    /// Takes the right-hand group out of the layout or puts it back, as
    /// the setting asks.
    fn sync_tools(&mut self) {
        match (self.state.settings.tools_hidden, self.tools_stash) {
            (true, None) => self.tools_stash = hide_tools(&mut self.dock),
            (false, Some(stash)) => {
                show_tools(&mut self.dock, stash);
                self.tools_stash = None;
            }
            _ => {}
        }
    }

    /// Gives the right-hand group exactly the width the "CPU & I/O" tab
    /// needs. Done before the dock is drawn, it also undoes any drag of the
    /// separator, so that group's width is fixed.
    fn fix_tools_width(&mut self) {
        let need = self.state.tools_min_width;
        if need <= 0.0 {
            return; // not measured yet
        }
        let Some((node, _)) = self.dock.find_main_surface_tab(&TOOL_TABS[0]) else {
            return;
        };
        let Some(parent) = node.parent().filter(|_| node.is_right()) else {
            return;
        };
        if let Node::Horizontal(split) = &mut self.dock.main_surface_mut()[parent] {
            let total = split.rect.width();
            if total > 0.0 {
                split.fraction = ((total - need) / total).clamp(0.05, 0.95);
            }
        }
    }

    /// A file tab being dragged: shows where it would go, and moves it there
    /// when the mouse button is released. Escape cancels.
    fn drag_tab(&mut self, ctx: &egui::Context) {
        let Some(path) = self.state.tab_drag.clone() else {
            return;
        };
        if ctx.input(|i| i.key_pressed(egui::Key::Escape)) {
            self.state.tab_drag = None;
            return;
        }
        let tab = Tab::Editor(path.clone());
        let Some(pointer) = ctx.pointer_latest_pos() else {
            return;
        };
        let target = editor_groups::drop_target(&self.dock, &tab, &self.state.tab_rects, pointer);
        if !ctx.input(|i| i.pointer.primary_down()) {
            self.state.tab_drag = None;
            if let Some((drop, _)) = target {
                self.state.actions.push(Action::MoveTab(path, drop));
            }
            return;
        }

        ctx.set_cursor_icon(egui::CursorIcon::Grabbing);
        let layer = egui::LayerId::new(egui::Order::Tooltip, egui::Id::new("tab_drag"));
        let painter = ctx.layer_painter(layer);
        let accent = ctx.global_style().visuals.selection.bg_fill;
        if let Some((_, rect)) = target {
            painter.rect_filled(rect, 0.0, accent.gamma_multiply(0.35));
        }
        // The file name follows the pointer.
        let name = path.file_name().unwrap_or_default().to_string_lossy();
        let font = egui::TextStyle::Button.resolve(&ctx.global_style());
        let text_color = ctx.global_style().visuals.strong_text_color();
        let galley = painter.layout_no_wrap(name.to_string(), font, text_color);
        let at = pointer + egui::vec2(12.0, 8.0);
        let label = egui::Rect::from_min_size(at, galley.size()).expand2(egui::vec2(6.0, 3.0));
        painter.rect_filled(label, 2.0, ctx.global_style().visuals.window_fill);
        painter.rect_stroke(label, 2.0, (1.0, accent), egui::StrokeKind::Inside);
        painter.galley(at, galley, text_color);
        ctx.request_repaint();
    }

    /// The separator left of the right-hand group cannot be dragged: no
    /// resize cursor over it.
    fn hide_fixed_separator_cursor(&self, ctx: &egui::Context) {
        let Some(rect) = self
            .dock
            .find_tab(&TOOL_TABS[0])
            .and_then(|path| self.dock.leaf(path.node_path()).ok())
            .map(|leaf| leaf.rect)
        else {
            return;
        };
        let Some(pointer) = ctx.pointer_hover_pos() else {
            return;
        };
        let near = (pointer.x - rect.left()).abs() <= 8.0;
        if near && (rect.top()..=rect.bottom()).contains(&pointer.y) {
            ctx.set_cursor_icon(egui::CursorIcon::Default);
        }
    }

    /// The HBC-2 monitor, in a window of its own.
    fn monitor_window(&mut self, ctx: &egui::Context) {
        if !self.state.settings.monitor_window {
            self.monitor_geometry = None;
            self.monitor_on_top = false;
            return;
        }
        // Chosen when the window opens, then kept: a change would move it.
        let (size, position) = match self.monitor_geometry {
            Some(geometry) => geometry,
            None => {
                let settings = self.state.settings.monitor;
                let remembered = self
                    .state
                    .settings
                    .monitor_geometry
                    .filter(|_| settings.remember_position);
                let (size, position) = match remembered {
                    Some([x, y, width, height]) => {
                        (egui::vec2(width, height), Some(egui::pos2(x, y)))
                    }
                    None => {
                        let size = if settings.sharp_scaling {
                            crate::views::monitor::window_size(settings.pixel_size)
                        } else {
                            egui::vec2(600.0, 480.0)
                        };
                        let position = ctx.input(|i| {
                            crate::placement::window_position(
                                i.viewport(),
                                size,
                                settings.placement,
                            )
                        });
                        (size, position)
                    }
                };
                // Without the screen size yet, tried again next frame.
                if position.is_some() {
                    self.monitor_geometry = Some((size, position));
                }
                (size, position)
            }
        };
        let state = &mut self.state;
        let snapshot = &state.snapshot;
        let mut builder = egui::ViewportBuilder::default()
            .with_title(crate::owner::MONITOR_TITLE)
            .with_inner_size(size)
            .with_min_inner_size([300.0, 250.0])
            .with_icon(crate::icon());
        if let Some(position) = position {
            builder = builder.with_position(position);
        }
        let id = egui::ViewportId::from_hash_of("hbc2-monitor");
        let mut monitor_focused = false;
        ctx.show_viewport_immediate(id, builder, |ui, _class| {
            egui::CentralPanel::default().show(ui, |ui| {
                state.monitor_view.ui(
                    ui,
                    snapshot.monitor.as_ref(),
                    snapshot.keyboard.is_some(),
                    &state.emulator.runner,
                );
            });
            ui.input(|i| {
                let info = i.viewport();
                monitor_focused = info.focused.unwrap_or(false);
                if let (Some(outer), Some(inner), Some(false)) =
                    (info.outer_rect, info.inner_rect, info.minimized)
                {
                    state.settings.monitor_geometry =
                        Some([outer.min.x, outer.min.y, inner.width(), inner.height()]);
                }
                if info.close_requested() {
                    state.settings.monitor_window = false;
                }
            });
        });

        // Above the IDE: owned by it on Windows (`monitor_on_top` then means
        // "owned"), elsewhere on top while the IDE or the monitor has focus.
        #[cfg(windows)]
        {
            let _ = (id, monitor_focused);
            if !self.monitor_on_top {
                self.monitor_on_top = crate::owner::own_monitor();
            }
        }
        #[cfg(not(windows))]
        {
            let ide_focused = ctx.input(|i| i.viewport().focused.unwrap_or(false));
            let on_top = ide_focused || monitor_focused;
            if on_top != self.monitor_on_top {
                self.monitor_on_top = on_top;
                let level = if on_top {
                    egui::WindowLevel::AlwaysOnTop
                } else {
                    egui::WindowLevel::Normal
                };
                ctx.send_viewport_cmd_to(id, egui::ViewportCommand::WindowLevel(level));
            }
        }
    }

    fn handle_close_request(&mut self, ctx: &egui::Context) {
        if !ctx.input(|i| i.viewport().close_requested()) || self.state.quit_confirmed {
            return;
        }
        let dirty = self.state.dirty_paths();
        if !dirty.is_empty() {
            ctx.send_viewport_cmd(egui::ViewportCommand::CancelClose);
            self.state.dialog = Some(Dialog::Unsaved {
                paths: dirty,
                then: Box::new(Action::Quit),
            });
        }
    }

    fn update_title(&mut self, ctx: &egui::Context) {
        let dirty = if self.state.dirty_paths().is_empty() {
            ""
        } else {
            " •"
        };
        let title = match &self.state.project {
            Some(p) => format!("{}{dirty} — HBC-2 IDE", p.name()),
            None => "HBC-2 IDE".to_string(),
        };
        if title != self.state.title {
            ctx.send_viewport_cmd(egui::ViewportCommand::Title(title.clone()));
            self.state.title = title;
        }
    }

    // ---------------------------------------------------------------- actions

    pub fn perform(&mut self, action: Action, ctx: &egui::Context) {
        let state = &mut self.state;
        match action {
            Action::NewProject => {
                if state.guard_unsaved(state.dirty_paths(), Action::NewProject) {
                    return;
                }
                state.dialog = Some(Dialog::NewProject {
                    parent: state.settings.projects_folder(),
                    own_folder: state.settings.general.project_folder,
                    name: "newProject".into(),
                    language: Language::Assembly,
                    devices: true,
                    error: None,
                });
            }
            Action::CreateProject(dir, language, devices) => {
                match Project::create(&dir, language, devices) {
                    Ok(project) => {
                        let root = project.root.clone();
                        let peripherals = state.settings.emulator.new_project_peripherals;
                        state.settings.projects.insert(
                            root.clone(),
                            ProjectSettings {
                                peripherals,
                                ..ProjectSettings::default()
                            },
                        );
                        self.open_project(&root, true);
                    }
                    Err(e) => state.message("Cannot create the project", e.to_string()),
                }
            }
            Action::OpenProjectDialog => {
                if let Some(dir) = projects_dialog(&state.settings)
                    .set_title("Open a project folder")
                    .pick_folder()
                {
                    state.actions.push(Action::OpenProject(dir));
                }
            }
            Action::OpenProject(root) => {
                let same = project::absolute(&root).ok();
                if state
                    .project
                    .as_ref()
                    .is_some_and(|p| Some(&p.root) == same.as_ref())
                {
                    return; // already open
                }
                if state.guard_unsaved(state.dirty_paths(), Action::OpenProject(root.clone())) {
                    return;
                }
                self.open_project(&root, true);
            }
            Action::CloseProject => {
                if state.guard_unsaved(state.dirty_paths(), Action::CloseProject) {
                    return;
                }
                self.close_project();
                self.state.settings.last_project = None;
            }
            Action::OpenFileDialog => {
                let mut dialog =
                    rfd::FileDialog::new().add_filter("HBC-2 source", &["has", "c", "h"]);
                if let Some(project) = &state.project {
                    dialog = dialog.set_directory(&project.root);
                }
                if let Some(path) = dialog.pick_file() {
                    state.actions.push(Action::OpenFile(path, None));
                }
            }
            Action::OpenFile(path, line) => self.open_file(&path, line),
            Action::NewFile(dir) => {
                let c = state
                    .project
                    .as_ref()
                    .is_some_and(|p| p.language == Language::C);
                state.dialog = Some(Dialog::NewFile {
                    dir,
                    name: if c { "newFile.c" } else { "newFile.has" }.into(),
                    error: None,
                    select_stem: true,
                })
            }
            Action::NewFolder(dir) => {
                state.dialog = Some(Dialog::NewFolder {
                    dir,
                    name: "lib".into(),
                    error: None,
                })
            }
            Action::RenameFile(path) => {
                let name = path
                    .file_name()
                    .unwrap_or_default()
                    .to_string_lossy()
                    .into();
                state.dialog = Some(Dialog::Rename {
                    path,
                    name,
                    error: None,
                    select_stem: true,
                });
            }
            Action::DeleteFile(path) => state.dialog = Some(Dialog::Delete { path }),
            Action::RefreshFiles => {
                if let Some(project) = &mut state.project {
                    project.rescan();
                }
            }
            Action::ShowFolder(path) => show_in_file_manager(&path),
            Action::MovePath(from, to_dir) => self.move_path(&from, &to_dir),
            Action::Save => {
                if let Some(path) = self.current_editor() {
                    self.state.save(&[path]);
                }
            }
            Action::SaveAll => {
                let paths = state.dirty_paths();
                state.save(&paths);
            }
            Action::CloseTab(path) => self.state.actions.push(Action::CloseTabs(vec![path])),
            Action::CloseTabs(paths) => {
                if state.guard_unsaved(paths.clone(), Action::CloseTabs(paths.clone())) {
                    return;
                }
                self.remove_editor_tabs(|p| paths.iter().any(|q| q == p));
                self.state.docs.retain(|d| !paths.contains(&d.path));
            }
            Action::CloseGroup(group) => {
                let paths = self.tab_group(group);
                if !paths.is_empty() {
                    self.state.actions.push(Action::CloseTabs(paths));
                }
            }
            Action::MoveTab(path, drop) => {
                editor_groups::move_tab(&mut self.dock, &Tab::Editor(path.clone()), drop);
                self.last_editor = Some(path);
            }
            Action::SplitRight(path) => {
                let tab = Tab::Editor(path.clone());
                if let Some(anchor) = editor_groups::split_anchor(&self.dock, &tab) {
                    editor_groups::move_tab(&mut self.dock, &tab, Drop::SplitRight(anchor));
                    self.last_editor = Some(path);
                }
            }
            Action::CloseCurrentTab => {
                if let Some(path) = self.current_editor() {
                    self.state.actions.push(Action::CloseTab(path));
                }
            }
            Action::Undo | Action::Redo => {
                // Files cannot be edited while the program runs.
                if self.state.snapshot.state == RunState::Running {
                    return;
                }
                if let Some(path) = self.active_editor() {
                    self.state.undo(ctx, &path, matches!(action, Action::Redo));
                }
            }
            Action::FoldAll(fold) => {
                if let Some(path) = self.active_editor()
                    && let Some(doc) = self.state.docs.iter_mut().find(|d| d.path == path)
                {
                    if fold {
                        let syntax = crate::highlight::Syntax::of(&doc.path);
                        doc.folds.fold_all(&doc.text, syntax);
                    } else {
                        doc.folds.unfold_all();
                    }
                }
            }
            Action::OpenFind(mode) => {
                let editor = self.active_editor();
                let state = &mut self.state;
                match mode {
                    FindMode::File if editor.is_none() => return,
                    FindMode::Files if state.project.is_none() => {
                        return state.console.error("Open a project first (File menu).");
                    }
                    _ => {}
                }
                // Search for the selected text, when it is on one line.
                if let Some(path) = &editor
                    && let Some(doc) = state.docs.iter().find(|d| &d.path == path)
                    && let Some(range) = egui::text_edit::TextEditState::load(ctx, editor_id(path))
                        .and_then(|s| s.cursor.char_range())
                {
                    let range = range.as_sorted_char_range();
                    let selected: String = doc
                        .text
                        .chars()
                        .skip(range.start.0)
                        .take(range.end.0 - range.start.0)
                        .collect();
                    if !selected.is_empty() && !selected.contains('\n') {
                        state.find.query = selected;
                    }
                }
                state.find.mode = Some(mode);
                state.find.focus_query = true;
                state.find.current = None;
            }
            Action::CloseFind => {
                let find = &mut state.find;
                find.mode = None;
                // Back in the editor, the current match is selected.
                if let Some((path, m)) = find.current.take()
                    && let Some(doc) = state.docs.iter_mut().find(|d| d.path == path)
                {
                    doc.select = Some(m);
                }
                if let Some(path) = self.active_editor()
                    && let Some(doc) = self.state.docs.iter_mut().find(|d| d.path == path)
                {
                    doc.focus = true;
                }
            }
            Action::ShowMatch {
                path,
                line,
                columns,
            } => {
                let path = project::absolute(&path).unwrap_or(path);
                self.open_file(&path, None);
                if let Some(doc) = self.state.docs.iter_mut().find(|d| d.path == path) {
                    let start = char_index_of_line(&doc.text, line);
                    doc.select = Some(start + columns.start..start + columns.end);
                    // The editor keeps its selection only while it has the keyboard.
                    doc.focus = true;
                }
            }
            Action::Assemble => {
                let loaded = state.assemble();
                if state.settings.build.run_after_build {
                    match &mut state.building {
                        Some(pending) => pending.then = Some(Action::Run),
                        None if loaded => state.actions.push(Action::Run),
                        None => {}
                    }
                }
            }
            Action::Run => {
                if state.prepare_to_run(Action::Run) {
                    state.emulator.run();
                }
            }
            Action::Pause => state.emulator.pause(),
            Action::StepInto => {
                if state.prepare_to_run(Action::StepInto) {
                    let pc = state.emulator.runner.sync().cpu.pc;
                    match state.c_line_addresses(pc) {
                        Some(addresses) => state.emulator.step_within(addresses),
                        None => state.emulator.step(1),
                    }
                }
            }
            Action::StepOver => {
                if state.prepare_to_run(Action::StepOver) {
                    let pc = state.emulator.runner.sync().cpu.pc;
                    // Assembly: one instruction (with the routine it calls).
                    let addresses = state.c_line_addresses(pc).unwrap_or_default();
                    state.emulator.step_over(addresses);
                }
            }
            Action::StepOut => {
                if state.prepare_to_run(Action::StepOut) {
                    state.emulator.step_out();
                }
            }
            Action::Reset => {
                // Paused at the first instruction: no tab opens until a run or a step.
                state.emulator.reset();
                state.followed = None;
                state.console.info("The machine was reset.");
            }
            Action::Restart => {
                state.emulator.restart();
                state.followed = None;
                state
                    .console
                    .info("The machine was restarted (power off and on).");
            }
            Action::ExportImage => state.export_image(),
            Action::ExportBootRom => state.export_boot_rom(),
            Action::ToggleTrace => state.toggle_trace(),
            Action::LoadImage => state.load_image(),
            Action::SaveEeprom => state.save_eeprom(),
            Action::LoadEeprom => state.load_eeprom(),
            Action::SetStrip(strip) => {
                if state.project_settings.strip != strip {
                    state.project_settings.strip = strip;
                    state.edits += 1; // the loaded build no longer matches
                    let what = if strip {
                        "Unused code is left out"
                    } else {
                        "Unused code is kept"
                    };
                    state
                        .console
                        .info(format!("{what}. Assemble (F7) to rebuild."));
                }
            }
            Action::SetPeripherals(peripherals) => {
                state.project_settings.peripherals = peripherals;
                state.emulator.peripherals = peripherals;
                let breakpoints = state.breakpoint_addresses();
                match state.emulator.rebuild(&breakpoints) {
                    Ok(()) => state
                        .console
                        .info("Peripherals changed: the machine was reset."),
                    Err(e) => state.console.error(e),
                }
            }
            Action::SetSpeed(speed) => {
                state.settings.speed = speed.into();
                state.emulator.runner.set_speed(speed);
            }
            Action::RtcInterrupt => state.emulator.runner.exec(|machine| {
                machine.rtc_interrupt();
            }),
            Action::BreakpointsChanged => {
                if state.emulator.program.is_some() {
                    let addresses = state.breakpoint_addresses();
                    state.emulator.set_breakpoints(&addresses);
                }
            }
            Action::ToggleAddressBreakpoint(address) => {
                if let Some((path, line)) = state.source_location(address) {
                    let lines = state.project_settings.breakpoints.entry(path).or_default();
                    if !lines.remove(&line) {
                        lines.insert(line);
                    }
                    state.actions.push(Action::BreakpointsChanged);
                } else {
                    let on = !state.snapshot.breakpoints.contains(address);
                    state.emulator.runner.set_breakpoint(address, on);
                }
            }
            Action::Quit => {
                state.quit_confirmed = true;
                ctx.send_viewport_cmd(egui::ViewportCommand::Close);
            }
            Action::ShowDialog(dialog) => state.dialog = Some(dialog),
        }
    }

    pub fn open_project(&mut self, root: &Path, restore_files: bool) {
        let project = match Project::open(root) {
            Ok(project) => project,
            Err(e) => {
                self.state.message("Cannot open the project", e.to_string());
                if self.state.settings.last_project.as_deref() == Some(root) {
                    self.state.settings.last_project = None;
                }
                return;
            }
        };
        self.close_project();
        let state = &mut self.state;
        let root = project.root.clone();
        state.settings.add_recent(&root);
        state.settings.last_project = Some(root.clone());
        state.project_settings = state
            .settings
            .projects
            .get(&root)
            .cloned()
            .unwrap_or_default();
        state.emulator.peripherals = state.project_settings.peripherals;
        let _ = state.emulator.rebuild(&[]);
        state
            .console
            .info(format!("Opened project {}.", root.display()));
        let mut files = if restore_files {
            state.project_settings.open_files.clone()
        } else {
            Vec::new()
        };
        if restore_files && files.is_empty() {
            files.push(project.entry());
        }
        state.project = Some(project);
        for path in files {
            if path.is_file() {
                self.open_file(&path, None);
            }
        }
        if restore_files && let Some(layout) = self.state.project_settings.editor_layout.clone() {
            editor_groups::restore_layout(&mut self.dock, layout);
        }
        self.state.refresh_signatures();
    }

    fn close_project(&mut self) {
        self.store_project_settings();
        let state = &mut self.state;
        if state.project.take().is_none() {
            return;
        }
        state.docs.clear();
        state.build = None;
        state.building = None; // its result is not wanted any more
        state.loaded_edits = None;
        state.project_settings = ProjectSettings::default();
        state.emulator.peripherals = Peripherals::default();
        state.emulator.unload();
        state.followed = None;
        state.signatures = Signatures::default();
        self.remove_editor_tabs(|_| true);
    }

    /// Removes the editor tabs whose path matches (see
    /// [`crate::editor_groups::remove_editor_tabs`]).
    fn remove_editor_tabs(&mut self, remove: impl Fn(&Path) -> bool) {
        editor_groups::remove_editor_tabs(&mut self.dock, remove);
    }

    /// Moves a file or folder into `dir`, on disk and in the open editors
    /// and breakpoints.
    fn move_path(&mut self, from: &Path, dir: &Path) {
        let state = &mut self.state;
        let Some(name) = from.file_name() else { return };
        let to = dir.join(name);
        let shown = |path: &Path| match &state.project {
            Some(project) => project.include_path(path),
            None => path.display().to_string(),
        };
        if to.exists() {
            let error = format!(
                "Cannot move {}: {} already exists.",
                shown(from),
                shown(&to)
            );
            return state.console.error(error);
        }
        if let Err(e) = std::fs::rename(from, &to) {
            let error = format!("Cannot move {}: {e}", shown(from));
            return state.console.error(error);
        }
        let info = format!(
            "Moved {} to {}. .include lines that use the old path must be updated by hand.",
            shown(from),
            shown(&to)
        );
        state.console.info(info);

        // A path inside what moved, at its new place.
        let moved = |path: &Path| {
            let rest = path.strip_prefix(from).ok()?;
            Some(if rest.as_os_str().is_empty() {
                to.clone()
            } else {
                to.join(rest)
            })
        };
        for doc in &mut state.docs {
            if let Some(new) = moved(&doc.path) {
                doc.set_path(new);
            }
        }
        for (_, tab) in self.dock.iter_all_tabs_mut() {
            if let Tab::Editor(path) = tab
                && let Some(new) = moved(path)
            {
                *path = new;
            }
        }
        let breakpoints = &mut state.project_settings.breakpoints;
        let old: Vec<PathBuf> = breakpoints
            .keys()
            .filter(|path| path.starts_with(from))
            .cloned()
            .collect();
        for path in old {
            if let (Some(lines), Some(new)) = (breakpoints.remove(&path), moved(&path)) {
                breakpoints.insert(new, lines);
            }
        }
        state.edits += 1;
        state.actions.push(Action::RefreshFiles);
    }

    pub fn open_file(&mut self, path: &Path, line: Option<u32>) {
        let path = match project::absolute(path) {
            Ok(path) => path,
            Err(e) => return self.state.console.error(format!("{}: {e}", path.display())),
        };
        if !self.state.docs.iter().any(|d| d.path == path) {
            match Document::open(&path) {
                Ok(doc) => self.state.docs.push(doc),
                Err(e) => {
                    return self
                        .state
                        .console
                        .error(format!("Cannot open {}: {e}", path.display()));
                }
            }
        }
        let tab = Tab::Editor(path.clone());
        if let Some(found) = self.dock.find_tab(&tab) {
            let _ = self.dock.set_active_tab(found);
            self.dock.set_focused_node_and_surface(found.node_path());
        } else {
            self.add_editor_tab(tab);
        }
        if let Some(doc) = self.state.docs.iter_mut().find(|d| d.path == path) {
            doc.scroll_to = line.or(doc.scroll_to);
            doc.scroll_gently = false;
        }
    }

    /// Puts a new editor tab in the editor group last used, or in place of
    /// the start page.
    fn add_editor_tab(&mut self, tab: Tab) {
        let near = self
            .active_editor()
            .and_then(|path| self.dock.find_tab(&Tab::Editor(path)))
            .or_else(|| self.dock.find_tab(&Tab::Welcome));
        match near.and_then(|path| self.dock.leaf_mut(path.node_path()).ok()) {
            Some(leaf) => leaf.append_tab(tab.clone()),
            None => self.dock.push_to_first_leaf(tab.clone()),
        }
        // The editor group holds the new tab, so it stays when the start page goes.
        if let Some(welcome) = self.dock.find_tab(&Tab::Welcome) {
            self.dock.remove_tab(welcome);
        }
        if let Some(found) = self.dock.find_tab(&tab) {
            let _ = self.dock.set_active_tab(found);
            self.dock.set_focused_node_and_surface(found.node_path());
        }
    }

    /// Path of the editor tab shown in the editor group last used, focused
    /// or not (the first group if that one is gone).
    fn active_editor(&self) -> Option<PathBuf> {
        let path = self
            .last_editor
            .as_ref()
            .and_then(|path| self.dock.find_tab(&Tab::Editor(path.clone())))
            .or_else(|| self.dock.find_tab_from(|t| matches!(t, Tab::Editor(_))))?;
        let leaf = self.dock.leaf(path.node_path()).ok()?;
        match leaf.tabs.get(leaf.active.0) {
            Some(Tab::Editor(path)) => Some(path.clone()),
            _ => None,
        }
    }

    /// The open editors in `group`, in tab order.
    fn tab_group(&mut self, group: TabGroup) -> Vec<PathBuf> {
        let editors: Vec<PathBuf> = self
            .dock
            .iter_all_tabs()
            .filter_map(|(_, t)| match t {
                Tab::Editor(path) => Some(path.clone()),
                _ => None,
            })
            .collect();
        match group {
            TabGroup::ToTheRight(path) => {
                let Some(at) = self.dock.find_tab(&Tab::Editor(path)) else {
                    return Vec::new();
                };
                let Ok(leaf) = self.dock.leaf(at.node_path()) else {
                    return Vec::new();
                };
                leaf.tabs()[at.tab.0 + 1..]
                    .iter()
                    .filter_map(|t| match t {
                        Tab::Editor(path) => Some(path.clone()),
                        _ => None,
                    })
                    .collect()
            }
            TabGroup::Saved => editors
                .into_iter()
                .filter(|p| !self.state.docs.iter().any(|d| &d.path == p && d.is_dirty()))
                .collect(),
            TabGroup::Others(path) => {
                let Some(keep) = path.or_else(|| self.current_editor()) else {
                    return Vec::new();
                };
                editors.into_iter().filter(|p| *p != keep).collect()
            }
            TabGroup::All => editors,
        }
    }

    /// Path of the editor tab in the focused group, if it is an editor.
    fn current_editor(&mut self) -> Option<PathBuf> {
        match self.dock.find_active_focused() {
            Some((_, Tab::Editor(path))) => Some(path.clone()),
            _ => None,
        }
    }
}
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
