SteriCraft/hbc2-ide/hbc2/crates/hbc2-ide/src/chrome.rs

//! Menu bar, toolbar, status bar, start page and dialogs.

use eframe::egui::{self, Align, Button, Color32, Layout, RichText};
use hbc2_core::StopReason;
use hbc2_runner::{RunState, Speed};

use crate::app::{Action, Dialog, SettingsPage, State, can_undo};
use crate::find::FindMode;
use crate::project::{
    Language, folder_name, new_file_content, project_folder_name, source_file_name,
};
use crate::settings::{MonitorSettings, Placement, SPEEDS, Settings, frequency_label, speed_label};
use crate::shortcuts::{self, Category, Command};

fn shortcut_button(text: &str, shortcut: String) -> Button<'static> {
    Button::new(text.to_string()).shortcut_text(shortcut)
}

/// Why the option is off for a C project.
const C_STRIPS: &str = "C programs always leave out unused code";

fn build_label(c_project: bool) -> &'static str {
    if c_project { "Build" } else { "Assemble" }
}

fn is_c_project(state: &State) -> bool {
    state
        .project
        .as_ref()
        .is_some_and(|p| p.language == Language::C)
}

pub fn menu_bar(ui: &mut egui::Ui, state: &mut State) {
    let c_project = is_c_project(state);
    let building = state.is_building();
    let actions = &mut state.actions;
    let has_project = state.project.is_some();
    let keys = state.settings.shortcuts.clone();
    let key = |command| keys.text(command);
    egui::Panel::top("menu_bar").show(ui, |ui| {
        egui::MenuBar::new().ui(ui, |ui| {
            ui.menu_button("File", |ui| {
                if ui.button("New project…").clicked() {
                    actions.push(Action::NewProject);
                }
                if ui.add(shortcut_button("Open project…", key(Command::OpenProject))).clicked() {
                    actions.push(Action::OpenProjectDialog);
                }
                ui.add_enabled_ui(!state.settings.recent_projects.is_empty(), |ui| {
                    ui.menu_button("Recent projects", |ui| {
                        for root in &state.settings.recent_projects {
                            if ui.button(root.display().to_string()).clicked() {
                                actions.push(Action::OpenProject(root.clone()));
                            }
                        }
                    });
                });
                if ui
                    .add_enabled(has_project, Button::new("Close project"))
                    .clicked()
                {
                    actions.push(Action::CloseProject);
                }
                ui.separator();
                if ui
                    .add_enabled(has_project, Button::new("New file…"))
                    .clicked()
                    && let Some(project) = &state.project
                {
                    actions.push(Action::NewFile(project.root.clone()));
                }
                if ui.button("Open file…").clicked() {
                    actions.push(Action::OpenFileDialog);
                }
                if ui.add(shortcut_button("Save", key(Command::Save))).clicked() {
                    actions.push(Action::Save);
                }
                if ui
                    .add(shortcut_button("Save all", key(Command::SaveAll)))
                    .clicked()
                {
                    actions.push(Action::SaveAll);
                }
                ui.separator();
                if ui.button("Settings…").clicked() {
                    actions.push(Action::ShowDialog(Dialog::Settings {
                        page: SettingsPage::General,
                        draft: Box::new(state.settings.clone()),
                        capture: None,
                        notice: None,
                    }));
                }
                ui.separator();
                if ui.button("Quit").clicked() {
                    ui.ctx().send_viewport_cmd(egui::ViewportCommand::Close);
                }
            });

            ui.menu_button("Edit", |ui| {
                let editor = state.active_editor.is_some();
                let (can_undo, can_redo) = match &state.active_editor {
                    Some(path) => (
                        can_undo(&state.docs, ui.ctx(), path, false),
                        can_undo(&state.docs, ui.ctx(), path, true),
                    ),
                    None => (false, false),
                };
                if ui
                    .add_enabled(can_undo, shortcut_button("Undo", "Ctrl+Z".into()))
                    .clicked()
                {
                    actions.push(Action::Undo);
                }
                if ui
                    .add_enabled(can_redo, shortcut_button("Redo", "Ctrl+Y".into()))
                    .clicked()
                {
                    actions.push(Action::Redo);
                }
                ui.separator();
                if ui
                    .add_enabled(editor, shortcut_button("Find…", key(Command::Find)))
                    .clicked()
                {
                    actions.push(Action::OpenFind(FindMode::File));
                }
                if ui
                    .add_enabled(
                        has_project,
                        shortcut_button("Find in files…", key(Command::FindInFiles)),
                    )
                    .clicked()
                {
                    actions.push(Action::OpenFind(FindMode::Files));
                }
                ui.separator();
                if ui
                    .add_enabled(
                        editor,
                        shortcut_button("Collapse all functions", key(Command::FoldAll)),
                    )
                    .clicked()
                {
                    actions.push(Action::FoldAll(true));
                }
                if ui
                    .add_enabled(editor, shortcut_button("Expand all", key(Command::UnfoldAll)))
                    .clicked()
                {
                    actions.push(Action::FoldAll(false));
                }
            });

            ui.menu_button("Assembler", |ui| {
                if ui
                    .add_enabled(
                        has_project && !building,
                        shortcut_button(build_label(c_project), key(Command::Build)),
                    )
                    .clicked()
                {
                    actions.push(Action::Assemble);
                }
                ui.separator();
                let mut strip = state.project_settings.strip || c_project;
                if ui
                    .add_enabled(
                        !c_project,
                        egui::Checkbox::new(&mut strip, "Leave out unused code"),
                    )
                    .on_hover_text(
                        "Labels and variables nothing reaches from _start, a fixed address or .keep are not assembled",
                    )
                    .on_disabled_hover_text(C_STRIPS)
                    .changed()
                {
                    actions.push(Action::SetStrip(strip));
                }
                ui.separator();
                let loaded = state.emulator.image().is_some();
                if ui
                    .add_enabled(loaded, Button::new("Export image…"))
                    .clicked()
                {
                    actions.push(Action::ExportImage);
                }
                if ui
                    .add_enabled(loaded, Button::new("Export boot ROM…"))
                    .on_hover_text("The RAM image as two 32 KiB files, one per AT28C256 of the hardware CPU: _lo.bin (0000-7FFF) and _hi.bin (8000-FFFF)")
                    .on_disabled_hover_text("Assemble first.")
                    .clicked()
                {
                    actions.push(Action::ExportBootRom);
                }
            });

            ui.menu_button("Emulator", |ui| {
                let running = state.snapshot.state == RunState::Running;
                if ui
                    .add_enabled(!running, shortcut_button("Run", key(Command::Run)))
                    .clicked()
                {
                    actions.push(Action::Run);
                }
                if ui
                    .add_enabled(running, shortcut_button("Pause", key(Command::Pause)))
                    .clicked()
                {
                    actions.push(Action::Pause);
                }
                if ui
                    .add_enabled(!running, shortcut_button("Step over", key(Command::StepOver)))
                    .clicked()
                {
                    actions.push(Action::StepOver);
                }
                if ui
                    .add_enabled(!running, shortcut_button("Step into", key(Command::StepInto)))
                    .clicked()
                {
                    actions.push(Action::StepInto);
                }
                if ui
                    .add_enabled(!running, shortcut_button("Step out", key(Command::StepOut)))
                    .clicked()
                {
                    actions.push(Action::StepOut);
                }
                ui.checkbox(&mut state.settings.monitor_window, "Monitor window");
                if ui.add(shortcut_button("Reset", key(Command::Reset))).clicked() {
                    actions.push(Action::Reset);
                }
                if ui.add(shortcut_button("Restart", key(Command::Restart))).clicked() {
                    actions.push(Action::Restart);
                }
                let trace_label = if state.snapshot.trace.is_some() {
                    "Stop the trace"
                } else {
                    "Record a trace…"
                };
                if ui.button(trace_label).clicked() {
                    actions.push(Action::ToggleTrace);
                }
                ui.separator();
                ui.menu_button("Clock speed", |ui| {
                    let current: Speed = state.settings.speed.into();
                    for speed in SPEEDS {
                        if ui.radio(current == speed, speed_label(speed)).clicked() {
                            actions.push(Action::SetSpeed(speed));
                        }
                    }
                });
                ui.menu_button("Peripherals", |ui| {
                    let mut p = state.project_settings.peripherals;
                    let mut changed = ui.checkbox(&mut p.monitor, "Monitor").changed();
                    changed |= ui.checkbox(&mut p.rtc, "Real-time clock").changed();
                    changed |= ui.checkbox(&mut p.keyboard, "Keyboard").changed();
                    changed |= ui
                        .checkbox(&mut p.eeprom, "EEPROM")
                        .on_hover_text("1 MiB of storage. Its content stays when the program changes.")
                        .changed();
                    ui.label(RichText::new("Changing them resets the machine.").weak());
                    if changed {
                        actions.push(Action::SetPeripherals(p));
                    }
                });
                ui.separator();
                if ui
                    .button("Load image…")
                    .on_hover_text("Run a RAM image file (64 KiB)")
                    .clicked()
                {
                    actions.push(Action::LoadImage);
                }
                let eeprom = state.snapshot.eeprom.is_some();
                if ui
                    .add_enabled(eeprom, Button::new("Save EEPROM content…"))
                    .clicked()
                {
                    actions.push(Action::SaveEeprom);
                }
                if ui
                    .add_enabled(eeprom, Button::new("Load EEPROM content…"))
                    .on_hover_text("Replace the EEPROM's content with a 1 MiB file (resets the machine)")
                    .clicked()
                {
                    actions.push(Action::LoadEeprom);
                }
                ui.separator();
                if ui
                    .checkbox(
                        &mut state.settings.follow_pc,
                        "Follow the current instruction",
                    )
                    .changed()
                {
                    state.disasm_view.follow_pc = state.settings.follow_pc;
                    state.memory_view.follow_pc = state.settings.follow_pc;
                }
            });

            ui.menu_button("Help", |ui| {
                if ui.button("Keyboard map…").clicked() {
                    actions.push(Action::ShowDialog(Dialog::Keyboard));
                }
                if ui.button("About…").clicked() {
                    actions.push(Action::ShowDialog(Dialog::About));
                }
            });
        });
    });
}
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
