SteriCraft/hbc2-ide/hbc2/crates/hbc2-ide/src/shortcuts.rs

//! Keyboard shortcuts of the IDE's commands, which Settings > Shortcuts
//! can change.
//!
//! The settings keep only the shortcuts that differ from the defaults, by
//! command name, so that a new command gets its default shortcut.

use std::collections::BTreeMap;

use eframe::egui::{self, Event, Key, KeyboardShortcut, Modifiers};
use serde::{Deserialize, Serialize};

/// A group of commands in the settings page.
#[derive(Clone, Copy, Debug, PartialEq, Eq)]
pub enum Category {
    File,
    Editor,
    Build,
    Emulator,
}

impl Category {
    pub const ALL: [Category; 4] = [
        Category::File,
        Category::Editor,
        Category::Build,
        Category::Emulator,
    ];

    pub fn label(self) -> &'static str {
        match self {
            Category::File => "File",
            Category::Editor => "Editor",
            Category::Build => "Build",
            Category::Emulator => "Emulator",
        }
    }
}

/// A command a shortcut can be given to.
#[derive(Clone, Copy, Debug, PartialEq, Eq, Hash)]
pub enum Command {
    OpenProject,
    Save,
    SaveAll,
    /// Held, R closes the other tabs and K all of them.
    CloseTab,
    Find,
    FindInFiles,
    /// Selects the word at the cursor, then its next occurrence.
    SelectNext,
    /// Selects every occurrence of the word at the cursor.
    SelectEvery,
    DuplicateLines,
    FoldAll,
    UnfoldAll,
    Build,
    /// A second shortcut for Build.
    Build2,
    Run,
    Pause,
    StepOver,
    StepInto,
    StepOut,
    /// A second shortcut for Step out.
    StepOut2,
    Reset,
    Restart,
}

impl Command {
    pub const ALL: [Command; 21] = [
        Command::OpenProject,
        Command::Save,
        Command::SaveAll,
        Command::CloseTab,
        Command::Find,
        Command::FindInFiles,
        Command::SelectNext,
        Command::SelectEvery,
        Command::DuplicateLines,
        Command::FoldAll,
        Command::UnfoldAll,
        Command::Build,
        Command::Build2,
        Command::Run,
        Command::Pause,
        Command::StepOver,
        Command::StepInto,
        Command::StepOut,
        Command::StepOut2,
        Command::Reset,
        Command::Restart,
    ];

    /// Its name in the settings file (never changes).
    pub fn id(self) -> &'static str {
        match self {
            Command::OpenProject => "open_project",
            Command::Save => "save",
            Command::SaveAll => "save_all",
            Command::CloseTab => "close_tab",
            Command::Find => "find",
            Command::FindInFiles => "find_in_files",
            Command::SelectNext => "select_next",
            Command::SelectEvery => "select_every",
            Command::DuplicateLines => "duplicate_lines",
            Command::FoldAll => "fold_all",
            Command::UnfoldAll => "unfold_all",
            Command::Build => "build",
            Command::Build2 => "build_2",
            Command::Run => "run",
            Command::Pause => "pause",
            Command::StepOver => "step_over",
            Command::StepInto => "step_into",
            Command::StepOut => "step_out",
            Command::StepOut2 => "step_out_2",
            Command::Reset => "reset",
            Command::Restart => "restart",
        }
    }
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
