SteriCraft/hbc2-ide/(commit log)

2023-07-27 Made FileManager, ProjectManager, Assembler and BinaryExplorer as singletons
2023-08-02 Emulator thread implemented and working
2023-08-07 Threaded emulator active and updating GUI buttons.
    OpenGL based threaded monitor updating at 60 FPS implemented but not plugged in the emulator (IOD TODO).
    CPU, RAM and motherboard converted to structs to allow multi-thread access.
2023-08-20 Preparing for linux port
    [CPU description.ods, Color palette.ods, µopcode_description.ods, µopcode_list.ods]
2023-08-21 Fixed emulator thread interactions
    [emulator.cpp, emulator.h, motherboard.cpp]
2023-08-21 Fixed assemble action behaviour Made emulator singleton Integrated computer components and peripherals to the emulator
    [emulator.cpp, emulator.h]
2023-08-21 IOD, peripherals and CPU can handle interrupts IOD ports and sockets finished
2023-08-21 Added monitor dialog using OpenGL functions to draw the monitor state (threaded)
    BUG: SIGSEGV on IDE close and emulator stop command
    [computerDetails.h, cpu.cpp, emulator.cpp, emulator.h, monitor.cpp, monitor.h]
2023-08-24 Fixed SIGSEGV fault on monitor closing Added icon to the monitor window
    [monitor.cpp, monitor.h]
2023-08-24 Creates a "rom" directory when assembling a new project Show monitor FPS in status bar CMake -O3 speed optimization setting added
2023-08-24 Added close button to settings dialog
2023-08-24 Changing settings modifies the config file Added browse button to default projects path
2023-08-26 Expand projects item on project opening fixed
    [projectManager.cpp, projectManager.h]
2023-08-26 Emulator reset on active project change Name of the project in monitor window title
    [emulator.cpp, monitor.cpp, monitor.h]
2023-09-12 Binary viewer updates when binary data changes (excepted when the emulator is running) Binary viewer opened on project assembly, emulator paused or emulator stopped Added settings to control the beha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
2023-09-12 Adding an existing file or directory shows the project's directory content Fixed adding an existing file or directory under GNU/Linux Added warning when adding a file or folder to a project that is a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
    [projectManager.cpp, projectManager.h]
2023-09-12 Added status bar code edition information (number of lines, current line of the cursor, current column of the cursor, total number of characters)
2023-09-12 Fixed binary viewer background color
    [binaryViewer.cpp, qhexedit.cpp]
2023-09-12 Fixed invalid addressing modes not showing up in the cpu state viewer Hexadecimal values show up with capital A-F letters CpuStateViewer updates on emulator step command
    [cpu.cpp, cpuStateViewer.cpp]
2023-09-12 Fixed SIGSEGV issue using shared_ptr to store projects
    [assembler.cpp, assembler.h, fileManager.cpp, fileManager.h, projectManager.cpp, projectManager.h]
2023-09-12 Fixed issue with recent projects list Color test in cpu state viewer
    [config.cpp, config.h, cpuStateViewer.cpp]
2023-09-12 Added close button to binary viewer Added flag table in CpuStateViewer Added color to cpu state and interrupt readiness in CpuStateViewer
2023-09-12 Settings bug
    Fixed setting to open cpu state viewer on emulator stopped
    [config.cpp]
2023-09-12 CPU emulator
    Every instruction tested
    Left to do: check flags set by instruction
    Monitor working with the CPU
    Software interrupt added and working
    Hardware interrupt working
2023-09-12 Documentation
    Updated (including *.pdf files)
    [CPU description.ods, µopcode_description.ods, µopcode_list.ods]
2023-09-12 Update
    TODO done in assembler.cpp
2023-09-12 Removed untracked directory
    [CPU description.ods]
2023-09-12 Peripheral information
    IOD now triggers interrupts to tell the CPU about plugged in peripherals (first thing executed by the CPU)
    Updated documentation
2023-09-12 Interrupts and peripherals
    IOD interrupt management fixed (was sending all pending interrupts in a row)
    CPU-IOD dedicated port added
    Peripherals send their ID on startup
    CPU receives interrupts on startup to identify peripherals and update the IVT
    [cpu.cpp, iod.cpp]
2023-09-12 Cpu State Viewer behaviour
    Fixed cpu state updates
    [computerDetails.h, cpuStateViewer.cpp, cpuStateViewer.h, emulator.cpp, emulator.h, monitor.cpp, realTimeClock.cpp]
2023-09-12 Flags
    Fixed SBB instruction (Carry flag bus)
    All instructions affecting flags have been tested
    [cpu.cpp]
2023-09-12 Monitor
    Fixed default color in text mode if the ascii code is invalid (background color)
    [cpu.cpp, monitor.cpp]
2023-09-12 Recent projects menu
    Fixed a bug that fused recent projects paths in the config file
    [config.cpp, config.h]
2023-09-12 Rename project items bugfix and tab spaces settings
    Fixed a bug when renaming a project item
    Added a setting in ConfigManager to set the size of tabs (in spaces)
    Adding a tab now adds spaces so that the cursor stops at a position % tabSize = 0
    [config.cpp, config.h, emulator.cpp, fileManager.cpp, fileManager.h, projectManager.cpp, projectManager.h]
2023-09-12 Highlighting current instruction
    Throws a warning when the CPU jumps to an address that corresponds to no instruction in the code
    Highlighting is removed when the CPU executes code at an address that corresponds to no instruction in the code
2023-09-12 BinaryViewer
    BinaryViewer highlights currently executed instruction (4 bytes)
    Is still highlighted even when the instruction is outside the original code
2023-09-12 Emulator
    Fixed infinitely adding number of peripherals on each reassembly
    Fixed RTC checkbox always checkable
    Added RTC setting for emulator startup
    Fixed RTC throws timed interrupts only when running at full speed
    [config.cpp, config.h, emulator.cpp, emulator.h, iod.cpp, monitor.cpp, monitor.h, peripheral.h]
2023-09-12 Keyboard
    Added keyboard device
    Triggers an interrupt on key strike (both release and pressed, on 2 different ports)
2023-09-12 EEPROM
    Added a hexadecimal spinbox class in binary viewer
    Added a "goto" button with a spinbox in binary viewer
    Added an EEPROM peripheral
    Added settings for the EEPROM
    EEPROM copies IVT, first 200 bytes of program memory and interrupt handlers (0xf000 - 0xffff) into RAM before startup
    Added binary, decimal and hexadecimal base options in CpuStateViewer
    Added EEPROM and keyboard documentation
    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
    [Color palette.ods]
2023-09-12 Console output bug fixed
    Scrolls down on every entry
    [console.cpp]
2023-09-13 MonitorDialog
    The monitor peripheral now shows up in a QDialog to be on top of the main window
    Fixed a bug not setting it the right size depending on pixel scale
    [binaryViewer.cpp, iod.cpp, monitor.cpp, monitor.h]
2023-09-13 Assembler
    Lonely instructions forbidden (even if a file has been included before)
2023-09-14 Routines and binary viewer
    Routines now follow one another if they are undefined
    The binary viewer updates on every assembly
2023-09-19 BinaryViewer and Assembler
    Fixed free memory spaces detection
    Added an address and selection address display in the status bar
    [assembler.cpp, assembler.h, binaryViewer.cpp, binaryViewer.h, qhexedit.h, token.h]
2023-09-19 New project dialog
    Added a custom new project dialog
    Added the possibility to create a sub-directory for a new project
    Added the possibility to include a default interrupt handler with a new project
    Added the possibility to include a math library with a new project (library not yet written)
2023-09-20 New project
    Default interrupt handler routines can be added by default with a new project
2023-09-20 Disassembler
    Added a disassembled code viewer
    Added settings for that disassembly viewer
    Fixed a few forgotten checks for addressing modes in the cpu execution cycle
    [binaryViewer.cpp, computerDetails.h, config.cpp, config.h, cpu.cpp, diassembler.cpp, disassembler.h, monitor.cpp]
2023-09-21 Shortcut map
    Added shortcut map in settings
    Added tab in editor settings menu
    Shortcut updated when settings dialog closed
    Shortcut map stored in config file
    [assembler.h, config.cpp, config.h, emulator.cpp, main.cpp, mainWindow.cpp, mainWindow.h, monitor.cpp]
2023-09-22 Fixed viewers issues
    Disassembler bug with label < Cpu::START_ADDRESS fixed
    Disassembler enabled/disabled depending on Emulator state
    CPUStateViewer enabled/disabled depending on Emulator state
    BinaryViewer enabled/disabled depending on Emulator state
    [diassembler.cpp, mainWindow.cpp, mainWindow.h, monitor.cpp, monitor.h]
2023-09-22 Breakpoints
    Added breakpoints area in the code editor
    Added a keyboard shortcut to create breakpoints
    Assembler calculates breakpoints addresses on emulator run
    Emulator pauses when reaching a breakpoint
    Breakpoint unusable with the EEPROM connect (because of undefined addresses for instructions once copied in the RAM)
    [codeEditor.cpp, codeEditor.h]
2023-09-22 Viewer behaviour
    BinaryVIewer now highlights current programCounter if opened on emulator paused
    Same for Disassembler
2026-10-23 Add Rust emulation core (hbc2/)
    Cargo workspace with:
    - hbc2-core: CPU, RAM, IOD, monitor, keyboard, RTC, EEPROM and Machine,
    following the HBC-2 Instruction Manual. No GUI, no threads.
    Peripherals are event-driven (commands run when CMD is written).
    - hbc2-cli: 'hbc2 bench' (about 180 MHz on one core) and 'hbc2 run'.
    - 52 tests covering every instruction, interrupts and peripherals.
2026-10-23 Add assembler and disassembler (hbc2-asm)
    New .has syntax: 'name:' labels, '[x:y]' register pairs, commas between
    operands; adds name +/- offset, 'A' characters, 0b binary, negative values,
    mixed .data values with escapes, case-insensitive mnemonics, and
    include-once with paths relative to the including file.
    Keeps the old placement logic: fixed blocks, fall-through labels,
    automatic placement of floating code and data (EEPROM target limited to
    the ranges copied to RAM at power-on). All errors are reported with
    file:line:column.
    - hbc2 asm / hbc2 run now accept .has files
    - templates/: default main.has and interruptHandler.has in the new syntax
    - Documentation/HBC-2 Assembly Language.md (i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
2026-10-23 Add emulator thread (hbc2-runner)
    The machine lives on one thread; other threads send commands through a
    channel and read the latest published snapshot. Paced from 1 Hz to
    "fastest" (100 MHz measured at 100.0 %). A halted, idle CPU is skipped
    instead of simulated. `hbc2 bench --hz N` checks the pacing.
2026-10-23 Add PSF/POF; template handler saves flags and A
    PSF (0x2D) pushes the flag register, POF (0x2E) pops it, as in the
    updated instruction manual; SUB/SBB/XOR move to 0x2F-0x31. The IOD
    interrupt handler template now saves flags and A, and keeps the pending
    port in a variable instead of B, so the main program's state survives.
2026-10-23 Update instruction and monitor manuals
    Instruction manual: Imm16 addressing mode, ADC/SBB carry, IOD queue,
    clock, PSF/POF. New monitor manual. ODT sources in Documentation/src/.
    The old "Instructions Manual.pdf" is replaced by "HBC-2 Instruction Manual.pdf".
2026-10-23 Template: default RTC handler
    When the RTC is plugged in, the interrupt handler template points its IVT
    entry to a handler that only does IRT. Before, RTC ticks jumped to 0x0000
    and ran the stack as code.
2026-10-23 Add the IDE (hbc2-ide)
    egui/eframe GUI with dockable tabs (egui_dock): project files, code editor
    with highlighting and breakpoints, console, monitor with HBC-2 keyboard
    input, CPU, memory, disassembly and I/O views. Assembles from the editors'
    text and runs the program on the emulator thread at 1 Hz to 100 MHz or
    flat out. Layout and per-project settings are remembered.
2026-10-28 IDE: fixed layout, monitor window, new project dialog; RTC on host time
    IDE: fixed dock layout (only split sizes are saved), CPU and I/O merged
    into one "CPU & I/O" tab laid out in stable columns, monitor in a window
    of its own, "New project" dialog creating projects in
    Documents/hbc2_projects, button to send the RTC interrupt.
    RTC: follows the host's local time, also while paused. SET_TIME keeps
    its offset until the next power-on. Interrupts are only sent while
    running at 100 Hz or more.
    Adds ide-debug.cmd and ide-release.cmd to build and open the IDE.
2026-10-28 Assembler: psh/pop register lists
    `psh a, i, y` expands to one psh per register, in the order written.
    `pop a, i, y` pops in reverse order, so the same list restores what psh
    saved. Duplicates and non-register operands are errors. Documented in
    the assembly language manual.
2026-10-28 IDE folders; .data16/.data32; case-insensitive includes on Windows
    IDE: "New folder…" in the Files panel (header button and context menus),
    empty folders show in the tree, and the "New file" dialog shows the
    .include path from main.has.
    Assembler: .data16 / .data32 store 16- / 32-bit values most significant
    byte first: numbers (negative in two's complement), characters,
    $addresses, or label / variable addresses (name + n). On Windows, a file
    included under another letter case is the same file.
2026-10-30 IDE: find, Edit menu, follow PC, crash report Find in the file (Ctrl+F) and in the project's files (Ctrl+Shift+F), with case-sensitive and whole-word options. New Edit menu with Undo, Redo and the tw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
    The editor and the memory view follow the current instruction while a
    program runs slowly (the view only moves when the line leaves it).
    A crash shows a message box and writes the details to
    hbc2-ide-crash.log in the temp folder.
    Adds Documentation/TODO.md: fixes to make in the monitor manual.
2026-10-30 IDE: Caps Lock and accents on the keyboard, move files, Restart
    Caps Lock on the host holds Shift on the HBC-2 keyboard; keys typing
    é, è, à, ù are sent as E, E, A, U. Files and folders can be dragged to
    another folder in the file tree, and shown in the system's file manager.
    "Power cycle" is now called "Restart".
2026-10-30 CPU redesign for a C compiler: offsets, 16-bit stack, program at 0x0000
    - RamReg / ImmReg / Offset (0x4): address (R1:R2) + V2, now also for the
    ALU instructions and inc/dec (whose Reg16 mode is removed).
    - New Stack / Offset mode (0x5): address STK + V1. Reg16, Imm16 and Imm8
    become 0x6, 0x7 and 0x8.
    - New instructions asp, ssp, rsp, wsp (0x32-0x35).
    - 16-bit stack pointer, reset 0xFE00, growing downward; the IVT moves
    to 0xFE00-0xFFFF.
    - Execution starts at 0x0000. The EEPROM copies 0x0000-0x01FF and the
    IVT at power-on, following its updated specification.
    - Assembler: [x:y + n], [sp + n], asp/ssp choose Imm16 above 255;
    automatic placement stays below the IVT.
    - IDE: 16-bit SP,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
2026-10-30 Peripheral references, design project, remove the Qt archive
    - Documentation/Peripherals: an overview (IOD, ports, interrupts, device
    detection) and a reference page per device (Monitor, Keyboard, RTC,
    EEPROM with a boot loader example), matching the emulator. Every code
    example was run on the emulator.
    - Manuals renamed, instruction set table and CPU diagram added.
    - design_projects/test_project: the math library, monitor driver and
    terminal; interrupt vectors moved to 0xFE00.
    - old_code_archive removed (the Qt IDE stays in the git history).
2026-10-30 Assembler: name.msb / name.lsb as bracket offsets
    [x:y + n] and [sp + n] now take a number, a character, a define, or
    name.msb / name.lsb, resolved with the other 8-bit values. With the
    table's high byte in the first register, [x:b + table.lsb] is
    table + b, carry included: one instruction instead of four to index a
    table. Documented in HBC-2 Assembly Language.md, with tests.
2026-10-30 Test project: use offsets and stack addressing of the new CPU
    - Math library: [x:y + n] / [i:j + n] replace the pointer steps in the
    32-bit, bit counting and text routines; the ALU reads operands from
    memory directly. 32-bit routines are 2-3x faster.
    - Work areas of mul32, div32, pow32, gcd32, isqrt32, mul32s and randr32
    moved to the stack ([sp + n], ssp, asp, rsp): no more global work
    variables, they can be called from interrupt handlers. Only rand_s
    stays global.
    - Interrupt handler and terminal: IVT entries written with offsets;
    terminal tables indexed with [x:b + table.lsb].
    - math_reference.md: work areas and speed sections updated.
    - Project size 16820 -> 15073 bytes. Check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
2026-10-30 Assembler: .bss directive for zeroed variables
    .bss name size reserves zeroed bytes without writing them in the image.
    All .bss variables are placed together after code and data, and the
    assembler defines __bss_start / __bss_end for the startup code that
    clears the area. Needed by the C compiler.
2026-10-30 C compiler: ABI document, C names up to 31 characters
    compiler/ABI.md: types, memory map, registers, calls and frames, names,
    variables, startup and exit, assembly wrappers, interrupt handlers
    calling C, runtime helpers (draft). Its examples were run on the
    emulator.
    Fuzix kit: NAMELEN raised from 16 to 32 so C names keep 31 characters
    instead of 15 (listed in fcc/UPSTREAM.md).
2026-10-30 C compiler: HBC-2 backend, startup code, .data addresses
    - hbc2-asm: a name in .data is its 2-byte address (name + n allowed),
    so tables of addresses and pointers can be one .data line.
    - compiler/fcc: target-hbc2.c (parser target, float refused) and
    backend-hbc2.c (code generator printing .has, following ABI.md).
    - compiler/runtime/crt0.has: clears .bss, calls main, waits at __exit.
    - compiler/tools/hbc2cc.py: temporary driver; compiler/tests: first
    two programs, both give the expected result on the emulator.
2026-10-30 C compiler: runtime helpers, test harness, inline code
    Runtime (compiler/runtime): the 89 helpers the backend calls (compare,
    long, mul, div, shift, assign, switch), written for the C convention and
    included by runtime.has.
    Test harness: crate hbc2-cc (compile() runs the compiler stages; tests
    check each helper against a Rust model on the emulator, and run every C
    program in compiler/tests and compiler/tests/ops, printing code size and
    ticks). gen_ops.py generates 48 programs (about 12 000 checks: every
    operator on every type, constants, conditions, loops, pointers, globals
    and locals). bench.c: small real programs.
    Backend: inline code for the common cases. Simple operands (constants,
    loc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
2026-10-30 C compiler: copt peephole rules
    compiler/fcc/rules.hbc2 runs after cc2 in both drivers: jump threading,
    for-loop jumps, tail calls, dead code, store/reload, helper operands
    without psh/pop, redundant movs. tests/peephole.c covers the rare shapes.
    programs.rs counts psh/pop register lists per register.
    Also removes projectStats.sh.
2026-10-30 C compiler: C library, multi-file builds
    Step 8, the C library (compiler/lib):
    - hbc2.h: monitor, RTC, keyboard and port wrappers; copies of the screen
    and terminal drivers in lib/asm.
    - stdio.h (putchar, puts, getchar, gets, printf with the minimal set),
    string.h, stdlib.h (exit), stddef.h, stdarg.h.
    - crt0 detects the devices (runtime/devices.has) before calling main.
    - Tests: hardware.c, stdio.c, strings.c, printf.c; programs.rs checks the
    screen (.screen) and types keys (.keys).
    Step 9, programs of several files:
    - hbc2_cc::build_program builds .c and .has files into one program.
    - static names renamed per file (__S<unit>_name), in both drivers.
    - #include "x.h" looks next to the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
2026-10-30 C compiler: set_vector for interrupt handlers
    set_vector(port, handler) in hbc2.h installs an assembly interrupt
    handler from C (refuses port 0). Test multi/vector: a key handler in
    assembly calling C. ABI.md explains why RTC and keyboard vectors are
    set at run time.
2026-10-30 C compiler: IDE integration (step 10)
    - hbc2-cc: errors and warnings as Diagnostics with C file and line
    (cpp, cc0/cc1 and assembler messages); every C file compiled even when
    one fails; library files recompiled only when out of date.
    - C line map: cc1 sends statement lines (H_LINE), cc2 prints ";#line n",
    copt skips the markers (same code as before); the driver points the
    program's instructions and labels at their C lines.
    - hbc2 cc command; hbc2 run accepts C files.
    - IDE: C projects (main.c), New project language choice, Build saves then
    compiles in the background, RAM target only, C highlighting, compiled
    and compiler files read-only, breakpoints and current line in C files.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
2026-10-31 Linker (step 11): unused code left out of C programs
    hbc2-asm: assemble_with + Options { target, strip }. With strip, every
    piece (label to next label, .data, .bss) not reachable from _start,
    fixed addresses or .keep is left out; fall-through counts as a use;
    undefined names are still errors in removed code. Program.removed lists
    what was left out.
    .keep name: keep code reached only through a computed address.
    .library: names after it are library names; a program's own definition
    replaces the library's (e.g. its own puts or putchar).
    C builds strip (build_program); lib.has and library.has start with
    .library. hbc2 cc --map lists kept/removed; the IDE build message shows
    the bytes left out.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
2026-10-31 C compiler: remove loads of values the registers already hold
    hbc2-cc reloads.rs runs on each compiled file after copt: it follows
    what each register holds (constants, global/static bytes, stack slots,
    [x:y] bytes, other registers) and removes lod/mov that would put back
    the same value. Forgets at labels that are jumped to or called, calls,
    jumps, and on stores that may overlap.
    Volatile: cc1 flags every node of a volatile variable (tree.c, listed
    in UPSTREAM.md); cc2 lists volatile names, stack and pointer accesses
    at the end of the file; they are never remembered. The copt
    store-then-load rules are gone (they removed reloads of volatiles);
    the pass gives the same code. Tests: unit tests,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
2026-10-31 string.h in assembly; step 12 docs
    lib/asm/string.has replaces src/string.c: 2652 -> 1068 bytes, strlen
    6 instructions per char instead of 12 (tests/strings.c 95317 -> 67133
    ticks). More checks in tests/strings.c (exact compare results, memmove
    without overlap); mutation-checked.
    Roadmap step 12, notes/reloads.md, lib/README.md sizes.
2026-10-31 Assembly projects: option to leave out unused code
    Build menu "Leave out unused code" (saved per project, off by default)
    and `hbc2 asm --strip`. ASM_p: 15021 -> 2497 bytes.
2026-10-31 C library: math.h, abs/labs, random numbers, number <-> text
    math.h (integer only, names kept apart from float's sqrt/pow): isqrt
    lsqrt ipow lpow gcd lgcd popcount clz ctz lpopcount lclz lctz min max
    umin umax. stdlib.h: abs, labs, rand, srand, RAND_MAX, atoi, atol, and
    the extras srand_rtc, rand_range, itoa utoa ltoa ultoa htoa lhtoa.
    printf gets its digits from utoa/ultoa/htoa/lhtoa (no division), %X.
    The math library is copied to lib/asm/mathlib (without the 6 files C
    never reaches); wrappers in lib/asm/math.has.
    FCC fix: sizeof without a bracket takes a unary expression, so
    sizeof a / sizeof a[0] is no longer read as sizeof (a / sizeof a[0]).
    Tests: math.c, random.c, convert.c.
    Co-Au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
2026-10-31 IDE editor: indent selection, auto brackets, auto indent; Restart pauses
    - Tab on a multi-line selection indents the lines; Shift+Tab unindents
    them (or the cursor's line).
    - ( [ { add the closing bracket (or wrap the selection); a typed closing
    bracket steps over the same one; Backspace between a pair deletes both.
    - Enter keeps the line's indentation, one tab more after an opening
    bracket; between { and } the } goes on its own line.
    - } typed at the start of a line lines up with its matching {.
    - Restart pauses the machine at its first instruction, so no tab opens.
    - Shorter "Building..." console message.
2026-10-31 C compiler: EEPROM support (read/write routines and an EEPROM target)
    - hbc2.h: eeprom_read, eeprom_write, eeprom_load, eeprom_save
    (assembly in compiler/lib/asm/hbc2.has).
    - EEPROM target for C programs: the runtime is split into crt0.has
    (RAM), boot.has (EEPROM boot loader) and init.has (shared);
    hbc2_cc::build_program takes the target and gives the EEPROM image.
    - hbc2-asm: __program_end label.
    - CLI: hbc2 cc --eeprom, hbc2 run main.c --eeprom.
    - IDE: the target menu works for C projects.
    - Tests: tests/eeprom.c, refusals in hardware.c, build.rs.
    - Docs: ABI.md section 8, EEPROM reference, ROADMAP step 13, TODO.
2026-10-31 IDE editor: parameter hints for C calls; double click selects the word
    - Inside the brackets of a known function's call, a box under the cursor
    shows its parameters (the current one stressed) and its comment. The
    functions come from the C library headers and the project's .c/.h
    files (unsaved changes too), refreshed with the disk check.
    - egui took a double click that came soon after another click for a
    triple click and selected the line: the editor counts the clicks
    itself and selects the word then.
2026-10-31 IDE editor: the mouse wheel scrolls while selecting with the mouse
    egui's scroll area ignores the wheel during a drag; the editor applies it
    itself while text is being selected, and the selection follows.
2026-10-31 IDE editor: multiple cursors with Ctrl+click
    - Ctrl+click adds a cursor (or removes the one clicked); a plain click
    or Escape goes back to one. The status bar shows how many there are.
    - Typing (with the bracket helpers), Backspace, Delete, Enter (with
    indentation), Tab, paste (one line per cursor when the counts match),
    arrows, Home and End act at every cursor. Other keys (Ctrl shortcuts,
    Shift+arrows, cut) go back to one cursor first.
    - The key events of Shift, Ctrl, Alt themselves (repeated while held) are
    ignored by the editor's key handling.
2026-10-31 IDE editor: multiple selections, Ctrl+L, Ctrl+Shift+L, Ctrl+D
    - Every cursor can hold a selection: Ctrl+drag and Ctrl+click keep the
    current selection and add one. Typing, paste, Backspace, Delete, Enter
    replace each selection; Shift+arrows extend them; copy and cut take
    them all (one per line).
    - Ctrl+L selects the word at the cursor, then its next occurrence (whole
    words when the selection is one); Ctrl+Shift+L selects them all.
    - Ctrl+D copies the lines holding a cursor below themselves.
    - The shortcuts list shows them.
2026-10-31 C library: ctype.h
    isalnum isalpha islower isupper isdigit isxdigit isspace isblank ispunct
    iscntrl isprint isgraph tolower toupper, in assembly (compiler/lib/asm/
    ctype.has, written by the project's author; isblank, shared exits and the
    isgraph tail call added). tests/ctype.c checks every value from EOF to
    255 and out-of-range ones against plain C.
2026-10-31 C library: printf supports the - flag (%-6s)
2026-10-31 IDE: a button hides or shows the CPU & I/O, Disassembly and Memory tabs
2026-10-31 C library: strtol, strtoul, strstr, itoa with a radix
    - stdlib.h: strtol and strtoul (bases 0 and 2 to 36, "0x" and "0b"
    prefixes, str_end, limits on overflow), in src/stdlib.c. atoi and atol
    are strtol in base 10: decimal only, the assembly versions are gone.
    - itoa, utoa, ltoa, ultoa take a radix (2, 8, 10, 16) and return buf;
    printf uses the internal __utoa_dec / __utoa_hex routines.
    - string.h: strstr (src/string.c).
    - hbc2.h: srand_rtc and rand_range move here from stdlib.h;
    screen_set_txt.
    - The library's C files are all compiled again when the list of files
    changes (their unit numbers follow the list).
2026-10-31 IDE: " and ' are closed automatically, like brackets
2026-10-31 C library headers: // comments, aligned prototypes; TODO: shell commands status
2026-10-31 IDE: F10 steps over, F11 steps into, Shift+F11 steps out
    The CPU keeps a call depth for the debugger (CAL and interrupt entry count
    up, RET and IRT down): step over runs the routines called until they
    return, step out runs until the current routine returns. Breakpoints in
    the routines run stop both.
2026-11-01 IDE: the bracket next to the cursor and its match are highlighted
2026-11-01 IDE: a closing bracket without an opening one is highlighted red
2026-11-01 IDE: an opening bracket that is never closed is highlighted red
2026-11-01 C library: screen_set_mode / screen_get_mode, monitor_mode; 0 on success everywhere; // comments in headers
    - screen_text_mode and screen_pixel_mode become screen_set_mode(PIXEL_MODE
    or TEXT_MODE). The driver keeps monitor_mode up to date, the terminal's
    own switches to text mode included. screen_get_mode reads it.
    - rtc_get, rtc_set and srand_rtc return 0 when they work, like the rest.
    - Every return value is described as "Returns a non-zero value if ...".
    - All library headers use // comments.
2026-11-01 TODO: devices command done
2026-11-01 IDE: settings dialog, split editors restored, monitor window fixes
    - File > Settings: General, Editor, Build, Emulator and Monitor pages
    (reopen last project, projects folder, recent count, project folder
    by default; font size, tabs or spaces, tab width, line numbers,
    current line; save before assembling, run after build; startup
    clock, follow PC, peripherals of new projects; monitor on startup,
    sharp scaling, pixel size, 3x3 placement, last position)
    - New project can be created right in the chosen folder
    - Editor groups (split editors) are saved per project and restored
    - Monitor: focus stripe outside the screen with a 1 px gap, no black
    side bars in text mode, window kept abov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
2026-11-01 CPU: instructions of 1 to 4 bytes, new HLT and STI rules
    An instruction keeps the same bit layout, without the bytes it doesn't
    use: a no-operand opcode is 1 byte, otherwise the addressing mode gives
    the length (Reg/Reg16 2, Reg-Imm8/Stack-Offset/Imm8 3, the others 4).
    - Invalid opcode: 1-byte NOP. Valid opcode with a mode it doesn't take
    (or mode bits set on a no-operand opcode): the CPU stops (H set,
    I cleared, PC left on the instruction).
    - HLT sets H only (cli + hlt stops until reset). STI takes effect after
    the next instruction, so sti + hlt can't miss an interrupt.
    - Assembler, disassembler, IDE views (disassembly, memory, CPU, status
    bar) and the CLI follow the sizes. wait_int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
2026-11-03 C library: printf in assembly
    lib/asm/printf.has replaces src/printf.c (2.5 KB -> 965 bytes). Same
    formats; state on the stack; every character goes through _putchar.
    Smallest printf program 3846 -> 2707 bytes.
2026-11-03 C library: C89 batch (errno, sprintf, qsort, time, malloc, scanf); struct copy
    Library, all in assembly:
    - limits.h, errno.h, strerror, perror
    - sprintf, vsprintf, vprintf (printf engine)
    - qsort, bsearch, strtok, strspn, strcspn, strpbrk
    - time.h from the RTC
    - malloc, free, calloc, realloc (heap from __bss_end to SP - 256)
    - scanf, sscanf; getchar and gets moved to asm (src/stdio.c removed)
    Compiler (FCC):
    - struct and union assignment (T_STRUCTCOPY, __structcpy)
    - initial values of local arrays and structs
    - (void) casts
    New tests: errno, sprintf, sort, time, structcopy, localinit, malloc,
    scanf. Docs and roadmap updated.
2026-11-03 C library: stdlib conversions and strstr in assembly, no C left
    strtol, strtoul, atoi, atol, itoa, utoa, ltoa and ultoa move from
    src/stdlib.c to asm/stdlib.has, strstr from src/string.c to
    asm/string.has. The conversion test goes from 12000 to 9036 bytes.
    compiler/lib/src is gone: build_library takes a missing folder as no
    C files, and the installer skips it.
2026-11-03 Logisim: netlist extraction script
    logisim/tools/netlist.py reads Logisim-evolution .circ files and prints
    per-circuit nets or a flattened bit-level netlist (--flat), as text or
    JSON. TTL pinouts and port geometry come from Logisim-evolution 5.0.0.
2026-11-03 Emulator: execution trace (CSV) for comparison with the Logisim circuit
    The CPU reports RAM writes, OUT, finished instructions and interrupt
    entries to a probe; the default probe compiles to nothing, so emulation
    speed is unchanged when tracing is off. TraceWriter writes the CSV
    format documented in hbc2-core/src/trace.rs.
    - hbc2 trace <prog> --max N [-o out.csv] [--peripherals]
    - IDE: Trace button (line count while recording), adjustable line
    limit in Settings > Emulator (1,000,000 by default)
    - Tests: hand-checked expected trace, format checks, runner cases
2026-11-03 Trace: hbc2 compare, first difference between two traces
    hbc2_core::trace::compare finds the first line where two traces differ;
    DiffReport prints its n, the columns that differ with both values and
    the 3 lines before it. A trace that ends early is reported as such.
    \r\n line endings are accepted.
    - hbc2 compare <a.csv> <b.csv>: exit code 0 if identical, 1 if they
    differ, 2 on error
    - Tests: identical traces, one register differs, a shorter trace,
    missing column and header (core), and the same cases on the binary
2026-11-04 Logisim: circuit generator, checker, renderer and test runner
    Tools to build Logisim circuits from Python and verify them:
    - circgen.py: builder (TTL pins by name, buses with taps, crossing-free
    rails off a chip edge); saving runs the checker
    - circcheck.py: wiring/layout checks for any .circ file
    - render.py: PNG preview of a circuit, with problems circled
    - logitest.py: test a circuit against a Python model in headless Logisim
    First design: designs/add8_ttl.py, an 8-bit adder from two 74283.
    The logisim/ folder is now tracked (the old Logisim/ ignore rule matched
    it on Windows), including cpu.circ.
2026-11-04 Logisim tools: follow library files across .circ files
    - netlist: load file# libraries up front (Logisim's relative paths, with
    backslashes on Windows); find files under logisim/ and circuits/<m>/
    - circcheck, conventions: also check the library files a file loads;
    a missing library is an error
    - conventions: file layout rules (cpu.circ holds only main; one module
    and its test bench per circuits/<m>/<m>.circ; relative library paths)
    - usages.py: where a module is instantiated, for port changes
    - logitest --open: check that Logisim opens a file (libraries found)
2026-11-04 Logisim: add_sub8 moves to circuits/add_sub8/add_sub8.circ
    cpu.circ loads it as a Logisim library (relative path). No change to the
    circuit; 524,288 / 524,288 against the emulator from its new file.
2026-11-04 Logisim: alu moves to circuits/alu/alu.circ
    alu.circ loads add_sub8 as a library (..\add_sub8\add_sub8.circ);
    cpu.circ loads alu.circ. alu is unchanged (work in progress).
2026-11-04 Logisim: add8 moves to circuits/alu/add8.circ; cpu.circ holds only main
    - add8 (practice module) next to alu, as asked; design script renamed
    designs/add8.py; regenerated file is identical; 131,072 / 131,072
    against the emulator
    - cpu.circ: empty main, loads add_sub8, alu and add8 as libraries
    (relative paths); opens in Logisim with no missing library
2026-11-04 Logisim conventions: folders are functional units (circuits/<unit>/<module>.circ)
2026-11-04 add_sub8: symbol with control on top and the c flag at the bottom
    sub, usec, cin on the top edge; a, b left; s right; c bottom; full port
    names. Port positions changed: the only instance (circuits/alu/alu.circ,
    alu at (510,190)) has no wires, so nothing to reconnect.
    524,288 / 524,288 against the emulator.
2026-11-04 Logisim: remove add_sub8 and alu (the user's test circuits)
    cpu.circ no longer loads add_sub8.circ; alu.circ will be rebuilt around add8.
2026-11-04 Logisim: new alu module using add8 (circuits/alu/alu.circ)
    - alu: alu_a, alu_b, alu_cin -> alu_s, alu_c through add8, loaded as a
    library (file#add8.circ); custom symbol with the carry flag at the
    bottom; made by designs/alu.py
    - circgen: Project.library() / Circuit.sub() for subcircuits of other
    files, Circuit.symbol() for custom symbols
    - hbc2 vectors alu (emulator's alu::add): 131,072 / 131,072
    - cpu.circ loads alu and add8; opens in Logisim with no missing library
2026-11-04 add_sub8: symbol c port back on the 10 px grid
    circgen centred top/bottom port rows on a 5 px offset (c sat at x=315,
    unreachable by wires). Row starts are now rounded to the grid.
2026-11-04 alu: ADD/ADC/SUB/SBB through add_sub8, with flags C, N and Z
    - alu now loads add_sub8.circ: ports sub, use_c, cin (top), a, b (left),
    s (right), c, n, z (bottom).
    - N = s bit 7; Z = U1 (74HCT27) three nor3 over s, U2 (74HCT11) and3.
    - Emulator: Z/N moved into alu::zn, used by the CPU and by hbc2 vectors alu.
    - 524,288 / 524,288 vectors pass.
    - logitest.opens uses -tty stats (-tty table simulated all 2^19 inputs and
    timed out).
    - Notes: tap exception extended to gate chips (user decision), gate pinouts.
2026-11-04 circgen: Circuit.move(); add_sub8.py and alu.py reproduce Gianni's shifted layouts
2026-11-04 arith8: ADD/ADC/SUB/SBB/INC/DEC = add_sub8 + 2x 74HCT157 (B or 01), 1,048,576/1,048,576 vs emulator
    circgen: rails_left() helper (add_sub8 rail style, Ground/Power ends).
    circcheck: error when a Ground/Power/Constant shares a net with a driver.
2026-11-04 shift8: SHL/SHR/ASR wiring + carry select and ASR fill (1x 74HCT153), 2,048/2,048 vs emulator
2026-11-04 alu: every ALU instruction (arith8, logic8, shift8, rmux8, flags8), 2,097,152/2,097,152 vs emulator
    alu_op (4 bits) drives the blocks with no glue logic; 27 chips in total.
    Notes: alu-report.md, alu-decisions.md (with points for review), chips.md.
2026-11-04 alu: orderable parts, datasheet timing, generated BOM
    - chips.md: DIP (TI) and SOIC references for the 12 parts, sourcing
    rules (no Nexperia DIP, no NRND TI variants, authorised distributors),
    and a Delays table from the TI datasheets (typ, max 25 C, max 85 C).
    - tools/timing.py: ALU path delays from that table. Worst path alu_s
    111 / 257 / 321 ns; Z/E and C also over 250 ns at 85 C. Fixes listed
    in alu-report.md, none applied.
    - tools/bom.py: bill of materials from the circuits; designs/alu.py
    writes notes/bom-alu.csv (27 chips, 12 part numbers, 12 spares).
    Every chip in circuits/alu/ is in the parts table.
    - arith8/shift8: Gianni's layout moves kept in the design scripts.
    - dis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
2026-11-04 bom.py: --check ignores line endings
2026-11-04 chips: chip models in circuits/chips/ (74574 from the TI datasheet, 2,064/2,064), Logisim's 74670 checked transparent (912/912); tools know models
2026-11-04 flags: flag register (15 chips, 2x 74HCT175, 4x 74HCT153), flags_op interface, 66,816/66,816 and 70,656/70,656 vs the real CPU; timing --section flags (366 ns worst case)
2026-11-04 chips: one Parts in use table per module (ALU, flags, not in a circuit yet); bom.py reads them all
    Pending change found in the working tree before the register section, committed on its own.
2026-11-04 registers: regs module (19 chips: 8x 74HCT670, 4x 153, 3x 574, 2x 541, 240, 32), 30,756/30,756 (model) and 148,864/148,864 (real CPU)
    Two copies of the register file (two read ports), bank enables straight
    from the index multiplexers, free-running result and operand latches,
    /WE from a second clock phase (clk_wr_n). hbc2 vectors regs / regs_cpu.
    Logisim doesn't simulate a library circuit whose name starts with a digit:
    the 574 model circuit is now ttl74574 (netlist, bom, conventions follow).
2026-11-04 registers: timing (operands at 160 ns, register read to flag setup 485 of 500 ns, writes inside the step), requirements for PC/SP (P1-P4) and the control unit (C5-C10), notes
    timing.py: --section regs; stages can be a fixed time in the step or a whole earlier path.
2026-11-04 compiler: float and double (binary32 IEEE library reviewed, compiler support, math.h/float.h/fenv.h, strtod), printf/scanf %f %e %g with flags, precision and *
2026-11-04 logisim: ALU and rmux8 circuits, timing.py, notes (addr, ALU, chips, flags, registers, PC/SP, control)
2026-11-04 kicad: ALU and flags boards, custom symbols
2026-11-05 chips: AT28C256 model (read-only boot ROM, 64 KiB image + HALF sim pin, M3), test 69,536/69,536, mutation caught; circgen writes multi-line attributes as text
2026-11-05 notes: control-requirements C6 (clk_mem_wr_n), C18-C23 (IR loads, memory strobes, boot loop, interrupt timing, I/O steps, microcoded control unit); iod-requirements.md (I1-I8, MCU IOD via hardware la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
2026-11-05 mem: combined bench test_mem_cpu (addr + ir + mem + IOD stub): boot copy of the program's power-on RAM, 4,000 CPU ticks fetched from the Logisim RAM, RAM writes mirrored, IN/OUT, 54 hardware interrup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
2026-11-05 logisim: simulation-only model pins (Gianni's review 1): netlist.SIM_ONLY lists them, pcb_ports() drops them for a PCB netlist export, conventions.py checks each model's unnumbered pins against the l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
2026-11-05 boot ROM export (Gianni's review 6): hbc2 asm/cc --boot-rom and IDE Build > Export boot ROM write the 64 KiB RAM image as two 32 KiB AT28C256 files, name_lo.bin (0000-7FFF) and name_hi.bin (8000-FFFF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
2026-11-05 cu: phase 1 paper design (cu-decisions.md): 54 microcode bits in 7 x AT28C256, decoded before 8 x 74HCT574; address opcode:mode:step:cond with a fetch bypass from bus_data; forced row for interrupt e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
2026-11-05 cu phase 2: microcode source language and generator (crate hbc2-ucode, hbc2 ucode): the whole instruction set, interrupt entry, halt loop, reset and boot in microcode/hbc2.uc; 7 AT28C256 images + lis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
2026-11-05 at28c256 model: HALF becomes a 4-bit simulation-only IMAGE pin (cu-decisions.md Q10): 16 images of 32 KiB, 0-1 the boot ROM, 2-8 the microcode (circuits/cu/microcode/ucode0..6.bin), 9-15 erased; test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
2026-11-05 cu phase 3: module clkgen (circuits/cu/clkgen.circ): clock generator 74HCT74 + 74HCT10, reset generator 74HCT14 + 74HCT74, 74HCT541 clock buffer (5 clk branches, clk_wr_n, clk_mem_wr_n), rst_rc for t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
2026-11-05 cu phase 3: module cu (circuits/cu/cu.circ, 30 chips, pull resistors for C24), hbc2 vectors cu (model-driven boots + random programs, 4.2 M rows), clkgen 6 balanced clock branches, timing.py --sectio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
2026-11-10 cu phase 3 complete: full test 4,217,898/4,217,898 on the final circuit, 9 wiring bugs all caught (cu-decisions.md 14.3, 14.7)
2026-11-10 emulator: hardware cycle counts (logisim/notes/cu-cycles.md): each instruction takes its control-unit steps (table in isa.rs, Instruction::cycles), interrupt entries 9 (hardware) / 10 (software), hal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
2026-11-10 runner: the boot runs at 2 MHz at least
    Below the hardware clock, the boot (65,548 cycles) is paced at 2 MHz, so Run
    after power-on reaches the first instruction in about 33 ms whatever the
    selected speed; the program then runs at the selected speed. Faster speeds
    are unchanged. New Machine::boot_cycles_left().
2026-11-10 cu phase 4: the whole CPU (cpu.circ main: clkgen, cu, alu, flags, regs, addr, ir, mem; cu_<x> -> <x>), the trace bench (circuits/cpu/test_cpu.circ: clock, reset RC, IOD stub with port latches and a p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
2026-11-10 cu phase 4 complete: 55/55 runs (5 test programs, 50 random) identical to the emulator from a full power-up, no contention, C24 pulls hold, 62,240 cycle counts as cu-cycles.md (106/106 instruction x 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
2026-11-10 vectors: flags_cpu / addr_cpu start past the first instruction; test that every generator runs
    Since the emulator-cycles merge, Cpu::reset delays interrupts until the
    first instruction has run (the hardware's first fetch has no interrupt
    check), and the two generators that test interrupt entries panicked.
    They now run one NOP after the reset (past_first_instruction), then set
    up the test state. All 18 vector sets are byte-identical to the
    pre-merge ones; Logisim: flags_cpu 70,656 / 70,656, addr_cpu
    65,114 / 65,114.
    New hbc2-cli test tests/vectors.rs runs every `hbc2 vectors` generator,
    so a generator panic fails cargo test (about 80 s in a debug build).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
2026-11-10 cputest / emutrace: interrupts placed by cycle, cycle counts against the emulator's table
    emutrace trace --int-cycle CYCLE:PORT:DATA queues each hardware interrupt
    at the clock cycle where INT rose in Logisim (cycles from power-on, the
    boot included; the machine runs one cycle at a time). emutrace cycles
    dumps Instruction::cycles for every opcode x mode, the interrupt entries,
    the halt loop and the boot as JSON.
    cputest: runs with hardware interrupts are compared twice (by line, the
    pass criterion, and by cycle); interrupt entry lengths are recorded;
    `cputest cycles` checks every instruction against cu-cycles.md and the
    emulator's CYCLES table, the entries against 9 / 10 and the boot agains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
2026-11-10 chips: current AS6C1008 (Alliance v1.2, 2023) and AT28C256 (Microchip DS20006386B, 2022) datasheets replace the old copies; M4 kept
    The RAM still asks VIH 0.7 x VCC (v1.2 p. 4) and the ROM still guarantees
    only VOH 2.4 V at -400 uA (DS20006386B p. 7), so the ROM buffer stays and no
    circuit changes. Every timing figure we use is unchanged; chips.md now cites
    the new revisions with page numbers. Comparison, value-by-value check, margins
    and the open ROM-overlap item: ir-mem-decisions.md section 11. iod-requirements
    I9 (levels, recommended). timing.py prints memory part names whole (part[5:]
    assumed 74HCT). Model tests pass (3,260 / 302,912 rows); timing.py passes every
    section at 25 C for 45/5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
2026-11-10 mem M8: the boot ROMs' /OE from mem_rom_oe_n, off outside the boot copy; B4 for the overlap left at 7FFF -> 8000 and FFFF -> 0000
    The ROMs no longer drive mem_rom_d at every A15 change in normal running;
    the up-to-tDF (50 ns) overlap remains only at the boot's two A15 changes,
    measured by breadboard-checks.md B4 (fallback: 100 ohm series networks).
    timing.py m_boot_oe (574 -> ROM tOE -> 541): 130 / 145 ns, margin 192 / 170
    at 50 % duty; every other path unchanged, all pass at 25 C (45/50/55 %).
    Tests: mem 226,614 and mem_cpu 302,556 vectors pass; whole CPU 11/11
    identical to the emulator (5 test programs + random 0-5). bom.py skips
    chips.md tables without a Logisim column (broken since phase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
2026-11-10 breadboard orders card by card; test rig design and rigmap.py
    breadboard-order.md: the CPU tested one card at a time, chips moved onto
    DIP PCBs in sockets. Eight successive orders (rig + clkgen + ir, alu, flags,
    regs, addr, mem, cu, optional integration), each with only what wasn't
    bought before, and a running total: about 645 EUR excl. VAT for every card,
    against 880 for the whole CPU on breadboards.
    test-rig.md: a generic rig on the owned Mega: D0-D63 (8 x SN74AHCT595N,
    470 ohm series, one /OE per chip), S0-S63 (8 x CD74HCT165E, 100 k pulls
    switched to tell Z), C0-C7 clock pins; map file format and the replay rules.
    tools/rigmap.py gen / check / all: per-card maps rig bit <-> card pin bi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
2026-11-10 kicad: ALU and flags schematics finished, wiring matches Logisim
    Fixed against the Logisim netlists: flags 74541 outputs Y7/Y8 and the S/F
    157 outputs; ALU 7485 cascade (U9 inputs tied, U9 -> U10 A=B/A<B, U9 A3)
    and the bit-5 inputs of the carry-select 157 (U19). Bus names made uniform.
2026-11-10 kicadcmp.py: compare a KiCad schematic's chip wiring with its Logisim circuit
    Chips are paired by type and named nets, so references need not agree;
    legal gate/input swaps per chip type are accepted. Checks that every
    Logisim top-level pin reaches a connector. Also ignore KiCad lock files.
2026-11-10 kicad: IR schematic finished, wiring matches Logisim
    kicadcmp.py reports EQUIVALENT against ir.circ. ir.circ: layout and
    pin order rearranged, nets unchanged. Custom symbols updated.
2026-11-10 notes: I/O redesign proposal (VIA, 16C550, 74HCT148 interrupts)
    Proposal only, no code change: current IOD model, emulator / IDE /
    library / docs impact, compatibility, open questions and step order.
    Target chips added to iod-requirements.md as "proposed".
2026-11-10 notes: option C proposal: latch mailbox + ESP32 I/O processor (section 9)
    Mailbox hardware (19 chips, toggle-pair flags, timing against timing.py),
    throughput, a protocol that keeps today's IOD model (compat OUT/IN +
    events) plus native commands, ESP32 pins, emulator/library impact, open
    questions and step order. The VIA/16C550 target in iod-requirements.md
    is marked withdrawn.
2026-11-10 notes: section 9.8, simplified mailbox (C-min, 13 chips) vs section 9
    One 74HCT74 per flag, GPIO pulses with MBX_SEL as the TX ack, 138-only
    decode; vectored interrupts kept (a fixed vector saves 0-1 chip).
    Race, pins and timing compared.
2026-11-10 iod: C-min mailbox module (12 chips), 74595 model, 74165 checked
    - circuits/chips/74595.circ: model from SN74AHCT595 (SCLS374Q), test_74595
    2610 rows pass.
    - circuits/chips/test_74165.circ: Logisim's 74165 against CD74HCT165's
    truth table, 1310 rows pass.
    - circuits/iod/iod.circ (designs/iod.py): decode, TX/RX/EVT flags,
    rx_clr/evt_clr, VEC, INT, 165 TX, 3 x 595 (RX, EVT port, EVT data),
    STATUS 244, LVC244 to the ESP32. Sequences from a cycle-level model
    (every port IN/OUT, both handshakes, the 1 us rule, events, reset):
    13816 rows pass; three wiring mutants fail.
    - chips.md: the iod parts and delays; bom-iod.csv.
2026-11-10 iod: CPU-level benches, cputest --bench iod, timing.py --section iod
    - circuits/iod/test_iod_cpu.circ (+ _eager): the real CPU, the mailbox
    card and a test MCU (ROM state machine on osc) that keeps or breaks
    the 1 us firmware rule. tests/iod/mbx.has: mirrors, empty ports, one
    and two replies, one and two events, data checked in the handler.
    Rule bench: PASS, identical to the emulator, 12 events, none lost.
    Eager bench: PASS with 4 replies and 4 events lost (the I15 race).
    - cputest: --bench cpu/iod/iod_eager, IN data recorded and replayed by
    emutrace (--in LINE:VALUE), ; expect[bench] register checks.
    Old suite 5/5.
    - timing.py --section iod (11 paths, all pass at 25 C, 45/50/5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
2026-11-11 emulator: mailbox card + I/O processor model (step C3)
    - hbc2-core mailbox.rs: the C-min card chip by chip (I10-I16); iop.rs: the
    ESP32 firmware model running the IOD as its protocol (OUT, IN, NOP, INFO),
    keeping the 1 us rule. MachineConfig::mailbox (None = old IOD, still the
    default until the library is converted in C5).
    - cpu.rs: IN / OUT go through Board::io_read / io_write (same behaviour
    without a mailbox).
    - hbc2 vectors iod replaces the Python model as the Logisim module's
    reference: 13,740 rows pass. Tests: direct IOD vs mailbox give the same
    screen, RAM, events and registers; the broken rule loses events.
    - CPU benches: suite 5/5, iod and iod_eager pass.
    Co-Authored-By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
2026-11-11 library: in / out through the I/O mailbox; mailbox on by default (step C5)
    - compiler/lib/asm/mailbox.has: mbx_out / mbx_in send the compat commands
    (0x01 p v, 0x02 p) with interrupts off and keep every register and flag.
    - The 99 in / out sites of hbc2.has, screen.has, terminal.has, time.has and
    random.has call them (psh / cal / asp or pop). in() / out() in C keep
    their signatures.
    - boot.has: its own copies (boot_out / boot_in) in the first 512 bytes.
    - MachineConfig::default() and the IDE use the mailbox; bare CPU tests
    keep the old IOD. The manual's opening example (raw out to the monitor)
    stays on the old IOD until the manual is updated.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
2026-11-11 docs: redraw the I/O diagram for the C-min mailbox and the ESP32
    HBC-2_Input_Output.pdf (French, 2 pages): block diagram of the 12-chip
    mailbox card between the CPU and the ESP32; port map, STATUS bits, the
    compat commands, the TX / RX / event sequences and the chip list. Its
    source is Documentation/src/HBC-2_Input_Output.html (printed with Chrome).
2026-11-11 docs: devices through the I/O mailbox (all but the .odt)
    - Assembly Language manual: the opening example sends the OUT command
    itself (its test is back on the default config); new section "Devices
    and the I/O mailbox" (ports 0x00 / 0x01, STATUS, the commands, mbx_*).
    - Peripherals README: the IOD runs in the I/O processor; ports are read
    and written with mbx_out / mbx_in; when a command takes effect.
    - Monitor, RTC, EEPROM pages: examples use mbx_out / mbx_in; the EEPROM
    boot loader includes mailbox.has (checked: fits and copies main).
    - ABI.md §8, compiler/lib/README.md, hbc2/README.md.
2026-11-11 notes: open point, crt0's fixed wait won't cover the ESP32's start-up
2026-11-11 ide: new assembly projects get mailbox.has, included by main.has
    The file is the C library's own compiler/lib/asm/mailbox.has, built in
    with include_str!, so there is one copy. The template test assembles the
    three files the IDE writes.
2026-11-11 docs: new assembly projects get mailbox.has
2026-11-11 Remove the EEPROM target; the EEPROM is storage, plugged by default
    The hardware starts from the boot ROM, and the ESP32 can't write the
    CPU's RAM, so nothing models the EEPROM's power-on copy any more
    (io-redesign-proposal.md F9, 9.5).
    - hbc2-asm: no Target; images are 64 KiB, addresses up to $0xFFFF.
    - hbc2-cc: no boot.has, no EEPROM image, no check_boot / not_copied.
    - hbc2 CLI: no --eeprom on asm / cc; run --eeprom file.bin loads the
    EEPROM's content.
    - hbc2-core: the EEPROM copies nothing at power-on; MachineConfig plugs
    a blank one by default.
    - IDE: no target setting; EEPROM checkbox in Peripherals (on by
    default), its content kept from one machine to the next, Load EEPROM
    co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
2026-11-11 templates: own copy of mailbox.has, so the folder assembles on its own
    hbc2 asm templates/main.has failed after main.has started including
    mailbox.has. The template test now assembles the folder from disk and
    checks that its mailbox.has is the C library's.
2026-11-11 docs: EEPROM as storage only, no EEPROM target; hbc2/README.md updated
    - Assembly manual: no EEPROM target section; the boot ROM export is
    in the Assembler menu.
    - EEPROM reference: storage only (no power-on copy, no boot loader).
    - ABI.md, compiler READMEs, peripherals overview, TODO: no boot.has, no
    EEPROM_FREE; the EEPROM is always plugged.
    - hbc2/README.md: points to the other docs for the language, devices,
    C and hardware; keeps crates, commands, installer, IDE use and design
    notes, brought up to date (mailbox, EEPROM, menus, cycles).
    - Notes: EEPROM target and template marked done; loading programs over
    USB through the ESP32 kept for later.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
2026-11-11 IDE: mailbox panel in the I/O view
    - hbc2-core: the I/O processor logs its last 100 commands and events
    (Iop::log, LogEntry), with the value an IN replied.
    - hbc2-runner: the snapshot carries the Iop when the board has the
    mailbox.
    - IDE I/O view: the mailbox card (STATUS, TX full, RX full, event
    pending, VEC, TX / RX / EVT latches) and the I/O processor (command so
    far, replies waiting, counts, the log with each port's device).
    Without the mailbox the view is as before. Also fixes the spaces in
    the RTC Interrupt button's tooltips.
2026-11-11 KiCad: registers and mem schematics, ir and symbol updates; regs.circ and kicadcmp.py changes
2026-11-11 New IDE screenshot (mailbox and I/O processor panels); ignore KiCad restore backups
2026-11-11 INFO lists the devices; the CPU asks at startup instead of port-0 announcements
    - I/O processor model (iop.rs): INFO replies the protocol version, N and
    N descriptors of 6 bytes (class, product ID, first port, number of
    ports). Plugging a device sends no interrupt any more. New boot delay
    (IopConfig::boot_cycles, 0 by default): a command waits in TX while the
    firmware boots. Iop::rst_n drops a half-received command and the
    unread replies and keeps the rest.
    - Machine::reset: the reset button (CPU and mailbox card only).
    - Peripherals have a PCI class and a product ID instead of the one-byte
    device ID: monitor 03 00 / 0x0001, RTC 08 03 / 0x0002, keyboard
    09 00 / 0x0003, EEPROM 0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
2026-11-11 Docs: devices found with INFO (classes, product IDs); no mouse, no audio
    - Peripherals/README.md: "Detecting the devices" rewritten for INFO and
    devices.has; new "Device classes" (PCI class + subclass per device,
    product IDs 0x0001-0x0005). Device pages: class and product ID instead
    of the old ID.
    - Assembly manual, ABI.md section 8, ROADMAP, library notes, hbc2/README:
    startup with dev_init, no port-0 handler.
    - io-redesign-proposal.md 9.10: D6 (the CPU asks with INFO; the ESP32
    doesn't hold the reset) and D7 (no mouse, no audio: 21 of 22 GPIOs, the
    fourth input on 25, the GPIO 36 question gone). 9.3, 9.4, 9.8, Q-C7,
    Q-C8, D5 and C4 point to them. iod-decisions.md: what was bu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
2026-11-11 KiCad: mem schematic (verified equivalent to mem.circ), updates to alu/flags/ir/registers; kicadcmp.py ignores part suffixes like -xxP
2026-11-11 TODO: the manual's IVT row is done; drop stale plug-in interrupt comments
2026-11-11 Docs: HBC-2_Input_Output.md, the full description of the mailbox, the ESP32 and the protocol
2026-11-11 Instruction Manual with the RAM and I/O chapters, and its PDF; CPU diagram with the mailbox (PNG); I/O diagram renamed HBC-2_Input_Output_diagram; mem.circ rearranged; ignore *.kicad_prl
2026-11-11 IDE: Reset is now the board's reset button, new Restart does the power cycle
    - Reset (Ctrl+F5) calls Machine::reset: the CPU and the mailbox card start
    again from the image; the I/O processor and the peripherals keep running.
    - Restart (Ctrl+Shift+F5), right of Reset in the toolbar and in the Emulator
    menu: the power cycle (Machine::power_on), the old Reset.
    - Runner: Command::Reset / Runner::reset, with a test.
    - Docs: README, HBC-2_Input_Output.md, iod-decisions.md, ir-mem-decisions.md.
2026-11-11 UTF-8 literals become Windows-1252 in the assembler and the C compiler
    The assembler converts the characters of its string and character
    literals (and takes '\b'); the C compiler does it between cpp and cc0
    (octal escapes). A character without a Windows-1252 code is an error at
    its line and column. Tests: lexer unit tests, hbc2-cc charset.rs unit
    tests, tests/build.rs (the error's place), compiler/tests/charset.c with
    its .screen.
2026-11-11 Docs: native display implemented, measured speed-ups, old monitor ports on one picture
    Native/Reference.md: implemented status, measured costs (~26 us per
    byte) and before/after table, the library API, LINE direction and
    FILL_RECT width notes. Monitor reference rewritten (32 x 24, one
    picture). Peripherals README, HBC-2_Input_Output.md: native display
    descriptor, protocol 2, port 20. Assembly manual: Windows-1252 literals,
    '\b'. I/O diagram: native commands page (PDF regenerated). Library
    README/notes, TODO.
2026-11-11 Native display fixes: size 0 = 256, one command per interrupts-off window, delay keeps I
    - RECT / FILL_RECT: a width or height of 0 means 256 (emulator, spec,
    library: screen_fill is now FILL_RECT 0 0 0 0 and keeps the text
    cells; tests). Same rule reserved for BLIT and sprites.
    - screen.has: interrupts off for one mailbox command (and its reply) at
    a time, back on between commands when the caller had them on (psf +
    scr_mark, cli ... scr_open, pof). Longest window: one PUTS of 255,
    13,361 cycles (tests/windows.rs measures it).
    - delay() saves and restores the flags (multi/delay test).
    - Spec: decisions 8-10, measured windows and speeds, RECOLOR proposal
    for screen_set_bg / screen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
2026-11-11 Native display: RECOLOR (0x1A) for screen_set_bg / screen_set_txt
    One 3-byte command recolours every text cell (which 0: backgrounds,
    1: character colours), redrawn from the current font; cursor, COLOR
    and font kept. screen_set_bg goes from 546,461 cycles to 303.
    PUTS stays at 255 characters.
2026-11-11 Manuals: native display in the Monitor and Instruction Manuals, PDFs
    Monitor Instruction Manual rewritten for the native display: one picture,
    32 x 24 text, Windows-1252 with a map of the 8 x 8 font, the native
    commands, VSYNC, sending rules, the old monitor ports on the same picture.
    Instruction Manual: protocol version 2, the native display's descriptor,
    the native command range, interrupts off for one command at a time,
    display_port. Native reference: font map, stale lines fixed.
2026-11-11 KiCad: addr project (schematic and PCB); addr.circ updates
2026-11-11 KiCad addr schematic complete (all chips and connectors, checked against addr.circ with kicadcmp.py); addr.circ rearranged for readability
2026-11-11 C compiler: structs and unions passed and returned by value
    A struct argument is passed as its address and copied by the callee at
    entry; a struct result goes through a temporary of the caller's frame
    whose address is a hidden first argument. Parser only, no backend change
    (ABI.md 5). New test structval.c and the structarg error case.
2026-11-11 C compiler: run FCC's own test programs (109, all pass)
    Upstream test/tests (35 self-checking programs) and test/wtests (74 acwj
    programs, output compared) copied into compiler/tests/fcc; support.c
    stands in for the emulators' printchar/printint; tests/fcc.rs builds and
    runs them on the emulator, with a skip list (empty). Runner checked by
    mutation. No compiler change was needed.
2026-11-11 C compiler: x *= k, x /= k, x %= k with a constant done in place
    Load, the inline multiply or power-of-two divide of x * k / x / k, store
    (direct_muldiveq), instead of a helper call through the address. Signed
    divide, char and long multiply still call the helpers. Loops 2-5x faster;
    tests/muldiveq.c, mutation-checked. TODO: the cargo build of the C tools
    and the register dataflow across loop labels dropped.
2026-11-11 KiCad: iod and clkgen schematics (equivalent to iod.circ / clkgen.circ with kicadcmp.py), cu project started; review notes in kicad/NOTES.md and kicad_electrical_requirements.md
    - iod: 12 chips, only the iod_addr in/out split differs (one wire in hardware)
    - clkgen: 5 chips, equivalent; oscillator module and reset RC still off the board (H5)
    - addr: re-annotation only (U3-U36 -> U1-U34)
    - symbol library and iod.circ updates
2026-11-13 KiCad: control unit schematic (30 chips, connectors, pull resistors), equivalent to cu.circ with kicadcmp.py; cu.circ re-saved by Logisim; ctrl_unit/clkgen project folders
2026-11-13 gitignore: untrack KiCad per-user files (.kicad_prl, .bak) and ignore Logisim autosaves, KiCad backups and caches
2026-11-13 KiCad: control unit schematic re-saved
2026-11-13 Logisim: reset in the middle of a mailbox transfer at CPU level (iod_reset_tx/rx/evt benches, cputest follows the second boot), all pass; TODO: fixed.h dropped, IDE reset done, KiCad schematics drawn
2026-11-14 Docs: TTGO VGA32 wired to the I/O card (pins, connectors J5-J7, 3.3 V LVC244, A8-A15 pull-downs)
    iod-decisions.md records the wiring checked against the TTGO's schematic:
    MBX_SEL IO26 and RCLK_EVT IO27 through the mouse port (idle high),
    RCLK_RX IO25, inputs IO34/39/35/36, SPI on the header shared with the SD
    card, GPIO0 spare; firmware rules. KiCad notes: H1, H2, H3, S3 closed on
    the IOD, cu equivalent to cu.circ. New breadboard check B7.
2026-11-14 KiCad: clkgen oscillator, reset and Arduino Nano driver; power S1 on all cards
    - clkgen: ECS-2200BX-040 oscillator (Y1), reset RC (R3, C9, D1, SW3 + R5),
    Arduino Nano clock/reset driver (JP1 picks Y1 or the Nano, STEP and
    RUN/STOP buttons, speed pot, clk5/rst_n feedback, D2 feed + R6 power
    sense), test points, old rig connector J1 removed, references renumbered,
    footprints assigned. ERC 0/0.
    - Power (S1): series Schottky and TVS removed from all 9 cards; power
    connector pinout GND, +5V, +5V, GND. Protection (fuse, P6KE6V8A, 1000 uF)
    moves to the motherboard input. ERC 0/0 on every card, no other net changed.
    - Docs: kicad/NOTES.md (clkgen sections, Power S1), requirements H5/S1,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
